tadeomendelevich/Balancin_Mendelevich/CHANGELOG.md

# Balancin STM32 — Registro de Cambios (historial completo)
> Movido desde `CLAUDE.md` el 2026-07-07 para que ese archivo no exceda el tamano que Claude carga automaticamente en cada sesion.
> Orden: mas reciente arriba. Las filas nuevas nacen en la tabla de CLAUDE.md y se rotan hacia aca (al tope de esta tabla) cuando aquella supera ~10 filas.
> **Nunca borrar informacion de este archivo.**

| Fecha | Archivo(s) modificado(s) | Cambio realizado | Motivo / Observación |
|---|---|---|---|
| 2026-08-26 | Core/Src/main.c, CLAUDE.md | **Legibilidad para estudio: renombres de identificadores locales, defines `RUEDA_ESTACION_*` movidos al bloque de arriba con comentarios recortados, y 26 comentarios nuevos de fin de linea nombrando la formula de cada cuenta. Cero cambio funcional.** (1) **Renombres** (todos verificados con 0 ocurrencias viejas): `LINE_THRESHOLD`->`LINEA_UMBRAL_ADC`; toda la familia `PERP`->`PERPENDICULAR` (enum `LINE_STATE_PERPENDICULAR_ROTATE`, funcion `LineState_PerpendicularRotate`, variables `perpendicular_desde_esquive`/`perpendicular_obj_freno_inicio_ms` y los 3 defines, renombrados ademas a `PERPENDICULAR_ANTIRREBOTE_MS`/`PERPENDICULAR_DURACION_MAX_MS`/`PERPENDICULAR_VISTA_PREVIA_MS`); locales del bloque de cruce perpendicular (`all_black`->`todo_negro`, `all_black_elapsed`->`todo_negro_transcurrido_ms`, `accel_moving`->`accel_moviendose`, `accel_settled`->`accel_asentado`, `ACCEL_MOTION_THRESHOLD`->`ACCEL_MOVIMIENTO_UMBRAL`, `ACCEL_SETTLE_MS`->`ACCEL_ASENTADO_MS`); locales del centroide (`s[]`->`linea_adc_crudo[]`, `w[]`->`linea_peso[]`); deteccion de objeto (`obj_now`->`obj_visto_ahora`, `obj_cnt`->`obj_confirma_cnt`, `obj_clear_cnt`->`obj_libera_cnt`, alineados con el patron `linea_detect_confirma_cnt`/`_libera_cnt`); y `WheelStation_AngleCorr()`->`Estacion_CorreccionAngulo()`. (2) **Defines movidos**: los 11 `RUEDA_ESTACION_*`/`RUEDA_TRASLACION_ZONA_MUERTA_COUNTS`/`RUEDA_V_ZM_RPS`/`RUEDA_CALMA_*`/`RUEDA_DESPL_*` pasaron de estar sueltos en la linea ~3586 al bloque de defines de balance/freno (lineas 290-302); sus comentarios pasaron de ~69 lineas de historia a 23 (uno corto por define). Se conservaron a proposito los knobs accionables y la advertencia de NO reintentar el "fade de supervivencia" por gyro alto. Tambien se recortaron los 2 comentarios largos que quedaban en la funcion (15 y 30 lineas -> 2 y 11). El detalle historico completo sigue en este CHANGELOG. (3) **26 comentarios** de fin de linea nuevos nombrando la tecnica: buffer circular por modulo/mascara, regla de tres duty->CCR, escalado LSB->deg/s, resta de timestamps, norma L1, semisuma=traslacion, superposicion avance+freno, extrapolacion de Taylor 1er orden, descomposicion polar->cartesiano, etc. Verificado: sin defines `RUEDA_*` duplicados ni usados-sin-definir. NO compilado (el usuario compila). | Usuario estudiando el firmware linea por linea: "estos nombres estan rarisimos para darme cuenta para que sirven", "estos define deberian estar arriba con los demas y no me gustan los comentarios extensos", "esos comentarios me ayudan mucho, se puede completar en los demas lugares?" |
| 2026-08-03 | Core/Src/main.c, CLAUDE.md | **Renombrado masivo de identificadores de inglés a español: 233 variables + 216 defines (solo nombres — cero cambio funcional).** El usuario estudia el firmware línea por línea y pidió nombres reconocibles en castellano. Dos pases scriptados con reemplazo por palabra completa y *lookbehind* que protege los accesos `.campo` / `->campo`. **Variables** (2384 reemplazos): `robot_state`→`estado_robot`, `line_*`→`linea_*`, `wheel_*`→`rueda_*`, `obj_wall_*`→`obj_pared_*`, `enc_r`/`enc_l`→`enc_der`/`enc_izq`, `ax..gz`→`accel_x..giro_z`, `f_fallen`→`f_caido`, `output`→`salida_pid`, `pwm_sat`→`pwm_saturado`, `steering_adjustment`→`ajuste_direccion`. **Defines** (717 en main.c + 55 en CLAUDE.md): `MOTOR_SLEEP_*`→`MOTOR_SIESTA_*`, `WHEEL_*`→`RUEDA_*`, `OBJ_WALL_*`→`OBJ_PARED_*`, `ANTISTALL_*`→`ANTIATASCO_*`, `LOST_FWD_*`→`PERDIDA_AVANCE_*`, `LOST_RETURN_*`→`RETORNO_*`, `BRAKE_TILT_*`→`FRENO_INCLINACION_*`, `STEER_*`→`DIRECCION_*`, `I_MAX`→`INTEGRAL_MAX`, `ALPHA`→`ALFA_COMPLEMENTARIO`. **NO se tocó** (a propósito): handles de CubeMX (se regeneran), defines de pines, `M_PI`, `KP/KD/KI/SETPOINT_ANGLE`, `ENCODER_COUNTS_POR_VUELTA`, los **campos de struct** de `UNER.h` (espejados en Qt) ni las constantes enlazadas a UNER (`KP_value`, `LINE_SPEED_TARGET`, `SP_LIMIT_DEG`, `KV_brake_value`) — por eso **Qt no requiere ningún cambio**. Verificado por script: 0 nombres viejos restantes, sin colisiones ni duplicados, y ambos diffs simétricos (2574 ins / 2574 del) confirmando renombrado puro sin pérdida de código. `CHANGELOG.md` NO se reescribió (es historia). **Pendiente**: las variables LOCALES dentro de funciones (`trabado_desplazamiento`, `gz_dps_cal`, `line_forward_boost`, `escala_estabilidad`, `wheel_disp_f`…) siguen en inglés. NO compilado (el usuario compila). | Usuario: "me encantaría que esos nombres de variables los hagas más reconocibles y sencillos, en español" + "hacé lo mismo para todos los DEFINE que no tienen nombre claro, que se entienda correctamente cuando los leo así los puedo estudiar fácil" |
| 2026-07-30 | Core/Src/main.c, Core/Src/UNER.c, Core/Src/MPU6050.c | **Comentarios de fin de línea nombrando la técnica/fórmula de cada cuenta (~90 líneas, solo comentarios — cero cambio funcional).** El usuario agregó a mano un `// Media movil exponencial` en el calibrador de bias del gyro y pidió replicar ese estilo (corto, al final de la línea, nombrando QUÉ es la fórmula) en la mayor cantidad de lugares posibles, porque le facilita muchísimo leer el firmware. Cubierto: **filtros** (EMA en velocidad rápida/lenta, accel_motion, lat_tilt, bias de odometría, error de línea, velocidad por rueda; filtro complementario con sus dos mitades pasa-altos/pasa-bajos; mediana + insertion sort del ADC); **PID/PI** (los cuatro lazos: balance, línea, steering por encoders, y los PI de velocidad de LOST_FWD/EDGE_FWD/OBJ_WALL×3/MANUAL — cada uno con P/I/D, integración rectangular `I += e*dt`, anti-windup por saturación y por integración condicional, descarga exponencial, ganancia asimétrica acelerar/frenar); **geometría** (atan2 del roll/pitch/lateral y por qué atan2 y no atan, Pitágoras, centroide como promedio ponderado + normalización, odometría: integración de Euler + regla del trapecio + descomposición polar→cartesiano + wrap a ±180°, navegación de retorno: distancia euclídea, rumbo y giro más corto); **conversiones** (análisis dimensional counts→rps→m/s, escalado del gyro, regla de tres duty→CCR y ADC→píxeles, punto fijo Q14 del MPU, recomposición big-endian); **utilidades de control** (saturación/clamp, zona muerta como "exceso", limitadores de slew-rate y sus rampas, interpolaciones lineales/lerp, decaimientos exponenciales, mezcla diferencial común±steering, semisuma=traslación / semidiferencia=rotación, calma traslacional y rotacional como normalización 0..1); **protocolo** (checksum XOR de RX y TX y por qué el orden no importa, buffer circular por máscara); **tabla de cuadratura** de los encoders (índice = 4·estado_anterior + estado_actual). NO compilado (el usuario compila). | Usuario: "hay comentarios que me ayudarían montón, como el de media exponencial que agregué acá, aclaran qué es y me ayudan a la interpretación — a la derecha luego de la línea, cortito y resumido, fijate dónde podés agregarlo en la mayor cantidad de lugares posibles" + "mientras más mejor!!!" |
| 2026-07-27 | Core/Inc/UNER.h, Core/Src/UNER.c, Core/Src/main.c, (Qt: mainwindow.h/.cpp) | **`MODIFY_SP_LIMIT=0xC9` nuevo (tope de inclinación ajustable desde Qt) + tope de velocidad de línea 4→8 m/s.** (1) **0xC9**: el `sp_limit` de `Ctrl_SetpointDinamico` (inclinación máxima para acelerar/frenar, hasta hoy la constante `5.0f`) pasó a la global `float SP_LIMIT_DEG = 5.0f`, enlazada por el binding nuevo `sp_limit` y modificable en runtime; el case en `UNER.c` valida con `getF32BoundedFromRx` a **1..15°** (`SP_LIMIT_CMD_MIN/MAX_DEG`) y responde UNKNOWN si no hay binding (patrón de `MODIFY_BETA_*`, no ACK mentiroso). Rige LINE_FOLLOWING/BALANCE_ONLY/IDLE; MANUAL (6°) y BALANCE_AND_SPEED (2°) conservan sus topes propios, y el freno hacia atrás en línea sigue acotado aparte por `LINEA_FRENO_ANGULO_MAX=3°`. (2) **`LINE_SPEED_CMD_MAX_MPS` 4.00→8.00 m/s**: el usuario quería pasar de 4 m/s y el clamp del firmware lo recortaba en silencio aunque Qt lo permitiera. Se queda en 8 y no más porque el corte de emergencia (`LINEA_VEL_CORTE_LIMITE`) está en 10 m/s: pedir un objetivo ≥ a ese corte sería autodestructivo. **Contexto**: ninguno de los parámetros de frenado escala con la velocidad objetivo (ángulo, rampas `LINE_SP_STEP_*`, ganancias del PI, margen y horizonte de la guarda predictiva son absolutos), así que a velocidades altas el robot queda relativamente sub-frenado — de ahí que tenga sentido poder subir el tope de inclinación a mano. NO compilado (el usuario compila). | Usuario: "quiero que me agregues sp_limit al Qt para poder cambiarlo de ahí, agregá la lógica al archivo UNER también; y sacame el límite de 4 m/s que tengo en Qt para poder llevarlo a más" |
| 2026-07-27 | Core/Src/main.c | **BUG CRÍTICO del esquive corregido: "PARADO" instantáneo al perder la pared — el reset del timer de pared-perdida decía `10` en vez de `0`.** Reporte: en pleno esquive, apenas el lateral deja de ver la pared, salta de `PARED>AVZ` directo a `PARADO` (`LINE_STATE_GIVEN_UP`), en vez de girar hacia la pared. Causa (en `Ctrl_LatchesPared`, etapa 3): con la pared visible el timer se "reseteaba" a **10** — un valor NO nulo, y la rama de abajo usa `== 0` como "timer sin arrancar". Al perder la pared se salteaba el arranque del timer y se evaluaba `HAL_GetTick() - 10` (≈ el uptime completo) contra los 5000 ms → verdadero desde el segundo 5 de encendido → `GIVEN_UP` **en el mismo ciclo** en que se pierde la pared. Y como la etapa 3 corre ANTES de los handlers de `line_state` (etapa 15), el estado ya era GIVEN_UP cuando `LineState_ObjBordearPared` iba a hacer su transición legítima `!pared_visible → OBJ_PARED_LIBRE → OBJ_GIRO_PARED`: el giro nunca llegaba a ejecutarse. Fix: reset a `0` (+ comentario explicando por qué DEBE ser 0). **Origen: commit `165f1ac` (2026-07-24)**, donde el `0→10` entró suelto, sin relación con el propósito de ese commit (estación por rueda + auditoría UNER) — no fue de la sesión de hoy; el diagnóstico anterior (que el timeout saltaba por un giro lento a causa del bamboleo) era **incorrecto**. NO compilado (el usuario compila). | Usuario: "se queda en estado PARADO de golpe en el medio del esquive, va de PARED>AVANZA a PARADO ni bien pierde de vista la pared — debería girar al lado de la pared al toque" |
| 2026-07-27 | Core/Src/main.c | **Bamboleo post-giro de 90° del esquive: la salida suave era GLOBAL — ahora es solo de BALANCE_ONLY.** Reporte: tras el primer giro de 90° del esquive de objeto el robot bamboleaba adelante/atrás. Causa: la zona neutra 4 + rampa del offset (12ª/13ª) aplicaban en TODOS los modos — en línea, los comandos medianos de la recuperación post-pivot (5-11 PWM) salían debilitados (un cmd 5 pasó de salir 13 a salir 6) → correcciones flojas → sub-amortiguado. Fix en `Ctrl_SalidaMotores`: flag `out_soft = (robot_state==BALANCE_ONLY)` — solo ahí rigen `MOTOR_COMANDO_NEUTRO=4` + rampa; los modos dinámicos (línea/manual/speed) usan `MOTOR_COMANDO_NEUTRO_DINAMICO=2` + offset completo de golpe (comportamiento histórico pre-2026-07-27, el que el seguidor tenía validado). NO compilado (el usuario compila). | Usuario: "luego del giro de 90° en el esquive de objeto se va bastante para atrás y adelante, se bambolea — ¿cambiamos algo de ahí?" |
| 2026-07-27 | Core/Src/main.c | **Auditoría de coherencia post-V27 entre modos + 2 fixes.** Pedido: verificar que los cambios del día (estación, zona neutra, rampa de deadband) no rompan línea/manual/speed. Mapa verificado: LINE→`Ctrl_MotoresLinea`, MANUAL/override→`Ctrl_MotoresManual`, resto (BALANCE_ONLY/**BALANCE_AND_SPEED**/IDLE)→`Ctrl_MotoresBalance`. **Fix 1**: el bloque `rueda_mecanismos_habilitados` de `Ctrl_MotoresBalance` (rotación por encoders + heading-hold yaw) corría TAMBIÉN en BALANCE_AND_SPEED — ahora gateado a BALANCE_ONLY/IDLE (mismo alcance que el eje de traslación; en SPEED anclaba el rumbo a la pose de entrada y pelearía con la maniobra). **Fix 2**: el slew post-rampa (`estacion_angulo_rampeada`, estático) arrastraba hasta 1.5° de corrección vieja durante ~40ms al setpoint del modo nuevo tras un cambio de modo en pleno frenado — ahora se resetea a 0 cuando `!rueda_posc_anclada` (cambio de modo o caída). **Verificado sin cambios**: siesta gateada a BALANCE_ONLY (entrada Y despertar chequean `robot_state`); zona neutra 4 + rampa de deadband son globales pero coherentes (en línea/manual los comandos típicos son ≥12 → offset pleno igual que antes; en movimiento rige el db cinético 4 y el anti-stall por setpoint no pasa por PWM); `wheel_disp_f` arranca fresco en cada re-entrada (reset en `!armed`); `wheel_yaw_int` se resetea al re-anclar; `rueda_posc_anclada=0` al entrar a IDLE/BALANCE/SPEED/MANUAL y al recuperarse de caída (fix 2026-07-26 intacto); en IDLE la salida corta motores más allá de lo que compute la estación. NO compilado (el usuario compila). | Usuario: "cambiamos el PID de una rueda a las dos — verificá que todos los estados hayan quedado coherentes (seguidor de línea, manual y demás) y corregí lo necesario" |
| 2026-07-27 | Core/Src/main.c | **16ª pasada — fade de supervivencia ELIMINADO (mataba el freno) y reemplazado por techo más bajo: `RUEDA_ESTACION_ANGULO_MAX` 2.5→1.5.** La 15ª quedó muy mal ("ahora no frena nunca"): el gate de gyro>40°/s estaba conceptualmente mal — CUALQUIER recuperación normal de empujón supera 40°/s de gyro (el vaivén de recuperación siempre es violento en gyro aunque el empujón sea moderado), así que `panic≈1` durante toda respuesta y la estación quedaba muda justo cuando tenía que frenar. Eliminados los `WHEEL_PANIC_*` y el factor `(1-panic)`; queda documentado en comentario para no reintentarlo. El pedido real ("frenar como antes pero proporcional a la fuerza del empujón") ya lo cumple la D por construcción — es lineal en v (1°/rps) — el problema del vuelco era solo el TECHO: con 2.5° de estación + freno clásico apilados el total volcaba. Ahora tope 1.5°: el freno conserva la proporcionalidad validada en todo el rango útil (hasta 1.5 rps da lo mismo que antes) y el balance conserva margen para sobrevivir el empujón fuerte. Knobs: aún vuelca con empujón fuerte → 1.5→1.2; frena poco → 1.5→1.8. NO compilado (el usuario compila). | Usuario: "quedó muy mal, ahora no frena nunca — debería frenar como antes pero de forma proporcional a lo fuerte del empujón" |
| 2026-07-27 | Core/Src/main.c | **15ª pasada — fade de SUPERVIVENCIA: en empujones fuertes la estación se caía a sí misma.** Reporte: con un empujón fuerte (sobre todo hacia adelante) la respuesta era tan agresiva que el robot se caía. Causa de diseño: el factor de calma de la 11ª usa el gyro para DESPERTAR la estación en un empujón — pero en uno fuerte la recuperación es violenta (gyro 50-100°/s, error grande) y eso mantenía la estación a plena autoridad (±2.5° de setpoint) justo cuando el PID de balance necesita la referencia limpia para sobrevivir; encima se APILA con el freno clásico de `ComputeBrakeSetpointTarget` (KV_FRENO_FUERTE) que también inclina para frenar → doble freno → vuelco. Fix en `Estacion_CorreccionAngulo()`: **`panic = clamp01(max((\|gyro_f\|-40)/(80-40), (\|error\|-3)/(6-3)))`** y la corrección se multiplica por `calm × (1-panic)`: entre 40 y 80°/s de gyro (o 3 a 6° de error) la estación se retira linealmente hasta quedar muda; el rescate del empujón fuerte lo hacen el PID de balance + el freno clásico (validado hace meses) y la estación retoma sola al moderarse la recuperación. Los empujones moderados (gyro < 40°/s) conservan exactamente la amortiguación validada. Knobs: si aún se cae con empujón fuerte → bajar `WHEEL_PANIC_GYRO_LO` 40→30 y `ANG_LO` 3→2.5; si los empujones moderados perdieron amortiguación → subir LO. NO compilado (el usuario compila). | Usuario: "cuando recibe un empujón se comporta demasiado agresivo, tanto que se cae por la respuesta — debería siempre mantener equilibrio; se cae más que nada cuando lo empujo fuerte hacia adelante" |
| 2026-07-27 | Core/Src/main.c | **14ª pasada — calma ROTACIONAL: el canal diferencial dejaba una rueda empujando sola (la derecha se movía sin parar, la izquierda muda).** Reporte: "el motor derecho se mueve todo el tiempo y el izquierdo no; el derecho rompe el equilibrio". Causa: el canal diferencial (heading-hold PI + PD de rotación en `Ctrl_MotoresBalance`) — el integrador de yaw conserva a propósito un contra-torque CONSTANTE (se congela dentro de `RUEDA_RUMBO_ZONA_MUERTA` "conservando el contra-torque") y ese diferencial permanente se suma a una rueda y se resta a la otra: con `MOTOR_COMANDO_NEUTRO=4`, la rueda favorecida (derecha, vía mL) queda siempre arriba del umbral (empuja sin parar) y la otra abajo (0) — asimetría perpetua que rompe equilibrio y siesta. Fix (mismo patrón que la calma traslacional de la 11ª): **`rot_calma = min(1, max(\|yaw_velocidad\|/RUEDA_ROTACION_CALMA_GIRO_REF=2°/s, \|v_rot\|/RUEDA_ROTACION_CALMA_VEL_REF=0.5rps))`** multiplica el yaw-hold completo (P+I) y el PD de rotación; además el I solo acumula con `rot_calma > RUEDA_ROTACION_CALMA_INTEGRAL_UMBRAL=0.3` (anti-windup: antes, quieto con rumbo fuera de la DB, el I crecía hasta el tope y al despertar pegaba un diferencial grande). Sin giro real → canal mudo → las dos ruedas quietas; girando de verdad → canal entero (el heading-hold validado no pierde autoridad donde importa). Reordenado el bloque: drift/rot/v_rot se calculan antes del yaw-hold para alimentar la calma. NO compilado (el usuario compila). | Usuario: "el motor derecho se mueve todo el tiempo y el izquierdo no, se queda quieto el izquierdo, pero el derecho es el que rompe el equilibrio o balance" |
| 2026-07-27 | Core/Src/main.c | **13ª pasada — más suavidad aún: `MOTOR_ZM_RAMPA_GANANCIA` 2→1.** La 12ª quedó **VALIDADA** ("quedó mucho mejor") y el usuario pidió suavizar todavía más el punto dulce. La rampa de compensación de deadband ahora sube con pendiente 1: comando 5 → +1 (total 6), comando 8 → +4, offset estático completo recién con \|cmd\| ≥ 12 — toda la franja de correcciones chicas empuja mínimo; los comandos grandes de un empujón real no cambian. Si quedara flojo para arrancar la rueda en correcciones medianas (el robot "se cuelga" antes de reaccionar), volver a 2. Próximos knobs de suavidad si hiciera falta más: `MOTOR_CMD_NEUTRO` 4→5, o el soft zone del PID (`scale_min` 0.35→0.30). NO compilado (el usuario compila). | Usuario: "ok, quedó mucho mejor — igual me gustaría suavizar más aún la respuesta en el punto dulce" |
| 2026-07-27 | Core/Src/main.c | **12ª pasada — el brusco del punto dulce NO era la estación: era la PATADA de compensación de deadband de los motores.** Con la estación ya muda en calma (11ª) el síntoma siguió → el culpable estaba en `Ctrl_SalidaMotores`: con la rueda parada (>80ms sin ticks) cualquier comando que superara `MOTOR_CMD_NEUTRO=2` saltaba de golpe a comando+8 (offset estático) — una micro-corrección de 3 PWM del PID se convertía en una patada de **11 PWM** contra un robot quieto → sacudida → gyro>5°/s + ticks → ventana de siesta reseteada → el PID corregía la sacudida → otra patada: relé oscilando en el punto dulce, exactamente el mecanismo del bamboleo del 2026-07-10 pero en versión chica. Dos fixes: (1) `MOTOR_CMD_NEUTRO` 2→**4** (el knob que el propio comentario del código documentaba para "si sigue temblando"): el chatter de 3-4 PWM va a 0 real — motores quietos, sin ticks, la siesta por fin tiene su ventana; el riesgo de bamboleo lento hoy lo atajan hold+siesta, si aparece volver a 3. (2) **Rampa de la compensación** (`MOTOR_ZM_RAMPA_GANANCIA=2`): apenas por encima de la zona neutra el offset entra proporcional al exceso (`comp=min(db,(\|cmd\|-4)×2)`) en vez de completo de golpe — offset pleno recién con \|cmd\|≥8; los comandos chicos empujan suave, los grandes (empujón real) no cambian. NO compilado (el usuario compila). | Usuario: "sigue sin entrar, no sé cuál será el problema — no llega a ser tan suave el PID en el punto dulce, no le da la suavidad" |
| 2026-07-27 | Core/Src/main.c | **11ª pasada — factor de CALMA global: la estación se apaga entera cuando el cuerpo está quieto.** Tras la 10ª el reporte siguió igual ("no entra nunca en la siesta, muy brusco en el punto dulce, quiero bajar la respuesta ahí"). Patrón de las pasadas 8-10: suavizar término por término (rodilla de la D, tope del P, drenaje del disp) no alcanzaba — siempre quedaba algún término activo perturbando el setpoint en el punto dulce. Fix estructural en `WheelStation_AngleCorr()`: **`calm = min(1, max(\|gyro_f\|/WHEEL_CALM_GYRO_REF, \|v_trans\|/WHEEL_CALM_V_REF))`** (refs: 8°/s y 1.0 rps) multiplica TODA la corrección (P y D juntos). Cuerpo quieto → calm→0 → estación MUDA: cero perturbación de setpoint, el PID de balance + hold + siesta son los dueños del punto dulce. Empujón → el gyro dispara al instante (sin la lag de los encoders) → estación entera sin retraso. La rodilla `WHEEL_V_SOFT_KNEE` quedó reemplazada (el término \|v\|/V_REF del calm hace lo mismo y más); tope del P (0.5°) y drenaje rápido (150ms) se mantienen. Knobs: sigue brusco en calma → subir REFs; no amortigua llegadas suaves → bajar GYRO_REF a 6. NO compilado (el usuario compila). | Usuario: "no entra nunca en la ventana de siesta, está siendo muy brusco en el punto dulce — quiero bajar de alguna forma la respuesta del robot para que sea más suave ahí" |
| 2026-07-27 | Core/Src/main.c | **10ª pasada — drenaje rápido de la memoria de desplazamiento en reposo real: el residuo del P mantenía al robot gateando y la siesta nunca entraba.** La 9ª dejó el punto dulce suave (VALIDADO) pero la siesta seguía sin entrar jamás. Causa: aun con el tope de 0.5°, el residuo del P se drena con la fuga de τ≈5s — durante esos segundos el setpoint queda corrido y el robot GATEA de vuelta despacito; cada tick del gateo resetea `enc_quiet` (60ms) + los 80ms sostenidos → la ventana de la siesta no se cumple nunca. La ventana en sí está bien (era alcanzable antes de la estación, "cuando entra queda muy eficiente"): el bloqueo era el gateo inducido. Fix en `WheelStation_AngleCorr()`: **reposo real** (ambas ruedas >`WHEEL_DISP_CALM_MS=150`ms sin un tick + \|v_trans\| bajo la zona muerta) → `wheel_disp_f *= WHEEL_DISP_FAST_LEAK=0.90` (τ≈100ms): el residuo muere en ~0.3s de quietud, el setpoint vuelve a 0, el robot deja de gatear y la siesta entra. Coherente con la filosofía sin ancla (quieto de verdad = no hay adonde volver). La deriva lenta REAL (~cm/s cuesta abajo) tiquea cada <150ms y NO dispara el drenaje — el P anti-deriva sigue vivo ahí. NO compilado (el usuario compila). | Usuario: "ahora quedó suave, pero nunca entra en modo siesta de motores — está muy complicado de ingresar o la ventana está muy alta" |
| 2026-07-27 | Core/Src/main.c | **9ª pasada — el brusco del punto dulce era el término P saturado, no la D: tope propio `WHEEL_STATION_P_MAX=0.5°`.** La rodilla de la 8ª no alcanzó ("sigue demasiado brusco y potente en el punto dulce, no entra nunca a la siesta") porque atacaba el término equivocado: a v→0 la D ya se apaga sola — el que quedaba empujando era el **P del desplazamiento reciente**. Números: un empujón que desplaza ~30cm mete ~90 counts en `wheel_disp_f` y con la fuga alargada a τ≈5s (6ª pasada) eso vale 90×0.05=4.5° → saturaba el tope general de 2.5°: al frenar en el punto dulce el robot recibía 2.5° de inclinación de vuelta durante segundos — se pasaba del equilibrio y el error nunca bajaba de los 0.8° de entrada de la siesta. Fix: el P tiene ahora tope PROPIO de **0.5°** (`p_term` clampeado antes de sumar; la D conserva la autoridad grande de ±2.5° que es la validada contra empujones). 0.5° alcanza de sobra para el rol real del P (frenar deriva lenta de mm/s) y queda DEBAJO del umbral de la siesta → tras un empujón el residuo del P ya no bloquea la entrada a dormir. Rodilla de la 8ª se mantiene (suaviza la D en la llegada). NO compilado (el usuario compila). | Usuario: "sigue quedando demasiado brusco y potente en el punto dulce, no logra entrar en siesta los motores nunca" |
| 2026-07-27 | Core/Src/main.c | **8ª pasada — rodilla suave de la D contra la brusquedad en el punto dulce.** La 7ª quedó **VALIDADA** ("la mejora es una locura, amortigua los empujones muy rápido" — commit+push en `6a286a6`), pero al llegar al punto dulce era demasiado brusco: con la D ya en fase y ganancia completa a cualquier velocidad, una velocidad chiquita de llegada (o el pico de un count suelto) metía un golpe de setpoint que lo pasaba del equilibrio justo cuando estaba por entrar a la siesta. Fix: `WHEEL_V_SOFT_KNEE=1.0` rps en `WheelStation_AngleCorr()` — debajo de la rodilla la ganancia de la D escala lineal con \|v\| (`v_soft = min(1, \|v_act\|/rodilla)`, respuesta cuadrática en chico, entera en grande): la llegada es proporcionalmente más suave y no se pasa de largo, pero un empujón real (v > 1 rps) recibe la D completa que ya gustó. NO es zona muerta (la lección de `WHEEL_V_DB_RPS=0.8`): sigue corrigiendo en fase a toda velocidad, solo más blando en chico. Knobs: vaivén chico que no muere → rodilla 1.0→0.6; sigue brusco al asentarse → 1.0→1.5. NO compilado (el usuario compila). | Usuario: "quedó muchísimo mejor, la mejora es una locura — pero es demasiado brusco cuando está por quedarse en el punto dulce y poner siesta: se pasa del equilibrio; me gustó que amortigua los empujones muy rápido" |
| 2026-07-27 | Core/Src/main.c | **7ª pasada — causa raíz del "reacciona tarde": la corrección de la estación pasaba por la RAMPA del setpoint.** La 6ª pasada no ayudó ("empeoró bastante, le cuesta quedarse en la zona dulce, reacciona tarde, sigue sin entrar a la siesta"). Diagnóstico estructural: `WheelStation_AngleCorr()` se sumaba a `base_setpoint_target`, que en BALANCE/IDLE rampa a `sp_step_max=0.1°/ciclo` (10°/s) hacia `base_setpoint_f` — una corrección de 1° tardaba 100ms en llegar, +~50ms de la EMA de velocidad (`WHEEL_SPD_BETA=0.20`). Con el período del vaivén (~1s), 150ms ≈ 50-90° de fase: la D llegaba con el movimiento ya invertido y en vez de amortiguar BOMBEABA — por eso subir DAMP siempre empeoraba y el robot nunca juntaba la quietud que pide la siesta. (La rampa existió siempre; con DAMP chico y zona muerta grande la D casi no actuaba y no se notaba.) Fix: la corrección ahora se aplica **POST-rampa** al final de `Ctrl_SetpointDinamico` — local `wheel_station_corr` se estampa en las ramas BALANCE_ONLY/IDLE y se suma directo a `dynamic_setpoint_f` (después de la contabilidad de `brake_setpoint_f`, que queda intacta) con un slew propio `WS_STEP=0.4°/ciclo`: sigue el movimiento real casi sin retraso y solo recorta el escalón instantáneo de un count suelto. Clamp final a ±sp_limit. Knobs de la 6ª (DAMP=1.0, V_DB=0.25, LEAK=0.998) quedan — recién ahora la D actúa en fase y se puede evaluar de verdad. NO compilado (el usuario compila). | Usuario: "este cambio no ayudó para nada, empeoró bastante — le cuesta quedarse en la zona de equilibrio dulce, es como que reacciona tarde, y sigue sin entrar al modo siesta, no llega a quedarse tan quieto" |
| 2026-07-27 | Core/Src/main.c | **6ª pasada de la estación: la 5ª sobre-corrigió — el robot no entraba casi nunca a la siesta y "se iba de a poco".** Dos causas: (1) `WHEEL_V_DB_RPS=0.15` + `WHEEL_STATION_DAMP=1.20` convertían el pico de ~0.7 rps de UN count suelto en un pateo de setpoint de ~0.66° → el PID respondía, caían más ticks, y cada tick reseteaba las ventanas de la siesta (60ms quiet + 80ms sostenido) — círculo vicioso: la propia estación mantenía al robot despierto y vagando. Fix: `WHEEL_V_DB_RPS` 0.15→**0.25** (vuelve al valor validado; el pico residual genera ≤0.45° breve y el vaivén real 0.3–0.7 rps sigue cubierto) y `DAMP` 1.20→**1.00** (el knob ya anotado para este síntoma; los ~15 cruces los asienta la siesta permisiva, que queda intacta). (2) La deriva lenta era invisible por diseño: con fuga τ≈2s y `WHEEL_TRANS_DB=3`, toda deriva <1.5 counts/s (~5 mm/s) se drenaba más rápido de lo que acumulaba y NUNCA superaba la banda → `WHEEL_DISP_LEAK` 0.995→**0.998** (τ≈5s): el umbral de deriva invisible baja a ~0.6 counts/s (~2 mm/s). Siesta sin cambios. NO compilado (el usuario compila). | Usuario: "en el punto de equilibrio al que llego tras un empujón le cuesta mantenerse, no se mete casi nunca al modo siesta, y se empieza a ir para los costados de a poco" |
| 2026-07-26 | Core/Src/main.c | **Estación por rueda — rediseño del eje de TRASLACIÓN: de trim de PWM a corrección de SETPOINT.** Probando en el robot los knobs de rotación de hoy, el usuario reportó que la traslación fallaba asimétrica: deriva hacia adelante que NUNCA frenaba y hacia atrás corregía mal. Causa: en un balancín el PWM de rueda es el actuador equivocado para posición — frenar las ruedas inclina el cuerpo hacia adelante y el PID de balance responde acelerando; el trim (±8%) pelea contra el balance y pierde. Rediseño: la traslación ahora corrige el **setpoint de inclinación** (helper `WheelStation_AngleCorr()` antes de la etapa 12, aplicado en las ramas BALANCE_ONLY e IDLE de `Ctrl_SetpointDinamico`): P sobre el exceso fuera de `WHEEL_TRANS_DB=10` counts, ganancia `WHEEL_STATION_ANG_KP=0.06°/count` y signo idénticos al hold ya validado de PAUSA_GIRO (counts+=avance → corrección negativa=inclina atrás), tope `WHEEL_STATION_ANG_MAX=2°`, sin D propio (el freno de `ComputeBrakeSetpointTarget` ya amortigua); gate con `wheel_pos_armed` (primer ciclo no corrige, el ancla se estampa en `Ctrl_MotoresBalance` que corre después — mismo patrón que PAUSA). La ROTACIÓN queda en PWM diferencial (no afecta el pitch, ahí el trim no pelea) — `Ctrl_MotoresBalance` quedó rotation-only (`WHEEL_TRANS_KP/KD` eliminados, `WHEEL_TRANS_DB` movido junto al helper). **Fix extra**: `wheel_pos_armed=0` al entrar a IDLE, al entrar a BALANCE/SPEED/MANUAL y al recuperarse de caída — antes el ancla quedaba vieja tras pasar por línea/caída y la estación intentaba "volver" a una posición anterior. NO compilado (el usuario compila). | Usuario: "existe demasiada deriva hacia adelante, se comienza a ir hacia adelante pero nunca frena; para atrás sí contrarresta pero no funciona muy bien el PID para mantenerlo en su lugar" |
| 2026-07-26 | Core/Src/main.c | **Estación por rueda: ajuste del eje de rotación contra el giro lento residual.** Aplicados los dos primeros knobs que quedaron anotados como pendiente el 2026-07-21: `WHEEL_ROT_DB` 3→2 counts (ataja el giro antes) y `WHEEL_ROT_KP` 0.15→0.25 %PWM/count (corrige más fuerte el exceso). `WHEEL_ROT_KD` queda en 0.60 — subirlo a 1.0 SOLO si al probar aparece temblor al corregir el giro. Si con esto la deriva rotacional persiste, el siguiente paso anotado es heading-hold por gyro Z/odometría θ (la asistencia de rumbo actual solo amortigua velocidad de giro, no sostiene rumbo). Ejes de traslación intactos. NO compilado (el usuario compila). | Usuario: "creo que había quedado una mínima deriva hacia un lado pero estaba más estable, podríamos corregir lo que faltaba así lo terminamos" |
| 2026-07-26 | Core/Src/main.c | **La siesta como asentador del vaivén final + más D.** Quedaba un vaivén de llegada (~15 cruces sobre el ancla antes de asentarse) y el usuario pidió una siesta aún más permisiva. Sinergia deliberada: en cada extremo de la oscilación la velocidad pasa por ~0 — con ventanas cortas la siesta lo pesca ahí, corta motores y la fricción estática mata la oscilación en 2-3 cruces. Siesta: `GYRO_ENTER` 4→5°/s, `ENTER_MS` 150→80, `CMD_MAX` 12→15, `ENC_QUIET_MS` 100→60. Amortiguación: `WHEEL_STATION_DAMP` 1.00→1.20 y `WHEEL_V_DB_RPS` 0.25→0.15 (la D llega más abajo). Si tiembla en movimiento, volver DAMP a 1.0. NO compilado (el usuario compila). | Usuario: "mejoró muchísimo pero va y viene como 15 veces en el ancla antes de quedar en equilibrio; y quiero ser aún más permisivo con la siesta" |
| 2026-07-26 | Core/Src/main.c | **Vaivén chico perpetuo resuelto: la zona muerta de la D (0.8 rps) era la zona CIEGA donde vivía la oscilación.** Tras subir DAMP/KP el robot amortiguaba traslaciones grandes (>0.8 rps, con esfuerzo) pero quedaba meciéndose eternamente en chico: el vaivén de 0.2–0.7 rps caía DEBAJO de `WHEEL_V_DB_RPS=0.8` (D inactiva) mientras el resorte del ancla flotante (KP=0.08) seguía inyectando energía — resorte sin amortiguador en ese régimen. Fix: `WHEEL_V_DB_RPS` 0.8→**0.25** (la D ahora cubre el régimen donde el resorte trabaja), `WHEEL_STATION_ANG_KP` 0.08→**0.05** (resorte más blando = menos energía inyectada) y `WHEEL_TRANS_DB` 2→3. El temblor en reposo que la zona muerta grande evitaba ya no es riesgo: el pico de un count suelto lo drena la EMA en ~50ms, `MOTOR_CMD_NEUTRAL` absorbe el comando chico resultante y la siesta corta todo en reposo real. NO compilado (el usuario compila). | Usuario: "está todo el tiempo en el vaivén sobre el ancla, amortigua traslaciones grandes con mucho esfuerzo pero las chicas nunca — se está moviendo tooodo el tiempo, no llega nunca al equilibrio" |
| 2026-07-26 | Core/Src/main.c | **Ajuste fino: siesta más fácil de entrar + más autoridad de amortiguación traslacional.** La 2ª forma de la siesta funcionó ("ahí está mucho mejor") pero el usuario pidió que cueste un poco menos entrar: `MOTOR_SLEEP_GYRO_ENTER` 3→4°/s, `MOTOR_SLEEP_ENTER_MS` 200→150, `MOTOR_SLEEP_CMD_MAX` 8→12, `MOTOR_SLEEP_ENC_QUIET_MS` 120→100 (ANG_ENTER queda 0.8 para no romper la histéresis con ANG_WAKE=1.0). Además la traslación seguía demorando en amortiguar: `WHEEL_STATION_DAMP` 0.70→**1.00** °/rps, `WHEEL_STATION_ANG_KP` 0.06→0.08 y tope `WHEEL_STATION_ANG_MAX` 2.0→2.5° (más autoridad de frenado). Si sobre-frena/tiembla al moverse, bajar DAMP de a 0.1. NO compilado (el usuario compila). | Usuario: "que le cueste un poooooco menos entrar a siesta (cuando entra queda muy eficiente); además demora bastante en amortiguar la traslación corrigiendo con ángulo" |
| 2026-07-26 | Core/Src/main.c | **Siesta de motores en el punto dulce (`MOTOR_SLEEP_*`, solo BALANCE_ONLY).** El rediseño sin ancla quedó **VALIDADO** ("funciona espectacular") y el usuario pidió eficiencia: en equilibrio el robot seguía corrigiendo montones de veces por segundo (desgaste + vibración). Nivel nuevo DEBAJO del hold, en `Ctrl_SalidaMotores`: con `balance_hold_active` + `|pwm_sat|<=4` + encoders sin ticks por 250ms, sostenido 300ms → **PWM 0 real** (ni el salto de deadband; el robot se para por equilibrio mecánico). Despierta al instante con CUALQUIERA de: salida del hold (error≥0.45°/gyro≥6°/s), un solo tick de encoder (= empujón, `enc_quiet` cae), o `|gyro_f|>=MOTOR_SLEEP_WAKE_GYRO=4°/s` (umbral más fino que el exit del hold, recupera autoridad antes de que la caída tome impulso). Respeta la lección del 2026-07-10 (motores muertos en zona ancha → bamboleo): despertar sensible por gyro/encoder. **2ª forma (mismo día)**: la 1ª (hold activo + 250ms sin un tick + |pwm|≤4) nunca entraba — la propia vibración de las correcciones impedía cumplirla (círculo vicioso) y con 0.3–0.5° de error residual el hold ni entraba. Ahora la siesta tiene ventana PROPIA desacoplada del hold: entra con |error|≤0.8° + |gyro|≤3°/s + 120ms sin ticks + |pwm_sat|≤8 sostenido 200ms; despierta con tick de encoder, gyro≥4°/s o |error|≥1.0°. El PID sigue corriendo dormido (pwm_sat/slew/integral con decay) — al despertar retoma sin discontinuidad. Knobs: si sigue sin dormir, subir `MOTOR_SLEEP_GYRO_ENTER` a 4 o `MOTOR_SLEEP_CMD_MAX` a 12; si bambolea dormido-despierto, bajar `MOTOR_SLEEP_WAKE_GYRO` a 3 o achicar `MOTOR_SLEEP_ANG_ENTER` a 0.6. NO compilado (el usuario compila). | Usuario: "funciona espectacular — mejoremos el punto dulce: en equilibrio sigue corrigiendo montones de veces por segundo sin necesidad, desgasta motores y vibra; desactivar motores hasta un empujón o deriva por setpoint o encoder" |
| 2026-07-26 | Core/Src/main.c | **8ª iteración — rediseño final de la traslación: SIN ANCLA ("quedate quieto donde estés").** El usuario reencuadró el objetivo: en balance puro no le importa ningún lugar de referencia — solo quedarse quieto donde sea, sin amplificar ruido ni empujones. `WheelStation_AngleCorr()` reescrita sin ancla, sin latch y sin resorte a punto fijo: (1) **D** = amortiguación de la velocidad EMA (`WHEEL_STATION_DAMP=0.70 °/rps`) con zona muerta `WHEEL_V_DB_RPS=0.8` — el pico de ~0.7 rps que mete un count suelto en la EMA queda por debajo y NO genera corrección → cero temblor en reposo, sin necesidad de latch; es quien mata los empujones. (2) **"P" flotante** = desplazamiento RECIENTE con fuga: `wheel_disp_f = disp·0.995 + Δcounts` (τ≈2s), corregido con `WHEEL_STATION_ANG_KP=0.06°/count` fuera de ±2 counts — un ancla que SIGUE al robot: frena el arrastre lento que se escapa bajo la zona muerta de la D, pero se olvida del lugar (tras un empujón queda donde murió la velocidad, no vuelve al origen; en reposo la fuga lo drena a 0 y la corrección desaparece sola). Eliminados `WHEEL_SETTLE_*`/`WHEEL_WAKE_DB` y el latch; los anclajes `wheel_pos_anchor_*` siguen existiendo pero solo para el lazo de ROTACIÓN por encoders (ahí el rumbo sí tiene referencia con sentido). NO compilado (el usuario compila). | Usuario: "no me importa dónde está el ancla — en balance puro quiero que se quede quieto en el lugar que sea, sin amplificar ruido o empujones; no debería haber ancla, concentrado en mantenerse lo más quieto posible con encoders y ángulo" |
| 2026-07-26 | Core/Src/main.c | **7ª iteración: banda del resorte angosta (10→2 counts) + latch con histéresis y re-anclaje.** Aun con DAMP=0.70 el vaivén post-empujón no moría y "no ayuda cambiando los knobs". Causa estructural: la banda muerta ancha de ±10 counts dejaba ~12 cm de "caída libre" — el robot volvía lanzado, el resorte se apagaba de golpe al entrar a la banda, la cruzaba entera (ahí solo actuaba la D, débil por cuantización), se pasaba al otro lado y el ciclo seguía. La banda ancha protegía el punto dulce, pero ese trabajo ya lo hace el latch → quedó obsoleta. Cambios en `WheelStation_AngleCorr()`: `WHEEL_TRANS_DB` 10→**2** counts (control PD continuo casi todo el recorrido); latch rediseñado con **histéresis**: se asienta cerca del ancla (`WHEEL_SETTLE_POS=8` counts ~5 cm) y quieto 300ms → **re-ancla donde quedó** (la posición final pasa a ser la nueva estación, simetriza el umbral de despertar y de paso re-cero-a la referencia del lazo de rotación — el rumbo lo sostiene el heading-hold por gyro, no le afecta) → corrección 0 exacto; despierta solo con desplazamiento real > `WHEEL_WAKE_DB=10` counts (~6 cm) desde el punto de asentado. NO compilado (el usuario compila). | Usuario: "sigo sin poder amortiguar los empujones, demora demasiado, deriva demasiado, y no ayuda cambiando solamente los rps del encoder" |
| 2026-07-26 | Core/Src/main.c | **6ª iteración: latch de "asentado" en el punto dulce + D 0.45→0.70.** Reporte: seguía demorando en amortiguar y temblaba con deriva mínima. Los dos knobs pelean entre sí (más D amortigua antes pero tiembla más en reposo, porque la D quedaba SIEMPRE activa y un count suelto mete ~0.7 rps en la EMA → ~0.3° de setpoint con el robot quieto). Fix estructural en `WheelStation_AngleCorr()`: **latch `wheel_settled`** — tras `WHEEL_SETTLE_CYCLES=30` ciclos (300ms) dentro de la banda y con `|v_trans|<WHEEL_SETTLE_V_RPS=0.6`, la corrección pasa a **0 exacto** (equilibrio mecánico puro) y solo se reactiva si la POSICIÓN vuelve a salirse de la banda (un empujón la saca al toque → despierta solo). Con el temblor resuelto por el latch, la D pudo subirse sin costo: `WHEEL_STATION_DAMP` 0.45→**0.70 °/rps** (vaivén muere antes). Documentado además en comentario qué es cada término: P=resorte 0.06°/count fuera de ±10 counts, D=amortiguador 0.70°/rps sobre velocidad EMA, I=no hay a propósito (acumularía contra el vaivén natural del balance; el único I de la estación es el del heading-hold de yaw). NO compilado (el usuario compila). | Usuario: "demora demasiado en amortiguar — ¿cuál es el P, D e I de este PID por rueda? ¿cómo amortiguo más rápido? y que no tiemble cuando la deriva es tan chica que está en el punto dulce: ahí debería dejar de corregir y mantenerse por equilibrio mecánico" |
| 2026-07-26 | Core/Src/main.c | **5ª iteración: warmup rápido del bias del gyro + más amortiguación traslacional.** El heading-hold PI quedó **VALIDADO** ("quedó muy bien el tema del giro, no lo hace más"). Dos ajustes: (1) el usuario quería salir de IDLE casi al instante sin esperar la medición de bias → convergencia en dos etapas en `Ctrl_VelocidadEncoders`: primeros 100 ciclos en reposo con β=0.08 (converge en ~0.3–0.5s) y después β=0.005 que refina; se ignoran muestras con gz==0 exacto (IMU sin datos al arrancar) para no gastar el warmup en ceros. (2) El vaivén traslacional ya no crecía pero tampoco moría (ciclo límite marginal por stick-slip de motores + retardo del balance): `WHEEL_STATION_DAMP` 0.25→0.45 °/rps para retorno sobreamortiguado; si aparece jitter en el punto dulce, bajar de a 0.05. NO compilado (el usuario compila). | Usuario: "quedó muy bien el giro; ¿hay forma de no tener el período de medición para poner el modo casi instantáneo? además el vaivén traslacional no termina nunca de quedarse quieto — va y viene sin amplificar, pero sin amortiguarse del todo" |
| 2026-07-26 | Core/Src/main.c | **Heading-hold corregido "desde la base": bias del gyro medido SOLO en reposo real + hold PI (4ª iteración del día).** La traslación quedó validada ("bastante resuelta, se amortigua bastante") pero el giro a la derecha seguía constante, sin terminar nunca. Dos causas de fondo: (1) el aprendizaje de bias de la iteración anterior corría DURANTE la estación, donde bias y giro real lento son indistinguibles — la EMA absorbía el giro real y el hold lo dejaba pasar; (2) el hold era P puro — con una perturbación de yaw constante (asimetría de motores) el P satura y queda un "empate girando". Fixes: bias (`wheel_yaw_bias_dps`) ahora se mide únicamente con motores apagados y encoders sin counts (IDLE o caído, al final de `Ctrl_VelocidadEncoders`, τ≈2s, gate 5°/s) — ahí todo lo que marca el gyro ES bias — y queda CONGELADO durante balance; y el hold pasó a **PI**: `WHEEL_YAW_KI=0.8` acumula el exceso (congelado dentro de `WHEEL_YAW_DB`, conservando el contra-torque; reset al rearmar el ancla; tope `WHEEL_YAW_INT_MAX=15°/s eq` ≈3.5% PWM dif.) y `WHEEL_YAW_MAX` 12→20. El bias converge en los ~2s de IDLE del arranque, antes de elegir modo. NO compilado (el usuario compila). | Usuario: "sigo con el giro a la derecha que no termina de hacerse nunca, está constantemente girando, pase el tiempo que pase — vamos a corregirlo desde la base" |
| 2026-07-26 | Core/Src/main.c | **Estación por rueda, 3ª iteración del día: amortiguación en la traslación + bias online del gyro en el heading-hold.** (1) **Vaivén creciente adelante/atrás** (reportado: "comienza quieto y termina moviéndose muchos centímetros, no llega nunca a amortiguar"): el P de posición por setpoint era un resorte sin freno — a través del retardo del balance bombeaba una oscilación creciente, y el freno de `ComputeBrakeSetpointTarget` no la ve (deadband 0.35 m/s > estas velocidades). Fix: término D SIEMPRE activo en `WheelStation_AngleCorr()` con la velocidad EMA por rueda (`WHEEL_STATION_DAMP=0.25 °/rps`; signo verificado: `speed_*_rps` sale del mismo delta de counts que el drift → + = avance en ambos). Si vibra en el punto dulce, bajar DAMP; si aún oscila, subirlo a 0.4. (2) **Deriva lenta a la derecha que "antes no estaba"**: era el heading-hold persiguiendo el bias residual del gyro Z (el rumbo integrado cree que gira a la izquierda y el hold lo hace girar físicamente a la derecha al ritmo del bias, para siempre; subir `WHEEL_YAW_DB` NO lo arregla, solo retrasa el arranque). Fix: `wheel_yaw_bias_dps` — EMA lentísima (`BETA=0.001`, τ≈10s) de gz mientras está en estación casi sin rotar (gate 3°/s), y el rumbo integra `(gz − bias)`; el bias aprendido persiste entre rearmes (es físico). Converge en ~10–30s: la deriva debería frenarse sola tras el arranque. NO compilado (el usuario compila). | Usuario: "sigo con la deriva lenta a la derecha (antes no la teníamos) + la traslación hace un vaivén adelante/atrás cada vez más grande, no llega nunca a amortiguar y quedarse quieto" |
| 2026-07-26 | Core/Src/main.c | **Heading-hold por gyro Z en la estación por rueda.** Con la traslación por setpoint validada ("el PID corrige muchísimo mejor"), quedaba un giro lento y constante a la derecha. Causa: el lazo de rotación por encoders no ve el giro por micro-patinaje (el cuerpo rota sin diferencia neta de counts) y el yaw-assist tiene zona muerta de 3°/s — un giro lento pasa por debajo de ambos. Fix (el paso ya anotado en Pendientes): `wheel_yaw_deg` integra `gz/100·dt` desde el ancla (se cero-a al armar) y un P sobre el exceso fuera de `WHEEL_YAW_DB=1°` se suma al MISMO canal y con el MISMO signo del yaw-assist (`correction += −clamp(2.0·exc, ±12)·0.23`) — como el rumbo es la integral de gz, hereda la polaridad ya validada del assist, sin signo nuevo que verificar. Knobs: `WHEEL_YAW_KP=2.0` (°/s eq por °), `WHEEL_YAW_MAX=12` (~2.8% PWM diferencial). Si girara lento y constante CON esto activo → bias residual del gyro: subir `WHEEL_YAW_DB`. El lazo de rotación por encoders queda además como estaba. NO compilado (el usuario compila). | Usuario: "ahora el PID corrige muchísimo mejor pero va girando lentamente hacia la derecha, esto no debería suceder" |
| 2026-07-26 | Core/Src/main.c | **Pantalla "ROBOT CAIDO": no aparece hasta el primer modo activo + dura 3s (antes 5s).** `FALL_ALERT_DISPLAY_MS` 5000→3000. Flag nuevo `fall_alert_armed`: arranca en 0 y se pone en 1 (para siempre) en `Ctrl_CambiosDeEstado` apenas `robot_state != IDLE`; mientras esté en 0, la detección de caída estampa igual la foto (`fall_trip_*`) pero deja `fall_alert_until_ms=0` → la pantalla de alarma no toma el display (al encender con el robot acostado aparecía de entrada). El indicador chico "F!" del header se mantiene. La pantalla de LIMITE DE VELOCIDAD comparte el gate pero no cambia en la práctica (ese fault solo puede dispararse en modos activos, ya armado). NO compilado (el usuario compila). | Usuario: "que la pantalla de robot caído no aparezca hasta que ingreso a cualquier modo que no sea IDLE — queda feo al iniciar; y que aparezca menos tiempo, 3 segundos" |
| 2026-07-24 | Core/Inc/UNER.h, Core/Src/UNER.c, Core/Src/main.c, (Qt: mainwindow.cpp) | **`GETSPEED=0xA4` implementado punta a punta + validación centralizada de floats.** (1) **GETSPEED**: respuesta = 3 floats LE: velocidad global [m/s, **+ = adelante** — UNER.c invierte el signo de `velocity_est_f`, cuya convención interna es negativo=adelante], rueda derecha [rps], rueda izquierda [rps]. Bindings nuevos al final de `UNER_Bindings_t` (`velocity_mps`, `wheel_right_rps`, `wheel_left_rps` → `velocity_est_f`, `speed_right_rps_s`, `speed_left_rps_s`). En Qt (`decodeData` de `mainwindow.cpp`) case nuevo que loguea "VELOCIDAD -> X m/s | Rueda D/I rps" y detecta por longitud un firmware viejo sin el handler. Ojo: es la velocidad cuantizada de encoders (piso ≈0.32 m/s por tick, ver pendiente de resolución). (2) **Helper `getF32BoundedFromRx(rx,out,lo,hi)`**: rechaza NaN/Inf (no escribe) y recorta al rango; aplicado a TODOS los comandos float — KP/KD/KI balance y línea (0..200), LINE_THRES (0..4095), STEERING (±60), LINE_SPEED (0.20..4.00), SETPOINT (±10°), KV_BRAKE (0..100), ROTATE_CUSTOM (±360°), BETA_G/A (0..1). (3) **BETA_G/A (0xBC/0xBD) ahora responden UNKNOWN si no hay binding** (los betas hoy son defines fijos y los punteros quedan NULL — antes ACK mentiroso; ver Pendientes). NO compilado (el usuario compila ambos proyectos). | Usuario: "lo de velocidad lo podes agregar, y hace las mejoras que te parezcan necesarias para robustez" |
| 2026-07-24 | Core/Src/UNER.c | **Auditoría completa del flujo UNER (STM32 ↔ Qt) + 3 fixes.** (1) **`MODIFY_KV_BRAKE=0xBF` NO tenía case en `decodeCommand`**: Qt lo enviaba y el firmware respondía UNKNOWN sin tocar `KV_brake_value` — el ajuste de KV desde Qt estaba roto desde siempre (el puntero `p_KV_BRAKE` se registraba pero nunca se usaba). Agregado el case con isfinite + clamp 0..100 (`KV_BRAKE_CMD_MAX`, mismo rango que el diálogo de Qt) y ACK. (2) **`MODIFY_SETPOINT=0xC8` sin validación**: el spinbox de Qt permite ±180° y se aplicaba directo a `setpoint_trim` — un valor grande volteaba el robot. Ahora isfinite + clamp ±10° (`SETPOINT_TRIM_MAX_DEG`), mismo patrón que 0xC4. (3) **Respuesta `FIRMWARE=0xF1` declaraba 13 bytes pero enviaba 11** (frameLength 12 hardcodeado vs "UNER V1.0" de 9 chars): trama corta desincronizaba el parser de Qt; ahora el largo se calcula con sizeof. Verificado OK (sin cambios): trama de Qt para 0xC4 (checksum incluye header, NBYTES=6 ✓), clamp 0.20..4.00 coherente en ambos lados, mirror `WifiOdomData_t`/`WifiLogData_t` en Qt coincide byte a byte, `ODOM_LINE_STATE_OBJ_FIRST=13` en Qt ya coincide con `LINE_STATE_OBJ_FRENO_REVERSA=13` post-renumeración, `USBRxData` SÍ llama `UNER_PushByte` (el pendiente que decía lo contrario estaba obsoleto — removido). Vestigial detectado: `GETSPEED=0xA4` ("VELOCIDAD" en el combo de Qt) no tiene handler en STM32 ni parser de respuesta en Qt — muerto en ambos lados, se deja documentado. NO compilado (el usuario compila). | Usuario (goal): revisar el flujo de todos los comandos UNER, en especial los nuevos de velocidad del seguidor (0xC4) y setpoint/ángulo (0xC8), que hacía tiempo no se usaban |
| 2026-07-21 | Core/Inc/UNER.h, Core/Src/UNER.c | Formalizado `MODIFY_LINE_SPEED=0xC4` como velocidad objetivo real en m/s. STM32 recibe el float32 ya enlazado a `LINE_SPEED_TARGET`, descarta NaN/Inf y limita cualquier pedido al rango operativo 0.20..4.00 m/s antes de aplicarlo; conserva el ACK y la compatibilidad de protocolo. | Completar el control de velocidad solicitado desde la nueva interfaz Qt sin permitir valores peligrosos o absurdos. |
| 2026-07-21 | Core/Src/main.c | **Estación por rueda (Opción A) — lazo de POSICIÓN por rueda en modo BALANCE/IDLE.** Cada rueda tiene un lazo P PROPIO que mantiene su POSICIÓN (deriva neta `enc − ancla`), ENCIMA del balance común (`pwm_sat` intacto = autoridad principal). **Iteración del día**: primero se hizo lazo de VELOCIDAD (objetivo 0 rps, PI con integral propia por rueda). En el robot rechazaba empujones muy bien PERO la rueda derecha (más fricción) vibraba muchísimo: un lazo de velocidad=0 pelea con el vaivén natural del balance (la rueda TIENE que mecerse para no caerse) → oscilación creciente/stick-slip; el filtro EMA, la banda muerta de velocidad y la fuga de integral no alcanzaron (empeoró: oscilador de relajación). **Rediseño a POSICIÓN**: el vaivén del balance va y vuelve → desplazamiento neto ≈ 0 → el lazo NO lo ve; solo la deriva sostenida acumula posición. Zona muerta ancha `WHEEL_POS_DB=10` counts (~6 cm): DENTRO trim=0 exacto (punto dulce 100% libre), FUERA corrige solo el EXCESO (arranca en 0 en el borde, sin escalón). Primer intento fue **P puro** → oscilaba y "se iba para atrás" (resorte sin freno: P de posición sobre inercia sobrepasa). **Forma PD**: `KP=0.15` %PWM/count (resorte) + `KD=0.60` %PWM/rps (amortiguación por velocidad filtrada EMA, solo fuera de la zona), tope ±8% (`WHEEL_TRIM_MAX`). Tras el signo, el robot quedaba planto pero **giraba lento y constante**: la banda ancha por rueda dejaba rotar libre dentro de ±DB (la asistencia de rumbo por gyro amortigua la velocidad de giro pero no sostiene el rumbo). **Fix = descomposición común/diferencial** (mismo patrón que pwm_sat±correction): TRASLACIÓN (promedio, banda ANCHA `WHEEL_TRANS_DB=10` para ignorar meneos chicos sin vibrar) y ROTACIÓN (semidiferencia, banda ANGOSTA `WHEEL_ROT_DB=3` para atajar el giro), cada eje su PD; la descomposición es lineal → hereda el signo `+` verificado sin re-verificar. La derecha ve trans+rot, la izquierda trans−rot. **Estado al cierre del día: queda una traslación rotacional residual lenta — se dejó como PENDIENTE para 2026-07-22 (ver "Pendientes"), sin commitear ni tag** (la versión funcional guardada sigue siendo V26). Estáticas `wheel_pos_anchor_r/l` + `wheel_pos_armed` (recaptura el ancla al entrar a balance). Kill-switch `wheel_pi_enabled` (0 = comportamiento V26 exacto). SOLO en `Ctrl_MotoresBalance`; pendiente extender a línea/manual tras validar. **Signo verificado en el robot (2026-07-21)**: con `−(...)` amplificaba la deriva hacia adelante (realimentación positiva → se escapaba); la convención de encoder/motor de este chasis pide **`+(...)`** para que sea realimentación negativa. Si alguna vez se aleja del ancla, volver a `−(...)` en las 2 líneas de `wheel_trim_r/l`. Versión funcional previa etiquetada **V26** (commit ba790d5). NO compilado (el usuario compila). | Usuario: pidió un PID de balance por rueda (Opción A). Reportó vibración fuerte de la rueda derecha con el lazo de velocidad y sugirió ignorar desviaciones chicas en el punto dulce → se rediseñó a lazo de posición con zona muerta ancha. Pidió commit+push+tag V26 antes de empezar |
| 2026-07-20 | Core/Src/main.c, CHANGELOG.md, STM32F411CEUX_RAM.ld, STM32F411CEUX_FLASH.ld | **Rename `ControlStep10ms` → `ControlCiclo10ms`** (declaración, definición, llamada en el `while(1)` y comentarios de las etapas). Actualizadas también las referencias vigentes en la documentación (descripción de `main.c` en el árbol de archivos, las 2 filas de "Pendientes" que nombran la función, y el comentario de `_Min_Stack_Size` en ambos linker scripts). Las filas históricas del Registro de Cambios/CHANGELOG que mencionan el nombre viejo NO se tocan (son un registro de lo dicho en su momento). NO compilado (el usuario compila). | Usuario: pidió un nombre en español para el orquestador del loop de control ("controlador de flujo" en vez de "ControlStep10ms"); eligió `ControlCiclo10ms` entre las opciones sugeridas y pidió aplicarlo en todo el código |
| 2026-07-20 | Core/Src/main.c | **Timeout de "pared perdida" (esquive de objeto sin encontrar la pared) ya no manda a `ROBOT_STATE_IDLE` — pasa a `LINE_STATE_GIVEN_UP`.** En `Ctrl_LatchesPared()`, si tras `OBJ_WALL_MISSING_TIMEOUT_MS` (5s) nunca se vuelve a ver el lateral activo (ADC7/ADC5) durante el esquive, el robot se caía: `ROBOT_STATE_IDLE` corta el balance de golpe. Ahora usa el mismo patrón de "reposo total" que ya tenían los timeouts de `LOST_FWD`/`EDGE_FWD` (10s, cuando el retorno por odometría tampoco encuentra la línea): pasa a `LINE_STATE_GIVEN_UP` sin salir de `ROBOT_STATE_LINE_FOLLOWING` — sigue upright con freno de encoders (`Ctrl_SetpointDinamico`), sin más intentos de búsqueda, y retoma solo si la línea reaparece (`LineState_GivenUp`). NO compilado (el usuario compila). | Usuario: "en el esquive del objeto, si la pared nunca la encuentra, no quiero que se salga de modo seguidor de línea para ir derecho a IDLE porque se cae el robot — quiero que pase a modo REPOSO dentro de seguidor de línea, que siga manteniendo balance, como cuando pierdo la línea por mucho tiempo" |
| 2026-07-16 | Core/Src/main.c | **Refactor de legibilidad (goal): `ControlStep10ms` partido en 17 etapas + 18 handlers, y estados muertos eliminados. Sin cambios de lógica buscados; NO compilado (compila el usuario).** (1) **Estados muertos borrados**: `LINE_STATE_OBJ_ESPERA_REVERSA`, `LINE_STATE_OBJ_RETROCESO` (fuera de la cadena desde 2026-07-14) y `LINE_STATE_OBJ_ARC` (reservado, nunca usado) eliminados del enum, del switch, de `LineStateStr`, de las ramas de setpoint y de todas las listas de exclusión; defines/estáticas huérfanas fuera (`OBJ_PRE_REVERSE_*`, `OBJ_REV_CLEAR_CNT/MAX_COUNTS/APPROACH_*/PUSH_ANGLE/BRAKE_KP/ACTIVE_BRAKE_MAX`, `LINE_OBJ_REV_TILT_MAX`, `OBJ_ARC_*`, `obj_pre_rev_start_ms`, `obj_rev_initialized`, `obj_rev_clear_cnt`, `obj_arc_steer_int`). ⚠️ **Esto RENUMERA los valores de `line_state` que viajan a Qt en `WifiOdomData_t` (los OBJ_* bajan 2; los previos a OBJ no cambian)** — si Qt interpreta el número (Vista 3D), actualizar su mirror. Las comparaciones `>= OBJ_ESPERA_REVERSA` pasaron a `>= OBJ_FRENO_REVERSA` (primer estado OBJ vigente). (2) **Reestructuración**: `ControlStep10ms` (~3300 líneas) quedó como orquestador de ~20 líneas que llama etapas `Ctrl_*` en orden (LeerIMU→VelocidadEncoders→LatchesPared→Odometria→SteeringLazoCerrado→TimingDt→FiltroIMU→CuarentenaLinea→EntradasLinea→OverrideManualLinea→CambiosDeEstado→SetpointDinamico→DeteccionCaida→PIDBalance→MezclaMotores→Telemetria→SalidaMotores); cada case del switch de `line_state` es ahora una función `LineState_*` propia despachada por `Ctrl_MotoresLinea`. Las ex-locales compartidas entre etapas son ahora "variables de ciclo" file-scope con los MISMOS nombres (bloque comentado antes de `Ctrl_LeerIMU`); los `break` internos de cases pasaron a `return`; `late_cycle` quedó como const file-scope documentado como vestigio (siempre 0); local `error` de `ComputeSteeringPID` renombrada a `steer_err` (evita shadowing). Cuerpos de código NO tocados salvo lo descripto. (3) **Verificación mecánica** (sin compilar): llaves/paréntesis balanceados ignorando strings/comentarios, profundidad nunca negativa, todas las funciones nuevas a nivel superior, reindentado por script validado con `diff -w` (solo whitespace), UTF-8 intacto. Backups pre-refactor en el scratchpad de la sesión. **Pendiente: compilar (cero warnings) y probar en el robot TODOS los modos.** | Usuario (goal): "que el código quede lo más legible y sencillo de leer sin romper nada de la lógica" — eligió reestructurar en funciones, borrar los estados muertos ya, y compilar él al final |
| 2026-07-16 | Core/Src/main.c | **Comentarios pedagógicos sobre las fórmulas del control (solo comentarios, cero cambios de lógica/código ejecutable).** El usuario está estudiando el firmware y pidió explicaciones de las fórmulas EN el código (rechazó explícitamente un documento aparte). Agregados en: conversión encoders→m/s (análisis dimensional counts→rps→m/s, convención avance=negativo), filtros EMA (y += β·(x−y), τ≈dt/β), escala del gyro (LSB→°/s, por qué 100 y no 131), ángulo por accel (atan2 de la gravedad, por qué solo vale cuasi-estático), filtro complementario (98/2, τ≈0.49s), tilt lateral (atan2(-ax,√(ay²+az²))), centroide de línea (pesos cuadráticos {±9,±1}, normalización por 9·w_sum), speed_factor cuadrático, PI velocidad→ángulo (cascada: lazo externo pide grados, balance los convierte en PWM), PID de balance (términos P/I/D con unidades, derivada por diferencia finita y sus clamps), soft zone (interpolación lineal 0.35→1), anti-windup (integración condicional), slew-rate del PWM (±8/ciclo), PID de línea (segundo PID: común vs diferencial; EMA antes de derivar), odometría (dead-reckoning, Δθ=ω·dt, regla del trapecio en θ_medio), MotorControl (duty%→CCR: CCR=(ARR+1)·duty/100). NO compilado (el usuario compila) — al ser solo comentarios no cambia el binario. | Usuario: "no entiendo las fórmulas… me gustaría que lo agregues como comentario para lograr comprenderlo sin moverme del código" |
| 2026-07-14 | Core/Src/main.c | **STOP neto de 2s sobre la línea después del giro perpendicular (`LINE_STATE_PERP_SETTLE`, display "PSTOP").** Al reencontrar la línea tras el esquive (saliendo de pared>avanza/gira), el robot llegaba con velocidad, hacía el giro de `PERP_ROTATE` y retomaba FOLLOWING lanzado — "envión que lo desestabiliza" (reportado). Estado nuevo entre el giro y FOLLOWING: `PERP_SETTLE_MS=2000ms` de upright + freno de encoders + **hold de posición** (mismo patrón y constantes `OBJ_PAUSA_POS_*` que el hold de PAUSA_GIRO: ancla de encoders al entrar, 0.06°/count, tope ±1.5°, banda muerta 3 counts, primer ciclo sin corregir) + yaw-assist de gyro como los demás holds. A los 2s pasa a FOLLOWING con los resets de siempre (integral, `line_lost_ms`, `all_black_start_ms` para no re-disparar PERP). Como el giro de PERP ya sigue el sentido del último esquive, el frenado queda automáticamente "dependiendo del lado al que esquivó". Aplica a TODOS los cruces perpendiculares (también los de una intersección normal): 2s de estabilización ahí también, considerado aceptable/beneficioso. NO compilado (el usuario compila). | Usuario: "ni bien ve la línea luego de esquivar, tras pared>avanza o giro, se acelera demasiado — agregá un período de STOP neto de 2 segundos que frene sobre la línea y luego siga sin envión" |
| 2026-07-14 | Core/Src/main.c | **`OBJ_REV_HOLD_ANGLE_MAX` 1.6→2.6°.** El hold de distancia del STOP a veces "intenta corregir pero el ángulo no le da" (reportado): la corrección proporcional saturaba en 1.6° y con fricción alta quedaba empujando sin moverse hasta que el anti-stall (rampa lenta, ~1s) lo destrababa. Techo subido a 2.6°; `ANGLE_MIN` (0.9°) y el anti-stall de respaldo sin cambios. | Usuario: "hay veces que intenta corregir pero no logra porque el ángulo no le da" |
| 2026-07-14 | Core/Src/main.c | **El giro de esquive ya no puede abortar hacia la línea + hold de posición en la pausa post-giro.** (1) **Aborto eliminado**: el ajuste fino del giro (fase 2) abortaba a `LOST_FWD` si el lateral (ADC5/ADC7) nunca vio la pared — pensado para detecciones fantasma (2026-07-10). En el esquive a IZQUIERDA pasaba seguido (reportado: "si ve la línea durante el giro se sale del modo esquive", confirmado por display: la cadena era giro→VUELVE→SIGUE instantáneo → el robot volvía derecho al obstáculo; a derecha no pasaba porque ADC7 sí confirma la pared). Con la entrada por fase STOP el objeto ya está confirmado de sobra por A6/A8 (fantasma casi imposible): ahora el giro SIEMPRE sigue a `PAUSA_GIRO`; si la pared realmente no está, el timeout de pared perdida (5s→reposo) cubre ese caso sin regresar hacia el obstáculo. `obj_rot_p2_seen` eliminado (quedó sin lectores). Esto implementa el "que ignore la línea mientras gira": ningún estado del giro/pausa reacciona a la línea ahora. (2) **Hold de posición en `PAUSA_GIRO`** (pedido: "luego del giro que mantenga posición un poco mejor"): antes upright + freno por velocidad LENTA (solo frena, no devuelve la deriva). Nuevo P por encoders: ancla `obj_pausa_r0/l0` al entrar, corrección `OBJ_PAUSA_POS_KP=0.06°/count` (≈1° por 10 cm), tope ±1.5°, banda muerta 3 counts (~2 cm); primer ciclo sin corregir (el ancla se estampa en el case, que corre después del setpoint). NO compilado (el usuario compila). | Usuario: "si ve la línea durante el giro se sale del modo esquive (a la derecha no pasaba) — que la ignore mientras gira y los primeros segundos de la pared" + "luego del giro que hace, que mantenga posición un poco mejor" |
| 2026-07-14 | Core/Src/main.c, Balancin_Mendelevich.ioc | **ADC clavados en ~4095: causa raíz probable encontrada — tiempo de muestreo de 15 ciclos en los canales de línea.** Investigación pedida ("es por software, antes no pasaba"). Hallazgos: (1) **Los canales de línea (ranks 1-4) muestreaban con `ADC_SAMPLETIME_15CYCLES` (625 ns @ ADC 24 MHz)** mientras los de objeto usaban 144. El capacitor de sample&hold retiene la tensión del canal ANTERIOR del scan — y el rank 1 muestrea justo después del rank 8 (sensor de objeto, reposo ~4095 ≈ 3.3V). Con 625 ns y la impedancia alta del fototransistor del sensor de línea, el capacitor no llega a descargarse al valor real → el canal lee cerca del máximo aunque el sensor esté sano. **Esto explica TODO el cuadro**: por qué se clava en el tope y no en un valor cualquiera, por qué el dedo lo "arregla" (reflexión fuerte → fototransistor saturado → impedancia baja → el capacitor sí se descarga: no era soldadura fría), por qué es indefinido (dura mientras la iluminación del sensor sea marginal; `ADC1_Recover` no puede arreglarlo porque no es un problema de DMA) y por qué "antes no pasaba" (los canales de objeto —reposo 4095— se agregaron al scan después; el usuario intuyó bien con "el duty cycle de cada ADC": es exactamente el sampling time por canal). **Fix: los 8 canales a 144 ciclos** (barrido completo 8×156/24MHz = 52 µs, sobra margen en los 250 µs del trigger de TIM2). (2) El `.ioc` estaba **desincronizado** del código generado (decía 15/112 mezclados donde main.c ya tenía 144 en ranks 5-8) — una regeneración de CubeMX habría degradado también los canales de objeto en silencio; ambos archivos quedaron consistentes en 144. (3) `ADC1_Recover` hacía `__HAL_DMA_ENABLE` manual antes de `HAL_ADC_Start_DMA`: si el stream no llegaba a apagarse, la reconfiguración del HAL se ignora y la DMA sigue a mitad de buffer → TODOS los canales rotados un lugar (un canal de línea lee el 4095 de uno de objeto) — eliminado (peligro latente que el recover periódico de 3s re-sorteaba cada vez). NO compilado (el usuario compila). La cuarentena por software del 2026-07-10 queda como red de seguridad. | Usuario: "sigo teniendo problemas con los ADC que se disparan y quedan lanzados al máximo por tiempo indefinido; necesito saber por qué, es por software, antes no pasaba; puede intervenir el duty cycle de cada ADC — busquemos el problema" |
| 2026-07-14 | Core/Src/main.c | **Wall-following más cauteloso: sin acelerones bordeando la pared.** En pared>avanza (BORDEAR/PARED_LIBRE) el PI de crucero tenía `OBJ_WALL_SPEED_TARGET=1.0 m/s` y tope `OBJ_WALL_FWD_ANGLE=3.5°` — el doble de rápido que el avance VUELVE ya validado (LOST_FWD: 0.40/2.5°); además, desde parado el deadband de velocidad (0.35) hace leer el error completo → arrancaba con el tilt clavado en el tope. Resultado reportado: acelera demasiado y al llegar a la línea siempre se pasa. Bajado a: **target 0.70 m/s** (primero 0.45, "demasiado lento" probado en el robot — 0.70 es el punto medio pedido) y **tope 3.0°** (primero 2.5, el usuario pidió 3 en la misma sesión). Ganancias de freno intactas (KP_BRAKE=22, BRAKE_ANGLE=4°): la sobrevelocidad se sigue castigando fuerte. `BUSCAR_PARED` ya era cauteloso (0.3/1.5°) y `GIRO_PARED` no avanza por sí (upright+pivot) — su "acelerón" era el rearranque del PI al volver a BORDEAR, ahora limitado. NO compilado (el usuario compila). Si ahora bordea muy lento, subir `OBJ_WALL_SPEED_TARGET` de a 0.1. | Usuario: "en pared>giro o pared>avanza se suele acelerar demasiado, al llegar a la línea siempre se pasa — sé más crítico con las aceleraciones fuertes" |
| 2026-07-14 | Core/Src/main.c | **El giro del cruce perpendicular (`PERP_ROTATE`) sigue el sentido del esquive.** Al reencontrar la línea después de bordear el obstáculo (cruce con los 4 ADC en negro), el giro de 90° era SIEMPRE a la derecha (`PROT_DIR=1.0f` fija, convención histórica). Tras un esquive por derecha eso está bien, pero tras uno por IZQUIERDA girar a la derecha devolvía el robot directo al obstáculo. Ahora `PROT_DIR = (float)obj_esquive_dir`: gira hacia el mismo lado del último esquive (derecha→derecha, izquierda→izquierda). Sin esquive previo `obj_esquive_dir` vale +1 (se rearma al entrar al modo línea), así que el cruce perpendicular "normal" conserva la derecha histórica. No hizo falta tocar nada más del bloque: heading y counts ya se comparan en valor absoluto (mismo patrón del espejado del giro de esquive del 2026-07-13). NO compilado (el usuario compila). | Usuario: "si el esquive fue hacia la derecha, cuando vuelvo a ver la línea el giro lo debo hacer hacia la derecha sí o sí (si girara a la izquierda volvería al obstáculo instantáneamente); si el esquive es hacia la izquierda, girar hacia la izquierda también" |
| 2026-07-14 | Core/Src/main.c | **Wall-following: línea ignorada 3s→5s + rumbo recto en la reversa del STOP.** (1) **`OBJ_WALL_LINE_IGNORE_MS` 3000→5000**: en los primeros segundos de pared>avanza (BORDEAR) o pared>gira (GIRO_PARED) el robot a veces veía la línea (la misma que venía siguiendo, todavía a la vista) y abortaba la esquiva a FOLLOWING sin rodear el obstáculo — la ventana compartida de los 3 estados de pared (medida desde la entrada a toda la secuencia, `obj_wall_seq_start_ms`) pasa a 5s. (2) **La reversa hasta el setpoint de ADC salía chueca**: al sacar `OBJ_RETROCESO` de la cadena (cambio de hoy, entrada directa a STOP) se perdió su corrección de rumbo — el hold del STOP retrocedía sin corregir nada. Portado el mismo mecanismo al case de `OBJ_FRENO_REVERSA`: ancla el rumbo de entrada (encoders `obj_rev_r0/l0` al iniciar la fase) y P sobre la diferencia ACUMULADA de counts (`REV_STRAIGHT_KC/MAX/SLEW`, gate por actividad de encoders `REV_STRAIGHT_ACT_MS` — quieto no pivotea), activo durante toda la fase y en ambos sentidos del hold. Reusa las estáticas `obj_rev_*` (libres: RETROCESO está fuera de la cadena). NO compilado (el usuario compila). | Usuario: "por ahí ve la línea en los primeros segundos de pared>avanza o pared>gira y no esquiva el obstáculo — que la esquive los primeros 5 segundos" + "la reversa hasta el setpoint de ADC la suele hacer chueca, no corrige demasiado para hacerla recta" |
| 2026-07-14 | Core/Src/main.c | **Detección de objeto: la fase ESPERA ("ESPER" en display) eliminada de la cadena — la detección entra DIRECTO a la fase STOP (`OBJ_FRENO_REVERSA`).** Motivo final: el balance libre de ESPERA no tiene ancla de posición — llegando con inercia el robot se iba un poco para atrás y **perdía la pared** (los A6/A8 quedaban fuera de rango y la secuencia seguía a distancia equivocada). El hold de distancia del STOP hace todo desde el primer ciclo: `hold_damp` frena la inercia y la corrección proporcional lleva/sostiene la distancia en la banda 3500..3900 de A6/A8; después la ventana de estabilidad (2s en banda + 3s mínimos) y el giro, como siempre. Se agregó **anti-stall (tag 9)** al hold fuera de la banda fina, porque ahora el hold cubre TODA la reversa y su corrección máxima es de solo 1.6° (`OBJ_REV_HOLD_ANGLE_MAX`) — si la reversa queda lenta/corta en el robot, subir ese define. `OBJ_ESPERA_REVERSA` y `OBJ_RETROCESO` quedan fuera de la cadena activa (código intacto, marcados en el enum; borrables cuando el esquema se valide). **Historia del día (3 iteraciones)**: (1) primero se hizo este mismo salto directo a STOP; (2) el usuario reportó "rompiste el giro" y pidió volver a ESPERA(1s)+RETROCESO+STOP (`OBJ_PRE_REVERSE_HOLD_MS` 2000→1000, que queda así aunque el estado esté fuera de la cadena); (3) al ver que aun con 1s el ESPER derivaba hacia atrás y perdía la pared, pidió eliminar ESPERA y entrar directo a STOP — este estado final. Si el giro vuelve a salir mal, pedir detalle de QUÉ hace (¿gira demasiado cerca? ¿no gira?) antes de tocar — la sospecha de la iteración 1 es que la reversa por hold termina a otra distancia que la del RETROCESO. NO compilado (el usuario compila desde esta sesión). | Usuario: "el período que dice en el display ESPERA hace que se vaya un poco para atrás y pierda la pared; necesito que ESPERA no exista, pase directamente a STOP" |

### Snapshot histórico — sesión 2026-05-27 (superseded, ver Registro de Cambios abajo para todo lo posterior)
> Este bloque quedó de una sesión vieja y NO se actualizó desde entonces — no confundir con la sesión
> más reciente. El detalle completo (y todos los cambios posteriores) está en "📋 Registro de Cambios".
- **6 bugs de stale-state corregidos** en la máquina de evasión: `obj_rev_initialized`, `obj_brake_start_ms`, `obj_rot_initialized`/`obj_rot_start_ms`, `line_error_f_d`, `line_obj_rev_vel_integral` — todos causaban saltos prematuros de estado al recuperarse de una caída
- `KV_brake_value` ahora efectivamente usado en `ComputeBrakeSetpointTarget` (antes el slider de Qt no tenía efecto)
- `obj_hold_initialized` (dead code) eliminado
- **Wall-following implementado**: OBJ_ARC reemplazado por `OBJ_WALL_FWD` + `OBJ_WALL_TURN`. Usa ADC7 (`adcAvg[6]`) como sensor lateral. Cadena activa: FOLLOWING → WAIT(1s) → REVERSE(10c) → BRAKE → ROTATE(325c) → HOLD(2s) → WALL_FWD ↔ WALL_TURN → FOLLOWING.
- `OBJ_WALL_FWD`: ángulo fijo `5.5°`, avanza mientras ADC7 < 3750. Si ADC7 < 300 ("demasiado cerca") → pivot derecha. Si ADC7 > 3750 → WALL_TURN.
- `OBJ_WALL_TURN`: pivot izquierda (potencia 20) hasta re-ver ADC7 < 3750. Si ADC7 < 300 → pivot derecha en cambio.
- `OBJ_DETECT_THRESHOLD_VAL` subido de `2000` → `3200` (sensores hardware actualizados con nuevas resistencias, mayor alcance)
- `OBJ_WALL_PIVOT_POWER` = 8.0 (subido de 5 que era insuficiente, bajado de 20 que era demasiado agresivo)
- Línea ignorada durante `OBJ_WALL_LINE_IGNORE_MS=3000ms` al entrar en WALL_FWD (evita volver a FOLLOWING prematuramente al cruzar la línea original)
- `rev_target_counts` reducido de `300` → `10` counts; hold pre-reversa reducido de 2s → 1s

---

## Registro de Cambios

| Fecha | Archivo(s) modificado(s) | Cambio realizado | Motivo / Observación |
|---|---|---|---|
| 2026-07-14 | Core/Src/main.c | **Pantalla ODOMETRIA del OLED: rumbo (y mapa) espejados — corregido.** La flecha de rumbo giraba al revés de la realidad (girando a la derecha apuntaba a la izquierda). El dato `odom_theta_deg` está BIEN (convención estándar: x adelante, y a la IZQUIERDA, θ positivo antihorario) — el bug era solo del dibujo: el mapa mapeaba "+Y odométrico hacia la derecha de la pantalla", espejando todo el plano (yendo derecho no se notaba, de ahí que "la dirección en la que se mueve está bien"). Fix: negado el término Y/senθ en las 3 coordenadas de pantalla (punto de pérdida de línea `lx`, pose `px`, punta de flecha `hx`) — ahora +Y dibuja a la izquierda y la flecha gira para el mismo lado que el robot. Ninguna otra pantalla ni la odometría en sí cambian; el mapa de Qt no se toca (recibe el dato crudo, que era correcto). De paso este síntoma es evidencia de que `ODOM_THETA_SIGN=+1` está bien calibrado (girando a la derecha θ se hace negativo, como pide el comentario de la línea ~797). Compilado con GCC 13.3 de CubeIDE: cero errores, cero warnings. | Usuario: "la odometría del display apunta en la dirección incorrecta: si gira a la derecha apunta hacia el otro lado; solo es la dirección en la que apunta, la dirección en la que se mueve está bien" |
| 2026-07-13 | Core/Src/main.c | **Esquive alternado derecha/izquierda con lateral ADC7/ADC5.** Nuevas estáticas `obj_esquive_dir` (sentido del esquive ACTUAL: +1 derecha, -1 izquierda) y `obj_esquive_next_dir`: en cada detección de objeto la esquiva usa el sentido programado y deja armado el opuesto para la próxima (la primera va a la derecha; al entrar al modo línea se rearma en derecha). **Mismos mecanismos, umbrales y constantes en ambos sentidos** (pedido explícito): solo cambian (1) el sentido del giro de 90° de `OBJ_GIRO_ESQUIVE` (local `rot_dir` multiplica pivot y freno en fases 0/1/2, el heading ya se comparaba en valor absoluto) y (2) el **sensor lateral**: `OBJ_WALL_ADC_IDX` pasó de la constante 6 a `((obj_esquive_dir > 0) ? 6 : 4)` — ADC7 esquivando a derecha (pared a la izquierda, histórico), ADC5 a izquierda (pared a la derecha) — con lo que TODO lo que ya colgaba de ese define (BUSCAR/BORDEAR/LIBRE/GIRO_PARED, latch de reversa, detección de atorado, timeout de pared perdida, ajuste fino del giro) quedó espejado sin tocarlo. Los 4 pivots de pared (3× too_close "alejarse" + búsqueda de GIRO_PARED "acercarse") multiplican `OBJ_WALL_PIVOT_POWER` por el sentido. Display: pantallas 1 y 6 muestran `A7:`/`A5:` según el sentido activo (label y valor dinámicos). La detección de objetos (ADC5-8) no cambia. **Nota Qt**: la pared 3D de la Vista 3D usa `min(adc5,adc6,adc8)` — durante un bordeo IZQUIERDO ADC5 ve la pared de al lado y Qt va a dibujar una barrera fantasma de frente; si molesta, excluir el lateral activo (el firmware ya manda `robot_state`/`line_state` en `WifiOdomData_t`). Compilado con GCC 13.3 de CubeIDE: cero errores, cero warnings. Pendiente validar en el robot (encoders/gyro en giro a izquierda). | Usuario: "necesito que hagamos el esquive en el sentido izquierdo: ahora giramos a la derecha; quiero usar el ADC5, que haga un esquive para la derecha como ahora y el próximo a la izquierda" + "los mismos mecanismos, solamente la rotación 90° hacia el otro lado, y el ADC5 para pared>avanzar y pared>girar como hago con el ADC7" |
| 2026-07-13 | Core/Src/main.c | **Reversa por obstáculo: fin del tambaleo (PI sin equilibrio posible → feedforward) + rumbo recto (gate por actividad de encoders) + "F!" centrado en el display.** (1) **Tambaleo sin poder retroceder**: el PI de velocidad de `OBJ_RETROCESO` no tenía punto de equilibrio — el target (≤0.30 m/s) quedaba DEBAJO del piso de medición (`apply_deadbandf(vel, 0.35)` lee 0 hasta pasar 0.35 m/s reales): medido 0 → empuje máximo + windup; al cruzar el deadband el error saltaba negativo de golpe (KP=28 → 3° por escalón del LPF) → freno activo → quieto → empuje máximo otra vez. Bang-bang permanente = el tambaleo reportado. Reemplazado por **empuje feedforward** `OBJ_REV_PUSH_ANGLE=3.5°` escalado por la aproximación (la fricción la cubre el anti-stall, que sigue igual) + **freno proporcional suave** `OBJ_REV_BRAKE_KP=6°/(m/s)` solo con sobrevelocidad REAL (por encima del deadband), piso `-OBJ_REV_ACTIVE_BRAKE_MAX` como antes. Eliminados el integral (`line_obj_rev_vel_integral` y sus 11 resets), `LINE_OBJ_REV_SPEED_MIN/MAX`, `LINE_OBJ_REV_VEL_KP` y los defines muertos `LINE_OBJ_REV_STEER_GAIN/MAX` (sin uso desde el fix de zigzag). (2) **Va muy torcido**: la corrección de rumbo se apagaba con `velocity_est_f < 0.12` — a velocidad de reversa el LPF de la velocidad cuantizada suele leer menos que eso aunque retroceda, así que la corrección quedaba muda casi toda la reversa. Nuevo gate por **actividad de encoders**: corrige si hubo algún tick en los últimos `REV_STRAIGHT_ACT_MS=250ms` (estáticas `obj_rev_last_counts/obj_rev_last_move_ms`); quieto de verdad el target sigue decayendo a 0 por el slew (el anti-pivoteo del 2026-07-10 se conserva). `REV_STRAIGHT_MIN_VEL` eliminado. (3) **Display**: el "F!" de caído dejó la pila de la derecha del header (se mezclaba con modo/WiFi) y ahora se dibuja centrado; el splash de conexión WiFi también quedó todo centrado (RED/SSID/IP/PC — antes alineado a la izquierda). Helper nuevo `OLED_Str5Centered(y, s)` usado en ambos. Compilado con GCC 13.3 de CubeIDE: cero errores, cero warnings. Pendiente validar en el robot (tuneo: si retrocede muy fuerte bajar `OBJ_REV_PUSH_ANGLE`; si frena de más bajar `OBJ_REV_BRAKE_KP`). | Usuario: "le cuesta bastante ir hacia atrás con el setpoint cuando ve el objeto, se pone a tambalearse sin poder ir hacia atrás; además, si va hacia atrás va muy torcido" + "el FALLEN del display se mezcla con lo otro, que se marque más en el centro" + "que los datos del display cuando aparece la pantalla de wifi aparezcan centrados" |
| 2026-07-12 | Core/Src/main.c, Core/Src/UNER.c, Core/Inc/UNER.h, Core/Src/fonts.c, `C:\Microcontroladores\BalancinQT` (robotviewer3d.h/.cpp) | **Sesión de revisión de bugs en ambos códigos (pedido: "todo el código sin ningún bug").** Firmware: (1) el timer del timeout de pared perdida ya NO corre durante la reversa de pared (`obj_wall_rev_latch`) — la reversa de escape dura hasta 6s sin ver ADC7 y el timeout de 5s la cortaba a IDLE en plena maniobra válida; (2) `USB_Debug` con formato terminado en `%` leía más allá del fin del string (out-of-bounds read latente) — ahora corta; (3) `CHANGE_DISPLAY` desde Qt hacía `% 6` pero hay 8 pantallas (nunca llegaba a OBJ/ODOM) — ahora `% 8` como el botón físico; (4) `ROTATE_CUSTOM` leía el payload desde `indexR+2..5` que apunta DESPUÉS del checksum (fuera del frame, basura) — reescrito con `getByteFromRx` como el resto de los comandos; (5) código muerto eliminado: `UNER_SendSerial`, `UNER_SendLogData` y el struct `LogData_t` (nadie los llamaba; Qt no tiene handler de 0xB8); (6) `Font_5x7.data` apuntaba a un array `uint8_t` siendo el campo `const uint16_t*` (warning + trampa si alguien usa el renderer genérico con esa fuente, que tiene OTRA codificación) — ahora NULL con nota; era el único warning de compilación, ahora cero. **Qt** (fix del hundimiento bajo el piso, tercera vez reportado): ver fila 2026-07-12 del CLAUDE.md de Qt — el bbox del mesh ahora se lee sincrónicamente del .obj (`loadModelBounds`); el `QBoundingVolume` podía no publicar nunca sus bounds y la corrección de piso quedaba muda en silencio. Firmware compilado con GCC 13.3 de CubeIDE: cero warnings, cero errores. | Usuario (/goal): "necesito que todo el código quede sin ningún bug, legible… sigo teniendo problema con que el auto se pasa hacia debajo del suelo en el qt, solucionalo, hacé commit y push en ambos códigos antes de tocar algo" |
| 2026-07-11 | Core/Src/main.c | **Timeout de pared perdida durante el wall-following: aborta a reposo (IDLE) si no la vuelve a ver en 5s.** Nuevo `obj_wall_missing_since_ms` + `OBJ_WALL_MISSING_TIMEOUT_MS=5000ms`, en el mismo bloque compartido de los 3 estados de pared (`BORDEAR_PARED`/`PARED_LIBRE`/`GIRO_PARED`, junto al latch de reversa y la detección de atorado de 2026-07-10): si ADC7 nunca vuelve a bajar de `OBJ_WALL_THRESHOLD` durante 5s continuos mientras el robot avanza/pivotea buscándola, se corta `robot_state = ROBOT_STATE_IDLE` (reposo) en vez de seguir insistiendo a ciegas con riesgo de choque. Al salir de los 3 estados de pared por cualquier otra vía el timer se resetea (igual que el latch y el timer de atorado). No hizo falta resetear `line_state` a mano: el bloque de entrada a `LINE_FOLLOWING` (línea ~2935) ya reinicializa todo desde cero la próxima vez que se reactive manualmente. Compilado con GCC de CubeIDE sin errores ni warnings. | Usuario: "durante pared>avanzar o pared>girar detectá cuando no hay más pared por varios segundos (~5s) y pasá automáticamente a modo reposo, para que no siga intentando encontrarla y se choque accidentalmente" |
| 2026-07-11 | Core/Src/main.c | **`OBJ_PRE_REVERSE_HOLD_MS` 5000→2000ms.** Tiempo mínimo de balance estático antes de autorizar la reversa post-detección de objeto, achicado de 5s a 2s. `OBJ_PRE_REVERSE_TIMEOUT` (colchón de seguridad, 6000ms) sin cambios. | Usuario: "OBJ_PRE_REVERSE_HOLD_MS quiero que sea de 2 segundos" |
| 2026-07-10 | Core/Inc/UNER.h, Core/Src/main.c, `C:\Microcontroladores\BalancinQT` (mainwindow.h/.cpp, robotviewer3d.h/.cpp) | **Tercer eje en la Vista 3D (banking lateral) + verificación numérica del apoyo en el piso.** (1) **Firmware**: `WifiOdomData_t` extendido con `lat_deg` (float, al FINAL — mirror Qt actualizado en la misma sesión): inclinación lateral alrededor del eje de avance, accel-only (misma fórmula que el pitch de `calculate_tilt`: atan2(-ax, √(ay²+az²))) con EMA α=0.10 a 100 Hz (`lat_tilt_f`, no participa de ningún control). (2) **Qt**: `setPose(pitch, yaw, lat)` — el modelo ahora se mueve en los TRES ejes (banking = rotación alrededor del X local/eje de avance, orden yaw∘pitch∘lat), interpolado como los otros dos y con `Lat:` en el HUD; `setPitch` conserva rumbo y banking. **Si el banking sale invertido, negar `lat_deg` en el handler de 0xDC** (incógnita de signo hermana de ODOM_THETA_SIGN). (3) **Apoyo en el piso**: el usuario reportó que con ángulo negativo seguía hundiéndose — se verificó la fórmula con un test numérico standalone (mismas matrices T·R·S de Qt3D): el punto más bajo queda clavado en +0.6 para ±45/±90/±120°, con y sin rumbo — la matemática es exacta y simétrica; el hundimiento visto era un **binario viejo corriendo** (la app quedó abierta desde antes del rebuild de las 16:42). Ambos exe recompilados (debug y release, 22:06). | Usuario: "con ángulo negativo se pasa por debajo del suelo siempre" + "me gustaría que también reaccione a movimientos laterales, es el único eje que falta" |
| 2026-07-10 | Core/Src/main.c | **Cuarentena de sensores de línea enganchados (defensa por software; la causa es hardware).** El usuario reporta (recurrente) que un ADC de línea queda clavado en el tope (~4095) y solo baja presionándolo con el dedo — síntoma clásico de **soldadura fría/falso contacto** (la presión restablece el contacto) o emisor IR caído. NO es el bug de software de 2026-07-05 (el promedio móvil se recalcula entero por ciclo desde entonces): si la barra queda clavada, el canal crudo está alto de verdad. Defensa nueva: si un canal de línea (1-4) pasa `LINE_STUCK_MS=8s` continuos por encima de `LINE_STUCK_ADC=3950`, entra en **cuarentena**: contribuye 0 al centroide y a `line_detected`, invalida `all_black` (conservador: sin giros PERP fantasma por un sensor roto), no marca `det` en la franja del display, y su dígito en pantalla 1 se reemplaza por una **X** (diagnóstico visual de qué sensor revisar). Sale de cuarentena solo, apenas vuelve a leer blanco (< LINE_THRESHOLD) — el arreglo con el dedo lo rehabilita al instante. Sin cuarentena, el canal clavado fingía línea permanente de ese lado: arrastraba el centroide, impedía detectar la pérdida de línea y ensuciaba all_black. **Pendiente de hardware**: revisar soldadura/conector del sensor que marque X (el de la izquierda del display = dígito 4 = ADC4/PA4). Compilado con GCC de CubeIDE sin errores ni warnings. | Usuario: "sigo teniendo problemas con el ADC del seguidor de línea que se queda enganchado arriba del todo, el de la izquierda del todo; tengo que ponerle el dedo para que baje" |
| 2026-07-10 | Core/Src/main.c | **Anti-stall generalizado a TODOS los estados que requieren movimiento + destrabe por atascamiento en modo pared.** (1) El anti-stall ad-hoc de LOST_FWD se refactorizó a **`AntiStall_Tick(tag, wants_motion, max_boost)`** (una sola instancia global — los estados son mutuamente excluyentes; `tag` identifica la maniobra y resetea el boost al cambiar de llamador o tras >200ms sin llamadas). Defines `ANTISTALL_*` (VEL_THR 0.05, WAIT 400ms, STEP 0.04°/ciclo, DECAY 0.90, topes FWD 3.0/REV 2.5/MAN 2.0). **Enganchado en**: LOST_FWD (tag 1), EDGE_FWD (2), OBJ_BUSCAR_PARED (3), BORDEAR_PARED avance (4), reversa de pared en los 3 estados (5, compartido — misma maniobra), PARED_LIBRE avance (6), OBJ_RETROCESO (7, empuja hacia atrás solo si el PI pide reversa), MANUAL adelante/atrás (8, en el sentido comandado). FOLLOWING ya tenía su `line_forward_boost` — sin cambios. Ni la inclinación del piso ni la fricción pueden dejar quieto a ningún estado de movimiento. (2) **Destrabe por atascamiento** (pedido: "pared>avanza o pared>pivot atorado contra la pared"): en los 3 estados de pared, ventana de `OBJ_WALL_STUCK_WIN_MS=2500ms` (5s inicial, bajado el mismo día a pedido) — si el movimiento acumulado de encoders no llega a `OBJ_WALL_STUCK_COUNTS=20` (~13 cm), está trabado (empuja sin avanzar o pivot atorado, el anti-stall solo lo apretaría más): dispara el mismo latch de reversa pero con objetivo largo `OBJ_WALL_REV_ESCAPE_COUNTS=60` (~38 cm, timeout doble) para despegarlo de verdad antes de reintentar. La ventana no corre durante la reversa y se resetea al salir de los estados de pared. Compilado con GCC de CubeIDE sin errores ni warnings. | Usuario: "ese anti-stall ponelo en todos los lugares posibles donde se requiera movimiento, que la inclinación del suelo o cualquier objeto no detenga el robot" + "si en pared>avanza o pared>pivot en ~5s no cambia el pulso de encoder, se quedó atorado: reversa bastante para destrabar" |
| 2026-07-10 | Core/Src/main.c | **Aborto de la esquiva si la pared nunca aparece + más sobrepaso en el retorno por odometría.** (1) **Aborto a búsqueda por odometría**: nuevo flag `obj_rot_p2_seen` en el ajuste fino por ADC7 del giro de esquive — si al agotarse el ajuste (tope de counts o timeout) ADC7 NUNCA bajó de 3200 ni un ciclo, la detección fue fantasma o el objeto quedó fuera de alcance: bordear no tiene sentido. En vez de seguir a PAUSA_GIRO→BORDEAR (bordeando una pared inexistente), aborta la esquiva y pasa a `LINE_STATE_LOST_FWD` (el mismo retorno por odometría al punto de pérdida de línea del post-180°), con el reset completo de entrada (line_lost_ms, integrales, steering, vars de secuencia de pared) y 5s de `obj_detect_ignore_until_ms` como el resto de las salidas de pared. Si la vio aunque sea un ciclo (vislumbrada), sigue la secuencia normal. (2) **`LOST_RETURN_OVERSHOOT_M` 0.20→0.35**: con 0.20 (neto ~+0.10 tras el corte de `REACHED_M=0.10`) el robot se plantaba justo sobre el punto donde perdió la línea y no la encontraba ("se queda muy cerca") — entre el error de odometría y que los sensores están adelante, hace falta pasarse más para cruzar la cinta. (3) **Anti-stall del VUELVE (`LOST_FWD`)**: el PI de velocidad satura en P(1.6°)+I(1.0°) → techo 2.5° — si la fricción del momento pide más, quedaba clavado y el robot quieto para siempre. Nuevo boost en rampa (`LOST_FWD_STALL_*`): pidiendo avanzar y sin movimiento de encoders por 400ms, suma 0.04°/ciclo POR ENCIMA del clamp (tope +3°, clamp global 5.0 manda), y decae ×0.90/ciclo apenas se mueve — nunca puede quedarse quieto. Reset junto a cada reset del integral. Compilado con GCC de CubeIDE sin errores ni warnings. | Usuario: "si la pared no aparece en ningún momento que aborte y vuelva a buscar línea por odometría" + "que se pase un poco del punto para volver a encontrar la línea, va justo al punto donde la perdió pero se queda muy cerca" + "en modo VUELVE por odometría se queda quieto porque no le da el ángulo de avance — que nunca se quede quieto y siempre vuelva" |
| 2026-07-10 | Core/Src/main.c | **Giro de esquive verificado por ADC7: fase de ajuste fino si el giro quedó corto.** El giro de 90° de `OBJ_GIRO_ESQUIVE` cortaba solo por encoders/gyro y podía quedar corto (la pared sin entrar en la vista del lateral ADC7). Ahora, al completar la fase de freno: si `ADC7 < OBJ_ROT_ADC_GOOD=3200` → buena detención, sigue a PAUSA_GIRO como siempre; si NO bajó de 3200 → **fase 2 de ajuste fino**: pivot suave a la derecha (mitad del pivot normal) hasta ver `ADC7 < 3200` durante `OBJ_ROT_ADC_GOOD_CYC=3` ciclos seguidos (30ms, anti-glitch), con tope de `OBJ_ROT_ADC_EXTRA_MAX=150` counts extra (~36°) y timeout `OBJ_ROT_ADC_EXTRA_MS=1500ms` por si la pared quedó fuera de alcance — en ese caso sale igual a PAUSA_GIRO. La salida por **overshoot NO entra al ajuste fino** (girar más solo empeoraría). Freno de continuidad en ambas salidas, igual que la fase 1. Estáticas nuevas: `obj_rot_p2_c0/obj_rot_p2_ms/obj_rot_adc_good_cnt`; `obj_rot_phase` ahora puede valer 2 (solo en GIRO_ESQUIVE — LOST/EDGE/PERP_ROTATE no cambian). Nota: las iteraciones 1-4 de la reversa/STOP de hoy quedaron **validadas por el usuario en el robot ("funciona perfecto")**. Compilado con GCC de CubeIDE sin errores ni warnings. | Usuario: "el giro además de los encoders debería usar el ADC7 para saber cuándo detenerse o si se detuvo bien: debajo de 3200 es buena detención, si no pasó por debajo le falta un poco más" |
| 2026-07-10 | Core/Src/main.c | **Reversa/STOP por obstáculo, iteración 4: empuje real hacia atrás + ventana más ancha + reversa de pared por distancia fija.** (1) **Deadband en la medida del PI de reversa** (`OBJ_RETROCESO`): usaba `velocity_est_f` cruda — el piso de cuantización (1 tick lee 0.11 m/s tras el LPF) contra el target achicado por la aproximación (~0.07) daba sobrevelocidad FALSA y el freno activo nuevo inclinaba hacia adelante con el robot casi quieto ("le cuesta ir atrás y a veces avanza"). Ahora `apply_deadbandf(vel, BRAKE_VEL_DEADBAND)`: freno activo solo con velocidad real, y el empuje no se descuenta por ruido. `OBJ_REV_APPROACH_MIN` 0.20→**0.35** (0.20 dejaba la reversa sin fuerza al final). (2) **`OBJ_REV_HOLD_BAND` 300→400**: ventana de quieto/estabilidad pasa de 3500..3800 a **3500..3900** (pedido: "la ventana es muy ambiciosa"). (3) **Reversa de pared (`pared>retroceso`) por counts con latch**: era tilt fijo 3.0° mientras `ADC7 < 600` — 3° muchas veces no vencía la fricción (se quedaba quieto) y al despegarse unos mm ya salía de reversa y volvía a avanzar. Nuevo `obj_wall_rev_latch` (armado en el bloque de encoders, consumido por las ramas de setpoint Y de motores de BORDEAR/LIBRE/GIRO_PARED): al disparar retrocede **`OBJ_WALL_REV_COUNTS`=24 counts (~15 cm) fijos** antes de devolver el control (timeout `OBJ_WALL_REV_TIMEOUT_MS`=3s), y `OBJ_WALL_REVERSE_ANGLE` 3.0→**4.5°** para que arranque de verdad. Compilado con GCC de CubeIDE sin errores ni warnings. | Usuario: "le cuesta bastante ir hacia atrás, ahora avanza un poco", "la ventana 3500-3800 es muy ambiciosa", y "en pared>retroceso se queda quieto — debería ir varios pulsos hacia atrás para alejarse bien y luego esquivar" |
| 2026-07-10 | Core/Src/main.c | **Reversa/STOP por obstáculo, iteración 2: freno ACTIVO en reversa + término D (damping por velocidad) en el hold del STOP.** Con la aproximación desacelerada de la iteración anterior seguía pasándose: dos causas estructurales. (1) **El PI de velocidad de `OBJ_RETROCESO` era unilateral**: `reverse_angle_mag` clampeado a ≥0 — con sobrevelocidad solo podía "soltar el acelerador", nunca inclinar hacia ADELANTE para frenar de verdad; la inercia lo pasaba de largo aunque el target bajara. Ahora el clamp inferior es `-OBJ_REV_ACTIVE_BRAKE_MAX=2.5°`: sobrevelocidad → inclinación de frenado real. (2) **El hold del STOP era P puro sobre distancia**: el robot es un doble integrador (ángulo→aceleración→velocidad→posición) y un P de posición sin D oscila siempre — se pasaba hacia atrás, volvía hacia adelante y chocaba la pared. Nuevo término `hold_damp = OBJ_REV_HOLD_KV(4.0) × velocity_est_f` (deadband 0.15, tope ±2.5°), sumado en TODAS las ramas del hold: inclina en contra del movimiento y frena antes de pasarse en ambos sentidos. Usa la velocidad RÁPIDA de encoders — importante: la rama "en banda" usaba `ComputeBrakeSetpointTarget`, que desde el fix anti-bamboleo de hoy corre con la velocidad LENTA (tau ~0.5s) y acá llegaba tarde justo con la inercia máxima (regresión de hoy mismo, corregida acá). Compilado con GCC de CubeIDE sin errores ni warnings. Tuneo: si frena de más/queda corto en reversa bajar/subir `OBJ_REV_ACTIVE_BRAKE_MAX`; si el STOP queda nervioso bajar `OBJ_REV_HOLD_KV` de a 1. **Iteración 3 (mismo día)**: con el freno activo el robot pasa parte de la reversa casi quieto y el P de rumbo por counts (KC=-1.0) pivoteaba izquierda/derecha alrededor del rumbo inicial sin avanzar — `REV_STRAIGHT_KC` bajado a **-0.4** y la corrección de rumbo ahora corre **solo con |velocity_est_f| > REV_STRAIGHT_MIN_VEL=0.12 m/s** (parado, el target decae a 0 por el slew: no hay rumbo que mantener si no se traslada). | Usuario: "sigue muy inestable cuando va hacia atrás y no llega a frenar, siempre se pasa, teniendo que ir hacia adelante de vuelta y chocándose la pared, está muy brusco" |
| 2026-07-10 | Core/Src/main.c | **Reversa por obstáculo sin zigzag y sin sobrepasar el setpoint de distancia** (3 cambios complementarios; el 1º lo hizo el usuario a mano en esta sesión). (1) *Hold del STOP proporcional* (usuario): reemplazó el bang-bang de ±2.75° fijos por corrección proporcional al error de ADC con zona fina muerta (`OBJ_REV_HOLD_FINE_BAND=60`, ángulo 0.9–1.6° según `OBJ_REV_HOLD_ERR_FOR_MAX=220`) — mejoró bastante pero seguía oscilando. (2) *Fix zigzag de la reversa*: `OBJ_RETROCESO` iba con el PID de línea INVERTIDO mientras veía línea (lo normal, el objeto está sobre la línea; gain 0.70, ±16 PWM) — marcha atrás ese lazo es inestable y era el zigzag reportado; el P "recto" por encoders solo corría sin línea y encima usaba la velocidad instantánea (cuantizada en saltos de 3.57 rps = 1 count/ciclo, puro ruido). Ahora la reversa va SIEMPRE recta: P sobre la diferencia ACUMULADA de counts desde el inicio (`REV_STRAIGHT_KC=-1.0` PWM/count, mismo tope ±8 y slew 2; `rev_dr-rev_dl` ∝ desvío de rumbo, suave) — mantiene el rumbo inicial toda la reversa. `LINE_OBJ_REV_STEER_GAIN/MAX` quedan sin uso (rama eliminada). (3) *Aproximación desacelerada* (pedido del usuario: "ir bajando intensidad o ángulo a medida que llegamos al setpoint"): en los últimos `OBJ_REV_APPROACH_BAND=250` counts de ADC antes del corte (gobernado por el menor de A6/A8, el mismo que decide el corte), la velocidad objetivo se escala linealmente de 1.0 al piso `OBJ_REV_APPROACH_MIN=0.20`, y el tope de inclinación también (piso 0.4 para el arranque) — llega "en puntas de pie" y el hold del STOP arranca casi sin inercia que corregir. Compilado con GCC de CubeIDE sin errores ni warnings. Pendiente validar en el robot. | Usuario: la reversa zigzagueaba; sus cambios al hold mejoraron pero "sigue muy oscilante y le cuesta quedarse quieto en setpoint — deberíamos ir bajando intensidad o ángulo al llegar" |
| 2026-07-10 | Core/Src/main.c | **Splash de conexión WiFi en el display: al obtener IP se muestra por 4s SSID + IP propia + IP destino, pisando cualquier pantalla.** Nuevo `wifi_splash_until_ms` (+`WIFI_SPLASH_MS=4000`): se arma en `appOnESP01ChangeState` al recibir `ESP01_WIFI_NEW_IP` (mismo momento en que arranca el socket UDP — y también en cada reconexión), y al inicio de `updateDisplay()` un bloque previo al switch de pantallas dibuja: header "WIFI", "CONECTADO" centrado (7x10), `RED:` + SSID (truncado a 21 chars, copia manual anti -Wformat-truncation), `IP:` + `ESP01_GetLocalIP()` ("..." si aún NULL) y `PC:` + `wifiIp` del perfil activo. No toca `f_change_display`: al vencer el timer la pantalla que estaba vuelve sola. Compilado con GCC de CubeIDE sin errores ni warnings. | Usuario: 'cuando se conecte correctamente al WiFi, que el display muestre unos segundos el SSID y la IP, sin importar en qué pantalla esté — que se superponga y después vuelva' |
| 2026-07-10 | `C:\Microcontroladores\BalancinQT
obotviewer3d.h`/`.cpp`, `mainwindow.cpp` (solo Qt) | **Obstáculo 3D frente al modelo (por ADC 5/6/8 del push de odometría) + UDP abierto por defecto al iniciar Qt.** Pared roja semitransparente frente al modelo 3D cuando `min(adc5,adc6,adc8) < 3200` (los ADC ya viajaban en `WifiOdomData_t` desde 2026-07-08 — no hizo falta tocar el firmware), a distancia del mapeo crudo ADC→m, en la dirección del rumbo, visible SOLO con roll en [-90°, +30°], más opaca cuanto más cerca. Además, al iniciar la app el UDP se abre solo (mismo camino que el botón 'Abrir UDP', puerto default 30010). Detalle completo en el CLAUDE.md de Qt. Compilado y linkeado completo (Qt 6.5.2/MinGW) sin errores. Firmware sin cambios. | Usuario: '¿los valores del ADC los estoy pasando? para graficar en Qt algún objeto enfrente cuando haya algo cerca, siempre que esté entre -90° y +30°' + 'siempre que inicio el Qt quiero que se abra el UDP por defecto' |
obotviewer3d.h`/`robotviewer3d.cpp` (solo Qt) | **Vista 3D: el modelo ya no atraviesa el piso — se apoya siempre sobre Y=0 en cualquier pose.** Antes la base tenía altura fija (`setTranslation(0,25,0)`) y el modelo rotaba alrededor de su centro: con roll ±90° o volcado, media carrocería quedaba bajo el piso. Ahora `applyModelTransform()` recalcula la altura en cada pose: guarda el bounding box local del mesh (`m_modelMin`/`m_modelMax`, capturados junto con `m_modelCenter` en el callback del `QBoundingVolume`), rota las 8 esquinas del bbox por la pose completa (yaw∘pitch del robot + rotación estática -90°X de la base, con la escala 12 aplicada), toma la Y mínima y traslada la base a `(0, -minY, 0)` — el punto más bajo queda exactamente apoyado en el piso. Cota conservadora (bbox ≥ mesh): en poses intermedias puede flotar apenas, nunca hundirse. La altura fija 25 queda solo como valor inicial hasta que carga el mesh. **Corrección mismo día (bis)**: la composición base·hijo derivada a mano con quaterniones dejaba pasar el piso con ángulos NEGATIVOS (usuario: 'a -90° se va sobrepasando el suelo mal'; con positivos no) — reescrita con las matrices reales de Qt3D (`m_baseTransform->matrix() * m_robotTransform->matrix()` + `M.map(corner)`, corrección delta sobre la traslación actual, exacta por linealidad) + margen de 0.6 unidades para no hacer z-fighting con la grilla. Debug Y release recompilados (antes solo debug — ojo con cuál exe se abre). Compilado con qmake/MinGW (Qt 6.5.2) sin errores ni warnings (`debug/robotviewer3d.o` + moc). Firmware sin cambios. Fila espejo agregada también en el CLAUDE.md de Qt. | Usuario: "cuando el ángulo da ±90° o más, el modelo 3D sobrepasa la línea del piso, físicamente incorrecto y feo — que siempre permanezca por encima, como que se apoye en el piso" |
| 2026-07-10 | `C:\Microcontroladores\BalancinQT
| 2026-07-10 | Core/Src/main.c | **Fix bamboleo, parte 2 (la parte 1 sola mejoró muy poco): deadband de motor adaptativo + freno traslacional por velocidad lenta.** (1) **Deadband cinético/estático**: la compensación fija de +8 PWM está calibrada para vencer la fricción ESTÁTICA (rueda parada), pero durante el vaivén las ruedas ya giran (fricción cinética, menor) — cada cruce del comando por la zona neutra (±2) era una patada de 0→±11 PWM, un relé que sobre una planta inestable sostiene el ciclo límite por sí solo. Ahora: `MOTOR_DEADBAND_KINETIC=4` si la rueda tickeó hace <`WHEEL_MOVING_WINDOW_MS=80ms` (timestamps `wheel_r/l_last_tick_ms` grabados en el bloque de encoders), 8 completo solo con la rueda realmente parada. (2) **Freno anti-deriva por velocidad lenta**: `ComputeBrakeSetpointTarget` usaba `velocity_est_f` (LPF β=0.35, rápido) — meciéndose, la velocidad de ruedas supera el deadband de 0.35 alternando de signo y el freno inclinaba el setpoint ±0.4° con retardo → BOMBEABA la oscilación. Nueva `velocity_est_slow_f` (β=`VEL_SLOW_BETA=0.02`, tau ~0.5s): el vaivén a ~1Hz se atenúa ~3.3× y promedia bajo el deadband (freno quieto), la deriva real sostenida pasa entera con ~0.5-1s de retardo. Reseteada en los 5 lugares donde se resetea `velocity_est_f`. El resto del firmware sigue usando `velocity_est_f` sin cambios. Compilado con GCC de CubeIDE sin errores ni warnings. **Validado por el usuario en el robot el mismo día: "me encantó como quedó"**. Si el robot patina al arrancar desde parado, subir `MOTOR_DEADBAND_KINETIC` de a 1; si el freno post-empujón quedó lento, subir `VEL_SLOW_BETA` de a 0.01. | Usuario: tras la parte 1 (hold achicado) "sigue bamboleándose montón / disminuyó un poquito pero muy poco" |
| 2026-07-10 | Core/Src/main.c | **Fix bamboleo en equilibrio: el "punto dulce" (balance hold) era una zona muerta que garantizaba un ciclo límite.** Diagnóstico: con `|error|≤0.70°` y `|gyro|≤4°/s` el hold apagaba P, I y D por completo, y no salía hasta 0.90°/10°/s — pero un péndulo invertido siempre se cae en lazo abierto, así que el robot derivaba casi 1° entero con motores muertos, el PID lo atajaba ya con impulso, cruzaba la vertical, re-entraba al hold del otro lado y se volvía a caer → bamboleo permanente de ±1-2°. Agravantes: `SOFT_ZONE_MIN_SCALE=0.15` dejaba el PID al 15% cerca del equilibrio (comando < `MOTOR_CMD_NEUTRAL=2` → cero par hasta error grande) y el D apagado en hold era justo el término que frenaría la caída incipiente. Fixes: (1) hold achicado: enter 0.70→**0.25°** / 4→**2°/s**, exit 0.90→**0.45°** / 10→**6°/s**; (2) **el D queda vivo dentro del hold** (solo se silencian P/I): parado de verdad D≈0 igual, pero apenas arranca una caída el D la frena ANTES de cruzar el umbral de salida; (3) `SOFT_ZONE_MIN_SCALE` 0.15→**0.35**. El anti-chatter en parado lo sigue dando `MOTOR_CMD_NEUTRAL`. Afecta a todos los modos (mismo PID). Compilado con GCC de CubeIDE sin errores ni warnings. **Sola no alcanzó (usuario: "disminuyó un poquito pero muy poco") — resuelto junto con la parte 2, ver fila de arriba**; si tiembla en parado, bajar `SOFT_ZONE_MIN_SCALE` de a 0.05 o subir `MOTOR_CMD_NEUTRAL` de a 1. Sugerencia extra: probar subir KD desde Qt (0.12 es bajo vs KP=4; probar 0.20-0.30). | Usuario: "está bastante inestable el balance común, se bambolea de un lado al otro sin quedarse quieto, creo que es muy grande el punto dulce" |
| 2026-07-10 | Core/Src/main.c | **Display de balance (PANTALLA 0): reemplazado ER (error) y GZ por KP/KI/KD.** En la columna derecha de `updateDisplay()` (`f_change_display==0`) se sacaron `ER:` (`dynamic_setpoint_f - filtered_roll_deg`) y `GZ:` (gyro Z), y se agregaron `KP:`/`KI:`/`KD:` (`KP_value`/`KI_value`/`KD_value`, mismo formato `FormatSignedFixed(...,3)` + `nbuf+1` que ya usa la pantalla PARAM para las ganancias) en y=12/21/30; `VE:` (velocidad por encoders) bajó a y=39; `CMD:`/`M±xx±xx` (motores) se mantiene sin cambios en y=57. Permite ver las ganancias de balance en tiempo real (útiles al tunearlas desde Qt) sin tener que cambiar a la pantalla PARAM. `gz` sigue usándose igual que antes en el resto del firmware (yaw-assist, odometría) — solo se sacó de este display. Compilado con GCC de CubeIDE sin errores. | Usuario: "quiero que en el display de balance se muestre kp kd y ki, elimina el error y gz" |
| 2026-07-10 | Core/Src/ESP01.c | **Segunda IP hardcodeada eliminada de `ESP01.c` (unificación WiFi, parte 2).** `ESP01.c` tenía su propio `#define SERVER_IP "192.168.1.23"` (línea 18) independiente de `wifiProfiles[]`/`WIFI_PROFILE_ACTIVE` de `main.c` — usado como fallback en `ESP01CIPSTARTRESPONSE` cuando un intento TCP fallaba y se reintentaba por UDP (`else if (tryingTCP)`, línea ~1038). Si algún día se activa ese camino (hoy es código muerto: `tryingTCP` nunca se pone en 1 porque `ESP01_StartTCP` no se llama desde ningún lado), habría reconectado silenciosamente a esta IP vieja en vez de al perfil elegido. Fix: se borran `SERVER_IP`/`SERVER_PORT`/`LOCAL_PORT` y el fallback ahora reusa `esp01RemoteIP`/`esp01RemotePORT`/`esp01LocalPORT` (ya seteados por la llamada real hecha desde `main.c`, la que sí sale de `wifiProfiles[]`) — `ESP01_StartUDP(esp01RemoteIP, atoi(esp01RemotePORT), atoi(esp01LocalPORT))`. Ahora `WIFI_PROFILE_ACTIVE` en `main.c` es el ÚNICO lugar del firmware con una IP/red hardcodeada. Compilado con GCC de CubeIDE sin errores. | Usuario preguntó si `SERVER_IP` de `ESP01.c` también había que cambiarlo al cambiar de red; pidió unificarlo con lo de `main.c` |
| 2026-07-10 | Core/Src/main.c, CLAUDE.md | **Unificación de perfiles WiFi: un solo número para cambiar de red.** Antes había 3 bloques comentados con SSID/password/IP (uno por red) y había que descomentar el correcto y comentar el resto — fácil de dejar mal. Ahora `wifiProfiles[]` es una tabla (struct `WifiProfile_t {ssid, password, ip, label}`) con una fila por red, y `#define WIFI_PROFILE_ACTIVE <n>` (~línea 423) selecciona cuál está activa; `wifiSSID`/`wifiPassword`/`wifiIp` (usados por `ESP01_SetWIFI` y `ESP01_StartUDP`) se asignan desde esa tabla al arranque de `main()` (antes de `CDC_Attach_Rx`), sin cambiar su tipo ni su uso en el resto del código. Perfil activo hoy: `2` (Delco Mendelevich). De paso se corrigió la IP de Delco documentada en CLAUDE.md (`192.168.1.55`→`192.168.1.23`, desactualizada respecto al valor real en el código). Compilado con GCC de CubeIDE sin errores. Para agregar una red nueva: sumar una fila a `wifiProfiles[]` y otra a la tabla de este CLAUDE.md. | Usuario: "unificar la IP que usa el wifi, para que cada vez que cambio de red no tenga que cambiarlo de más de un lugar" |
| 2026-07-09 | Core/Src/main.c | **Precisión de odometría: gating de pivot + bias de gyro aprendido en línea + integración de 2º orden** — fix "cuando lo roto sobre el mismo eje parece que se desplaza". Diagnóstico: 1 count de encoder = ~6.3mm (ENC_CPR=28, muy grueso); girando en el lugar los ticks de cada rueda caen en ciclos de 10ms DISTINTOS con θ cambiando rápido — pasos de ±1 count integrados a rumbos diferentes NO se cancelan → random walk de la posición al rotar. Fixes: (1) **Gating de pivot**: si `|gz| > ODOM_PIVOT_GZ_DPS=40` y el avance neto del ciclo `|dR+dL| ≤ ODOM_PIVOT_MAX_COUNTS=1`, se descarta la traslación de ese ciclo (es ruido de cuantización/timing, no movimiento real). (2) **Bias residual de gz aprendido en línea** (`odom_gz_bias_f`, SOLO para odometría — no toca el PID ni el yaw-assist): con el robot quieto (0 ticks de ambos encoders + gz chico durante 500ms) EMA lenta (`ODOM_GZ_BIAS_ALPHA=0.005`, tau ~2s), clamp ±200 LSB — compensa la deriva térmica del bias hardcodeado, que giraba θ lentamente con el robot parado. (3) **Integración RK2**: la traslación usa el rumbo de MITAD de paso (θ+Δθ/2) — menos sesgo sistemático en arcos. Compilado con GCC de CubeIDE sin errores. Calibraciones pendientes sugeridas (ver conversación): test de 360° para la escala de gz (/100) y tramo recto medido vs odómetro de Qt para `ENC_VEL_SCALE`. | Usuario: al rotar sobre el mismo eje la posición parece desplazarse; pidió mejorar la precisión de la odometría |
| 2026-07-09 | `C:\Microcontroladores\BalancinQT\mainwindow.h`/`mainwindow.cpp`, `odomchartview.h`/`odomchartview.cpp` (solo Qt) | **Mapa de odometría renovado: estética oscura + herramientas CAD**. Estética: fondo oscuro a juego con la Vista 3D (chart #0a0e08, plot #0e140b), grilla sutil verde oscura (sin números — la escala la da la barra nueva), leyenda con labels claros, título reemplazado por tooltip de navegación, cruz del origen (0,0) fija (series `odomOriginH/V`, fuera de la leyenda). Funcionalidades: (1) **Barra de escala** abajo-izquierda (QGraphicsItems, largo "redondo" 5cm..20m que ocupe ≤150px, se recalcula en cada zoom/paneo/autoescala vía `updateOdomScaleBar` desde `repositionOdomAnnotations`). (2) **Botón "Seguir robot"** (toggle): la vista se recentra sola en la posición actual conservando el span del zoom del usuario (reemplaza a la autoescala grow-only mientras está activo). (3) **Herramienta "Medir" estilo CAD** (toggle): el click deja de panear (`OdomChartView::setMeasureMode`, cursor en cruz, señales `hoverAt`/`measureClick`), primer click fija P1, la línea amarilla punteada sigue al cursor con la distancia en vivo, segundo click cierra la medición (texto flotante en el punto medio); un tercer click arranca una nueva. Mapeo viewport→metros en `odomViewPosToValue` (`mapToScene`→`mapFromScene`→`mapToValue`). (4) **Coordenadas del cursor en metros** en vivo (label monoespaciado en la botonera). (5) **Odómetro y velocidad**: `updateOdomChart` ahora recibe `t_ms` del paquete; acumula distancia recorrida (piso de 3mm/muestra contra el ruido de cuantización) y estima velocidad entre paquetes — ambos en el label de info. (6) **Botón "Guardar PNG"** (`grab()` + `QFileDialog`). "Borrar mapa" resetea también odómetro/velocidad/medición. Firmware sin cambios. | Usuario pidió mejorar la odometría y el mapa lo mejor posible, dejarlo muy estético y con funcionalidades que sirvan mucho |
| 2026-07-09 | `C:\Microcontroladores\BalancinQT\robotviewer3d.h`/`robotviewer3d.cpp`, `mainwindow.cpp` (solo Qt) | **Vista 3D mejorada estilo CAD: transiciones animadas, rumbo real, pose suavizada, tinte por inclinación, HUD, ejes y órbita automática**. (1) `setView` ahora anima la cámara (450ms InOutCubic, `goToView`/`m_camAnim`) en vez de saltar — estilo Fusion 360. (2) **El modelo gira con el rumbo real del robot**: nuevo `setPose(pitch, yaw)` — el handler de `0xDC` en `mainwindow.cpp` pasa `theta_deg`; el yaw rota alrededor del Z local del mesh (= vertical del mundo tras la base de -90° en X), orden yaw∘pitch; `setPitch` (paths viejos: log 10Hz, GET_ANGLE) conserva el rumbo. **Si el modelo gira al revés que el robot, negar theta en el handler** (misma incógnita `ODOM_THETA_SIGN`). (3) **Pose interpolada** (`m_poseAnim`, 240ms OutQuad, yaw por camino corto en ±180°): el push de 2 Hz ya no se ve a saltos. (4) **Tinte por inclinación**: material plateado en equilibrio → rojo pleno a ≥20° (lerp de diffuse/ambient) — feedback inmediato de qué tan al límite está sin mirar números. (5) **HUD** en la barra: Roll y Rumbo numéricos (label monoespaciado, se actualiza con la pose mostrada). (6) **Tríada de ejes CAD** en el origen (X rojo, Y verde, Z azul, cuboides finos). (7) **Botón "Órbita auto"** (toggle): turntable de 0.35°/30ms alrededor del centro de vista. Botones con `Qt::NoFocus`; el `QOrbitCameraController` sigue intacto para navegar con el mouse desde cualquier vista. Firmware sin cambios. | Usuario pidió agregar funcionalidades vistosas y útiles al visor 3D, navegación como Fusion 360, interacciones, y mejorar todo lo posible |
| 2026-07-08 | `C:\Microcontroladores\BalancinQT\robotviewer3d.h`/`robotviewer3d.cpp` (solo Qt) | **Vistas predefinidas estilo CAD en la Vista 3D** (pedido: "como en Fusion 360"). Botonera arriba del visor: ISO (45° azimut / ~38° elevación), Frente, Atrás, Izq., Der. y Arriba (planta, con up-vector -Z para mirar derecho hacia abajo). Nuevo `enum class ViewPreset` + `setView(ViewPreset)` públicos: posicionan la cámara a distancia fija (450) del centro de interés (0,80,0) en la dirección de cada vista; el `QOrbitCameraController` sigue funcionando normalmente desde la vista elegida (los botones con `Qt::NoFocus` para no robarle el teclado). Firmware sin cambios. | Usuario pidió vistas seleccionables por defecto (45°, perpendicular) como en Fusion 360 o cualquier CAD para el visor 3D |
| 2026-07-08 | `C:\Microcontroladores\BalancinQT\robotviewer3d.h`/`robotviewer3d.cpp` (solo Qt) | **Fix pivote de la Vista 3D: el modelo ahora rota alrededor de su centro geométrico**. Causa: la traslación de centrado (`-center`) y la rotación de pitch vivían en el mismo `QTransform` de Qt3D, que aplica `T·R·S` — el mesh rotaba alrededor de su ORIGEN (`p' = R·p - c`) y el centro orbitaba ("se inclina mal"). Fix: `m_modelCenter` guardado como pivote y en `setPitch` la traslación de centrado se rota junto con el ángulo (`-R·c`, o sea `p' = R·(p - c)`) — rotación exacta sobre el centro. `m_pitchDeg` cacheado para re-aplicar la pose cuando el bounding volume del mesh termina de cargar. Firmware sin cambios. | Usuario: "el modelo 3D debería rotar en el centro de este, ahora se inclina mal" |
| 2026-07-08 | Core/Inc/UNER.h, Core/Src/main.c, `C:\Microcontroladores\BalancinQT\mainwindow.h`/`mainwindow.cpp` (Qt) | **ADC de objeto (5/6/7/8) + roll de balanceo agregados al push de odometría; barrera en el mapa y Vista 3D siempre viva en Qt**. Firmware: `WifiOdomData_t` extendido con `adc5..adc8` (uint16) y `roll_deg` (float, `filtered_roll_deg`), al FINAL del struct; `UNER_SendWifiOdomData` no necesitó cambios (usa `sizeof`). Con `roll_deg` la Vista 3D de Qt (`robotViewer3D->setPitch`) y el label de inclinación se actualizan a 2 Hz con solo tener WiFi, sin activar `ACTIVATE_WIFI_LOG` (el log de 10 Hz sigue alimentándolos también; si ambos llegan se pisan con el mismo dato). **Lado Qt (hecho en esta misma sesión)**: mirror del struct actualizado en `mainwindow.h`; en la pestaña "Odometría", dos series nuevas: `odomBarrierSeries` (segmento rojo grueso "Objeto adelante", perpendicular al rumbo, dibujado frente a la posición actual mientras `min(adc5,adc6,adc8) < 3200`) y `odomObstaclePts` (rastro rojo semitransparente "Obstáculo visto": puntito en la posición estimada del obstáculo por muestra — frontal por ADC5/6/8 y lateral izquierdo por ADC7 < 3600 — al bordear va quedando el contorno; cap 3000 puntos). Distancia por mapeo lineal crudo ADC→m (0.06–0.36 m), NO calibrada — es para visualizar que ve algo y de qué lado, no para medir. **Ojo**: el lado "izquierda" del punto lateral asume el signo actual de θ — si al probar aparece del lado equivocado, invertir el signo de `lx/ly` en `updateOdomChart` (misma incógnita que `ODOM_THETA_SIGN`, aún sin validar). "Borrar mapa" limpia las series nuevas. Firmware compilado con GCC de CubeIDE sin errores; el proyecto Qt no se compiló acá (rebuild pendiente al abrirlo). | Usuario pidió enviar todo el tiempo el estado de ADC 5-8 junto con la odometría, para graficar en Qt una barrera o cuerpo adelante del auto simbolizando que está viendo algo |
| 2026-07-08 | Core/Src/ESP01.c | **Fix inestabilidad WiFi: "conecta perfecto, envía unos segundos, se corta, se reconecta en ciclo, y en algún momento muere del todo"** — cadena de 4 bugs en el driver, todos en el camino de envío: (1) **+IPD pisaba el envío en curso**: al terminar de recibir un paquete de Qt, el parser limpiaba `WAITINGSYMBOL`/`TXCIPSEND`/`SENDINGDATA` — si llegaba en medio de un CIPSEND nuestro, lo abortaba a mitad de camino y el siguiente CIPSEND salía encimado → ERROR → reconexión. Ya no toca los flags de envío. (2) **ERROR mataba el socket**: con `SENDINGDATA` activo, un simple ERROR de CIPSEND (ESP ocupado) ponía `UDPTCPCONNECTED=0` → el chequeo periódico de 5s de `ESP01DOConnection` reabría el socket → el ciclo visible de reconexión. Ahora ERROR aborta solo el envío (flags + buffer TX); los cierres reales siguen llegando por CLOSED/DISCONNECTED. (3) **`esp01TimeoutSending` existía pero NUNCA se armaba**: si un SEND OK se perdía, `SENDINGDATA` quedaba en 1 para siempre → `ESP01_Send` devolvía BUSY eternamente → "se corta totalmente" (solo un paquete entrante lo destrababa, por el bug 1). Ahora se arma en 1s en cada `ESP01_Send`, se cancela en SEND OK/ERROR, y el force-clear limpia TAMBIÉN `TXCIPSEND`/`WAITINGSYMBOL` y descarta el buffer TX (antes dejaba basura que se pegaba al próximo CIPSEND). (4) **Timeout del prompt '>' de 50ms reiniciaba TODA la máquina AT** (`esp01ATSate=ESP01ATAT` → AT/CWMODE/CWJAP/CIPSTART completo con WiFi sano) por un prompt perdido — el '>' solo se detecta con el parser en estado 0, así que se perdía fácil si llegaba a mitad de otro token. Ahora: timeout 50→300ms, y al vencer aborta solo ese envío sin tocar la máquina de estados (si el socket está caído de verdad, CLOSED/DISCONNECTED o DOConnection lo reconectan). Compilado con GCC de CubeIDE sin errores ni warnings. Pendiente de validar en el robot con Qt corriendo. | Usuario reportó WiFi inestable: conecta y envía varios paquetes, a los ~5 segundos deja de enviar y se reconecta, cicla así todo el tiempo, y en algún momento se corta totalmente la conexión |
| 2026-07-08 | Core/Src/main.c | **`OBJ_REV_HOLD_ANGLE` 4.0→2.75°** (corrección de distancia del STOP post-reversa). Historial del valor en el día: 2.0 (no movía) → 2.5 (poco) → 4.0 (muy brusca) → **2.75**. Compilado con GCC de CubeIDE sin errores. | Usuario: la corrección de 4° para mantenerse en el setpoint de ADC quedó muy brusca |
| 2026-07-08 | Core/Src/main.c | **`OBJ_WALL_THRESHOLD` 3750→3600** (umbral "pared visible/perdida" de ADC7 en el wall-following). Con 3750 el robot se alejaba demasiado del objeto antes de declararlo perdido y girar a la izquierda a buscarlo; con 3600 reacciona antes y bordea más pegado. Arrastra automáticamente: `wall_visible` en PARED (transición a LIBRE), la salida de GIRAP (re-ver pared → volver a PARED) y el tick superior de la barra A7 en pantalla 6. Compilado con GCC de CubeIDE sin errores. | Usuario: "quiero que gire a la izquierda cuando hay valores superiores a 3600 mejor, porque se aleja mucho sino" |
| 2026-07-08 | Core/Src/main.c | **`OBJ_REV_CLEAR_ADC` 3600→3500** (setpoint de distancia de la reversa inicial por ADC6/ADC8). Arrastra automáticamente todo lo que referencia esa constante: corte de la reversa, hold de distancia del STOP (banda pasa a ser 3500..3800), condición de estabilidad de 2s previa al giro, y el tick de la barra A6 en pantalla 6. Compilado con GCC de CubeIDE sin errores. | Usuario pidió bajar el setpoint de la reversa a 3500 (queda un poco más cerca del objeto) |
| 2026-07-08 | Core/Src/main.c | **Corrección del STOP a 4° + el giro de esquive espera 2s continuos de distancia estable en 3600**. (1) `OBJ_REV_HOLD_ANGLE` 2.5→**4.0°** (a pedido: 2.5 corregía muy poco; el clamp global de LINE_FOLLOWING es 5.0, entra sin excepción nueva). (2) La transición `OBJ_FRENO_REVERSA`→`OBJ_GIRO_ESQUIVE` ahora exige, además del wait quieto de 3s, que `min(A6,A8)` haya estado **dentro de la banda 3600..3900 durante `OBJ_REV_STABLE_MS=2000ms` CONTINUOS** (nueva `obj_rev_band_enter_ms`: arranca al entrar en banda, se resetea a 0 al salir — mientras el hold de distancia esté corrigiendo, el giro espera). Colchón `OBJ_REV_STOP_TIMEOUT_MS=10000` desde la entrada al STOP: si nunca se estabiliza (objeto sacado, sensor tapado), gira igual. `obj_rev_band_enter_ms` reseteada en la transición RETRO→STOP, en la salida STOP→GIRO y en el bloque de recuperación de caída (junto a `obj_brake_start_ms`). Compilado con GCC de CubeIDE sin errores ni warnings. | Usuario: 2.5° "me parece muy poco para corregir, 4 grados ponele mejor", y pidió que esté viendo por 2 segundos mínimo valores cercanos al setpoint de 3600 antes de rotar |
| 2026-07-08 | Core/Src/main.c | **Display pantalla 6: barra de A6 en lugar de A5 + valor de A8, para diagnosticar la reversa que "se aleja demasiado"**. La barra de arriba ahora muestra `adcAvg[5]` (ADC6, el que corta la reversa inicial) con ticks en 3200 (detección) y 3600 (`OBJ_REV_CLEAR_ADC`); en la fila de abajo, `A8:xxxx` (`adcAvg[7]`) reemplaza a GZ. Motivo diagnóstico: el corte de la reversa exige **A6 Y A8 ≥ 3600 a la vez** — si uno de los dos queda bajo (mal apuntado, viendo otra cosa), la reversa sigue hasta el tope de counts, que es exactamente el síntoma reportado; con ambos a la vista se ve al instante cuál no despeja. Además: `OBJ_REV_MAX_COUNTS` 600→**300** (~25 cm — acota el daño mientras se diagnostica; si la reversa corta siempre por el tope, el culpable es A6 o A8) y `OBJ_REV_HOLD_ANGLE` 2.0→**2.5°** (2.0 estaba al borde de la fricción estática — mínimo empírico conocido de LOST_FWD/APPROACH; si quedaba lejos, la corrección de avance del STOP no llegaba a moverlo y se quedaba lejos). Compilado con GCC de CubeIDE sin errores ni warnings. | Usuario pidió la barra de ADC6 en el display en lugar de ADC5, y reportó que el robot ahora se aleja demasiado en la reversa — sospecha que el corte por ADC no está funcionando |
| 2026-07-08 | Core/Src/main.c | **Reversa inicial (`OBJ_RETROCESO`) corta por ADC6/ADC8 ≥ 3600 + hold de distancia en el STOP** (sobre la base revertida a `c002dce`, que el usuario confirmó que "anda mucho mejor"). (1) `RETRO` ya no corta por 120 counts fijos de encoder (~10 cm, distancia final variable según dónde se detectó el objeto): ahora retrocede hasta que **ADC6 Y ADC8** (`adcAvg[5]`/`adcAvg[7]`, los frontales que miran adelante) lean ≥ `OBJ_REV_CLEAR_ADC=3600` durante `OBJ_REV_CLEAR_CNT=4` ciclos (40 ms) — la distancia final al objeto queda siempre igual. Los counts quedan solo como tope de seguridad (`OBJ_REV_MAX_COUNTS=600` ≈ 50 cm, por si los ADC nunca despejan). Nueva `obj_rev_clear_cnt` (reseteada en el init del estado). (2) **Hold de distancia durante `OBJ_FRENO_REVERSA` (STOP, ~3-4.5 s antes del giro)**: si la inercia lo vuelve a acercar (`min(ADC6,ADC8) < 3600`) corrige hacia atrás `OBJ_REV_HOLD_ANGLE=2°`; si se alejó de más (`> 3600+OBJ_REV_HOLD_BAND=3900`) corrige hacia adelante 2°; dentro de la banda 3600-3900 queda quieto con el freno de encoders de siempre. (3) `FRENO_REVERSA` agregado a la exclusión de `balance_hold_active` (las correcciones de ±2° con error chico eran silenciables por el hold — mismo patrón de bug conocido). Tuning: si la corrección del STOP no mueve el robot, subir `OBJ_REV_HOLD_ANGLE` de a 0.5; si vibra entre atrás/adelante, agrandar `OBJ_REV_HOLD_BAND`. Compilado con GCC de CubeIDE sin errores ni warnings. | Usuario (tras confirmar que la base revertida anda mucho mejor): la reversa post-detección no debe cortar por pulsos de encoder sino por ADC6/8 que miran adelante, "para que sea constante siempre y quede a la misma distancia", y "si se aleja de esos 3600 que corrija" |
| 2026-07-08 | Core/Src/main.c | **REVERSIÓN COMPLETA del wall-following al checkpoint `c002dce` ("checkpoint antes de estabilizar esquive")** — a pedido explícito del usuario: con toda la cadena de robustificación (filtro IIR + histéresis + debounce de ADC7, latch de reversa, árbitro de acciones, arco odométrico, autoridad subida, estabilización post-reversa) el esquive quedó PEOR que antes: giros de 180° constantes, no seguía la pared ni 2 segundos, y EST seguía sin verse. `git checkout c002dce -- Core/Src/main.c` (el trabajo descartado quedó preservado en el commit `9cc6cca` y en el historial `1f71728..0e92b8f` — nada se perdió). **Vuelve el esquema simple que andaba "recontra bien"**: umbrales directos sobre `adcAvg[6]` crudo cada ciclo (`REVERSE_THOLD=600`, `TOO_CLOSE_THOLD=2100`, `THRESHOLD=3750`), reversa de 3.0°, pivot potencia 8, `SPEED_TARGET=1.0`, sin latch (la reversa termina apenas ADC7 ≥ 600), sin árbitro, sin arco, transiciones inmediatas. **Solo se re-portaron 2 cosas sobre la base revertida**: (1) el indicador de acción en pantalla 6 ("PARED>REV", `ObjWallActionStr()` recalculada directo de los umbrales crudos — ya no existe `obj_wall_action`); (2) la exclusión de `balance_hold_active` para los 3 estados de pared (bug real diagnosticado: el hold silenciaba el PID justo cuando la reversa de 3° arranca desde parado). **NO existen más en el código activo**: `OBJ_WALL_REVERSE_CLEAR_ADC` (salida por 3600), `OBJ_WALL_REVERSE_TIMEOUT_MS`, `OBJ_WALL_ACT_*`/`ObjWallDecideAction`, `OBJ_WALL_ACTION_MIN_MS`/`STATE_MIN_MS`, `ObjWallComputeArcSteer`, la fase EST, el tope de pivot de 30°, ni los valores de autoridad subidos (6°/20/2.5°) — las filas de abajo que los describen son historia superseded. Compilado con GCC de CubeIDE sin errores ni warnings. | Usuario: "los giros siguen recontra inestables, hacen 180 todo el tiempo, no sigue la pared ni dos segundos, ¿cómo hacíamos antes? que seguía recontra bien, antes del cambio de la histéresis en los ADC" |
| 2026-07-08 | Core/Src/main.c | **Fix "EST nunca se muestra" + tope de rotación del pivot por cercanía (giros de 180° del árbitro)**. (1) La estabilización nunca llegaba a verse ni a actuar: el armado del latch de reversa usaba `obj_wall_reverse_f` (flag LATERAL, ADC7<750 con histéresis), que sigue en 1 cuando la reversa suelta — los que despejan son los frontales ADC6/8, el lateral no cambió — así que el latch se re-armaba al ciclo siguiente de soltarse y cancelaba la estabilización a los 10ms. Fix: armado normal bloqueado durante la estabilización (`!obj_wall_settle_active`); re-armado durante el hold SOLO si los frontales vuelven a acercarse de verdad (`OBJ_WALL_SETTLE_REARM_ADC=3400`, margen bajo el CLEAR de 3600); y la estabilización solo se entra en la salida NORMAL por frontales despejados (`released_by_clear`), no tras timeout (ahí los frontales siguen cerca y el REARM la cancelaría al instante). (2) **El pivot por cercanía (PIV, potencia 20 + compromiso de 450ms encadenado) no tenía tope de rotación**: con `too_close` sostenido rotaba 180° y perdía la pared. Nuevo tope `OBJ_WALL_PIVOT_MAX_DEG=30°` medido por rumbo de odometría (`\|Δθ\|` desde `obj_wall_pivot_theta0` capturado al entrar al pivot — magnitud, no depende del signo sin validar de `ODOM_THETA_SIGN`): al superarlo, `obj_wall_pivot_capped` fuerza AVANZA (con salida inmediata, exenta del compromiso de 450ms) y el pivot queda bloqueado hasta que `too_close` se suelte al menos una vez. Ojo: si los giros de 180° que ve el usuario fueran en GIRAP (`GIRO_PARED`, que pivotea hasta re-ver la pared y no tiene tope), eso es otro bloque — distinguible por el display (`GIRAP` vs `PARED>PIV`). Compilado con GCC de CubeIDE sin errores ni warnings. | Usuario reportó que EST no aparece nunca en el display (no sabía si la fase corría siquiera — no corría: moría a los 10ms) y que el árbitro hace giros de 180° que pierden la pared |
| 2026-07-08 | Core/Src/main.c | **Fase de estabilización de 3s a la salida de la reversa por pared (`OBJ_WALL_ACT_ESTABILIZA`)** — fix "la salida de reversa es inconsistente: a veces se detiene en 3600 pero después se va un poco adelante (choca) o atrás (pierde la pared)". Al soltarse el latch (ADC6/ADC8 ≥ 3600 o timeout), en vez de volver a avanzar de una, se captura la posición de encoders del punto donde despejó y se sostiene durante `OBJ_WALL_REVERSE_SETTLE_MS=3000ms` con un **hold de posición P puro por encoders**: nueva `ObjWallSettleSetpoint()` (error en metros vía `OBJ_WALL_SETTLE_M_PER_CNT=ENC_VEL_SCALE/ENC_CPR`, deltas positivos=avance como en la odometría; `OBJ_WALL_SETTLE_POS_KP=40°/m`, tope `OBJ_WALL_SETTLE_ANGLE_MAX=2.5°`, banda muerta `OBJ_WALL_SETTLE_POS_DB_M=0.010m` ≈1.5 counts para no vibrar por cuantización). Nueva acción del árbitro `OBJ_WALL_ACT_ESTABILIZA=3` (display "EST"), prioridad REVERSA > ESTABILIZA > PIVOT > AVANZA, exenta del compromiso de 450ms (sigue el timing fijo de su fase, igual que REVERSA); si ADC7 vuelve a < 750 durante el hold, la reversa re-arma y cancela la estabilización. En los 3 estados de pared: rama de setpoint propia (hold de posición, integral de velocidad reseteada), en la máquina de estados cae en la misma rama que la reversa (misma corrección de rumbo recto `REV_STRAIGHT_*`, sin pivots ni transiciones por pared vista/perdida durante los 3s), y comparte la rampa rápida `sp_step_max=0.6°/ciclo` (para frenar la inercia de reversa al pasar de -6° al hold sin tardar medio segundo). En `PARED_LIBRE` además se invalida `obj_wall_clear_initialized` durante reversa/estabilización — `clear_counts` acumula \|deltas\|, la reversa lo inflaba y al salir disparaba el giro a GIRO_PARED de inmediato. Tuning: si oscila en el lugar bajar `SETTLE_POS_KP`; si corrige poco subirlo; los 3000ms son ajustables directo. Compilado con GCC de CubeIDE sin errores ni warnings. | Usuario reportó salida de reversa inconsistente y pidió: detenerse al despejar 3600 y corregir la posición durante los 3 segundos posteriores, para salir estable sin acercarse (choque) ni alejarse (pérdida de la pared) |
| 2026-07-07 | Core/Src/main.c | **Indicador en pantalla 6 (OBJETO) de la acción del árbitro de wall-following**. El sub-estado del esquive ya se mostraba (`LineStateStr`: ESPER/RETRO/ESQUIV/PAUSA/APRCH/PARED/LIBRE/GIRAP + tiempo transcurrido), pero dentro de los 3 estados de pared no se veía qué acción estaba ejecutando el árbitro. Nueva `ObjWallActionStr()` (AVZ/PIV/REV según `obj_wall_action`); en PARED/LIBRE/GIRAP el título de la pantalla 6 pasa a "PARED>REV" (formato `estado>accion`), en el resto de los estados queda igual que antes. Compilado con GCC de CubeIDE sin errores. | Usuario pidió un indicador en el display del sub-estado del esquivador de objetos; el sub-estado ya estaba — lo que faltaba era la acción del árbitro dentro de los estados de pared |
| 2026-07-07 | Core/Src/main.c | **Restaurada la salida de la reversa por pared por ADC6/ADC8, ahora con umbral 3600** (pedido de sesión anterior que nunca se aplicó: el usuario había pedido subir 3500→3600, pero para entonces el commit `95b43db` ya había reemplazado toda esa condición por salida por encoder — el umbral no existía más). `ObjWallUpdateReverseLatch()` vuelve al esquema del commit `61a81d1`: el latch se suelta cuando `adcAvg[5]` y `adcAvg[7]` (ADC6/ADC8 frontales) leen ≥ `OBJ_WALL_REVERSE_CLEAR_ADC=3600` durante `OBJ_WALL_REVERSE_CLEAR_CNT=4` ciclos consecutivos (40 ms). Eliminados `OBJ_WALL_REVERSE_COUNTS`/`obj_wall_reverse_r0` (salida por 100 counts de encoder derecho). **Se conservan** las mejoras posteriores al commit original: timeout de seguridad `OBJ_WALL_REVERSE_TIMEOUT_MS=4000` (ahora significa "si ADC6/ADC8 nunca despejan en 4s, soltar"), armado del latch restringido a los 3 estados de pared, y liberación al salir de ellos. Compilado con GCC de CubeIDE sin errores. | Usuario preguntó si el cambio 3500→3600 pedido en una sesión anterior se había hecho; al ver que la condición ya no existía, pidió volver a ella con el nuevo umbral |
| 2026-07-07 | Core/Src/main.c | **Fix "en modo pared no le da el ángulo para ir atrás ni el PWM para girar" — autoridad insuficiente en todas las acciones del wall-following** (la reversa inicial OBJ_RETROCESO andaba bien porque tiene 8.5° + excepción de clamp + rampa propia; el modo pared no tenía nada de eso). 4 cambios con el mismo criterio ya validado en el resto del código: (1) `OBJ_WALL_REVERSE_ANGLE` 3.0→**6.0°** — la soft-zone del PID (error<1.5° → autoridad al 15%) hace que reversas de 2-3° no venzan la fricción estática desde parado, exactamente el mismo motivo por el que OBJ_RETROCESO terminó en 8.5°. (2) **Excepción nueva en `sp_limit` (clamp global de setpoint): 7.0° para los 3 estados de pared** — sin esto el límite general de 5.0 recortaba los 6° en silencio (mismo patrón que la excepción de OBJ_RETROCESO=9.0). (3) **Rampa `sp_step_max=0.6°/ciclo` para la reversa por latch en estados de pared** (antes usaba la general de 0.15 → llegar a -6° tardaba 400ms sin empujón inicial; mismo fix que OBJ_RETROCESO 2026-07-03). (4) `OBJ_WALL_PIVOT_POWER` 8→**20** — historial: 5 y 8 insuficientes (2026-05-27), los pivots de LOST_ROTATE necesitaron 14→20→24 (2026-07-05); si sigue débil probar 24. (5) `OBJ_WALL_APPROACH_ANGLE_MAX` 1.5→**2.5°** (1.5 casi no movía, mismo caso que LOST_FWD_ANGLE_MAX 1.0→2.5 del 2026-07-04). Compilado con GCC de CubeIDE sin errores. | Usuario reportó tras probar el árbitro: la reversa inicial anda bien, pero en modo pared no le da el ángulo para retroceder ni el PWM para girar — todas las magnitudes del wall-following estaban por debajo de los mínimos físicos ya descubiertos empíricamente en otros estados |
| 2026-07-07 | Core/Src/main.c | **Árbitro de acción con compromiso mínimo para el wall-following — fix "cambia de decisión tantas veces por segundo que no hace nada"**. Los 3 estados de pared re-evaluaban reversa/pivot/avance/transición **cada ciclo de 10 ms**: con el robot al borde de los umbrales (aun con el filtro+histéresis+debounce de flags), la acción cambiaba varias veces por segundo y ninguna llegaba a producir efecto físico. Nueva función `ObjWallDecideAction()` (corre 1 vez por ciclo junto a `ObjWallUpdateAdc`/`ObjWallUpdateReverseLatch`): elige UNA acción vigente (`obj_wall_action` = AVANZA / PIVOT_CERCA / REVERSA) y **se compromete con ella `OBJ_WALL_ACTION_MIN_MS=450ms`** antes de permitir otra. Excepción: la REVERSA entra y sale al ritmo del latch (que ya tiene su propio compromiso: 100 counts o timeout de 4s) — demorar la entrada arriesga chocar, demorar la salida alarga la reversa. Los 3 estados (setpoint + máquina de estados) ahora consumen `obj_wall_action` en vez de leer los flags crudos. Además, **mínimo de permanencia en estado `OBJ_WALL_STATE_MIN_MS=450ms`**: BORDEAR→LIBRE por "perdí la pared" exige ≥450ms desde la entrada a BORDEAR (`obj_wall_fwd_start_ms`), y GIRO_PARED→BORDEAR por "pared vista" exige ≥450ms desde la entrada al giro (nueva `obj_wall_turn_start_ms`, seteada en LIBRE→GIRO_PARED) — evita rebotar entre estados varias veces por segundo. LIBRE→GIRO ya tenía compromiso natural (100 counts de avance). Tuning: si sigue indeciso subir los 450ms de a 100; si reacciona lento, bajarlos. Compilado con GCC de CubeIDE sin errores ni warnings. | Usuario reportó que tras los fixes del deadlock el robot ya se mueve pero "varía demasiadas veces por segundo y no se decide nunca" — chattering de decisiones sin compromiso temporal |
| 2026-07-07 | Core/Src/main.c | **Fix "el esquive se queda quieto" tras la robustificación del wall-following hecha por el usuario** (filtro IIR de ADC7 + histéresis + debounce + latch de reversa por encoder + arco odométrico, commits `1f71728`..`95b43db`). Diagnóstico: deadlock de tres piezas cooperando. (1) **`balance_hold_active` no excluía los 3 estados de pared** (`OBJ_BORDEAR_PARED`/`OBJ_PARED_LIBRE`/`OBJ_GIRO_PARED`) — mismo patrón de bug ya arreglado en RETROCESO/BUSCAR_PARED/MANUAL: la rama de reversa del latch primero frena a quietud total y después pide −2.2°; con el robot quieto y el setpoint rampeando desde ~0, |error|≤0.70° → hold entra → PID silenciado → el robot no se mueve. (2) **El latch de reversa solo se soltaba con 100 counts del encoder derecho** — exige que el robot SE MUEVA para liberarse; con el PID silenciado (o con 2.2° por debajo de la fricción estática) los counts nunca llegan → latch armado para siempre → quieto indefinidamente. (3) El latch **se armaba en cualquier `line_state`** (corría cada ciclo del modo línea): podía armarse durante el giro de esquive/pausa/FOLLOWING (el sensor lateral pasa cerca del objeto al girar) y entrar ya activo a BORDEAR_PARED. Fixes: 3 estados de pared agregados a la exclusión del hold; latch solo puede armarse dentro de los 3 estados de pared y se suelta al salir de ellos; **nuevo `OBJ_WALL_REVERSE_TIMEOUT_MS=4000`** como colchón (si en 4s no completó los counts, suelta — el robot no logró moverse); `OBJ_WALL_REVERSE_ANGLE` 2.2→**3.0°** (valor previo validado; 2.2 probablemente bajo la fricción estática desde parado — si sigue sin arrancar subir de a 0.5); `OBJ_WALL_PIVOT_POWER` 5→**8** (5 está documentado como insuficiente para rotar en el changelog del 2026-05-27 — con 5, GIRO_PARED tampoco se movía). **Riesgo señalado sin tocar**: el arco odométrico nuevo (`ObjWallComputeArcSteer`) depende del signo de `ODOM_THETA_SIGN`, que sigue **sin validar en el robot físico** — si está invertido, el semicírculo curva HACIA la pared (too_close/reversa permanentes). Verificado compilando `main.c` con la GCC de CubeIDE (sin errores ni warnings). | Usuario reportó que tras sus mejoras de robustez el robot se queda quieto y no logra hacer el esquive; pidió revisar que esté todo bien |
| 2026-07-06 | Core/Src/main.c, Core/Src/UNER.c | **Comandos manuales (adelante/atrás/izquierda/derecha) también funcionan en LINE_FOLLOWING, pero SOLO si no ve la línea**. `UNER.c`: `MOVE_FORWARD/BACKWARD/LEFT/RIGHT/STOP` ahora aceptan `robot_state==3` (LINE_FOLLOWING) además de `==4` (MANUAL_CONTROL) — el filtro real de "solo si no ve la línea" vive en `main.c`, no acá (UNER.c no tiene acceso a `line_detected`). `main.c`: nueva variable `manual_line_override` (calculada una vez por ciclo, justo después de que `line_detected` queda definido): `(robot_state==LINE_FOLLOWING) && !line_detected && (HAL_GetTick()-manual_cmd_last_ms)<250 && (comando activo)`. El chequeo de recencia (<250ms) es necesario porque el decay de `manual_setpoint_cmd`/`manual_steering_cmd` vive dentro de la rama MANUAL (que no corre mientras se sigue la línea normalmente) — sin él, un comando viejo ya soltado hace rato quedaría "congelado" en un valor no-cero y dispararía el override de golpe la próxima vez que se pierda la línea, sin que el usuario esté mandando nada en ese momento. **Reutiliza el control de MANUAL tal cual, sin duplicar el algoritmo**: se extendieron las condiciones de las dos ramas de MANUAL (cálculo de setpoint ~línea 2917, mezcla de motores ~línea 4688) a `|| manual_line_override`, y la condición de la rama normal de LINE_FOLLOWING en esos mismos dos lugares a `&& !manual_line_override` (para que no compitan). **Bugs de clamp silencioso encontrados y corregidos en el camino** (mismo patrón de bug ya visto varias veces en este archivo — un clamp que sigue mirando `robot_state`/`line_state` directamente, sin saber que hay un override activo): (1) `sp_limit` (tope global de ángulo) le daba 5.0° en vez de los 6.0° de MANUAL porque miraba `robot_state==MANUAL_CONTROL` literal. (2) el clamp de `pwm_sat` a ±40 (pensado para `LINE_FOLLOWING`+`FOLLOWING`) se aplicaba durante el override en vez del ±55 de MANUAL, igual que `pwm_limit` (40 en vez de 100). (3) `sp_step_max`/`brake_step_max` (rampas de suavizado) usaban los valores de LINE_FOLLOWING (0.15) en vez de los de MANUAL (0.1). (4) la exclusión de `balance_hold_active` para MANUAL (agregada en una sesión anterior) exigía `robot_state==MANUAL_CONTROL` literal — durante el override no se cumplía y el hold podía volver a silenciar el PID. (5) **el más importante**: `ComputeBrakeSetpointTarget(robot_state)` devuelve `0.0f` de entrada si el estado es `LINE_FOLLOWING` (ver la función) — se pasa explícitamente `ROBOT_STATE_MANUAL_CONTROL` en vez de `robot_state` cuando `manual_line_override` está activo, si no el freno traslacional quedaba completamente anulado durante el override. | Usuario pidió que el seguidor de línea responda a los comandos manuales (adelante/atrás/izquierda/derecha) cuando no está viendo la línea, ignorándolos por completo en cuanto la vuelve a ver |
| 2026-07-06 | Core/Src/main.c, Core/Src/UNER.c | **Segunda vuelta de ajuste de MANUAL: giro a 1/4 de fuerza + corrección de rumbo recto en adelante/atrás**. (1) El giro seguía sintiéndose "demasiado fuerte" pese al suavizado de rampa de la vuelta anterior — la magnitud final (no solo la rampa) era el problema. Reducida a 1/4: `MOVE_LEFT`/`MOVE_RIGHT` en `UNER.c` ahora mandan `∓15.0f`/`±15.0f` (antes `∓60.0f`/`±60.0f`), y `STEER_RATE` (rampa hacia `manual_steering_cmd`) bajado también a 1/4 (`0.25→0.0625`/ciclo). (2) **Adelante/atrás ahora van derecho**: antes, con `manual_steering_cmd=0`, `steering_adjustment` simplemente rampeaba a 0 sin ninguna corrección activa — cualquier asimetría mecánica entre ruedas hacía que el robot se curvara al mover. Se reutilizó tal cual el algoritmo de rumbo recto ya calibrado en la reversa de `OBJ_REVERSE`/wall-following (P sobre `speed_right_rps_s - speed_left_rps_s`, constantes `REV_STRAIGHT_KP/MAX/SLEW`, sin inventar nada nuevo): nueva variable `manual_straight_steer_f` (mismo patrón que `obj_rev_steer_f` pero dedicada a MANUAL, reseteada en entrada a MANUAL y en el bloque de recuperación de caída) que corrige `steering_adjustment` cuando `manual_turning` es falso (`fabsf(manual_steering_cmd) <= 0.5`); al girar, se sincroniza con `steering_adjustment` para que la transición entre "girando" y "derecho" no salte. | Usuario probó el fix anterior: el giro seguía muy fuerte (pidió explícitamente 1/4 de la fuerza actual, "siempre movimientos suaves") y notó que adelante/atrás dobla en vez de ir derecho, pidiendo reutilizar el algoritmo de rumbo recto que ya existe en el código (reversa) en vez de inventar uno nuevo |
| 2026-07-06 | Core/Src/main.c, Core/Src/UNER.c | **Fix "MANUAL no avanza ni retrocede" + control de velocidad + giro suavizado**. Causa raíz real del "no responde" encontrada: `balance_hold_active` (silencia el PID poniendo `balance_pi_scale=0`/`balance_d_scale=0` cuando el error de inclinación es chico) **nunca había tenido excepción para `ROBOT_STATE_MANUAL_CONTROL`** — solo la tenía `LINE_FOLLOWING`. Con un comando de adelante/atrás activo, apenas la inclinación real se acercaba al setpoint pedido (error chico) el hold se activaba y mataba la autoridad del PID justo cuando debía sostener el avance — mismo patrón de bug ya visto y arreglado varias veces en otros estados (`LOST_FWD`/`EDGE_FWD`/`OBJ_RETROCESO`/`OBJ_BUSCAR_PARED`), nunca extendido a MANUAL. Fix: nueva rama `else if (robot_state == ROBOT_STATE_MANUAL_CONTROL && fabsf(manual_setpoint_cmd) > 0.01f) balance_hold_active = 0;` — solo se excluye mientras hay un comando activo, así que el hold sigue sosteniendo el balance estático cuando MANUAL está realmente idle. **Control de velocidad para adelante/atrás** (a pedido, "como en otros modos"): reemplazado el mapeo directo a un ángulo fijo (antes ±4°, con rampa interna carísima de 0.01°/ciclo ≈ 4s para llegar) por un PI de velocidad (mismo patrón que `LINE_VEL_KP`/`LINE_VEL_KP_BRAKE`/`LINE_VEL_KI` del seguidor de línea, extendido a bidireccional): `manual_setpoint_cmd` pasó a ser la velocidad deseada en m/s con signo (antes grados) — `MOVE_FORWARD`/`MOVE_BACKWARD` en `UNER.c` ahora mandan `±1.0f` (antes `±4.0f`). Nuevas constantes locales `MANUAL_SPEED_MAX=1.0` m/s, `MANUAL_ANGLE_MAX=6.0°`, `MANUAL_VEL_KP=6.0` (acelerando), `MANUAL_VEL_KP_BRAKE=10.0` (frenando/revirtiendo), `MANUAL_VEL_KI=2.0`, `MANUAL_VEL_I_MAX=2.0`; nueva integral persistente `manual_vel_integral` (reseteada al entrar a MANUAL y en el bloque de recuperación de caída). **Bug de silencioso descubierto y corregido en el camino**: el clamp global `sp_limit` (por defecto 5.0° para cualquier estado sin excepción propia) habría recortado el nuevo tope de 6° a 5° sin avisar — se agregó excepción `(robot_state == ROBOT_STATE_MANUAL_CONTROL) ? 6.0f` (mismo patrón que la excepción ya existente de `OBJ_RETROCESO`). **Giro suavizado**: `STEER_RATE` (rampa de `steering_adjustment` hacia `manual_steering_cmd` en el bloque de salida de motores) bajado de `1.5` a `0.25` por ciclo — antes llegaba al steering máximo (±60) en ~0.4s (sentido "brusco"/pivot brusco), ahora tarda ~2.4s en llegar y decae igual de suave al soltar (mismo mecanismo de rampa, sin cambios adicionales). | Usuario reportó que en MANUAL los comandos de adelante/atrás llegan pero el robot no logra moverse ("le falta inclinación"), pidió que use control de velocidad (1 m/s máx, 6° máx) como en otros modos, y que el giro (que sí funciona) sea mucho más suave, de a poco hasta soltar |
| 2026-07-06 | Core/Src/main.c | **Eliminado el banco de pruebas del giro de 90° en modo MANUAL** (el ciclo automático que se activaba con el joystick/comandos en reposo, agregado el 2026-07-05). `ROBOT_STATE_MANUAL_CONTROL` ahora ejecuta SIEMPRE el control manual normal (comandos por WiFi/USB) en las dos secciones que lo implementan (cálculo de `base_setpoint_target`/`brake_setpoint_target` en el bloque de setpoint dinámico, y el cálculo de `motorRight/LeftVelocity` en el bloque de salida de motores) — se quitó el `if (joystick_idle) {...} else {...}` de ambas y quedó solo el cuerpo del `else` (ya idéntico al comportamiento real por comandos). Con `manual_setpoint_cmd`/`manual_steering_cmd` en 0 (sin comandos llegando) esa misma rama ya balancea en el lugar sin moverse — no hace falta un caso especial para "reposo". Eliminadas las variables `manual_test_rot_active`/`manual_test_wait_ms` (ya sin uso) y sus resets dispersos (entrada a MANUAL, bloque de recuperación de caída). Las constantes `MROT_*` (locales al bloque eliminado) desaparecieron con él. **Sin tocar**: `obj_rot_*` (compartidas con `LOST_ROTATE`/`EDGE_ROTATE`/`PERP_ROTATE`/`OBJ_GIRO_ESQUIVE`, siguen usándose igual ahí), el registro de comandos UNER (`MOVE_FORWARD/BACKWARD/LEFT/RIGHT/STOP`, `ACTIVATE_MANUAL_CONTROL`) y los comandos `ROTATE_90_*`/`ROTATE_180_*`/`ROTATE_CUSTOM` (ya eran no-op desde la sesión del 2026-07-04, sin cambios). **Verificado**: la cadena completa de comandos manuales (`UNER.c` case `MOVE_*` → `manual_setpoint_cmd`/`manual_steering_cmd`/`manual_cmd_last_ms` vía punteros registrados con `UNER_RegisterManualControl` → consumidos en `main.c` sin cambios de lógica, solo se quitó la rama alternativa de "idle") sigue intacta — el robot se mueve igual que antes por WiFi/USB, solo que ya no hace nada por sí solo cuando no hay comandos. | Usuario pidió eliminar el giro de 90° automático del modo MANUAL, dejándolo solo para mover el robot con comandos por WiFi |
| 2026-07-06 | Core/Inc/UNER.h, Core/Src/UNER.c, Core/Src/main.c, `C:\Microcontroladores\BalancinQT\mainwindow.h`/`mainwindow.cpp` (Qt) | **Push periódico de odometría por WiFi para graficar en Qt (mapa XY + posición de línea)**. Nuevo comando `CMD_WIFI_ODOM_DATA=0xDC` y struct packed `WifiOdomData_t` (t_ms, x_m, y_m, theta_deg, line_error, line_detected, robot_state, line_state) — mirror exacto en `UNER.h` (firmware) y `mainwindow.h` (Qt, mismo patrón `#pragma pack(1)` que ya usa `WifiLogData_t`). `UNER_SendWifiOdomData()` en `UNER.c`, mismo patrón que `UNER_SendWifiLogData` (gateado por `ESP01_StateUDPTCP()==CONNECTED && !ESP01_IsSending()`). En `main.c`: nuevo `#define WIFI_ODOM_PERIOD_MS 500` y bloque de envío en `ControlStep10ms`, gateado únicamente por `f_wifi_connected` (**no** por `ACTIVATE_WIFI_LOG`) — arranca solo con detectar conexión WiFi, sin necesidad de tocar nada desde Qt, y a un ritmo bajo (2 Hz) a propósito para no competir por CPU/ancho de banda con la telemetría de control existente (10 Hz). Nueva variable `line_detected_disp` (file-scope, seteada junto a `line_error_disp` en el bloque de seguidor de línea) para poder leer "¿se ve la línea ahora?" fuera del scope local de `line_detected`. **Lado Qt**: nueva pestaña "Odometría (WiFi)" en `tabWidget_Graficas` (creada 100% por código en el constructor, mismo patrón que las demás pestañas — no se tocó el `.ui`) con un `QChart` que dibuja la trayectoria (x,y) como línea gris, puntos verdes donde se veía la línea y rojos donde no, y un marcador azul grande para la posición actual; autoescala de ejes que solo crece (nunca se achica) con margen de 0.3m; label de texto con X/Y/Theta/línea numéricos. Nuevo método `MainWindow::updateOdomChart()` y case `WIFI_ODOM_DATA` en `decodeData()` (usa `reinterpret_cast<WifiOdomData_t*>`, igual que ya hace `WIFI_LOG_DATA` con `WifiLogData_t`). | Usuario pidió, aprovechando la odometría ya implementada, poder graficar en Qt la posición del robot en un mapa XY y por dónde está la línea, enviado automáticamente por WiFi a un ritmo bajo para no afectar las tareas de control más importantes |
| 2026-07-06 | `C:\Microcontroladores\BalancinQT\mainwindow.h`, `mainwindow.cpp` (proyecto Qt, no STM32) | **Handlers de `GET_ODOMETRY`/`RESET_ODOMETRY` agregados en Qt** — cierra la dependencia pendiente desde 2026-07-04. Enum `_eCmd`: `GET_ODOMETRY=0xDA`/`RESET_ODOMETRY=0xDB`. Agregados como comandos sin payload en los dos switches de envío existentes (UDP y Serie, junto a `GETALIVE`/`GETANGLE`/`SETLEDS`/etc.). Dos entradas nuevas en `comboBox_CMD` ("GET ODOMETRY"/"RESET ODOMETRY") para dispararlos manualmente desde la UI ya existente (mismo mecanismo genérico que ya usan `GETANGLE`, `BALANCE`, etc. — no hizo falta un botón dedicado). Parsing en `decodeData()`: `GET_ODOMETRY` decodifica los 3 floats LE (x[m]/y[m]/theta[°], mismo layout que ya define `UNER.c` del lado STM32) y los loguea en `textEdit_PROCCES`; `RESET_ODOMETRY` loguea el ACK. No se tocó el `.ui` ni se agregaron labels/gráficos dedicados a posición — solo texto en el log de proceso, suficiente para poder pedir la pose a mano y compararla girando el robot. Firmware STM32 no se tocó (ya estaba completo desde 2026-07-04: enum, registro de punteros y handlers en UNER.c/main.c). | Usuario pidió cerrar la dependencia Qt pendiente para poder chequear/comprobar la odometría, en particular validar en el robot físico el signo de `ODOM_THETA_SIGN` (riesgo conocido documentado, nunca confirmado) |
| 2026-07-06 | Core/Src/main.c | **Anti-temblor v2 (a pedido: SIN filtros por software sobre el MPU)**: (1) eliminado el EMA `gz_yaw_assist_f` de la pasada anterior — el MPU ya trae su DLPF de ~44 Hz; el yaw-assist usa gz crudo con **zona muerta** `GZ_YAW_ASSIST_DB` 2→**3.0°/s** (ajustar de a 1). (2) **Nueva zona neutra de comando de motores `MOTOR_CMD_NEUTRAL=2`**: comandos con \|v\| ≤ 2 PWM van directamente a 0 en vez de saltar a ±(v+8) por la compensación de deadband — esta era la fuente principal del temblor: cualquier chatter de ±1 PWM del PID cerca del equilibrio se convertía en golpes de ±9 PWM a 100 Hz. Subir de a 1 si sigue temblando; demasiado alto → bamboleo lento (el PID corrige recién con error más grande). (3) **Fix display "el spinner no se ve"**: `SSD1306_DrawChar5x7` solo tiene glifos 0-9/A-Z — los caracteres del spinner (`\| / - \\`) y la puntuación de las pantallas nuevas (`: . + * < > ^ = !` y minúsculas) se descartaban en silencio. `OLED_Str5` ahora dibuja la puntuación a mano (píxeles, mismo enfoque que usaba el código viejo de pantalla 0) y mapea minúsculas→mayúsculas; el spinner del header pasa por ese helper. | Usuario pidió explícitamente no filtrar datos del MPU (ya tiene DLPF propio), ajustar la zona de punto muerto en su lugar, y reportó que el spinner del header no aparecía |
| 2026-07-06 | Core/Src/main.c | **Fix "vibra demasiado en balance común tras la corrección de escala del gyro" — yaw-assist filtrado**: el reescalado 0.3→0.23 restauró la ganancia efectiva exacta, pero el problema de fondo quedó: el yaw-assist (`gz*0.23`, en balance común y en los estados de avance del modo línea) es un término derivativo puro que realimenta el ruido de vibración de los motores directo al diferencial de ruedas, y la compensación de deadband de motor (±8 PWM sobre cualquier comando ≠0) amplifica ese chatter chico en golpes visibles. Fix (aislado, NO toca el PID de balance ni la ganancia): nueva `gz_yaw_assist_f` — EMA de gz en dps (`GZ_YAW_ASSIST_BETA=0.25` a 100 Hz ≈ corte 4-5 Hz: rotación real pasa, vibración >20 Hz se atenúa fuerte) actualizada una vez por ciclo en `ControlStep10ms`, usada con `apply_deadbandf(·, GZ_YAW_ASSIST_DB=2.0°/s)` en los DOS puntos de yaw-assist — con el robot quieto la corrección es exactamente 0 y no dispara la compensación de deadband. Reset en el bloque de caída. **Si tras probar sigue vibrando**, el siguiente paso aislado sería filtrar el término D del PID de balance (derivada numérica de `filtered_roll_deg` sin filtro, documentado como pendiente histórico) — no se tocó en esta pasada a propósito, un cambio por vez. | Usuario reportó vibración excesiva del balance común en todos los modos desde el fix de escala gz /131→/100 |
| 2026-07-06 | Core/Src/main.c | **Sobrepaso en el retorno por odometría (`LOST_FWD`/`EDGE_FWD`)**: al alcanzar el punto de pérdida (`ret_dist < LOST_RETURN_REACHED_M`) ya no se rinde ahí mismo — los sensores necesitan pasar POR ENCIMA de la cinta para verla. Nueva fase de sobrepaso: sigue derecho (steering=0, yaw-assist por gyro) `LOST_RETURN_OVERSHOOT_M=0.20m` más allá (medido por odometría desde el snapshot `lost_ret_ov_x/y`) antes de pasar a `GIVEN_UP`. También entra al sobrepaso si "pasó el punto de costado": objetivo a menos de `LOST_RETURN_PASS_WIN_M=0.35m` pero con error de rumbo >120° (el punto quedó atrás) — antes eso hacía que el P de rumbo comandara una vuelta en U por un desvío lateral chico. `lost_ret_ov_active` se resetea en todas las salidas de ambos estados, en el bloque de caída y al entrar al modo línea. | Usuario confirmó que el retorno por odometría funciona (se acerca al punto) pero pidió que se pase un poco del lugar porque los sensores necesitan cruzar la línea para verla |
| 2026-07-06 | Core/Src/main.c | **Ajustes post-feedback del rediseño de displays**: (1) filas PW (pwm_sat) y BR (brake setpoint) eliminadas de P0 — el usuario casi no las usa; las 3 filas restantes (ER/VE/GZ) quedan más espaciadas. (2) El punto de actividad 3x3 del header reemplazado por un **spinner de tamaño carácter** (`| / - \` rotando en la esquina superior derecha de todas las pantallas) — el punto era demasiado chico para notar un freeze. También en esta fecha: `FormatSignedFixed` acotada (tope 99999 entero + módulo en decimales) para eliminar los -Wformat-truncation del build Release. | Feedback del usuario tras probar el rediseño: demasiados datos juntos y el indicador de vida poco visible |
| 2026-07-06 | Core/Src/main.c | **Rediseño completo de todas las pantallas del display OLED** (`updateDisplay` reescrito entero + helpers nuevos `OLED_Str5`/`OLED_Header`/`OLED_HBar`/`OLED_Puts7CenteredX`/`LineStateStr`/`OLED_LineStateElapsedMs`). **Header común en todas las pantallas**: título + "F!" si caído + modo actual (BAL/SPD/LIN/MAN/TST/IDL) + icono WiFi + punto de actividad que parpadea (detecta freeze de display a simple vista). **P0 BALANCE**: ángulo grande + inclinómetro gráfico ±15° con marcador de setpoint, y columnas ER/VE/PW (pwm_sat, antes no se mostraba)/BR/GZ + comando de motores (o CMD de joystick en MANUAL). **P1 LINEA**: barras ADC como antes + tick de umbral de objeto en barras 5-8 + **franja de posición del centroide de línea** (caret sobre escala ±0.6) + tiempo en el sub-estado actual + error de línea numérico. **P2 ADC BARRAS**: tick de umbral por canal (LINE_THRESHOLD en 1-4, OBJ_DETECT en 5-8) + cuadradito de disparo cuando el canal está "activado". **P3 PARAM**: dos columnas BALANCE (P/I/D/TR/KV) y LINEA (P/I/D/TH/VT). **P4 ADC VALORES**: numéricos con asterisco de disparo. **P5 IMU**: gyro/accel crudos + ROLL/W/YAW en dps + `MOV` (accel_motion_f, para calibrar el umbral de "en la mano"). **P6 OBJETO**: estado + **tiempo en estado** + barras horizontales A5/A7 con TODOS los umbrales marcados (A7 muestra REVERSE/TOO_CLOSE/THRESHOLD — clave para tunear el wall-following). **P7 ODOMETRIA (nueva)**: mapa 2D autoescalado con origen, pose actual + rayo de rumbo, punto de pérdida de línea, y X/Y/θ/distancia numéricos — pensada para validar `ODOM_THETA_SIGN` y el retorno por odometría viéndolo en vivo. Botón cicla ahora entre **8 pantallas** (`% 8`); el auto-cambio a P1/P6 en modo línea/evasión no se tocó. Verificado compilando `main.c` aislado con la GCC de CubeIDE: sin errores ni warnings. | Usuario pidió una mejora grande de todos los displays, estética y funcional, para poder entender y debuggear mejor todos los modos |
| 2026-07-05 | Core/Src/main.c | **Retorno por odometría extendido a `EDGE_FWD`** (pérdida por un extremo/curva, giro de 45°): antes solo `LOST_FWD` (giro de 180°, pérdida centrada) navegaba de vuelta al punto donde se vio la línea por última vez — `EDGE_FWD` avanzaba a ciegas con solo un amortiguador de yaw por gyro crudo, sin punto objetivo. Ahora usa exactamente el mismo mecanismo que `LOST_FWD` (steering P sobre error de rumbo hacia `line_loss_x/y_m`, mismas constantes `LOST_RETURN_STEER_KP/MAX`, `LOST_RETURN_REACHED_M`, mismo `ODOM_THETA_SIGN`): el snapshot de pose ya se grababa sin distinguir si la pérdida sería centrada o por el extremo, así que no hizo falta tocar la captura, solo el consumo en este estado. Si no hay snapshot válido (recién entrado al modo), cae al mismo fallback anterior (avance recto con yaw-assist por gyro). **Comparte el mismo riesgo pendiente que `LOST_FWD`: `ODOM_THETA_SIGN` no está validado en el robot físico** — si el signo está mal, la corrección de rumbo empeora en vez de ayudar en ambos caminos por igual. | Usuario pidió extender el retorno por odometría (que ya tenía LOST_FWD) al camino de pérdida por el extremo, que hasta ahora seguía avanzando a ciegas |
| 2026-07-05 | Core/Src/main.c | **Prueba: `OBJ_BUSCAR_PARED` (APPROACH) salteado** — `OBJ_PAUSA_GIRO` ahora transiciona directo a `OBJ_BORDEAR_PARED` (con los mismos resets que `OBJ_BUSCAR_PARED` aplicaba al encontrar la pared: `obj_wall_fwd_start_ms`/`obj_wall_seq_start_ms`/`obj_wall_vel_integral`) en vez de pasar primero por el avance cauteloso buscando ADC7. `LINE_STATE_OBJ_ARC` (ya sin uso, solo redirige) también actualizado a apuntar a `OBJ_BORDEAR_PARED` en vez de `OBJ_BUSCAR_PARED`. El case `LINE_STATE_OBJ_BUSCAR_PARED` queda en el código sin ser alcanzado por ninguna transición (mismo patrón que `OBJ_ARC`) — se puede revertir fácilmente volviendo a apuntar `OBJ_PAUSA_GIRO`→`OBJ_BUSCAR_PARED` si el salto directo no funciona bien (por ejemplo, si el robot todavía está lejos del objeto al salir del giro y `OBJ_BORDEAR_PARED` no ve la pared en ADC7 — ese estado no tiene su propio avance de aproximación, así que "pierde la pared" inmediatamente y dispara su rama `!wall_visible`→`OBJ_PARED_LIBRE`). | Usuario pidió probar saltear el estado de aproximación e ir directo al wall-following tras el giro de esquive |
| 2026-07-05 | Core/Src/main.c | **Reubicación de las pausas de la evasión de objeto**: la pausa larga (5s) va **antes** de la reversa, no después — `OBJ_PRE_REVERSE_HOLD_MS` (mínimo de balance estático en `OBJ_ESPERA_REVERSA` antes de pasar a `OBJ_RETROCESO`) 1000→**5000ms**, `OBJ_PRE_REVERSE_TIMEOUT` (colchón de seguridad) 2500→**6000ms**. La pausa post-reversa/pre-giro (`PRE_ROTATE_MS` en `OBJ_FRENO_REVERSA`) vuelta a **3000ms** (había quedado en 5000ms por una vuelta anterior mal ubicada). | Usuario aclaró que la pausa de 5s pedida debía ir antes de retroceder, no entre el freno de la reversa y el giro — esa debía quedar en 3s |
| 2026-07-05 | Core/Src/main.c | **Fix "en LIBRE/PARED ignora la línea todo el tiempo, no se detiene al reencontrarla"**: `OBJ_BORDEAR_PARED`/`OBJ_PARED_LIBRE`/`OBJ_GIRO_PARED` ignoraban `line_detected` durante una ventana (3s/2s) medida desde timestamps (`obj_wall_fwd_start_ms`, `obj_wall_lost_ms`) que se **reseteaban cada vez que el robot ciclaba entre esos 3 estados** (bordear pared → pierde pared → gira buscándola → la re-encuentra → vuelve a bordear...). Si el robot oscila entre estos estados buscando la pared (comportamiento normal del wall-following), la ventana de "ignorar línea" nunca terminaba de agotarse — efectivamente ignoraba la línea para siempre mientras seguía ciclando, tal como describió el usuario ("se hace el boludo"). Fix: nueva variable `obj_wall_seq_start_ms`, fijada UNA sola vez al entrar a la secuencia completa (desde `OBJ_BUSCAR_PARED` hacia `OBJ_BORDEAR_PARED`) y NUNCA reseteada al ciclar internamente entre los 3 estados — solo se resetea al salir de verdad (línea reencontrada → FOLLOWING, o caída). Los 3 estados ahora comparten la misma ventana de `OBJ_WALL_LINE_IGNORE_MS=3000ms` medida desde ese único punto de entrada, en vez de 3 timestamps que se reseteaban por separado. `obj_wall_fwd_start_ms`/`obj_wall_lost_ms` quedan sin uso para esta lógica (se resetean pero ya no se leen). | Usuario reportó que en los estados LIBRE/PARED, al reencontrar la línea tras esquivar el objeto, el robot no se detenía para volver a seguirla — sospechó correctamente que la rotación entre estados reseteaba la ventana de ignorar línea indefinidamente |
| 2026-07-05 | Core/Src/main.c | **`OBJ_BUSCAR_PARED` — el timeout ya no rinde la evasión**: si tras `OBJ_WALL_APPROACH_TIMEOUT` (6s) no encuentra la pared con ADC7, en vez de volver a `FOLLOWING` (abandonando el esquive) ahora pasa directo a `OBJ_BORDEAR_PARED` (mismo mecanismo que si la hubiese encontrado: `obj_wall_fwd_start_ms`/`obj_wall_vel_integral` reseteados). La salida por caída (`f_fallen`) sigue yendo a `FOLLOWING` sin cambios — solo se tocó la rama de timeout. | Usuario pidió que si no encuentra la pared, el robot pase a bordearla igual en vez de abandonar la evasión y volver a seguir línea |
| 2026-07-05 | Core/Src/main.c | **Segunda vuelta de ajuste del giro de esquive de objeto**: (1) `PRE_ROTATE_MS` (espera de estabilización tras frenar, antes de girar, en `OBJ_FRENO_REVERSA`) 3000→**5000ms**, a pedido explícito del usuario (~5s totales entre ver el obstáculo/frenar y arrancar el giro). (2) `LINE_ROT_ENC_TARGET` recortado más: 394→**372** (el giro seguía quedando grande tras el primer recorte). Ambos solo afectan `OBJ_GIRO_ESQUIVE`/`OBJ_FRENO_REVERSA`; sin tocar `LOST_ROTATE`/`EDGE_ROTATE`/banco MANUAL. Pendiente: confirmar en el robot si 372 ya da 90° reales, o si hace falta otra vuelta de recorte proporcional según el grado real medido. | Usuario pidió explícitamente 5s totales de pausa antes de girar, y que el ángulo del giro de esquive se siga recortando porque aún salía grande |
| 2026-07-05 | Core/Src/main.c | **Ajuste del giro de esquive de objeto (`OBJ_GIRO_ESQUIVE`)**: (1) más tiempo de estabilización antes de girar — `PRE_ROTATE_MS` (fase 2 de `OBJ_FRENO_REVERSA`, espera tras frenar antes de pasar al giro) 2000→**3000ms**. (2) Giro recortado — usuario midió ~105° en vez de 90°; `LINE_ROT_ENC_TARGET` 460→**394** (460×90/105, mismo reescalado proporcional ya usado para calibrar el giro de 180°). Solo afecta el giro de esquive de objeto (`OBJ_GIRO_ESQUIVE`); no se tocó el banco de pruebas MANUAL de 90° (`MROT_*`) ni `LOST_ROTATE`/`EDGE_ROTATE`, que son independientes. | Usuario pidió más pausa para que el robot se estabilice antes de girar al detectar un objeto, y reportó que el giro se pasaba de los 90° esperados |
| 2026-07-05 | Core/Src/main.c | **Fix "en OBJ_BUSCAR_PARED casi no avanza"**: `LINE_STATE_OBJ_BUSCAR_PARED` faltaba en la lista de exclusión del `balance_hold_active` (mismo patrón de bug ya visto en `LOST_FWD`/`EDGE_FWD`/`OBJ_RETROCESO`: el hold se activa con error de inclinación chico y silencia el PID justo cuando debe empujar). Agregado a esa lista y también a la lista de yaw-assist por gyro (para que avance derecho, igual que sus estados hermanos `OBJ_BORDEAR_PARED`/`OBJ_PARED_LIBRE`, que sí la tenían). Esto también explica el "se sale de esquive si ve la línea": `OBJ_BUSCAR_PARED` nunca revisa la línea directamente (confirmado); lo que pasaba era que, al casi no avanzar, se agotaba el timeout de búsqueda de pared (`OBJ_WALL_APPROACH_TIMEOUT`) y volvía a `FOLLOWING`, donde sí sigue la línea normalmente — se percibía como una salida por línea pero era un timeout. | Usuario reportó que tras el giro de 90° de esquive, en la fase de avance buscando la pared casi no se mueve, y que si ve la línea sale de la evasión |
| 2026-07-05 | Core/Src/main.c | **Renombrados los 9 estados del enum `eLineState` de la secuencia de esquive de objeto**, en español (primer intento en inglés revertido a pedido del usuario), alineados con las abreviaturas del display OLED (que no se tocaron): `OBJ_PRE_REVERSE_HOLD`→**`OBJ_ESPERA_REVERSA`** (ESPER), `OBJ_REVERSE`→**`OBJ_RETROCESO`** (RETRO), `OBJ_BRAKE`→**`OBJ_FRENO_REVERSA`** (STOP), `OBJ_ROTATE`→**`OBJ_GIRO_ESQUIVE`** (ESQUIV), `OBJ_HOLD`→**`OBJ_PAUSA_GIRO`** (PAUSA), `OBJ_WALL_APPROACH`→**`OBJ_BUSCAR_PARED`** (APRCH), `OBJ_WALL_FWD`→**`OBJ_BORDEAR_PARED`** (PARED), `OBJ_WALL_CLEAR`→**`OBJ_PARED_LIBRE`** (LIBRE), `OBJ_WALL_TURN`→**`OBJ_GIRO_PARED`** (GIRAP). `OBJ_ARC` (no usado, reservado) sin cambios. De paso corregido un comentario desactualizado ("girando 180°" en el estado que gira 90°). Verificado sin residuos del nombre viejo y compilación sin warnings. | Usuario pidió nombres más característicos para diferenciar los estados de esquive; primer renombre quedó en inglés, pedido explícito de traducirlo a español |
| 2026-07-05 | Core/Src/main.c | **Revertido "ignorar línea todo el tiempo en WALL_FWD"**: `WALL_FWD` vuelve a revisar la línea con la ventana de 3s original al entrar (`OBJ_WALL_LINE_IGNORE_MS`), como estaba antes del cambio previo de esta misma sesión. La ventana de 2s en `WALL_CLEAR`/`WALL_TURN` (`obj_wall_lost_ms`) queda sin tocar. | Usuario pidió específicamente deshacer el "ignorar todo el tiempo" en WALL_FWD |
| 2026-07-05 | Core/Src/main.c | **`LINE_STATE_OBJ_ROTATE` (giro de 90° para esquivar objeto) reescrito con la misma lógica ya validada del banco MANUAL de 90°**: pivot fijo 24 con slowdown por encoder puro (no `fmaxf(gyro,encoder)` para la potencia, solo para overshoot), freno 10 arrancando al 85% del recorrido (no recién al 100%), y el fix de continuidad al terminar (sigue aplicando el freno diferencial un ciclo más en vez de soltarlo de golpe). `LINE_ROT_ENC_TARGET` 380→**460** (igual que el banco). Reemplaza la salida por velocidad medida (`vel_ok`) por el mismo mecanismo `enc_done`+duración+overshoot ya usado en `LOST_ROTATE`/MANUAL. | Usuario confirmó que el giro de 90° del banco MANUAL quedó muy bien y pidió aplicar la misma lógica al giro real de esquive de objetos |
| 2026-07-05 | Core/Src/main.c | **Línea ignorada durante todo `OBJ_WALL_FWD`** (antes solo 3s al entrar, `OBJ_WALL_LINE_IGNORE_MS`) — no debe salir de la evasión por cruzar la cinta mientras bordea la pared; la reconexión real ocurre en `WALL_CLEAR`/`WALL_TURN`. Además, **nueva ventana de 2s ignorando la línea en `WALL_CLEAR` y `WALL_TURN`** (nuevo timestamp `obj_wall_lost_ms`, marcado al perder la pared en `WALL_FWD`) — antes esos dos estados no tenían NINGÚN margen: cruzar la cinta durante la búsqueda de la pared (tras perderla) sacaba de la evasión al instante. | Usuario reportó que la evasión salía prematuramente al ver la cinta mientras bordeaba la pared o mientras buscaba reencontrarla tras perderla |
| 2026-07-05 | Core/Src/main.c | **Fix "a veces se va para atrás justo al terminar el giro" (banco MANUAL)**: al terminar, el código soltaba de golpe el freno diferencial (±`MROT_BRAKE`) poniendo ambas ruedas al mismo `-pwm_sat` — un salto brusco de "frenando activamente" a "neutro" en un solo ciclo, que podía darle un empujón (según el signo de `pwm_sat` en ese instante). Además el freno traslacional de la espera (`ComputeBrakeSetpointTarget`) recién entra en vigor el ciclo SIGUIENTE (el setpoint del ciclo actual ya se calculó antes, con `manual_test_rot_active` todavía en 1). Fix: en el frame de salida se sigue aplicando el mismo freno diferencial un ciclo más, en vez de soltarlo de golpe — sin discontinuidad en el instante de la transición. | Usuario reportó que a veces el robot se va hacia atrás justo al terminar el giro de 90°, sin saber si era el freno |
| 2026-07-05 | Core/Src/main.c | **Banco de pruebas en MANUAL reconvertido de 180°/3s a 90°/2s**: `MROT_ABS_TARGET` 180→90, `MROT_ENC_TARGET` 920→**460** (×0.5), `MROT_SLOWDOWN_DEG` 55→**28** (×0.5), `MROT_WAIT_MS` 3000→**2000**. Potencia (`MROT_PIVOT=24`, `MROT_BRAKE=10`) y demás parámetros (freno al 85%, duración 250ms) se mantienen como punto de partida del tuning ya validado en el giro de 180°, a falta de probar si necesitan su propio ajuste para 90°. `LOST_ROTATE` (giro real de 180°) no se tocó. | Usuario pidió reemplazar el banco de 180° por uno de 90° cada 2s para poder tunear ese giro (usado en `OBJ_ROTATE`/evasión de obstáculos) con el mismo método iterativo |
| 2026-07-05 | Core/Src/main.c | **`EDGE_FWD_TIMEOUT` 5000→10000ms**: más tiempo de búsqueda tras el giro de 45° (pérdida de línea por los costados/curva), igualado al timeout ya usado en `LOST_FWD` (180°, camino centrado). Comentario del bloque corregido (decía "post-90°"/"antes 3s", desactualizado — el giro de este camino es 45°). | Usuario pidió más tiempo de búsqueda tras el giro de 45° al perder la línea por los costados |
| 2026-07-05 | Core/Src/main.c | **Giro de 180° dado por bueno — ajuste final a mano por el usuario en el IDE**: `LROT_ENC_TARGET`→960 (aplicado por Claude, reescalado 880×180/165), `MROT_ENC_TARGET`→**920** (ajustado a mano por el usuario tras probar en el banco, queda levemente desincronizado de `LROT_ENC_TARGET` a propósito). Resto de parámetros de esta sesión de tuning quedan: `PIVOT=24`, `BRAKE=10`, `BRAKE_DURATION=250ms`, freno arrancando al 85% del recorrido (`enc_near_done`). Etiquetado como tag de referencia tras esta sesión. | Usuario confirmó "quedó muchísimo mejor" tras toda la sesión de fixes+tuning del giro de 180° |
| 2026-07-05 | Core/Src/main.c | **`LROT_ENC_TARGET`/`MROT_ENC_TARGET` 880→960**: usuario midió que el giro quedaba corto (~165° en vez de 180°). Reescalado proporcional: 880×(180/165)≈960. | Usuario confirmó el giro andando bien salvo que le faltaba recorrido; medición directa en el robot |
| 2026-07-05 | Core/Src/main.c | **Fix "el freno actúa muy al final, rompe el equilibrio"**: el freno fijo (`LROT_BRAKE`/`MROT_BRAKE`) solo se activaba al llegar al 100% del recorrido por encoder (`enc_done`) — de golpe, justo al terminar el giro. Nuevo `enc_near_done` (85% del recorrido) decide cuándo empieza a frenar en vez de seguir en la fase débil de "pivoteando suave"; el corte final del giro sigue dependiendo de `enc_done` (100%) sin cambios, así que no se acorta el recorrido — el freno simplemente tiene más distancia/tiempo para actuar en vez de golpear todo de una vez al final. | Usuario reportó que el freno actuaba muy al final y eso rompía el equilibrio; pidió que actúe antes |
| 2026-07-05 | Core/Src/main.c | **`LROT_BRAKE`/`MROT_BRAKE` 16→10**: usuario reportó que el freno del giro actúa inconsistente, a veces fuerte, y a veces desestabiliza tirando el robot. Causa: el freno es un torque fijo aplicado sin medir cuánta velocidad de giro queda en ese momento — si el robot llega con poco impulso remanente (varía según cómo haya frenado el avance), el mismo torque fijo lo pasa de frenada e invierte el sentido, un tirón que desestabiliza. Bajada la magnitud (16→10, mismo mecanismo simple, sin volver a un freno proporcional/activo — eso ya se probó y se revirtió). Si sigue desestabilizando, seguir bajando de a 2; si queda con giro residual sin frenar del todo, este es el límite y habría que revisar la duración (`LROT_BRAKE_DURATION=250ms`) en su lugar. | Usuario reportó freno "muy inconsistente y fuerte por ahí" tras validar el resto del giro (pivot, arranque) |
| 2026-07-05 | Core/Src/main.c | **Explicación + fix de "a veces arranca muy suave y se cae, otras sale limpio"**: causa identificada — cada rueda recibe `pwm_sat ± pivot`; la diferencia (`2×pivot`) nunca cambia, pero el torque ABSOLUTO de cada rueda sí depende del valor de `pwm_sat` (salida del PID de balance) en el instante exacto en que arranca el giro. Si `pwm_sat` tiene algún residuo (micro-inclinación, ruido de gyro, asimetría de peso) que resta en vez de sumar en una rueda, esa rueda queda con menos margen real para vencer la fricción — arranque desparejo y caída, de forma aparentemente aleatoria según el estado del balance en ese instante puntual. `LROT_PIVOT`/`MROT_PIVOT` 20→**24** para que ese residuo de `pwm_sat` sea proporcionalmente menos significativo frente al pivot. | Usuario preguntó por qué el giro a veces arranca suave y se cae y otras sale limpio — explicado el mecanismo (competencia entre pwm_sat y pivot) y aplicado el ajuste correspondiente |
| 2026-07-05 | Core/Src/main.c | **`LROT_BRAKE_DURATION`/`MROT_BRAKE_DURATION` 400→250ms**: usuario reportó que el freno final del giro "frena bien pero luego vuelve un poco" (persistente). El freno es un torque fijo (16 PWM) aplicado sin importar si el robot ya se detuvo — si frena antes de agotar los 400ms, el resto del tiempo sigue empujando en reversa, causando el retroceso. Acortada la ventana a 250ms, único cambio; si sigue volviendo, el siguiente paso sería bajar `LROT_BRAKE` (16) en vez de la duración. | Usuario reportó rebote persistente tras el freno del giro de 180° |
| 2026-07-05 | Core/Src/main.c | **`LROT_PIVOT`/`MROT_PIVOT` 14→20**: usuario reportó que el giro arranca muy lento y se cae casi siempre, incluso ya con los dos fixes aislados del gyro aplicados. Revisado el código a fondo: no hay bug — el pivot arranca a plena potencia desde el primer ciclo (a t=0 "remaining"=180°, muy por encima de los 55° donde recién empieza a bajar). La causa real es que 14 PWM de diferencia entre ruedas es poco margen; probablemente siempre lo fue, pero como esta maniobra antes se disparaba rara vez en uso real (perder la línea), nunca se sometió a un test repetido intensivo como el banco de MANUAL — cualquier variación real (batería, fricción del piso) alcanza para tumbar el margen. Subido a 20, único cambio. | Usuario preguntó dónde estaba el problema del arranque lento; revisión de código descartó bug de lógica, apuntando a que el valor de potencia original era marginal y recién se expuso con el test repetido |
| 2026-07-05 | Core/Src/main.c | **Fix mínimo y aislado #2**: el pivot base de por sí ya es chico (`LROT_PIVOT=14` PWM de diferencia entre ruedas), y la rampa de frenado interna de la fase 0 (`remaining = ABS_TARGET - lrot_abs_hdg`, que reduce el pivot por debajo de 14 cerca del final) seguía usando `lrot_abs_hdg` (`fmaxf(gyro,encoder)`, inflado con `gz/100`) — igual que la transición de fase del fix anterior, "remaining" se achicaba antes de tiempo por el gyro y bajaba la potencia durante buena parte del giro, no solo cerca del final. Cambiado a `remaining = ABS_TARGET - lrot_enc_deg` (solo encoder) en `LOST_ROTATE` y banco MANUAL. Sigue siendo un cambio de una línea, aislado. | Usuario preguntó qué PWM se manda a los motores — reveló que el pivot ya es chico (14) y encima se reducía antes de tiempo por el mismo problema del fix anterior en un lugar distinto del código |
| 2026-07-05 | Core/Src/main.c | **Fix mínimo y aislado #1 de "giro lento y en varias partes"**: con `gz/100` (escala nueva, 31% más alta que `/131`), la condición de transición de fase de `LOST_ROTATE`/banco MANUAL (`lrot_abs_hdg >= ABS_TARGET*0.70`, con `lrot_abs_hdg=fmaxf(gyro,encoder)`) se disparaba con el gyro creyendo que ya se completó el 70% del giro antes de que el encoder lo confirmara físicamente — entraba temprano a la fase de terminación (mucho más débil, pivot×0.4 con piso 0.2) y el resto se arrastraba lento y a pulsos. Fix: la transición de fase ahora se decide **solo por encoder** (`lrot_counts >= lrot_enc_thr`, quitada la condición de heading); el gyro (`lrot_abs_hdg`) queda únicamente para la red de seguridad de sobregiro (`overshoot`, sin tocar). Ningún otro parámetro (pivots, frenos, umbrales) se tocó — cambio de una condición, aislado, para poder evaluarlo solo. | Usuario pidió arreglar de a poco, un cambio aislado por vez, en vez de encadenar rediseños como en la sesión anterior |
| 2026-07-05 | Core/Src/main.c | **Banco de pruebas del giro de 180° reconstruido en modo MANUAL** (reemplaza otra vez el test de reversa): con el joystick en reposo, espera 3s balanceando quieto (upright + freno de encoders) y ejecuta un giro de 180° con la lógica ORIGINAL restaurada de `LOST_ROTATE` (pivot fijo 14, freno fijo 16, heading `fmaxf(gyro, encoder)`, `gz/100` — la escala nueva pedida por el usuario), en ciclo indefinido. Nuevas variables `manual_test_rot_active`/`manual_test_wait_ms` (reseteadas en entrada a MANUAL y en caída, reusa `obj_rot_*`). Joystick en uso → control manual normal (cancela el ciclo). El test de reversa (`MANUAL_REV_TEST_TILT`) queda disponible en el código pero ya no es lo que corre en MANUAL con joystick quieto. | Usuario pidió volver a tener el ciclo de giros de 180° cada 3s en MANUAL, ahora sobre la base ya revertida (lógica original + solo escala de gyro nueva), para poder observarlo en el robot |
| 2026-07-05 | Core/Src/main.c | **Único cambio sobre la reversión completa: escala del gyro Z vuelta a `gz/100`** (no `/131`) en los 4 bloques de giro (`LOST_ROTATE`/`EDGE_ROTATE`/`PERP_ROTATE`/`OBJ_ROTATE`), a pedido explícito del usuario — quiere la resolución de la escala corregida, nada más. El resto de la lógica revertida (heading por `fmaxf(gyro, encoder)`, pivot fijo `LROT_PIVOT=14`/`LROT_BRAKE=16`, todos los umbrales) queda exactamente como en el commit pre-sesión. **Riesgo conocido, sin resolver**: con `/100` el gyro lee un 31% más alto que con `/131`, por lo que dentro del `fmaxf` puede volver a dominar antes que el encoder y adelantar el pase a la fase de frenado (síntoma original de "lento y a pulsos" que motivó el rediseño de hoy) — pendiente de confirmar en el robot si reaparece con solo este cambio; si aparece, la próxima corrección debería ser mínima y aislada (ej. solo ajustar el umbral 0.70/0.80 del `fmaxf`), no una cadena de rediseños. | Usuario pidió mantener solo la corrección de escala del gyro (más resolución) sin ninguno de los demás cambios de la sesión de hoy sobre la lógica de giro |
| 2026-07-05 | Core/Src/main.c | **REVERSIÓN COMPLETA de todo el rediseño del giro de esta sesión** — usuario reportó que tras el último cambio (freno activo) el robot giraba hacia AMBOS lados (uno y luego el otro), y pidió explícitamente volver al estado anterior a esta sesión. Diagnóstico: la cadena de rediseños (lazo de tasa, filtrado, freno proporcional→activo→rampa→contra-torque) se fue acumulando sobre sí misma sin una base estable, cada fix parcheaba un síntoma nuevo introducido por el fix anterior, hasta volverse impredecible. **Se restauraron byte-a-byte** (verificado con diff contra el commit `d9c9fc7`, tag más reciente V15 previo a esta sesión) los 4 estados de giro (`LOST_ROTATE`, `EDGE_ROTATE`, `PERP_ROTATE`, `OBJ_ROTATE`) y el banco de pruebas en modo MANUAL, que vuelve a ser el test de reversa indefinida original (`MANUAL_REV_TEST_TILT`, eliminado el ciclo de giros de 180° que se había agregado esta sesión). Esto incluye volver la escala del gyro a `gz/131` **específicamente en estos 4 bloques de giro** (vuelven a usar `fmaxf(heading_gyro, heading_encoder)` con pivot fijo — `LROT_PIVOT=14`, `LROT_BRAKE=16`, etc. — tal como estaba calibrado). Se eliminaron las variables de archivo `rot_yaw_filt_dps`/`rot_pivot_f`/`manual_test_rot_active`/`manual_test_wait_ms` (ya sin uso) y sus resets dispersos (bloque de caída, entrada a modo MANUAL). **Lo que NO se revirtió** (fixes de esta sesión validados por el usuario en pruebas separadas, sin relación con el bug del giro): la ganancia de yaw-assist reescalada a 0.23 en balance común y modo línea (arregla el tambaleo, confirmado por el usuario), el fix del ADC1 pegado, el retorno por odometría en `LOST_FWD`, la odometría de pose, y el resto de bugs de la auditoría. **Pendiente**: si se quiere reintentar mejorar el giro en el futuro, hacerlo de a un cambio por vez con validación completa antes del siguiente, no encadenar rediseños. | Usuario reportó que el giro terminó girando hacia ambos lados tras la cadena de rediseños de la sesión, y pidió explícitamente revertir a como estaba en tags/commits anteriores — la única corrección necesaria (escala del gyro) debía aplicarse con más cuidado, no como excusa para rediseñar todo el control de giro |
| 2026-07-05 | Core/Src/main.c | **Fix "ya no se cae nunca, pero se pasa media vuelta o más"**: el rediseño anterior (mismo día) reemplazó el freno por una rampa del pivot hacia **0** — eso solo deja de empujar, no frena de verdad; con el giro ahora rápido y consistente (arreglado en el mismo rediseño), la inercia sola alcanza para varios grados de más (hasta una vuelta completa). Fix: la rampa de la fase de freno ahora apunta a un **contra-torque proporcional a la velocidad de giro medida** (`-clamp(BRAKE_KP2 × rot_yaw_filt_dps, 0, BRAKE_MAX)`, nuevas `LROT_BRAKE_KP2=0.15`/`LROT_BRAKE_MAX=30`, sincronizadas en `MROT_*`) en vez de hacia 0 — un freno activo real. Sigue usando el mismo slew-rate (transición gradual, no un salto) por lo que no debería sentirse brusco pese a tener más autoridad que el freno chico anterior (±4); a medida que el giro realmente frena, `rot_yaw_filt_dps` baja y el contra-torque se afloja solo hasta casi 0. | Usuario confirmó que el giro ya no se cae pero se pasaba de largo (vuelta y media o más) — la rampa a 0 dejaba al robot girando por inercia sin frenado activo |
| 2026-07-05 | Core/Src/main.c | **Rediseño del giro de 180° tras 3/5 caídas — causa raíz de los 3 síntomas identificada**: la matemática de motores (`mR=-(pwm_sat+pivot)`, `mL=-(pwm_sat-pivot)`) tiene la propiedad de que la DIFERENCIA entre ruedas es siempre `2×pivot`, invariante a `pwm_sat` — pero si `pwm_sat` (el balance, que sigue variando todo el giro) tiene magnitud parecida o mayor al pivot, una rueda queda con poco torque real: el giro deja de ser "pivotear en el lugar" y se vuelve un arco desparejo. Esto explica los 3 síntomas reportados: arranques dispares (según el `pwm_sat` que había en ese instante — los arranques "suaves" que siempre terminaban en caída), correcciones constantes de potencia (`pwm_sat` fluctuando todo el tiempo), y el frenazo brusco (el pivot caía de golpe de hasta 50 a un valor de freno independiente cercano a 0 al cambiar de fase, en un solo ciclo). Fix: (1) pivot base más alto y constante — `LROT_PIVOT`/`MROT_PIVOT` 16→**24**, `PIVOT_MIN` 6→**16** (domina sobre `pwm_sat` en vez de competir); (2) ganancia de corrección mucho más chica — `RATE_KP` 0.10→**0.03** (el pivot ya no "corrige varias veces", el feedforward manda); (3) el feedforward mismo ahora escala con el `slowdown` (antes solo el término P), así la desaceleración sigue siendo suave con KP chico; (4) filtro de gyro más suave — `YAW_FILT_BETA` 0.35→**0.20** — y slew más gradual — `PIVOT_SLEW` 3.0→**2.0**; (5) el freno ya NO es un cálculo independiente (`BRAKE_KP × yaw`): ahora es una **rampa continua del mismo pivot hacia 0**, con el mismo slew-rate que el resto del giro — nunca puede saltar de golpe. Salida de la fase de freno: pivot casi en 0 (<2 PWM) Y giro casi detenido, o timeout/overshoot como colchón. `LROT_BRAKE`/`BRAKE_KP`/`BRAKE_DURATION` eliminadas (ya no aplican). | Usuario reportó 3/5 caídas: potencia inconsistente durante el giro y frenazo brusco al final, y notó que los arranques "suaves" siempre terminaban en caída — se identificó que ambos síntomas y el frenazo comparten la misma causa matemática (pivot compitiendo con pwm_sat en vez de dominarlo, y el freno saltando de valor en vez de rampear) |
| 2026-07-05 | Core/Src/main.c | **Revertido el clamp de pwm_sat (rompió más de lo que arregló) + fix real del "frena en el medio, dos giros de 90°"**: usuario confirmó que acotar `pwm_sat` a ±20 para combinarlo con el pivot empeoró el giro — el balance perdió autoridad justo cuando más la necesita durante el pivot, se desestabilizaba de verdad y "recuperaba" a mitad de camino, viéndose como dos giros separados. Revertido a `pwm_sat` real sin acotar en las 3 fases (LOST_ROTATE y banco MANUAL). Causa real encontrada del frenazo a mitad de giro: la fase 0 cortaba a los 85% del recorrido (`ENC_FRAC`) y saltaba a una fórmula de terminación con target de velocidad mucho más bajo (40% vs. lo que traía la rampa continua, que podía ser ~70%) **de un tirón** — ese salto discreto de target se sentía como un frenazo repentino a mitad de camino. Fix: eliminada la transición temprana (70% heading / 85% counts) y la fórmula de terminación separada; la fase 0 (con su rampa de `slowdown` continua, que ya de por sí reduce el target suavemente cerca del final) corre ahora hasta completar el 100% del recorrido por encoder — una sola curva de desaceleración sin saltos, y recién ahí entra el freno proporcional. Además, banco MANUAL: espera entre giros 2s→**3s** a pedido del usuario. | Usuario confirmó que el clamp de pwm_sat empeoró el giro (dos giros de 90° con frenazo en el medio) — se identificó el salto discreto de fórmula al 85% del recorrido como la causa real del frenazo, no la interacción con el balance |
| 2026-07-05 | Core/Src/main.c | **Fix "gira en tramos entrecortados, se cae 1 de cada 4"**: cada rueda durante el giro combina `pwm_sat` (salida del PID de balance, sigue activo mientras gira) con el `pivot` de rotación: `mR=-(pwm_sat+pivot)`, `mL=-(pwm_sat-pivot)`. Si el balance se perturba durante el pivot (torque asimétrico entre ruedas inclina el robot) y `pwm_sat` se dispara a una magnitud comparable o mayor al pivot, el signo neto de UNA rueda se invierte por un instante — esa rueda frena y arranca al revés, lo que se percibe como "tramos" y puede desestabilizar lo suficiente para tumbar el robot. Fix: se usa una versión acotada de `pwm_sat` (±20, nuevo `LROT_PWM_SAT_CLAMP`/`MROT_PWM_SAT_CLAMP`) SOLO para combinarla con el pivot en las 3 fases del giro (avance, terminación, freno) — el `pwm_sat` real usado por el integral/telemetría no se toca. Con esto ninguna rueda puede cruzar cero mientras gira, sin importar cuánto se perturbe el balance. Aplicado en `LOST_ROTATE` y banco MANUAL, sincronizados. `EDGE_ROTATE`/`PERP_ROTATE` sin tocar (pivot fijo, no usan el lazo de tasa todavía). | Usuario reportó mejora grande pero seguía viendo giros en tramos e inconsistentes, 1 de cada 4 con caída — se identificó la interacción entre el PID de balance y el pivot como causa |
| 2026-07-05 | Core/Src/main.c | **Fix "el giro da distintas potencias a lo largo del recorrido, se desestabiliza y llega mal posicionado al freno"**: el lazo de tasa de giro (agregado el mismo día) reaccionaba al gyro Z **crudo**, que tiene ruido de vibración de motores (mismo ruido que causaba el tambaleo en balance) — cada pico de ruido producía un salto de pivot ciclo a ciclo, en vez de una potencia estable. Fix con dos variables nuevas de file-scope compartidas entre `LOST_ROTATE`/banco MANUAL (mutuamente excluyentes): `rot_yaw_filt_dps` (EMA de la tasa de giro, β=0.35, actualizada una sola vez por ciclo y continua entre fase 0/1) y `rot_pivot_f` (el pivot de salida con **slew-rate**: no puede cambiar más de 3 PWM por ciclo de 10ms, sin importar qué tan grande sea el error del lazo). Reemplazado el uso de `fabsf(gz/100)` instantáneo por `rot_yaw_filt_dps` en las 3 fases (avance, terminación, freno) y en el chequeo de `yaw_settled`. Reset de ambas variables al iniciar cada giro (`obj_rot_initialized` 0→1) y en el bloque de caída. | Usuario confirmó que el giro y el freno mejoraron pero seguía viendo potencia inconsistente durante el recorrido — la causa era ruido de sensor sin filtrar realimentado directo al lazo de control |
| 2026-07-05 | Core/Src/main.c | **Fix "se cae al terminar el giro de 180°, lo desestabiliza el freno"**: con el lazo de tasa ya funcionando bien (feedback del usuario: "seteé bastante bien los parámetros del giro"), el robot llega a la fase de frenado final girando bastante lento — pero esa fase seguía aplicando un **torque fijo** (antes 4 PWM constante durante hasta 250ms) sin importar la velocidad real remanente, y frenar de más invierte el sentido de giro, tirando el balance de costado. Reemplazado por **freno proporcional a la velocidad de giro medida por gyro** (`BRAKE_KP × yaw_dps`, clamp `[0, BRAKE]`): a full giro frena hasta el tope, a giro casi detenido no frena nada — autolimitado, no puede sobrepasar ni invertir el giro. Agregada salida temprana de la fase de freno cuando el giro ya se asentó solo (`\|gz\|/100 < 20°/s`), en vez de esperar siempre los 250ms completos. Aplicado en banco MANUAL (`MROT_*`) y `LOST_ROTATE` (`LROT_*`), sincronizados. Nota: `MROT_RATE_DPS`/`PIVOT_MAX` quedaron en 260°/s y 50 tras el ajuste del usuario en el banco — replicado a `LROT_*`. | Usuario confirmó que el giro en sí ya está bien calibrado; el único problema remanente era el freno de cierre desestabilizando el balance |
| 2026-07-05 | Core/Src/main.c | **Giro de 180° con lazo cerrado de velocidad de giro** (banco MANUAL `MROT_*` y `LOST_ROTATE` `LROT_*`, idénticos): el pivot fijo daba giros inconsistentes — unos a plena potencia y otros casi sin girar — porque a lazo abierto pelea contra la fricción estática y contra el `pwm_sat` del balance (que sumado/restado al pivot puede dejar una rueda con comando ~0 → rueda muerta por stiction → giro flojo). Ahora `pivot = feedforward(16) + KP(0.10) × (tasa_objetivo − tasa_medida_por_gyro)`, clamp [6, 30]: si gira lento la potencia sube sola, si se embala baja sola — consistente ante batería/fricción/estado del balance. Tasa objetivo `RATE_DPS=160°/s`, reducida por el slowdown (piso 25%) cerca del final; fase de terminación con el mismo lazo a target 40%. Freno final sincronizado a **4** PWM (ajuste manual del usuario en el IDE, replicado de MROT a LROT). Usa la escala del gyro corregida (gz/100). `EDGE_ROTATE`/`PERP_ROTATE` siguen a lazo abierto hasta validar. | Usuario reportó giros de potencia aleatoria (unos completos, otros casi nulos) — síntoma clásico de lazo abierto contra stiction variable |
| 2026-07-05 | Core/Src/main.c | **Fix "tambalea/vibra mucho en balance común"**: otra secuela del fix de escala del gyro — la corrección de yaw de BALANCE_ONLY (`-gz_dps*0.3`) y el yaw-assist del modo línea (`gz_dps*0.3`) quedaron efectivamente 31% más fuertes al corregirse la escala, y el ruido de gz (vibración de motores), amplificado por la compensación de deadband (±8 PWM sobre cualquier comando ≠0), producía shimmy constante. Ambas ganancias bajadas 0.3→**0.23** (=0.3×100/131, restaura la ganancia efectiva calibrada). | El valor 0.3 estaba calibrado sobre la escala vieja del gyro; al corregir la escala había que reescalar la ganancia |
| 2026-07-05 | Core/Src/main.c | **Giro de 180° "muy lento y siempre se cae al final" (banco MANUAL)**: dos causas en los parámetros — (1) la fase de potencia plena terminaba al 60% del recorrido (`ENC_FRAC=0.60`) y el 40% restante (72°) lo hacía la fase de terminación débil, más el slowdown recortando 55° antes del final → giro larguísimo; (2) el freno final fijo de 16 PWM×400ms era excesivo con el robot ya frenado por el slowdown — rebotaba el giro en sentido contrario y lo tumbaba (riesgo ya señalado en la revisión del 2026-07-01). Cambios en `MROT_*` (banco MANUAL) y `LROT_*` (LOST_ROTATE), mantenidos idénticos: `ENC_FRAC` 0.60→**0.85**, `SLOWDOWN_DEG` 55→**40**, `PIVOT` 14→**16**, `BRAKE` 16→**8**, `BRAKE_DURATION` 400→**250ms**. `EDGE_ROTATE`/`PERP_ROTATE` sin tocar hasta validar estos valores en el banco. | Feedback del banco de pruebas de MANUAL: giros lentísimos y caída sistemática al final |
| 2026-07-05 | Core/Src/main.c | **Modo MANUAL reconvertido en banco de pruebas del giro de 180°** (reemplaza el banco de pruebas de reversa, eliminado junto con `MANUAL_REV_TEST_TILT`): con el joystick en reposo, balancea quieto 2s (upright + freno de encoders) y ejecuta un giro de 180° con EXACTAMENTE la misma lógica y constantes que `LOST_ROTATE` (`MROT_*` = copia de `LROT_*`: ENC_TARGET 880, PIVOT 14, BRAKE 16, fases, guiado solo por encoder, gyro solo para overshoot, potencia de terminación 0.7/0.5), en ciclo indefinido — lo que se calibre acá vale directo para el giro real del seguidor. Joystick en uso → control manual normal (cancela el ciclo y rearma la espera). Nuevas variables `manual_test_rot_active`/`manual_test_wait_ms` (reseteadas en entrada a MANUAL y en caída); reusa las `obj_rot_*` (MANUAL y LINE son mutuamente excluyentes). | Usuario reportó que el giro de 180° sigue fallando y pidió un ciclo de giros constante cada 2s en MANUAL para poder calibrarlo viéndolo repetirse |
| 2026-07-05 | Core/Src/main.c | **CAUSA RAÍZ REAL del "ADC1 pegado viendo línea para siempre" encontrada y corregida**: `UpdateADC_MovingAverage` leía `adcValues[ch]` (buffer escrito por DMA a 4 kHz) DOS veces — una para el acumulador `adcSum` y otra para la ventana `adcBuf`. Si el DMA escribía entre ambas lecturas (probable justo en transiciones rápidas blanco↔negro), lo sumado ≠ lo guardado, y al restar esa posición de la ventana después quedaba un **residuo permanente** en `adcSum` — promedio inflado para siempre. Explica todo el historial: por qué reiniciar ADC/DMA nunca lo arreglaba (el hardware estaba sano, la corrupción era el acumulador de software), por qué la recuperación periódica con `clear_buffers=0` tampoco (no toca `adcSum` a propósito), y por qué casi siempre ADC1 (rank 1, convierte pegado al trigger). Fix: eliminado el acumulador incremental — una sola lectura por canal y el promedio se recalcula desde la ventana completa cada vez (32 sumas/10ms, costo nulo). `adcSum` eliminada. La recuperación periódica de ADC (3s) queda como defensa extra pero ya no debería ser necesaria para este síntoma. | Bug reportado repetidamente ("nunca se resolvió"); el fix anterior (2026-07-04, reinicio preventivo del DMA) atacaba el hardware cuando el problema era una carrera de lectura en el software del promedio móvil |
| 2026-07-05 | Core/Src/main.c | **Fix "el giro de 180° quedó lento y a pulsos (gira-frena-gira) hasta caerse"** — regresión de la corrección de escala del gyro (2026-07-04): los giros usaban `max(heading_gyro, heading_encoder)` y toda la calibración (targets, umbrales de fase, rampas) se hizo con el gyro sub-leyendo 24%; con el gyro corregido, el `max` adelantaba el pase a la fase 1 de terminación, cuya potencia débil (`PIVOT*0.4`, piso 0.2 → ~1-5 PWM) hacía la mayor parte del giro trabándose por fricción estática. Fix en los 3 giros (`LOST_ROTATE`/`EDGE_ROTATE`/`PERP_ROTATE`): (1) el heading de control es SOLO el del encoder (la fuente calibrada); el gyro queda únicamente para la detección de overshoot. (2) Potencia de la fase de terminación subida: `PIVOT*0.4`/piso 0.2 → `PIVOT*0.7`/piso 0.5 (~5-10 PWM) para que no se trabe arrancando ahora que el giro empieza desde parado de verdad (gate de quietud sostenida del mismo día). | Usuario preguntó si se había tocado la potencia del giro; no — la regresión venía del cambio de escala del gyro interactuando con una calibración empírica hecha con la escala vieja |
| 2026-07-05 | Core/Src/main.c | **Fix "sigue cayéndose en el giro de 180°" — el deadband en los gates de quietud (fix del 2026-07-04) era un error**: restar `BRAKE_VEL_DEADBAND=0.35` antes de comparar corría el umbral efectivo — `LOST_BRAKE` con "<0.15" salía del frenado con hasta **0.5 m/s reales** y el robot arrancaba el pivot rodando rápido → caída. Reemplazado por el enfoque correcto contra el ruido de cuantización: **velocidad CRUDA sostenida N ciclos** — `LOST_BRAKE`/`EDGE_WAIT` ahora exigen `\|velocity_est_f\| < 0.25` m/s durante 15 ciclos consecutivos (150ms, contador nuevo `line_quiet_cycles`, reseteado en entradas y caída); un pico de cuantización aislado solo resetea el contador un instante, y un robot rodando no puede mantenerla baja 150ms. Timeouts de colchón 1500→2500ms (frenar desde crucero tarda más). `LOST_SETTLE`/`EDGE_SETTLE`/`OBJ_BRAKE` vueltos a velocidad cruda con umbrales corregidos (0.25/0.25/0.15). Además, umbral de confirmación de pérdida en FOLLOWING 300→**150ms** — frenar aún antes para llegar al giro con la menor velocidad posible. | Usuario reportó que seguía cayéndose en el giro de 180° pese al fix del boost; el análisis reveló que el "fix de consistencia" del deadband había aflojado el gate de quietud en vez de endurecerlo |
| 2026-07-05 | Core/Src/main.c | **Fix "frena tan brusco al perder la línea que vuelca el robot"**: efecto colateral del disparo de pérdida adelantado a 300ms (mismo día) — antes el freno de `LOST_BRAKE`/`EDGE_WAIT` entraba con el robot ya desacelerado tras 1s de planeo, y el boost `LOST_BRAKE_BOOST=1.6` (agregado 2026-07-01 justamente porque ese freno tardío se sentía débil) era tolerable; con el freno entrando a velocidad de crucero plena y el robot aún inclinado hacia adelante, el tirón de 1.6× lo volcaba. `LOST_BRAKE_BOOST` 1.6→**1.0** (freno estándar de balance). Si queda corto, subir de a 0.1 — no volver a 1.6. | El boost compensaba un freno que llegaba tarde; al arreglar la tardanza, el boost pasó a ser excesivo |
| 2026-07-05 | Core/Src/main.c | **Fix definitivo del "giro fantasma de 90° al apoyar el robot viniendo del aire"** (`PERP_ROTATE`): el fix anterior (accel quieto 400ms) tenía dos agujeros — sosteniendo el robot firme en el aire el acelerómetro califica como "quieto", y en el aire `all_black` implica `line_detected` así que el timer de línea tampoco discrimina. Dos guardas nuevas en el disparo: (1) `all_black_elapsed < PERP_MAX_ELAPSED_MS=800ms` — un cruce real dura poco; viniendo del aire los 4 sensores llevan segundos en negro y queda bloqueado hasta que alguno vea blanco (lo que resetea el timer). (2) el todo-negro debe haber empezado a menos de `PERP_PARTIAL_WIN_MS=400ms` de la última "vista parcial" real (`last_partial_line_ms`, nuevo: línea detectada SIN los 4 sensores en negro — físicamente imposible en el aire). Un cruce perpendicular real cumple ambas: venía viendo línea parcial y el todo-negro es fresco. `last_partial_line_ms` se resetea al entrar al modo línea. | Usuario reportó que al apoyar el robot sobre la línea viniendo del aire SIEMPRE giraba 90° a la derecha, incluso la primera vez |
| 2026-07-05 | Core/Src/main.c | **Tres ajustes al retorno por odometría tras prueba en el robot**: (1) `LOST_FWD_TIMEOUT` 5000→**10000ms** — muy poco tiempo de búsqueda avanzando. (2) `LOST_RETURN_STEER_KP` 0.6→**1.5** y `LOST_RETURN_STEER_MAX` 12→**20** — "casi no corrige hacia el lado donde se perdió la línea"; además el formato compartido de motores aplica `half_steer=steering*0.5`, así que el efecto real por rueda era la mitad de lo nominal (documentado en el comentario de las constantes). (3) Umbral de confirmación de pérdida en FOLLOWING `ms_sin_linea > 1000` → **300ms** — frenar apenas se confirma la pérdida para no alejarse tanto del punto (~70cm menos a 1 m/s); 300ms sigue filtrando parpadeos de sensor. OJO: este umbral es compartido con el disparo del camino EDGE (pérdida por extremo), que ahora también reacciona antes. | Feedback del usuario tras probar el retorno: poco tiempo, poca corrección de rumbo, y frenaba demasiado tarde al perder la línea |
| 2026-07-04 | Core/Src/main.c | **Fix "VUELVE se queda totalmente detenido"**: usuario confirmó que el giro de 180° anda bien pero en el retorno por odometría el robot no arrancaba. Causa: `LOST_FWD_ANGLE_MAX=1.0°` y `LOST_FWD_SPEED_TARGET=0.18 m/s` (valores conservadores heredados del avance "a ciegas", bajados en su momento porque se aceleraba demasiado) — 1° de techo, atenuado además por la soft-zone del PID de balance con error chico, no vence la fricción estática (mismo patrón que el bug histórico de `OBJ_REVERSE` "no le da el ángulo"). Subidos: `LOST_FWD_SPEED_TARGET` 0.18→**0.40 m/s**, `LOST_FWD_ANGLE_MAX` 1.0→**2.5°**. Nota: estos valores también aplican a `EDGE_FWD` (comparten constantes) — vigilar que el avance post-giro de 45° no quede demasiado rápido; si molesta, separar constantes. | Con navegación a un punto conocido ya no hace falta el avance ultra-cauteloso; el techo de 1° directamente no movía el robot |
| 2026-07-04 | Core/Src/main.c | **Retorno por odometría al punto de pérdida de línea (camino "centrado")**: mientras sigue la línea, cada ciclo se guarda la pose actual en `line_loss_x_m`/`line_loss_y_m` (`line_loss_pose_valid`). Al perder la línea por el centro y completar el giro de 180°, `LOST_FWD` ya no avanza a ciegas: navega hacia esa pose guardada con steering P sobre el error de rumbo (`bearing = atan2(dy,dx)` vs `odom_theta_deg`, error normalizado a ±180°), `LOST_RETURN_STEER_KP=0.6` PWM/°, clamp `LOST_RETURN_STEER_MAX=12`. La velocidad la sigue regulando el PI existente (`LOST_FWD_*`). Salidas: línea → FOLLOWING (igual que antes); distancia al punto < `LOST_RETURN_REACHED_M=0.10m` sin línea → GIVEN_UP; timeout 5s queda como colchón. Snapshot invalidado al entrar al modo línea (el origen odométrico se resetea ahí). Display de LOST_FWD: "AVNZA"→"VUELVE". **Signo del steering derivado de `ODOM_THETA_SIGN`** (steering positivo genera gz negativo, convención del amortiguador `gz*0.3`): si en el robot curva alejándose del punto, verificar primero `ODOM_THETA_SIGN` con el test del giro de 90°, y si theta está bien, invertir el signo de `LOST_RETURN_STEER_KP`. El camino EDGE (pérdida por un extremo) no se tocó. | Usuario pidió usar la odometría nueva para volver al punto exacto donde se perdió la línea en vez del avance ciego con timeout |
| 2026-07-04 | Core/Src/main.c, Core/Inc/UNER.h, Core/Src/UNER.c | **ODOMETRÍA DE POSE (x, y, θ) — desarrollo nuevo**: integración a 100 Hz en `ControlStep10ms` — distancia por promedio de encoders (misma escala `ENC_CPR`/`ENC_VEL_SCALE` que `velocity_est`), rumbo por gyro Z integrado (menos sensible al slip que el diferencial de encoders). Variables `odom_x_m`/`odom_y_m`/`odom_theta_deg` (θ normalizado a (-180,180]); `ODOM_THETA_SIGN=+1.0` a verificar en el robot (si girar a la DERECHA hace θ más positivo, invertir a -1). No integra durante caídas (`f_fallen`). Origen (0,0,0°) se resetea al entrar a cualquier modo (BALANCE/LINE/MANUAL/IDLE) o con el comando nuevo `RESET_ODOMETRY`. **2 comandos UNER nuevos**: `GET_ODOMETRY=0xDA` (responde 3 floats LE: x[m], y[m], θ[°]) y `RESET_ODOMETRY=0xDB` (ACK). **Impacto en Qt**: para usarla hay que agregar los handlers de 0xDA/0xDB en `serialmanager.cpp` (o el equivalente UDP) — mientras no se agreguen, no pasa nada (comandos aditivos, no rompen lo existente). | Usuario pidió agregar odometría de pose como base para navegación futura (volver al punto donde se perdió la línea, esquives por trayectoria) |
| 2026-07-04 | Core/Src/main.c, Core/Src/UNER.c, Core/Inc/UNER.h, Core/Src/ESP01.c, Core/Src/MPU6050.c | **Barrida de bugs de auditoría completa (9 fixes + limpieza)**: (1) **Escala del gyro Z corregida**: `MPU6050.c` entrega gyro en centi-°/s (`raw*100/131`), pero los giros (LOST/EDGE/PERP/OBJ_ROTATE) y el yaw-assist usaban `gz/131` → leían solo el 76% del ángulo real; corregido a `gz/100` en los 6 lugares. Efecto esperado: el heading por gyro ahora es fiel (las transiciones de fase de giro pueden dispararse un poco antes; la salida sigue gobernada por encoder) y el amortiguador de yaw queda ~31% más fuerte — vigilar en el robot. (2) `usb_service_tx`: `chunk[64]` pasado a `static` — era stack pasado a `CDC_Transmit_FS` asíncrono (corrupción latente de toda la telemetría USB). (3) `UNER_SendData`: el camino USB no manejaba el wrap del ring buffer (tramas que cruzaban el final del buffer de 256 llegaban corruptas a Qt); ahora copia con wrap igual que `UNER_SendSerial`. Además se eliminaron los resets de `indexW/indexR` en `UNER_SendAllSensors`/`SendWifiLogData`/`SendLogData` que pisaban respuestas pendientes. (4) Nuevo `HAL_UART_ErrorCallback`: un overrun (ORE) en USART1 abortaba la recepción IT y el RX del ESP-01 quedaba muerto hasta reset; ahora limpia el flag y rearma. (5) Parser UNER: trama con `nBytes<2` hacía underflow a 255 en PAYLOAD y se tragaba 255 bytes; ahora se valida en NBYTES. (6) Watchdog de reconexión del ESP01: `ESP01_Task` corre cada 100ms (subtick 0), no cada 10ms — el umbral 2000 eran 200 s reales; bajado a 200 (=20 s). (7) Deadband de cuantización de encoders (`apply_deadbandf`) aplicado a las 5 esperas de quietud que faltaban: `LOST_BRAKE`, `EDGE_WAIT`, `LOST_SETTLE`, `EDGE_SETTLE`, `OBJ_BRAKE` (mismo bug ya arreglado el mismo día en OBJ_PRE_REVERSE_HOLD/pared). (8) Guard de `dt_real`: `micros()` envuelve cada ~44.7 s y metía un valor basura en la telemetría una vez por wrap. (9) Limpieza: `sendAllSensors` y `line_lost_entered_ms` (variables muertas) eliminadas, declaración duplicada de `espUSBBuf`/`espUSBBufIw/Ir` eliminada, chequeos muertos de `f_fallen` en LOST_FWD/EDGE_FWD removidos, comentarios desactualizados corregidos (debounce 100ms no 30ms, ventana ADC real 40ms no 3.75ms, sample rate MPU 100Hz no 200Hz, comentario de `REV_STRAIGHT_KP` actualizado al valor real -1.0). | Auditoría completa del firmware pedida por el usuario; todos los hallazgos con fix directo aplicados en la misma sesión |
| 2026-07-04 | Core/Src/main.c | **Nuevo estado `LINE_STATE_OBJ_WALL_CLEAR`**: al perder la pared en `OBJ_WALL_FWD` (`ADC7 >= OBJ_WALL_THRESHOLD`), en vez de pasar directo a girar (`OBJ_WALL_TURN`), ahora avanza `OBJ_WALL_CLEAR_COUNTS=100` counts de encoder más (mismo PI de velocidad y misma reversa/pivot de seguridad que `OBJ_WALL_FWD` si en el medio se acerca demasiado) antes de girar — para no quedar pivoteando pegado a la esquina/pared. Display: "LIBRE". Nuevas variables `obj_wall_clear_initialized`/`obj_wall_clear_r0`/`obj_wall_clear_l0` (snapshot de encoders, reseteadas en el bloque de caída). Agregado a la exclusión del limitador global de velocidad y a la lista de corrección yaw por gyro. **Fix de bug encontrado de paso**: la corrección de rumbo por gyro (aplicada cuando `line_pivot_active==0`) se activaba para `LINE_STATE_OBJ_WALL_FWD` sin chequear si `steering_adjustment` ya tenía la corrección real de la reversa pareja calculada — la pisaba en silencio. Ahora esa lista solo aplica si además `steering_adjustment == 0.0f` (es decir, el estado dejó el steering neutro a propósito para que el gyro lo asista, no cuando hay una corrección real activa). | Usuario pidió avanzar un poco más al perder la pared antes de girar, para no chocar la esquina; en el camino se encontró que la corrección de reversa dentro de `OBJ_WALL_FWD` podía estar siendo anulada silenciosamente por el asistente de rumbo por gyro |
| 2026-07-04 | Core/Src/main.c | **Freno más robusto en modo pared**: `OBJ_WALL_VEL_KP_BRAKE` 14→**22** (reacciona más fuerte a sobrevelocidad), `OBJ_WALL_BRAKE_ANGLE` 2.0→**4.0°** (más autoridad de frenado). Además, se encontró que el limitador global de velocidad (pensado para excluir estados que ya regulan su propia velocidad) no excluía a `OBJ_WALL_FWD`/`OBJ_WALL_APPROACH` — competía contra su PI propio comparando contra `LINE_SPEED_TARGET` (el target del seguidor de línea normal, no el de pared), quedó desactualizado al agregarles su propio control. Agregados a la exclusión. | Usuario reportó que a veces se sigue acelerando demasiado en modo pared pese al PI; el freno del PI era débil y además competía sin sentido con un limitador pensado para otro target de velocidad |
| 2026-07-04 | Core/Src/main.c | **`LINE_STATE_OBJ_WALL_APPROACH` sin control de velocidad** (encontrado en auditoría pedida por el usuario sobre qué estados sin línea regulan velocidad): usaba ángulo fijo `OBJ_WALL_APPROACH_ANGLE=2.0°` sin PI ni freno, mismo patrón que ya causaba aceleración descontrolada en otros estados antes de arreglarlos. Reemplazado por el mismo PI que `OBJ_WALL_FWD` (reutiliza `obj_wall_vel_integral`/`OBJ_WALL_VEL_KP`/`KP_BRAKE`/`KI`/`I_MAX`), con target más cauteloso `OBJ_WALL_APPROACH_SPEED_TARGET=0.3 m/s` y techo `OBJ_WALL_APPROACH_ANGLE_MAX=1.5°` (nuevas constantes; se eliminó `OBJ_WALL_APPROACH_ANGLE`). | Usuario preguntó si todos los estados sin línea controlaban velocidad; auditoría reveló que `OBJ_WALL_APPROACH` (avance post-giro buscando la pared) era el único que quedaba sin arreglar de ese patrón |
| 2026-07-04 | Core/Src/main.c | Ajuste de umbrales de `OBJ_WALL_FWD`/`OBJ_WALL_TURN`: `OBJ_WALL_REVERSE_THOLD` 300→**600** (ADC7 por debajo → reversa pareja), `OBJ_WALL_TOO_CLOSE_THOLD` 1200→1600→**2100** (ADC7 entre 600 y 2100 → pivot derecha). | Usuario pidió umbrales más altos para reversa/pivot, ajustado en dos pasos |
| 2026-07-04 | Core/Src/main.c | **Fix: la espera de quietud antes de retroceder (obstáculo y pared) no esperaba nada en la práctica**. Tanto `OBJ_PRE_REVERSE_HOLD` (0.10 m/s) como la espera de `OBJ_WALL_FWD`/`OBJ_WALL_TURN` (`OBJ_WALL_REVERSE_SETTLE_VEL=0.15 m/s`) comparaban contra `velocity_est_f` **sin filtrar** — pero esa velocidad cruda por encoders tiene un piso de ruido de cuantización de ~0.32-0.63 m/s (ver `BRAKE_VEL_DEADBAND`) aun con el robot totalmente quieto. Con umbrales de 0.10-0.15, la condición "está quieto" prácticamente nunca se cumplía, y ambas esperas caían siempre al timeout de seguridad y avanzaban igual — daba la impresión de que la pausa "no hacía nada". Filtrado con el mismo `apply_deadbandf(velocity_est_f, BRAKE_VEL_DEADBAND)` que ya usa el resto del código para este problema, en los tres puntos donde se compara (`OBJ_PRE_REVERSE_HOLD` y las dos ramas de wall-following). | Usuario reportó que la reversa arrancaba igual aunque el robot siguiera moviéndose; el umbral de velocidad estaba por debajo del piso de ruido real del sensor, un problema ya documentado y resuelto en otros lugares del código pero no replicado acá |
| 2026-07-04 | Core/Src/main.c | **`LINE_STATE_OBJ_PRE_REVERSE_HOLD` (pausa antes de retroceder al ver objeto) — ahora exige estabilidad real, no solo tiempo fijo**: antes salía únicamente por `OBJ_PRE_REVERSE_HOLD_MS=1000ms` de reloj, sin chequear si el robot realmente estaba quieto. Mismo patrón que `LOST_SETTLE`: sale por tiempo mínimo (1000ms) **Y** velocidad/inclinación estabilizadas (`OBJ_PRE_REVERSE_VEL_THR=0.10 m/s`, `OBJ_PRE_REVERSE_TILT_THR=3.0°`), con `OBJ_PRE_REVERSE_TIMEOUT=2500ms` como colchón de seguridad (no un corte normal) por si nunca llega a asentarse del todo. | Usuario pidió corregir la pausa previa al retroceso; el tiempo fijo no garantizaba que el robot estuviera realmente quieto antes de arrancar la reversa |
| 2026-07-04 | Core/Src/main.c | **ADC1 queda pegado en un valor alto para siempre después de ver negro real** — usuario confirmó que el baseline de calibración está bien (mide 2000 sobre blanco, igual al calibrado), así que no es un problema de calibración: después de un cruce real por línea negra, ADC1 se queda pinneado arriba (barra del display al tope) y nunca vuelve a bajar por sí solo, ni con el watchdog existente (`ADC1_Recover`, dispara solo si TODA la transferencia DMA de 8 canales se frena — si los otros 7 canales siguen actualizando, nunca detecta que uno solo quedó trabado). Fix: `ADC1_Recover` ahora recibe un parámetro `clear_buffers` — se agregó una recuperación **preventiva cada 3000ms** (`Core/Src/main.c`, bloque `is10ms`) que reinicia el hardware DMA/ADC sin necesidad de detectar la falla primero. Con `clear_buffers=0` en el barrido periódico (a diferencia de la recuperación por falla real, que sigue limpiando `adcSum`/`adcBuf`/`adcAvg` a 0), no se genera un bache de "todo blanco" cada vez que corre — el promedio móvil sigue con sus últimos valores válidos mientras el hardware se reinicia en microsegundos. | El mecanismo de recuperación existente estaba diseñado para detectar un freeze total del DMA, no un canal individual trabado en un valor fijo — un reinicio de rutina del periférico, sin tocar los buffers de software, es la forma más simple y de bajo riesgo de cubrir ese caso sin tener que implementar detección de canal congelado |
| 2026-07-04 | Core/Src/main.c | Ajuste de velocidad y umbrales de `OBJ_WALL_FWD`/`OBJ_WALL_TURN`: `OBJ_WALL_SPEED_TARGET` 0.4→**1.0 m/s**, `OBJ_WALL_REVERSE_THOLD` 250→**300** (ADC7 por debajo → reversa pareja), `OBJ_WALL_TOO_CLOSE_THOLD` 550→**1200** (ADC7 entre 300 y 1200 → pivot derecha). `OBJ_WALL_FWD_ANGLE` (3.5°) sin tocar — con el target tan alto puede terminar saturando contra ese techo sin llegar a 1.0 m/s, a confirmar en el robot. | Usuario pidió más velocidad de crucero y umbrales de reversa/pivot más amplios |
| 2026-07-04 | Core/Src/main.c | **Fix de giro de 90° falso al apoyar el robot recién levantado**: `LINE_STATE_PERP_ROTATE` (cruce perpendicular) exigía solo 50ms de "todos los sensores en negro sin manipular" — pero el timer `all_black_start_ms` venía arrastrando segundos acumulados desde que el robot estaba en el aire (ahí también lee "negro" al no haber superficie debajo). Apenas el acelerómetro dejaba de moverse (al apoyarlo), si en ese instante seguía viendo negro (punto de partida, mesa oscura, etc.) disparaba el giro de 90° al toque. Agregada una exigencia de quietud continua del acelerómetro (`ACCEL_SETTLE_MS=400ms`, nueva variable `accel_settled_start_ms`) antes de habilitar el disparo de `PERP_ROTATE` — recién dispara si además de ver negro sin manipulación, pasaron 400ms desde que se dejó de mover el acelerómetro. | Usuario reportó que apoyar el robot después de levantarlo siempre giraba 90° aunque no todos los sensores vieran negro en ese momento — el timer heredado del tiempo en el aire disparaba antes de que las lecturas reflejaran la superficie real |
| 2026-07-04 | Core/Src/main.c | **`OBJ_WALL_FWD`/`OBJ_WALL_TURN` — espera de estabilidad antes de la reversa por pared**: si al detectar `ADC7 < OBJ_WALL_REVERSE_THOLD` el robot todavía tiene velocidad residual de avance (`\|velocity_est_f\| > OBJ_WALL_REVERSE_SETTLE_VEL=0.15`), ahora frena primero (upright + freno de encoders, `ComputeBrakeSetpointTarget`) en vez de arrancar la inclinación de reversa de golpe con inercia hacia adelante — mismo patrón que `OBJ_PRE_REVERSE_HOLD` en la reversa por obstáculo. Además, ajuste de valores tras prueba en el robot: `OBJ_WALL_FWD_ANGLE` 2.5→**3.5°** (2.5 seguía quedando corto para avanzar) y `OBJ_WALL_SPEED_TARGET` 0.18→**0.4 m/s**. | Usuario pidió más quietud antes de iniciar la reversa por pared para no entorpecerla con inercia, y reportó que el ángulo de avance seguía quedando corto |
| 2026-07-04 | Core/Src/main.c | Ajuste de velocidad de `OBJ_WALL_FWD` tras el PI nuevo: `OBJ_WALL_SPEED_TARGET` 0.18→**0.4 m/s**, `OBJ_WALL_FWD_ANGLE` 1.0→**2.5°** (1.0° era muy poco para avanzar). | Usuario pidió más velocidad/ángulo que los valores iniciales conservadores del PI |
| 2026-07-04 | Core/Src/main.c | **Fix de "gira en círculos al entrar en modo línea"**: no era el ADC — el timer `all_black_start_ms` (usado para detectar cruce perpendicular, `LINE_STATE_PERP_ROTATE`) nunca se reseteaba ni al terminar ese giro de 90° ni al entrar al modo LINE_FOLLOWING. Si después del giro los 4 sensores seguían en negro (no había línea real debajo), el timer ya vencido re-disparaba otro `PERP_ROTATE` en el ciclo inmediato siguiente, y así indefinidamente. Agregado `all_black_start_ms = 0` en ambos puntos (fin de `PERP_ROTATE` ~línea 3895, entrada a modo LINE_FOLLOWING ~línea 2669). | Usuario reportó giro en círculos al entrar en modo línea sin línea real debajo; atribuido inicialmente a un ADC "trabado" pero el ADC no tenía nada que ver |
| 2026-07-04 | Core/Src/main.c | **`OBJ_WALL_FWD` (bordeando pared) — velocidad mucho más controlada**: reemplazado el ángulo fijo (`OBJ_WALL_FWD_ANGLE=4.5°`) + freno bang-bang por sobrevelocidad (`OBJ_WALL_OVERSPEED_VEL=0.90`, eliminada) por el mismo patrón de PI de velocidad que ya se usa en `LOST_FWD`/`EDGE_FWD`: `OBJ_WALL_SPEED_TARGET=0.18` m/s, `OBJ_WALL_VEL_KP=4.0`/`KP_BRAKE=14.0`, `OBJ_WALL_VEL_KI=1.0`/`I_MAX=1.0` con anti-windup, techo de ángulo bajado `OBJ_WALL_FWD_ANGLE` 4.5→**1.0°**, freno `OBJ_WALL_BRAKE_ANGLE` 1.0→2.0°. Nueva variable `obj_wall_vel_integral` (reseteada al entrar a `OBJ_WALL_FWD` desde `OBJ_WALL_APPROACH` o `OBJ_WALL_TURN`, y en el bloque de caída). | Usuario reportó que se acelera "una locura" bordeando la pared; el ángulo fijo saturaba contra el techo desde el primer ciclo de error, igual que el bug ya arreglado antes en `LOST_FWD`/`EDGE_FWD` |
| 2026-07-04 | Core/Src/main.c | **Wall-following (`OBJ_WALL_FWD`/`OBJ_WALL_TURN`) — reversa pareja si la pared está muy cerca**: antes, `ADC7 < OBJ_WALL_TOO_CLOSE_THOLD (500)` siempre pivoteaba a la derecha. Ahora hay dos umbrales: `ADC7 < OBJ_WALL_REVERSE_THOLD (250)` → retrocede usando el mismo corrector P de rumbo ya calibrado en `LINE_STATE_OBJ_REVERSE`/banco de pruebas de MANUAL (`REV_STRAIGHT_KP/MAX/SLEW`, misma variable de estado `obj_rev_steer_f`) — reutiliza directamente los valores ya afinados, sin duplicar lógica. `ADC7` entre 250 y `OBJ_WALL_TOO_CLOSE_THOLD` (subido de 500 a **550**) → pivot derecha, igual que antes. El setpoint de inclinación para la reversa (`OBJ_WALL_REVERSE_ANGLE=3.0°`) se agregó en el bloque de setpoints para ambos estados. Durante la reversa, `line_pivot_active` queda en 0 para que el formato compartido de motores (`half_steer=steering_adjustment*0.5`) aplique la corrección, en vez de escribir motores directo como hacen los pivots. | Usuario pidió que, en vez de solo girar cuando el sensor lateral ve la pared demasiado cerca, el robot retroceda derecho usando el mismo algoritmo de reversa ya calibrado, y deje el pivot solo para el rango intermedio |
| 2026-07-04 | Core/Src/main.c | **Reversa — simplificación completa desde cero (v10)**: pese al fix de `lroundf` (truncado a cero), la rueda izquierda seguía sin moverse en el banco de pruebas de MANUAL. Usuario confirmó que en modo balance normal ambas ruedas responden bien, descartando causa de hardware, y pidió repensar la lógica de reversa de la forma más simple posible e ir agregando complejidad de a poco. Se eliminó por completo el esquema de fracción de `pwm_sat` (v8/v9: `LINE_OBJ_REV_RATE_KP/KI/I_MAX`, `LINE_OBJ_REV_FRAC_MAX`, `LINE_OBJ_REV_STEER_SLEW`, variable `obj_rev_rate_integral`) y se reemplazó por un **P simple, sin integral, en PWM absoluto** (mismas unidades que `steering_adjustment`/`pwm_sat`, no una fracción): `REV_STRAIGHT_KP` (ganancia, arranca en **0.0** — paso 0, sin corrección, ambas ruedas reciben literalmente el mismo `pwm_sat`), `REV_STRAIGHT_MAX=8.0` (tope absoluto chico, no puede acercarse a `pwm_sat`), `REV_STRAIGHT_SLEW=2.0` (rampa). Aplicado igual en `LINE_STATE_OBJ_REVERSE` (rama sin línea) y en el banco de pruebas de MANUAL. Con `KP=0` el primer paso es puramente de diagnóstico: confirmar en el robot que ambas ruedas giran igual sin ninguna corrección; recién después subir `REV_STRAIGHT_KP` de a poco (2, 4, 6...) hasta que enderece, sin pasarse de un valor que empiece a notarse forzado. La variable `obj_rev_steer_f` cambió de semántica otra vez: ya no es una fracción, es la corrección rampeada en PWM absoluto — por eso ahora SÍ se puede sincronizar directamente con `steering_adjustment` en la rama con línea detectada (antes, con la fracción, sincronizarlas rompía la escala; con ambas en PWM absoluto no hay problema). | Dos rediseños seguidos (fracción v8, luego el fix de truncado v9-bis) no resolvieron el síntoma reportado — momento de simplificar al mínimo posible y verificar el caso base (sin corrección) antes de reintroducir cualquier lógica, en vez de seguir agregando mecanismos sobre una base no verificada |
| 2026-07-04 | Core/Src/main.c | **Bug real encontrado: motor izquierdo en 0 pase lo que pase con `MOTOR_LEFT_DEADBAND`**. Usuario subió mucho el deadband y el motor izquierdo seguía sin moverse — no era un problema de zona muerta. Causa: los casts `(int16_t)mL` / `(int16_t)mR` (4 lugares: fórmula compartida de `LINE_FOLLOWING`, banco de pruebas de MANUAL, camino normal de balance) truncan hacia cero en C, no redondean. Con la corrección de reversa reduciendo mucho una rueda (más con `FRAC_MAX` alto), el valor flotante de esa rueda podía quedar en ~0.4-0.6 y truncar a 0 exacto. Con comando=0, el bloque de compensación de deadband (`if (mL_comp > 0) ... else if (mL_comp < 0) ...`) nunca se activa — ningún valor de `MOTOR_LEFT_DEADBAND` puede arreglar un 0 literal. Fix: los 4 casts cambiados de truncado a `lroundf` (`(int16_t)lroundf(mL)`). Esto también explica por qué subir `FRAC_MAX` (0.6→0.8) empeoraba el síntoma en vez de mejorarlo: más reducción de la rueda floja = más probabilidad de caer en la zona de truncado a cero. | El síntoma "no se mueve ni con deadband grande" no encajaba con ningún ajuste de ganancia/fracción — apuntaba a que el comando nunca llegaba a ser distinto de cero en el punto donde se aplica la compensación, no a que la compensación fuera insuficiente |
| 2026-07-04 | Core/Src/main.c | **Ajuste de `LINE_OBJ_REV_FRAC_MAX` (v9) — rueda izquierda quedaba parada con el rediseño v8**. El giro en círculos desapareció (la garantía estructural de v8 se cumplió: `mR`/`mL` nunca invirtieron signo), pero con `FRAC_MAX=0.6` la asimetría permitida es tan grande (`mR`/`mL` hasta 1.6/0.4 = 4x) que, a la magnitud típica de `pwm_sat` durante esta reversa suave (`MANUAL_REV_TEST_TILT=4°`, `pwm_sat` de pocos PWM en crucero), el lado reducido caía por debajo de la zona muerta **mecánica real** del motor (fricción/stiction — no modelada en software más allá del offset fijo de ±1 de `MOTOR_LEFT/RIGHT_DEADBAND`, insuficiente para esto) y ese motor dejaba de girar del todo, aunque el PWM pedido matemáticamente no fuera cero. La garantía de signo de v8 sigue intacta (no puede volver a girar en círculos con ninguna ganancia); lo que cambió es cuánta asimetría es *físicamente* utilizable antes de que una rueda deje de moverse. Bajado `LINE_OBJ_REV_FRAC_MAX` 0.6→**0.30** (ratio máximo ~1.86x en vez de 4x) y `LINE_OBJ_REV_RATE_KP`/`KI` reducidos en proporción (3.0→1.5 / 1.0→0.4, más `I_MAX` 1.0→0.8) para no saturar el nuevo tope al instante con cualquier ruido de sensor. Si con 0.30 la rueda floja sigue casi detenida, el problema es puramente físico (zona muerta real más alta de lo esperado) y hay que seguir bajando `FRAC_MAX`, o subir `MANUAL_REV_TEST_TILT` para tener más `pwm_sat` de base y así más margen absoluto para ambos lados; si con 0.30 ya no corrige lo suficiente, subir `KP`/`KI` (nunca `FRAC_MAX` más allá del punto donde deje de mover alguna rueda). | Confirma que el rediseño estructural (v8) resolvió el problema que se buscaba resolver (giro en círculos); lo que sigue ajustando ahora es una interacción con un límite físico real del hardware (zona muerta del motor), no un bug de lógica |
| 2026-07-04 | Core/Src/main.c | **Rediseño completo de la corrección de reversa (v8) — el robot giraba en círculos con v7**. Usuario pidió replantear la lógica en vez de seguir ajustando ganancia/signo sobre el mismo diseño. Diagnóstico de fondo (más allá del signo, ya corregido en v7): la corrección se expresaba como un valor **absoluto** de steering (grados/PWM) con un clamp (`LINE_OBJ_REV_STEER_MAX_NOLINE`) totalmente independiente de `pwm_sat` (el comando de avance real, típicamente ~10-25 durante una reversa suave). Con ganancia alta, la corrección podía superar ampliamente a `pwm_sat` e invertir el sentido de giro de una rueda — eso ya explicaba el zigzag de v4, y con el clamp/ganancia aún más altos de v6/v7 pasó a invertir por completo una rueda de forma sostenida, produciendo giro en círculos en vez de reversa. Ningún valor de ganancia podía ser "correcto" sobre ese diseño porque su autoridad no tenía relación con la intensidad del comando que debía corregir. **Rediseño**: la corrección ahora se expresa como una **fracción de `pwm_sat`** (no un valor absoluto), acotada a `±LINE_OBJ_REV_FRAC_MAX=0.6` (<1.0 por diseño). Con `half_steer = frac·pwm_sat`, `mR = pwm_sat·(1-frac)`, `mL = pwm_sat·(1+frac)`, y `frac` siempre estrictamente entre -1 y 1, `mR`/`mL` **nunca pueden cambiar de signo** respecto a `pwm_sat` — el robot estructuralmente no puede terminar girando en el lugar, sin importar qué tan alta sea la ganancia. Esto es una garantía de diseño, no un ajuste fino. Nuevas constantes: `LINE_OBJ_REV_RATE_KP=3.0` (antes 45, ya no hace falta un valor extremo porque el clamp de fracción absorbe cualquier exceso de ganancia de forma segura), `LINE_OBJ_REV_RATE_KI=1.0` (antes 12), `LINE_OBJ_REV_RATE_I_MAX=1.0` (antes 5), `LINE_OBJ_REV_FRAC_MAX=0.6` (reemplaza `LINE_OBJ_REV_STEER_MAX_NOLINE`, eliminada), `LINE_OBJ_REV_STEER_SLEW=0.10` fracción/ciclo (antes 6.0°/ciclo). `obj_rev_steer_f` cambió de semántica: ahora almacena la fracción rampeada (±0.6), no grados — se corrigió también el punto donde se sincronizaba con el `steering_adjustment` absoluto de la rama con línea detectada (eso ya no tiene sentido de escala; ahora se resetea a 0 en ese punto). Aplicado tanto en `LINE_STATE_OBJ_REVERSE` como en el banco de pruebas de MANUAL (misma fórmula en los dos lugares). Pendiente de confirmar en el robot que ya no gira en círculos y que la asimetría se corrige razonablemente con esta ganancia; al ser una garantía estructural, subir `LINE_OBJ_REV_RATE_KP`/`KI` más allá de estos valores ya no puede volver a causar el giro en círculos — como mucho satura contra `FRAC_MAX` más rápido. | El usuario señaló correctamente que ningún ajuste de ganancia sobre el diseño anterior iba a ser "coherente" — hacía falta cambiar la estructura del controlador (acotar por fracción del comando de avance, no por un valor absoluto) en vez de seguir moviendo un número |
| 2026-07-04 | Core/Src/main.c | **Reversa por obstáculo — hipótesis de signo de v6 DESCARTADA (v7)**: probado en el nuevo banco de pruebas de MANUAL (ver entrada anterior). Con el signo invertido de v6, la rueda **izquierda** pasó a girar de más (antes, sin invertir, giraba de más la derecha) — es decir, se sobrecorrigió hacia el lado contrario en vez de corregir. Esto confirma que el signo original (v5, sin invertir) ya apuntaba en la dirección correcta; el síntoma repetido de v3/v4/v5 ("la derecha sigue retrocediendo más, no corrige") no era un bug de signo sino ganancia insuficiente para compensar del todo la asimetría mecánica real entre ruedas. Revertido el signo (sacado el `-` en ambos lugares: el `case LINE_STATE_OBJ_REVERSE` y el banco de pruebas de MANUAL, que comparten la misma fórmula). La ganancia EXTREMA de v6 (`LINE_OBJ_REV_RATE_KP=45`, `LINE_OBJ_REV_RATE_KI=12`) se mantiene sin cambios — con el signo ya correcto, debería ayudar a terminar de cerrar la asimetría real en vez de sobrecorregirla al revés. Pendiente de confirmar en el banco de pruebas de MANUAL si con el signo correcto y esta ganancia ya endereza bien, o si hay que ajustarla (subir más si sigue faltando autoridad, bajar si ahora sobrecorrige hacia la derecha). | El banco de pruebas de MANUAL (agregado en la sesión anterior) permitió aislar el problema y confirmar/descartar la hipótesis de signo en segundos, en vez de tener que repetir toda la secuencia de esquive en el robot para cada prueba |
| 2026-07-04 | Core/Src/main.c | **Modo MANUAL reconvertido en banco de pruebas de la reversa por obstáculo**: usuario pidió limpiar el código (el ciclo de giros automáticos 90/-90/180° con su máquina de estados de fases era la parte "desagradable") y usar el modo MANUAL para probar/afinar la corrección de rumbo de `LINE_STATE_OBJ_REVERSE` sin tener que pasar por toda la secuencia de esquive. Eliminado por completo: el ciclo automático de giros (`manual_seq_next_ms`/`manual_auto_rot_step`), la máquina de estados de rotación de 2 fases (`manual_rot_active`/`manual_rot_phase`/`manual_rot_heading`/`manual_rot_enc_counts`/etc.), las constantes `MANUAL_ROT_*`, y el registro UNER de comandos de rotación (`UNER_RegisterRotationCmd`). Comportamiento nuevo: con el joystick en reposo (idle: sin comando hace >60ms y ambos comandos casi en cero), MANUAL retrocede indefinidamente aplicando el mismo PI de diferencial de velocidad de ruedas que `OBJ_REVERSE` (mismas constantes `LINE_OBJ_REV_RATE_*` y mismas variables de estado `obj_rev_steer_f`/`obj_rev_rate_integral`, para que lo que se ajuste acá sirva directo para esa funcionalidad real), con `MANUAL_REV_TEST_TILT=4.0°` de inclinación hacia atrás. Si se manda un comando de joystick, el control manual normal sigue funcionando igual que antes (permite reposicionar el robot entre pruebas sin salir del modo). **Impacto en Qt**: los botones de giro preciso (`ROTATE_90_RIGHT/LEFT`, `ROTATE_180_RIGHT/LEFT`, `ROTATE_CUSTOM`) ya no tienen ningún efecto — quedan como no-op seguro (UNER.c ya verificaba puntero NULL antes de escribir, no hace falta tocar el protocolo). Si esos botones existen en la interfaz Qt, avisar al usuario que dejaron de hacer algo, o quitarlos de la UI si ya no aplican. | El ciclo de giros automáticos en MANUAL había sido un banco de pruebas para calibrar el giro de 90°/180° (ya migrado a `LINE_STATE_OBJ_ROTATE`/`LOST_ROTATE`/`EDGE_ROTATE`) y ya no aportaba valor una vez calibrado; reutilizar el mismo modo para la prueba de reversa evita crear un modo nuevo y reduce la superficie de estado del firmware |
| 2026-07-04 | Core/Src/main.c | **Dos cambios en la misma sesión**: (1) **`OBJ_REVERSE` sin línea (v6) — hipótesis de signo**: el PI de velocidad (v5, mismo día) seguía sin corregir la asimetría (rueda derecha retrocede más que la izquierda), mismo síntoma que con el P sobre acumulado (v3/v4) pese a ser un controlador distinto. Dos controladores distintos fallando igual con el mismo signo de corrección apunta a un error de signo, no de estructura/ganancia. Invertido el signo de la salida del PI (`steer_target = -(KP*rate_diff + KI*integral)`); si corrige al revés con este cambio, hay que sacar el `-`. A pedido del usuario, ganancias exageradas a EXTREMO para converger rápido en el robot: `LINE_OBJ_REV_RATE_KP` 18→**45**, `LINE_OBJ_REV_RATE_KI` 4→**12**, `LINE_OBJ_REV_RATE_I_MAX` 3→**5**, `LINE_OBJ_REV_STEER_SLEW` 3→**6**. Si con el signo invertido y estas ganancias tan altas TODAVÍA no corrige bien, el problema no es de signo — revisar si `speed_right_rps_s`/`speed_left_rps_s` tienen una asimetría de escala real entre ruedas (no solo de signo), o un problema mecánico/de sensor en el encoder derecho. (2) **Velocidad de búsqueda sin línea (`LOST_FWD`/`EDGE_FWD`) mucho más controlada**: usuario reportó que se acelera demasiado buscando la línea. `LOST_FWD_SPEED_TARGET` 0.45→**0.18 m/s**, `LOST_FWD_ANGLE_MAX` 2.0→**1.0°** (techo de aceleración mucho más bajo), `LOST_FWD_KP` 6.0→**4.0**, `LOST_FWD_KP_BRAKE` 10.0→**14.0** (reacciona más rápido a sobrevelocidad). Agregado término I (`LOST_FWD_KI=1.0`, `LOST_FWD_VEL_I_MAX=1.0`, con anti-windup igual que el PI de velocidad del seguidor de línea normal) para regular la velocidad de crucero con precisión en vez de depender solo de un P que saturaba contra el techo de ángulo. Nueva variable `lost_fwd_vel_integral` (file-scope, compartida entre `LOST_FWD` y `EDGE_FWD` porque son mutuamente excluyentes, reseteada en todas las entradas a esos estados, en el bloque de caída y al entrar al modo línea). | (1) Dos controladores distintos (P sobre acumulado, PI sobre tasa) fallando con el mismo síntoma tras varias vueltas de ajuste de ganancia es la señal clásica de un bug de signo, no de tuning; el usuario pidió exagerar para confirmar la hipótesis rápido en el robot en vez de seguir iterando a ciegas. (2) El P puro sin I saturaba contra el techo de ángulo desde el primer ciclo de error, sintiéndose como aceleración descontrolada en vez de una aproximación suave a la velocidad de crucero |
| 2026-07-04 | Core/Src/main.c | **Reversa por obstáculo sin línea (v5) — fix del zigzag**: usuario reportó que tras subir la ganancia (v4, mismo día) la rueda derecha retrocedía más que la izquierda y la corrección hacía zigzag en vez de enderezar. Causa raíz: la corrección era un P puro sobre el diferencial de distancia ACUMULADA (`rev_dr - rev_dl`), un término que crece sin límite durante toda la reversa (nunca decae). Con ganancia alta (2.20) y clamp ±45 muy por encima del `pwm_sat` típico de una reversa suave (~15-25), la corrección podía superar a `pwm_sat` e invertir el sentido de giro de una rueda — en ese momento el acumulado empezaba a moverse al revés, la corrección cambiaba de signo el ciclo siguiente, y se repetía: zigzag por sobrecorrección (no por signo invertido, que ya estaba bien). Fix: reemplazado por PI sobre la diferencia de **velocidad** instantánea entre ruedas (`speed_right_rps_s - speed_left_rps_s`), mismo patrón ya validado en `OBJ_ARC` (`OBJ_ARC_KP=15`/`OBJ_ARC_KI=3`). A diferencia del acumulado, la diferencia de velocidad se autolimita y vuelve a 0 en cuanto ambas ruedas igualan su velocidad — no hay ningún término que "recuerde" para siempre la asimetría del arranque, así que no hay de dónde sacar la sobrecorrección que causaba el zigzag. Nuevas constantes `LINE_OBJ_REV_RATE_KP=18.0`, `LINE_OBJ_REV_RATE_KI=4.0`, `LINE_OBJ_REV_RATE_I_MAX=3.0` (reemplazan `LINE_OBJ_REV_ENC_KP`/`LINE_OBJ_REV_GZ_KP`, eliminadas). Se mantiene el clamp `LINE_OBJ_REV_STEER_MAX_NOLINE=45` como techo (rara vez debería alcanzarse con este esquema) y el rate-limiter `LINE_OBJ_REV_STEER_SLEW=3.0°/ciclo` de la v4. Nueva variable `obj_rev_rate_integral` (file-scope, reseteada en los mismos puntos que `obj_rev_steer_f`: entrada a `OBJ_REVERSE`, salida a `OBJ_BRAKE`, caída, y puesta a 0 cada ciclo que se usa la rama con línea detectada para evitar windup). Pendiente de confirmar en el robot. | La v4 (P sobre acumulado con ganancia y clamp más altos) resolvió la falta de autoridad de corrección pero introdujo inestabilidad porque un P sobre un término sin límite natural, con ganancia suficiente para superar el comando de avance, es intrínsecamente propenso a sobrecorregir; un controlador sobre la tasa de error (no su acumulado histórico) es la forma estándar de evitar ese modo de falla |
| 2026-07-04 | Core/Src/main.c | **Reversa por obstáculo sin línea (v4)**: usuario reportó que la corrección seguía sin ser suficiente y que a veces el robot se queda en equilibrio sin retroceder al detectar el objeto. Cambios: (1) `LINE_OBJ_REV_ENC_KP` 1.50→**2.20** (más grados de corrección por count de diferencia entre ruedas). (2) Nuevo rate-limiter `LINE_OBJ_REV_STEER_SLEW=3.0°/ciclo`: el steering objetivo (`enc_term+rate_term`, clamp ±45 sin cambios) ya no se aplica de un salto a `steering_adjustment`, sino que rampea gradualmente vía nueva variable `obj_rev_steer_f` (file-scope, reseteada en todas las entradas/salidas de `OBJ_REVERSE` y en el bloque de caída). Motivo del rate-limiter: con `LINE_OBJ_REV_TILT_MAX=8.5°` (casi al límite de balance hacia atrás) y un clamp de steering de ±45° ya EXTREMO, un salto instantáneo de 0→45° en la corrección puede ser justo el empujón que tumbe al robot mientras está inclinado — y el código ya documentado (2026-07-02) hace que cualquier caída durante `LINE_STATE_OBJ_*` aborte la evasión y vuelva derecho a `FOLLOWING`, lo que coincidiría exactamente con el síntoma "se queda en equilibrio sin ir hacia atrás" (la caída+recuperación es rápida y se percibe como que nunca llegó a retroceder). También sincronizado `obj_rev_steer_f` con `steering_adjustment` en la rama con línea detectada, para que no haya salto al cambiar de rama a mitad de reversa. Pendiente de confirmar en el robot: si el síntoma de "se queda en equilibrio" persiste con el rate-limiter, la hipótesis de la caída silenciosa queda descartada y habría que revisar otra causa (p.ej. `OBJ_PRE_REVERSE_HOLD` de 1s, que es un balance intencional antes de retroceder y podría estar siendo percibido como el bug). | Corrección insuficiente pese a valores ya EXTREMOS en vueltas anteriores; se sospecha que la causa de "a veces no retrocede" es una caída real (por el propio yank de la corrección agresiva) que dispara el abort-on-fall ya existente para estados OBJ_*, no un fallo en la lógica de arranque de la reversa |
| 2026-07-03 | Core/Src/main.c | **Valores extremos a pedido del usuario para acotar el techo real de `OBJ_REVERSE`** — ambos síntomas ("no le da el ángulo" y "no endereza, izquierda gira menos") seguían pese a las vueltas anteriores. Hallazgo clave: un clamp GLOBAL (`sp_limit=5.0°`, aplicado a `base_setpoint_target` para *cualquier* estado que no sea `BALANCE_AND_SPEED`, en `ControlStep10ms` justo después del cálculo por estado) recortaba en silencio `LINE_OBJ_REV_TILT_MAX` cada vez que se subía por encima de 5.0° — el aumento a 6.0° de la vuelta anterior nunca se aplicó realmente, quedaba tapado en 5.0°. Cambios: (1) excepción en `sp_limit` para `LINE_STATE_OBJ_REVERSE` → **9.0°** (antes 5.0 sin excepción). (2) `LINE_OBJ_REV_TILT_MAX` 6.0→**8.5°** (EXTREMO). (3) `LINE_OBJ_REV_VEL_KP` 18.0→**28.0** (con vel_error=0.30 da 8.4°, casi todo el tope desde el primer ciclo). (4) rampa `sp_step_max` de OBJ_REVERSE 0.4→**0.6°/ciclo**. (5) `LINE_OBJ_REV_ENC_KP` (corrección de rumbo por encoders) 0.60→**1.5** y `LINE_OBJ_REV_STEER_MAX_NOLINE` 28→**45** (EXTREMO). Todos marcados en el código como "EXTREMO, bajar tras probar" — el objetivo es encontrar el techo real por prueba y error en el robot y después ajustar hacia abajo, no dejar estos valores como definitivos. Si la corrección de rumbo sigue favoreciendo el mismo lado (izquierda gira menos) incluso con el clamp ampliado, el signo de `LINE_OBJ_REV_ENC_KP` podría estar invertido — cambio de una línea si hace falta. | Dos vueltas previas de ajuste (KP y clamp por separado) no alcanzaron porque un límite global no documentado en este contexto (`sp_limit`) tapaba el efecto real de los cambios en el ángulo; el usuario pidió ir a valores extremos para encontrar el límite físico real antes de afinar |
| 2026-07-03 | Core/Src/main.c | **Ajuste de autoridad de corrección en reversa sin línea (v3.1)**: usuario confirmó que la corrección por encoders (v3, mismo día) "no corrige muy bien" pero al menos avanza — la rueda derecha viaja un poco más que la izquierda hacia atrás sin enderezarse del todo. Causa probable: el clamp de `steering_adjustment` en esa rama estaba fijo en ±15 en la llamada a `clampf_local`, y con `LINE_OBJ_REV_ENC_KP=0.6` una diferencia de apenas ~25 counts (menos del 10% del recorrido total de ~280) ya lo saturaba — la corrección probablemente estaba pegada al tope sin autoridad real para terminar de enderezar. Nueva constante `LINE_OBJ_REV_STEER_MAX_NOLINE=28.0` (antes literal `15.0f` en el clamp) — más margen de corrección diferencial, ganancia sin tocar. Pendiente de confirmar en el robot; si sigue sin alcanzar, subir `LINE_OBJ_REV_ENC_KP` (0.60) además del clamp. | El síntoma "corrige pero no del todo" apunta a autoridad de corrección insuficiente (clamp), no necesariamente a ganancia floja — si la ganancia ya satura el clamp con diffs chicos, subir solo la ganancia no habría ayudado |
| 2026-07-03 | Core/Src/main.c | `rev_target_counts` en `LINE_STATE_OBJ_REVERSE` subido de 200 (~10cm) a 280 (~14cm). | Usuario pidió un poco más de recorrido de reversa antes de pasar a `OBJ_BRAKE` |
| 2026-07-03 | Core/Src/main.c | **2do intento de fix "no le da el ángulo para empezar a retroceder"**: el usuario confirmó en el robot que, pese al fix anterior (mismo día, `LINE_OBJ_REV_VEL_KP=10.0`), seguía sin arrancar — el problema no era la velocidad para llegar al tope sino el tope en sí. Subidos juntos: `LINE_OBJ_REV_TILT_MAX` 3.5°→**6.0°**, `LINE_OBJ_REV_VEL_KP` 10.0→**18.0** (con `vel_error=0.30` da 5.4°, cerca del nuevo tope desde el primer ciclo). Además, rampa de `sp_step_max` específica para `LINE_STATE_OBJ_REVERSE` (0.15→**0.4°/ciclo**, antes compartía la rampa general de modo línea) — a 0.15°/ciclo tardaba ~400ms en llegar al ángulo pedido, ahora ~150ms. Pendiente de confirmar en el robot; si 6.0° tampoco alcanza, el próximo paso sería revisar si hay un límite físico más profundo (deadband de motor, fricción mecánica real del tren de reversa) en vez de seguir subiendo el ángulo. | Segunda vuelta del mismo síntoma tras confirmación del usuario de que el primer ajuste (subir solo la ganancia P, sin tocar el techo) no fue suficiente |
| 2026-07-03 | Core/Src/main.c | **Fix de zigzag en reversa por obstáculo sin línea visible (3er intento)**: el amortiguador de tasa por gyro puro (v2, 2026-07-02: `steering_adjustment = gz*0.6`) seguía dando zigzag pese a usar el mismo patrón "probado" de LOST/SEARCHING/etc. Diagnóstico: (1) un controlador de solo-tasa no tiene referencia de rumbo, no corrige desvío acumulado, solo frena la velocidad angular instantánea. (2) el eje Z del gyro es más propenso a ruido de vibración/EMI con los motores activos (mismo tipo de sensibilidad ya documentada en el freeze de I2C por EMI), y un controlador que reacciona solo a la tasa instantánea amplifica ese ruido. Reemplazado por P sobre el diferencial de distancia recorrida por encoders (`rev_dr - rev_dl`, ya calculado cada ciclo para medir progreso de la reversa) — refleja la asimetría física real entre ruedas sin depender del gyro, mismo enfoque (odometría, no inercial) usado en la primera versión de este código (2026-05-26) antes de migrar a gyro. Se mantiene un componente pequeño de amortiguación por gyro (`LINE_OBJ_REV_GZ_KP=0.15`, antes el único término con peso 0.6) para suavizar oscilaciones rápidas sin ser el driver principal. Nuevas constantes `LINE_OBJ_REV_ENC_KP=0.60`, `LINE_OBJ_REV_GZ_KP=0.15` — valores de partida, sin validar en el robot, signo de `LINE_OBJ_REV_ENC_KP` a confirmar físicamente (si corrige al revés, invertir el signo). | Dos intentos previos con gyro (PI integrado v1, luego amortiguador de tasa puro v2) dieron zigzag; se vuelve a un sensor distinto (encoders) menos sensible a vibración de motores para medir el desvío real |
| 2026-07-03 | Core/Src/main.c | **Fix real de "no le da el ángulo para empezar a retroceder" en `OBJ_REVERSE`** (reaparición del bug ya "arreglado" el 2026-07-02 subiendo `LINE_OBJ_REV_TILT_MAX` 2.0→3.5°). Causa raíz encontrada: el PI de velocidad de reversa usaba `LINE_VEL_KP=3.0` (compartida con el PI de avance normal) y `reverse_speed_target` tope en `LINE_OBJ_REV_SPEED_MAX=0.30` m/s — con el robot parado (vel=0), el término P inicial daba como máximo `3.0×0.30=0.9°`, muy por debajo del tope de 3.5° recién calibrado; alcanzar 3.5° dependía de que el integral hiciera windup durante ~8s (`2.5/(0.30×0.01)` ciclos), demasiado lento para vencer la fricción estática — el robot se quedaba "queriendo" arrancar igual que antes del fix de TILT_MAX. Agregada ganancia dedicada `LINE_OBJ_REV_VEL_KP=10.0` (antes reusaba `LINE_VEL_KP`), que con `vel_error=0.30` da `3.0°` de entrada en el primer ciclo — el tope de `LINE_OBJ_REV_TILT_MAX` se alcanza casi de inmediato en vez de esperar el windup del integral. Pendiente de confirmar en el robot físico. | El fix anterior (2026-07-02, subir TILT_MAX) elevó el techo permitido pero no el ritmo al que el PI llega a ese techo — el término P seguía saturado muy por debajo del tope al arrancar desde parado |
| 2026-07-01 | Core/Src/main.c | Fix freeze+reset en giro 180° (LOST_ROTATE), diagnosticado con 3 agentes en paralelo tras persistir a pesar de fixes previos: (1) `LROT_PIVOT` revertido 12.0→5.0 y `LROT_BRAKE` 8.0→3.0 — el commit de 2026-06-29 ya había bajado estos valores para evitar el spike de corriente al invertir el motor izquierdo (glitch VDD → CSS dispara NMI → reset), pero subieron de nuevo a 12/8 buscando reducir overshoot, reintroduciendo el problema. (2) Prioridades NVIC corregidas: `DMA1_Stream0/1_IRQn` (I2C1 RX/TX) subidas de prio 1→0; `EXTI15_10_IRQn` (encoders PB13/14/15 + MPU PB12) bajada de 1→2; `EXTI9_5_IRQn` (encoder PA8) alineada a 2 (antes 5 por defecto de CubeMX). Antes I2C DMA y EXTI15_10 empataban en prio 1 → durante el giro (máxima tasa de pulsos de encoder) el fin de transacción I2C podía quedar pendiente en cola, dejando la lectura del MPU colgada → PWM congelado en el último valor (alto, en pleno pivot) → robot acelerado y trabado hasta que el IWDG resetea. Pendiente de validar en el robot físico. | Bug recurrente reportado por el usuario, ya documentado varias veces en este changelog sin solución definitiva |
| 2026-07-01 | Core/Src/main.c | Revertido `LROT_PIVOT`/`LROT_BRAKE` de vuelta a 12.0/8.0 (deshecho el cambio del punto anterior). El usuario probó el fix de prioridades NVIC + pivot bajo y el freeze+reset siguió pasando igual — descarta la hipótesis de glitch eléctrico por corriente de motor como causa (al menos como causa suficiente). Usuario reporta que el problema aparece "siempre que uso los encoders", no solo en el giro de 180°, apuntando a un bug en el manejo de encoders (ISR/EXTI/timing) en sí, no a la magnitud del pivot. Queda pendiente investigación a fondo del subsistema de encoders (ver Pendientes). Prioridades NVIC del punto anterior (I2C DMA prio 0, EXTI15_10/EXTI9_5 prio 2) se mantienen sin revertir. | El fix anterior no resolvió el bug; nueva pista del usuario redirige la investigación al subsistema de encoders en general |
| 2026-07-01 | Core/Src/main.c | **Encoders migrados de EXTI (interrupción por flanco) a polling por TIM2 (250µs / 4kHz), hecho por el usuario directamente en el IDE.** Cambios: (1) nueva función `SampleEncoders250us()` que lee PA8/PB13/PB14/PB15 y decodifica cuadratura con tabla de transición de estados estándar (`quad_delta[16]`), llamada desde `HAL_TIM_PeriodElapsedCallback` en cada tick de TIM2. (2) GPIO de los 4 pines de encoder cambiado de `GPIO_MODE_IT_RISING_FALLING` a `GPIO_MODE_INPUT` simple — ya no generan EXTI. (3) Eliminado el código de conteo por EXTI dentro de `HAL_GPIO_EXTI_Callback`. (4) `EXTI9_5_IRQn` deshabilitado (`HAL_NVIC_DisableIRQ`). (5) `TIM5` (el "anti-storm masking" que re-habilitaba EXTI cada 2ms) dejó de arrancarse — queda inicializado pero inerte. (6) `TIM2_IRQn` agregado a las prioridades NVIC de USER CODE BEGIN 2, prio 3. Revisado exhaustivamente por Claude: tabla de decodificación correcta (estándar, usada en libs como PJRC Encoder), mapeo de pines consistente con el hardware, margen de Nyquist amplio (4kHz sampling vs ~470 counts/seg máximo teórico con motores de 1000 RPM — antes el límite EXTI anti-storm era ~500Hz/canal y podía perder pulsos reales en giros rápidos). Sin bugs de correctness encontrados. Pendiente de limpieza no urgente: `EXTI9_5_IRQHandler` en stm32f4xx_it.c queda huérfano, guards `if(EXTI->IMR & GPIO_PIN_13/14/15)` en `EXTI15_10_IRQHandler` nunca se cumplen, `MX_TIM5_Init()` sigue llamado sin necesidad, `tick2ms_count` congelado en 0 sin usarse. Los pines de encoder no están gestionados por el `.ioc` de CubeMX (confirmado por grep), una regeneración no debería pisar este cambio. | El usuario reportó que el freeze+reset en el giro de 180° "siempre pasa cuando uso los encoders" y que el fix de pivot/prioridades del punto anterior no lo resolvió — sospecha de bug real en el manejo EXTI de encoders (storm de interrupciones, carrera con TIM5 sobre `EXTI->IMR`, prioridad compartida con I2C). Migrar a polling elimina de raíz esa clase de problema: tasa de interrupción fija y acotada (4kHz) en vez de variable según velocidad física de la rueda. Pendiente de validar en el robot físico si el freeze+reset desaparece del todo |
| 2026-07-01 | Core/Src/main.c | `LROT_ENC_TARGET` (giro 180° en LOST_ROTATE) subido 760→829 counts (+8.3%) y `LROT_P1_MAX` 1500→1800ms. Tras la migración de encoders y el fix de signo, el giro quedaba ~15° corto (165° en vez de 180°). 829 = 760×(180/165), reescalado empírico proporcional al faltante reportado por el usuario. Pendiente de confirmar en el robot si el nuevo valor da 180° exactos o necesita un segundo ajuste fino. | Calibración de counts/grado quedó desactualizada tras el cambio de método de conteo de encoders |
| 2026-07-01 | Core/Src/main.c | Segunda pasada de calibración del giro 180°: `LROT_ENC_TARGET` 829→880 (seguía quedando corto). Además, `LROT_P1_MAX` 1800→6000ms: pasa de ser un corte normal a ser **solo** un colchón de seguridad (motor trabado / sensor fallando) — la salida de la fase de freno ahora depende casi exclusivamente de `enc_done` (completar los counts del encoder), no del tiempo transcurrido. Pendiente de confirmar en el robot si 880 ya da 180° exactos. | Usuario pidió explícitamente que el giro no corte "accidentalmente por tiempo" y solo salga al completar los pulsos de encoder |
| 2026-07-01 | Core/Src/main.c | Fix de "a veces sigue quedándose en GIRO": los colchones de seguridad `LROT_P0_MAX`/`LROT_P1_MAX` (4000/6000ms) y `EROT_P0_MAX`/`EROT_P1_MAX` (2500/3500ms) eran demasiado generosos — si algo impedía completar los counts de encoder a tiempo (fricción, superficie, etc.) el giro podía tardar hasta ~10s en salir por timeout, sintiéndose "pegado". Acortados a `1500/800` (180°) y `1000/800` (45°) — peor caso total ahora ~2.3s en vez de ~10s. Siguen siendo colchones de seguridad, no cortes normales (la salida normal sigue siendo completar el target de encoder). | Los timeouts de seguridad heredados de iteraciones anteriores (pensados para otro esquema de frenado) quedaron demasiado largos para el nuevo freno fijo de 400ms |
| 2026-07-02 | Core/Src/main.c | `rev_target_counts` en `OBJ_REVERSE` vuelto de 1000 (~50cm, temporal para calibrar) a **200 (~10cm)**, el valor normal — ya validado el enderezamiento por gyro. | Usuario confirmó que el enderezamiento ya anda bien y pidió volver a la distancia de reversa normal |
| 2026-07-02 | Core/Src/main.c | Fix de zigzag en la reversa por obstáculo: la corrección por PI de rumbo integrado (`obj_rev_heading` + `obj_rev_straight_int`, agregada en el punto anterior) hacía zigzag — señal de signo/ganancia mal calibrados en una fórmula nueva sin validar en el robot. Reemplazada por el mismo patrón de amortiguación por tasa (gyro Z crudo, SIN integrar) que ya se usa y funciona en LOST/SEARCHING/OBJ_HOLD/OBJ_WALL_FWD/LOST_FWD/EDGE_FWD: `steering_adjustment = clamp(gz_dps * 0.6, ±15)` (el 0.6 compensa el `*0.5` que se aplica después sobre `steering_adjustment` para llegar al mismo `half_steer` efectivo que ese patrón ya probado, que usa `gz_dps*0.3` directo). Eliminadas `LINE_OBJ_REV_GYRO_KP/KI`, `obj_rev_heading` y `obj_rev_straight_int` (quedaron sin uso). | La fórmula de PI de rumbo integrado, nueva y sin testear, resultó tener signo o ganancia incorrectos; más seguro reusar la convención ya validada en el resto del código que reinventar una |
| 2026-07-02 | Core/Src/main.c | **Fix real de "no le da el ángulo para ir hacia atrás"**: mismo bug de `balance_hold_active` ya visto en `LOST_FWD`/`EDGE_FWD` (2026-07-01), ahora en `LINE_STATE_OBJ_REVERSE` — el robot suele estar bien parado y nivelado justo al empezar a retroceder, así que el hold se activaba de entrada y apagaba el PID de balance antes de poder generar el ángulo de reversa. Agregado a la lista de exclusión de `balance_hold_active`. El aumento de `LINE_OBJ_REV_TILT_MAX` (2.0→3.5°) del punto anterior no alcanzaba porque el PID estaba directamente silenciado, no era un problema de límite de ángulo. | El síntoma "quiere retroceder pero no logra, se queda quieto" es el mismo patrón de bug de hold ya visto, esta vez en un estado nuevo que no se había cubierto |
| 2026-07-02 | Core/Src/main.c | Reversa por obstáculo (`LINE_STATE_OBJ_REVERSE`) mejorada a pedido del usuario: (1) **Enderezamiento por gyro Z** en vez de diferencial de encoders cuando no ve línea — el diferencial de encoders no distinguía asimetría mecánica real de un giro real; ahora integra `gz` (igual que los estados de rotación) y corrige PI (`LINE_OBJ_REV_GYRO_KP=0.8`, `LINE_OBJ_REV_GYRO_KI=0.05`) para mantener el rumbo en 0. Nueva variable `obj_rev_heading`, reseteada al entrar a `OBJ_REVERSE` y en el bloque de caída. (2) `LINE_OBJ_REV_TILT_MAX` subido de 2.0° a **3.5°** — con 2.0° a veces no alcanzaba para vencer la fricción estática y arrancar desde parado, el robot se quedaba "queriendo" retroceder sin lograrlo. (3) `rev_target_counts` alargado temporalmente de 200 (~10cm) a **1000 (~50cm)** para poder calibrar bien la rectitud — achicar de nuevo una vez ajustado el gyro. | Usuario pidió reversa recta usando el giroscopio en vez de encoders, más ángulo porque a veces no lograba arrancar, y más distancia para poder calibrar visualmente |
| 2026-07-02 | Core/Src/main.c | **Fix de "sigue frenando a cero" en el PI de velocidad de `LINE_STATE_FOLLOWING`** pese a bajar `sp_step_max` a 0.15: `line_forward_vel = fmaxf(0.0f, -velocity_est_f)` era la única lectura de velocidad de todo el firmware que seguía SIN el filtro de deadband — el mismo bug de cuantización ya arreglado en `LOST_FWD`/`EDGE_FWD` (un solo pulso de encoder simultáneo en ambas ruedas se lee como ~0.63 m/s de golpe). Aplicado `apply_deadbandf(·, BRAKE_VEL_DEADBAND)`. Explica por qué bajar la rampa no alcanzaba: el disparador de frenado se repetía constantemente por ruido, no por una rampa demasiado agresiva. | Se había aplicado el fix de deadband a LOST_FWD/EDGE_FWD pero se pasó por alto el PI de velocidad del seguidor de línea normal, que usa la misma señal cruda |
| 2026-07-02 | Core/Src/main.c | Si el robot se cae mientras está esquivando un obstáculo (cualquier `LINE_STATE_OBJ_*`), ahora abandona la evasión y vuelve directo a `LINE_STATE_FOLLOWING` en vez de retomar la secuencia de esquive donde había quedado al recuperarse. Se detecta con `line_state >= LINE_STATE_OBJ_PRE_REVERSE_HOLD` (son los últimos del enum). Se ignora la detección de objeto por 5s al volver (mismo patrón usado en otras salidas de evasión), por si el objeto sigue ahí. | Usuario pidió explícitamente que una caída durante el esquive cancele la evasión en vez de continuarla |
| 2026-07-02 | Core/Src/main.c | **Fix de "acelera y de golpe frena hasta quedar totalmente quieto" en seguidor de línea normal**: el "limitador global de velocidad" (agregado para frenar en LOST_FWD/EDGE_FWD/etc.) no excluía `LINE_STATE_FOLLOWING`, a pesar de que ese estado ya regula su propia velocidad con el PI de línea (`LINE_VEL_KP`/`LINE_VEL_KP_BRAKE`/`LINE_VEL_KI`, que calcula un ángulo de frenado gradual). Cada vez que la velocidad cruzaba el 90% de `LINE_SPEED_TARGET`, este limitador TAPABA el ángulo suave del PI con `ComputeBrakeSetpointTarget` (pensado para frenar del todo en balance estático, no para regular velocidad de crucero), produciendo un frenazo brusco hasta velocidad cero en vez de una regulación fluida. Agregado `line_state != LINE_STATE_FOLLOWING` a la exclusión. | El limitador global decía en su propio comentario que solo debía aplicar a estados "que no tienen su propio control de frenado" pero `LINE_FOLLOWING` sí lo tiene — quedó afuera de la lista de exclusión por descuido |
| 2026-07-02 | Core/Src/main.c | `LOST_FWD_TIMEOUT`/`EDGE_FWD_TIMEOUT` subidos de 3s a **5s** (se probó 7s primero, el usuario lo bajó) — más tiempo avanzando buscando la línea antes de pasar a `GIVEN_UP` (reposo total). | Usuario pidió más margen para reencontrar la línea antes de darse por vencido |
| 2026-07-02 | Core/Src/main.c | Dos funcionalidades nuevas a pedido del usuario: (1) **Si el giro (180° o 45°) termina ya sobre la línea, va directo a `FOLLOWING` sin pasar por `LOST_FWD`/`EDGE_FWD`** — se chequea `line_detected` en el mismo instante en que `LOST_ROTATE`/`EDGE_ROTATE` completan el freno fijo; si es verdadero, transición directa a `FOLLOWING` (reseteando integrales), si no, sigue el camino normal (`LOST_FWD` o `EDGE_SETTLE`). (2) **Nuevo estado `LINE_STATE_PERP_ROTATE`**: si durante `LINE_STATE_FOLLOWING` los 4 ADC leen negro simultáneamente Y el acelerómetro NO está variando (o sea, no lo levantaron con la mano — reutiliza `accel_motion_f` ya existente), con un debounce corto de 50ms (no los 2s de "en el aire"), se interpreta como cruce perpendicular a una línea (ej. una "+"): la franja cubre los 4 sensores de punta a punta. Dispara un giro instantáneo de 90° fijo (dirección fija a la derecha, no hay info de lado porque los 4 sensores ven lo mismo) con la misma lógica gz+encoder y freno fijo corto que `LOST_ROTATE`/`EDGE_ROTATE` (`PROT_ENC_TARGET=440`, `PROT_PIVOT=14`, `PROT_BRAKE=16`, freno fijo 400ms), y al terminar va directo a `FOLLOWING` (sin pasar por ningún estado de avance). El bloque de detección "en el aire" se restructuró para compartir el mismo timer `all_black_start_ms` entre ambos casos (picked-up vs perpendicular), diferenciados por `accel_moving`. Display: PGIRO. | Usuario pidió que el robot no pierda tiempo avanzando si el giro ya lo dejó sobre la línea, y que reconozca cruces perpendiculares (llegar de frente a una línea transversal) para alinearse solo en vez de tratarlo como "línea perdida" |
| 2026-07-01 | Core/Src/main.c | Revisión exhaustiva de todo el subsistema de línea/búsqueda de esta sesión (encoders, giros, clasificación centrado/extremo, avance post-giro, GIVEN_UP). Fix aplicado: `LOST_FWD`/`EDGE_FWD` (avance ciego post-giro) agregados a la lista de estados con corrección de yaw por giroscopio (antes solo tenían `LOST`/`SEARCHING`/`OBJ_PRE_REVERSE_HOLD`/`OBJ_HOLD`/`OBJ_WALL_FWD`) — sin esto, con `steering_adjustment=0` forzado, no había ninguna corrección de rumbo durante el avance y el robot podía irse curvando sin corregir. Hallazgo documentado pero NO corregido (fuera de alcance): el chequeo `f_fallen ||` dentro de `LOST_FWD`/`EDGE_FWD` para saltar a `GIVEN_UP` es código muerto — todo el switch de transiciones está anidado dentro de un `if (!f_fallen) {...}` más externo, así que ese chequeo nunca se cumple en la práctica (mismo patrón preexistente ya presente en `OBJ_HOLD` y `OBJ_WALL_APPROACH` desde antes de esta sesión, no introducido ahora). Impacto bajo: si el robot se cae, los motores igual se apagan por el guard exterior y el timeout de 3s lo manda a `GIVEN_UP` poco después de todos modos. Sin otros bugs encontrados: consistencia de enum/display/transiciones de todos los estados nuevos OK, timers compartidos (`lrot_settle_start_ms`, `obj_rot_*`) sin contaminación cruzada, `line_search_dir`/`EROT_DIR` no puede cambiar a mitad de giro, `last_detected_edge_only` maneja bien los casos borde (intersección ancha, arranque sin línea), `line_lost_ms` se resetea en el momento correcto antes de `LOST_FWD`/`EDGE_FWD` (el timeout de 3s cuenta desde ahí, no arrastra tiempo previo), `GIVEN_UP` sobrevive intacto a un ciclo de caída+recuperación. **Riesgo señalado sin confirmar**: `LROT_BRAKE`/`EROT_BRAKE=16.0` a torque fijo sostenido 400ms es bastante alto (casi el doble del 9.0 anterior) — dado el historial de esta sesión con freezes/resets sospechados de picos de corriente (después descartados a favor del bug de signo de encoders), vale la pena vigilar si reaparece algún freeze/reset en las próximas pruebas físicas. | Usuario pidió una revisión exhaustiva de todo el código tras la larga cadena de fixes de esta sesión |
| 2026-07-01 | Core/Src/main.c | Rediseño del freno final de `LOST_ROTATE`/`EDGE_ROTATE` a pedido explícito del usuario ("no hace falta frenar tan puntual"): eliminada toda la lógica basada en `rv` (velocidad real de rueda) para decidir la salida — sin sentido quedarse "pegado" en `GIRO` tratando de afinar una velocidad exacta. Ahora, una vez `enc_done`, aplica freno a **torque fijo LROT_BRAKE/EROT_BRAKE = 16.0** (subido de 9.0) durante un tiempo corto y acotado (`LROT_BRAKE_DURATION`/`EROT_BRAKE_DURATION = 400ms`) y sale sí o sí (el timeout de 3500-6000ms queda solo como colchón de seguridad ante `overshoot`). | El freno proporcional con piso (punto anterior) seguía sin convencer al usuario — se simplifica a frenar fuerte y avanzar, sin intentar precisión de velocidad |
| 2026-07-01 | Core/Src/main.c | Fix de "el giro dura demasiado / sigue en GIRO y se va hacia atrás": el freno proporcional a `rv` del punto anterior no tenía piso (`clamp(rv/1.0, 0, 1)`), así que al acercarse la velocidad a cero el freno también se acercaba a cero de forma asintótica — tardaba mucho en cruzar el umbral `vel_ok` (rv<0.5) y quedaba mucho tiempo "pegado" en `LOST_ROTATE`/`EDGE_ROTATE` con muy poco freno activo, tiempo durante el cual el balance normal podía hacerlo derivar hacia atrás. Agregado piso de `0.3` (`clamp(rv/1.0, 0.3, 1.0)`) en ambos giros — el freno siempre termina de frenar de verdad en vez de decaer indefinidamente. | El freno proporcional sin piso solucionó el overshoot pero introdujo el problema opuesto: convergencia asintótica demasiado lenta |
| 2026-07-01 | Core/Src/main.c | Dos cambios a pedido del usuario tras seguir viéndolo irse hacia atrás: (1) **`LOST_SETTLE` bypaseado**: `LOST_ROTATE` ahora transiciona directo a `LOST_FWD` apenas termina el giro por encoder, sin la pausa de estabilización (el usuario pidió explícitamente "no espere nada"). El estado `LOST_SETTLE` queda en el código sin usar por si hace falta reactivarlo. Solo se tocó el camino de 180°, `EDGE_ROTATE`→`EDGE_SETTLE` (90°/45°) no se tocó. (2) **Freno más intenso al perder la línea del todo**: nueva constante `LOST_BRAKE_BOOST=1.6`, aplicada solo en `LOST_BRAKE` y `EDGE_WAIT` (`brake_setpoint_target = clamp(ComputeBrakeSetpointTarget(...) * 1.6, ±BRAKE_TILT_MAX)`) para no alejarse tanto de donde se perdió la línea antes de empezar a buscar. No se tocó el freno estándar de `ComputeBrakeSetpointTarget` en general (afectaría también al balance común y reintroduciría la oscilación ya corregida). | Usuario pidió que el avance post-180° arranque inmediatamente sin esperar, y que el frenado inicial al perder la línea sea más intenso para no alejarse tanto de ella |
| 2026-07-01 | Core/Src/main.c | Fix de "se va hacia atrás después de girar": `LOST_FWD_SPEED_TARGET=0.45` seguía por debajo del pico de ruido de cuantización cuando tiquean las dos ruedas en el mismo ciclo (~0.63 m/s) — un solo pulso simultáneo se leía como sobrevelocidad y disparaba la ganancia de freno fuerte (`LOST_FWD_KP_BRAKE=10`), inclinando hacia atrás. Aplicado `apply_deadbandf(·, BRAKE_VEL_DEADBAND)` a la velocidad medida en `LOST_FWD` y `EDGE_FWD` antes de calcular el error, igual que ya se hacía en `ComputeBrakeSetpointTarget`. | Un solo pulso de encoder alcanzaba para cruzar el umbral de sobrevelocidad y frenar hacia atrás en vez de avanzar |
| 2026-07-01 | Core/Src/main.c | Giro de `EDGE_ROTATE` bajado de 60° a **45°** a pedido del usuario: `EROT_ABS_TARGET` 60→45, `EROT_ENC_TARGET` 293→220, `EROT_SLOWDOWN_DEG` 37→28 (escalados en proporción 45/90 respecto a los valores base calibrados para 90°). | Usuario pidió aún menos ángulo en el giro por pérdida en un extremo |
| 2026-07-01 | Core/Src/main.c | Giro de `EDGE_ROTATE` (perdida por un extremo) reducido de 90° a **60°** a pedido del usuario: `EROT_ABS_TARGET` 90→60, `EROT_ENC_TARGET` 440→293 y `EROT_SLOWDOWN_DEG` 55→37 (los tres escalados en proporción 60/90 respecto a los valores calibrados para 90°). El giro de 180° (`LOST_ROTATE`) no se tocó. | Usuario pidió que el giro por pérdida en un extremo sea un poco menos agresivo en ángulo |
| 2026-07-01 | Core/Src/main.c | **Fix del vaivén post-giro** ("se va para cualquier lado" en vez de quedarse quieto): el freno de la fase final de `LOST_ROTATE`/`EDGE_ROTATE` (una vez `enc_done`) aplicaba un torque diferencial **fijo** (`LROT_BRAKE`/`EROT_BRAKE`) sin relación con la velocidad real, hasta que `rv` bajara del umbral. Al bajar ese umbral de `2.0` a `0.5` rev/s (fix anterior), el freno fijo pasó a tener mucho más tiempo para actuar y se pasaba de largo, arrancando a girar en sentido contrario (vaivén, nunca se asienta). Fix: el freno ahora escala con `rv` (`brake_scale = clamp(rv/1.0, 0, 1)`), apagándose solo a medida que la rotación real decae, sin poder sobrepasarse. | El fix anterior (umbral de velocidad más estricto) expuso un problema latente: un freno de torque constante no es estable si tiene tiempo de sobra para actuar — necesita ser proporcional a la velocidad que está frenando |
| 2026-07-01 | Core/Src/main.c | Dos fixes más tras seguir probando: (1) **Reemplazado el enfoque de "pico reciente de line_error"** (con cualquier decay terminaba mal clasificado — el usuario confirmó que con 0.90 seguía haciendo siempre 90° aunque el medio fue el último en ver la línea) por una detección literal: `last_detected_edge_only` (bool) congela en el último ciclo con línea detectada si el ÚNICO sensor con señal fue un extremo (`w[0]` o `w[3]`) sin ningún soporte de los sensores del medio (`w[1]`/`w[2]` en cero). `line_was_centered_on_lost = !last_detected_edge_only`. Elimina toda la lógica de decay/umbral float, es un snapshot directo de qué sensor vio la línea por última vez, tal como lo describió el usuario. (2) **Fix de "no avanza, se queda quieto" en LOST_FWD/EDGE_FWD**: `balance_hold_active` solo se desactivaba con `line_detected` verdadero (bug ya visto una vez el 2026-05-18, ahora reaparecido en un contexto nuevo) — en el avance a ciegas post-giro `line_detected` es falso todo el tiempo, así que apenas el ángulo objetivo rampeaba desde 0° (error chico) el hold se activaba y silenciaba el PID de balance justo cuando debía empujar al robot hacia adelante. Condición ampliada para excluir también `LINE_STATE_LOST_FWD` y `LINE_STATE_EDGE_FWD`. | El pico con decay nunca encontró un punto de equilibrio correcto entre over/under-clasificar; el hold silenciando el PID en avance ciego es el mismo patrón de bug que ya se había visto y arreglado en otro contexto (seguimiento de línea normal) pero no se había extendido a los estados de búsqueda nuevos |
| 2026-07-01 | Core/Src/main.c | Dos fixes tras probar el punto anterior: (1) El decay del pico reciente de `line_error` (0.98/ciclo, memoria ~300-500ms) sobrecorrigió: quedaba "cargado" por el bamboleo normal de curvas pasadas y TODA pérdida se clasificaba como "por el extremo", el giro de 180° dejó de dispararse incluso viniendo centrado. Decay bajado a 0.90 (memoria ~100-150ms, suficiente para el desvanecimiento del sensor justo antes de perder la línea, sin arrastrar wobble de más atrás). (2) `EROT_DIR` (dirección del giro de 90°) invertido: `line_search_dir` en vez de `-line_search_dir` — el usuario confirmó en el robot que giraba hacia el lado contrario del esperado. | El primer ajuste del pico (0.98) fue demasiado agresivo y rompió el caso centrado; la dirección del giro de 90° estaba invertida respecto al comportamiento real observado |
| 2026-07-01 | Core/Src/main.c | Tres fixes tras reportes de "sigue sin frenar post-giro / no avanza en realidad / el giro de 90 nunca se dispara": (1) `vel_ok` en `LOST_ROTATE` y `EDGE_ROTATE` bajado de `rv<2.0` a `rv<0.5` rev/s (`p1e>=80→150ms`): 2.0 rps de rueda equivale a ~0.35 m/s, se consideraba "parado" con las ruedas todavía girando de verdad, y esa velocidad residual se arrastraba a SETTLE/FWD sin frenar de verdad. (2) `LSETTLE_TIMEOUT`/`ESETTLE_TIMEOUT` 1200→3000ms: eran un corte casi normal en vez de un colchón de seguridad, dejando avanzar con velocidad residual antes de estabilizar de verdad. (3) `LOST_FWD_SPEED_TARGET` 0.30→0.45 m/s: 0.30 caía DENTRO del piso de cuantización del encoder (~0.32-0.63, ver `BRAKE_VEL_DEADBAND`), así que el control P nunca encontraba un punto estable y peleaba entre acelerar y frenar a fondo, resultando en que el robot no avanzaba en absoluto. (4) **Bug del giro de 90° que nunca se disparaba**: `line_was_centered_on_lost` comparaba solo el último `line_error` puntual, pero justo antes de perder la línea del todo la señal del sensor extremo se desvanece y ese último valor vuelve a verse "centrado" aunque la pérdida real haya sido por un extremo. Nueva variable `line_error_peak_recent` (pico de `\|line_error\|` con decaimiento ~0.98/ciclo ≈ memoria de 0.3-0.5s), usada en el snapshot en vez del valor instantáneo. | El giro de 90° nunca se disparaba aunque la última lectura fuera claramente un sensor extremo (ADC1/ADC4); el de 180° no frenaba antes de avanzar; el avance post-giro se quedaba quieto en vez de avanzar |
| 2026-07-01 | Core/Src/main.c | Detección "en el aire" (`f_in_air`) ahora requiere que el acelerómetro esté variando constantemente además de los 4 sensores de línea en negro. Nueva métrica `accel_motion_f` (EMA de la suma de `\|Δax\|+\|Δay\|+\|Δaz\|` crudos entre ciclos, beta=0.30, calculada en `ControlStep10ms` justo después de leer el acelerómetro) y `ACCEL_MOTION_THRESHOLD=300.0` (punto de partida, ajustar en el robot real). Antes: al posar el robot sobre una zona sin línea (blanco totalmente), se disparaba `f_in_air` igual que si lo hubieran levantado con la mano, y los motores se detenían en lugar de seguir buscando la línea (LOST/EDGE). Ahora solo se activa si además hay movimiento sostenido del acelerómetro (= lo están manipulando); si está quieto sobre una zona sin línea, sigue el flujo normal de búsqueda. | El usuario quiere distinguir "lo levantaron con la mano" (debe detenerse) de "está parado sobre una zona blanca sin línea" (debe seguir buscando la línea) |
| 2026-07-01 | Core/Src/main.c | Fix de "no frena para nada, se acelera a fondo" post-giro + estado de reposo total. (1) **Control de avance reescrito**: el bang-bang viejo de `LOST_FWD`/`EDGE_FWD` (ángulo fijo `OBJ_WALL_APPROACH_ANGLE` hasta cruzar `OBJ_WALL_OVERSPEED_VEL=0.90`, recién ahí freno de `-1.0°`) nunca frenaba de verdad por debajo del umbral y podía acelerar sin límite. Reemplazado por un control P continuo (`LOST_FWD_SPEED_TARGET=0.30` m/s, `LOST_FWD_KP=6.0` acelerando, `LOST_FWD_KP_BRAKE=10.0` frenando, clamp `[-2.0, +2.0]°`) que reduce el ángulo suavemente a medida que se acerca al target y frena proporcionalmente si lo supera, en vez de un salto brusco entre 2 valores fijos. (2) **Nuevo estado `LINE_STATE_EDGE_SETTLE`**: el giro de 90° ahora también pasa por una pausa de estabilización antes de avanzar (idéntica a `LOST_SETTLE`), a pedido del usuario ("debería pasar a avanzar una vez que está más o menos quieto", aplicado a ambos giros). (3) **Nuevo estado terminal `LINE_STATE_GIVEN_UP`**: si `LOST_FWD` o `EDGE_FWD` no encuentran la línea en 3s (antes 10s, y antes volvían a `LINE_STATE_LOST` reintentando la búsqueda), ahora van a `GIVEN_UP` — reposo total (upright + freno de encoders, sin steering, sin timeout, sin reintento) hasta que se vuelva a detectar la línea (el usuario la repone a mano). Display: EESTAB/PARADO. | Usuario reportó que tras el giro de 180° el robot se aceleraba sin frenar en absoluto, y pidió que tras 3-4s sin encontrar la línea (probado primero 4s, bajado a 3s) el robot quede completamente quieto en vez de seguir reintentando la búsqueda indefinidamente |
| 2026-07-01 | Core/Src/main.c | Segunda pasada sobre la oscilación en balance común: el ajuste anterior de `BRAKE_VEL_DEADBAND` (0.05→0.12) seguía sin filtrar el ruido — calculado el piso de cuantización real de `velocity_est` (`ControlStep10ms`, delta de encoder cada 10ms, `ENC_CPR=28`): 1 count en una sola rueda ya da ≈0.32 m/s, ambas ruedas ≈0.63 m/s. Cualquier pulso aislado se leía como "movimiento real" y disparaba freno. `BRAKE_VEL_DEADBAND` subido a **0.35** (justo por encima del piso de 0.32) para filtrar el ruido de un solo pulso sin tapar una deriva sostenida real. | El deadband anterior (0.12) era un orden de magnitud menor que el piso de ruido real del sensor — no podía funcionar |
| 2026-07-01 | Core/Src/main.c | Reajuste del freno traslacional tras reporte de oscilación en balance común (BALANCE_ONLY): con `KV_BRAKE=2.0` (base, siempre activo) y `BRAKE_VEL_DEADBAND=0.05` (deadband chico), el ruido de cuantización de la nueva velocidad por encoders alimentaba una corrección de inclinación constante y el robot se balanceaba/oscilaba visiblemente parado y sin perturbación. Valores bajados a un punto intermedio entre el original y el primer ajuste agresivo: `KV_BRAKE` 2.0→0.8, `KV_BRAKE_STRONG` 8.0→6.0, `BRAKE_VEL_THRESHOLD` 0.6→1.0, `BRAKE_TILT_MAX`/`_MANUAL` 5.0→4.0, `BRAKE_VEL_DEADBAND` 0.05→0.12 (filtra el ruido de cuantización). Pendiente de confirmar en el robot que el balance común volvió a ser estable sin perder el freno más fuerte que corrigió la aceleración descontrolada en LOST/línea. | El primer ajuste (2026-07-01, punto "Frenado más agresivo") sobrecorrigió: sirvió para frenar el runaway pero introdujo oscilación en el caso normal de balance sin movimiento |
| 2026-07-01 | Core/Src/main.c | **Implementada la secuencia de recuperación "perdida por un extremo"** (el TODO del punto anterior). 3 estados nuevos: `LINE_STATE_EDGE_WAIT` (frena hasta velocidad baja o timeout 1500ms — la entrada a este estado ya ocurre ≥1s después de perder la línea, por el umbral existente en la salida de FOLLOWING), `LINE_STATE_EDGE_ROTATE` (gira 90° hacia el lado donde se vio la línea por última vez, misma lógica gz+encoder que `LOST_ROTATE` con `EROT_ENC_TARGET=440` counts = 90° —mitad de los 880 recalibrados para 180°—, dirección `EROT_DIR=-line_search_dir` ya que la convención es "izq=positivo" y hay que girar HACIA ese lado; no sale anticipadamente si ve la línea, igual que `LOST_ROTATE`), `LINE_STATE_EDGE_FWD` (avanza con velocidad controlada — mismo esquema de `LOST_FWD`, ángulo fijo + freno por overspeed — hasta encontrar la línea o timeout 10s). Disparo: en la salida de `LINE_STATE_FOLLOWING`, si `!line_was_centered_on_lost` va a `EDGE_WAIT` en lugar de `LINE_STATE_LOST` (que sigue yendo a la secuencia de 180°). Se reutiliza `line_search_dir` (existía pero no se usaba) para guardar el lado. Nueva variable `edge_wait_start_ms`. Display: EFRENA/EGIRO/EAVNZA. | Perder la línea en una curva necesita un giro de 90° hacia el lado por donde se fue la línea, no un giro ciego de 180° |
| 2026-07-01 | Core/Src/main.c | Dos cambios pedidos por el usuario sobre el giro de 180°: (1) **Ya no sale anticipadamente si detecta línea a mitad de giro** — se eliminó el `if(line_detected) break;` dentro de `LINE_STATE_LOST_ROTATE`; ahora el giro siempre completa los `LROT_ENC_TARGET` counts antes de re-evaluar la línea (en `LOST_SETTLE`/`LOST_FWD`). Evita cortar el giro a mitad de camino por una detección espuria/parcial mientras el robot gira rápido. (2) **El giro de 180° solo se ejecuta si el robot venía centrado sobre la línea** al perderla (no por los sensores extremos/curva). Nueva variable `line_was_centered_on_lost` (default 1), capturada en la transición FOLLOWING→LOST comparando `fabsf(line_error) < 0.15` (line_error retiene su último valor válido al perder la línea, no se resetea). La transición LOST_BRAKE→LOST_ROTATE ahora chequea esta variable: si es falso (se perdió por los extremos, ej. en curva), el robot se queda frenado y balanceado en el lugar en `LOST_BRAKE`, sin girar — **TODO: falta implementar la secuencia de recuperación para el caso "perdida por los extremos"**, pendiente de definir con el usuario. | El giro de 180° a ciegas no tiene sentido si la línea se perdió en una curva (por los sensores extremos); ese caso necesita otra maniobra distinta, todavía no implementada |
| 2026-07-01 | Core/Src/main.c | Nuevo estado `LINE_STATE_LOST_SETTLE` insertado entre `LOST_ROTATE` y `LOST_FWD`: al terminar el giro de 180°, el robot mantiene balance estático con freno de encoders (igual que `LOST_BRAKE`, `ComputeBrakeSetpointTarget(BALANCE_ONLY)`) durante un mínimo de 400ms, y sale cuando se cumple ese mínimo Y `|velocity_est_f|<0.10 m/s` Y el error de inclinación respecto al setpoint es `<3°`, o por timeout de seguridad de 1200ms. Si detecta la línea durante la espera, va directo a FOLLOWING. Nueva variable `lrot_settle_start_ms` (reseteada también en el bloque de caída). Display: "ESTAB". | Usuario pidió una pausa de estabilización fuerte después del giro, antes de arrancar a avanzar buscando la línea, en vez de pasar directo de girar a avanzar |
| 2026-07-01 | Core/Src/main.c | Giro 180° un poco más agresivo a pedido del usuario: `LROT_PIVOT` 12.0→14.0, `LROT_BRAKE` 8.0→9.0 (subido en proporción para no perder margen de frenado al final). Cambio moderado, no al nivel de 15 (valor que en sesiones previas se sospechó de causar glitches eléctricos, aunque esa hipótesis fue descartada después). | Usuario pidió giro "un poco más agresivo" pero no mucho más |
| 2026-07-01 | Core/Src/main.c | **Frenado más agresivo**, en dos frentes reportados por el usuario ("se acelera una locura" con y sin línea): (1) `ComputeBrakeSetpointTarget` (usado en LOST, LOST_BRAKE, HOLD, OBJ_BRAKE, WALL_*, MANUAL y el limitador global de velocidad en modo línea): `KV_BRAKE` 0.0→2.0 (antes CERO freno por debajo del umbral, el robot aceleraba libre), `KV_BRAKE_STRONG` 5.0→8.0, `BRAKE_VEL_THRESHOLD` 1.5→0.6 m/s (el freno fuerte arranca mucho antes), `BRAKE_TILT_MAX`/`BRAKE_TILT_MAX_MANUAL` 3.0→5.0° (más margen de inclinación para frenar, todavía lejos de los 60° de caída). (2) PI de velocidad del seguidor de línea (`LINE_STATE_FOLLOWING`): nueva ganancia `LINE_VEL_KP_BRAKE=7.0` (antes usaba la misma `LINE_VEL_KP=3.0` para acelerar y frenar) aplicada solo cuando `vel_error<0` (sobrevelocidad); clamp de `line_angle_cmd` ampliado de `[-1.5, LINE_ANGLE]` a `[-3.0, LINE_ANGLE]`; el guard posterior sobre `dynamic_setpoint_f` en LINE_FOLLOWING (que reclipeaba a -1.5°) también ampliado a -3.0° para no anular el freno más fuerte. Pendiente de validar en el robot que no overshootee hacia atrás con la ganancia más alta. | El freno era demasiado débil: sin línea, cero corrección hasta 1.5 m/s; con línea, mismo gain P para acelerar y frenar con clamp muy chico (-1.5°) |
| 2026-07-01 | Core/Src/main.c | **Fix crítico de signo en `SampleEncoders250us`**: `encoder_right/left += quad_delta[...]` cambiado a `-= quad_delta[...]`. La tabla estándar de decodificación de cuadratura (`quad_delta`) da la convención de signo opuesta a la que tenía el conteo viejo por EXTI (verificado a mano, transición por transición, para la misma secuencia física de giro: EXTI daba +1 por ciclo, la tabla da -1). Con el signo sin corregir, `velocity_est_f` quedaba invertido y `ComputeBrakeSetpointTarget()` (usado en casi todos los estados para frenar traslación y mantener el balance estático) empujaba el setpoint de inclinación en el sentido del movimiento en lugar de contrario — realimentación positiva en vez de negativa. | Usuario reportó tras la migración de encoders (punto anterior) que "se rompió toda la parte de balance" y el robot se aceleraba en vez de mantenerse balanceado — la velocidad de encoders alimenta el freno traslacional que sostiene el balance estático en reposo |
| 2026-06-30 | Core/Src/main.c | Agregado `line_error_trim_f = 0.05f`: offset constante sumado al centroide de línea (`line_error += line_error_trim_f`). Corrige deriva sistemática a la derecha causada por desplazamiento físico del array de sensores respecto al eje del robot. Ajustar empíricamente de a 0.05 hasta que el robot siga centrado. Positivo = corrige deriva derecha. | La calibración ADC_BASELINE no puede corregir un offset mecánico de montaje: cuando los sensores están centrados sobre la línea el error=0 y el PID no corrige, aunque el cuerpo esté desplazado |
| 2026-06-29 | Core/Src/main.c | LOST_ROTATE overshoot fix: `LROT_ENC_FRAC` 0.70→0.60 (frena al 60% del recorrido encoder, antes 70%); heading threshold fase 0→1 bajado de 80%→70% del target (126° en vez de 144°); `LROT_BRAKE` 5→8 (freno más fuerte en fase 1); `LROT_P1_MAX` 400→500ms. Robot hacía ~220° en vez de 180°. | La fase de freno empezaba muy tarde (144°) con freno suave (5 PWM), sin tiempo para frenar antes de los 180° |
| 2026-06-29 | Core/Src/main.c | LOST_FWD regulación de velocidad: setpoint ahora idéntico a WALL_FWD — si `velocity_est_f` supera `OBJ_WALL_OVERSPEED_VEL` (0.90 m/s), aplica `-OBJ_WALL_BRAKE_ANGLE` (-1.0°) en lugar de `OBJ_WALL_APPROACH_ANGLE` (+2.0°). Antes: ángulo fijo 2° sin ningún límite → robot se aceleraba hasta velocidad completa en AVNZA. | Robot se aceleraba excesivamente después del giro 180° al avanzar buscando la línea |
| 2026-06-29 | Core/Src/main.c | Control de velocidad mejorado en modo línea: (1) Floor de curvas 25%→10% (`LINE_SPEED_TARGET * 0.10f`): en curva cerrada el robot frena casi al mínimo. (2) Clamp de freno del PI de velocidad ampliado -1.0°→-1.5°. (3) Guard final `dynamic_setpoint_f` ampliado 1.0°→1.5° para permitir el freno extra. (4) Limitador global: si avanza >90% de `LINE_SPEED_TARGET` en cualquier sub-estado sin brake propio (LOST_FWD, LOST, WALL_APPROACH, etc.), llama a `ComputeBrakeSetpointTarget`. (5) Barras ADC pantalla 1 reducidas al 75% de altura. | Robot se aceleraba al perder la línea y en curvas; barras ADC tapaban zona superior del display |
| 2026-06-29 | Core/Src/main.c | `LINE_STATE_LOST_BRAKE` nuevo: al entrar a LOST, frena primero (upright + freno encoders) hasta `|velocity_est_f| < 0.15 m/s` o timeout 1500ms, luego pasa a LOST_ROTATE. `LROT_PIVOT` 12.0, `LROT_BRAKE` 5.0, `LROT_P0_MAX` 4000ms. Nombres de display actualizados (SIGUE/PERDI/FRENA/GIRO/AVNZA/ESPER/RETRO/STOP/ESQUIV/PAUSA/APRCH/PARED/GIRAP). | Giro más rápido y sin spike de corriente (robot ya está quieto al iniciar pivot) |
| 2026-06-29 | Core/Src/main.c | (reemplaza) `LROT_PIVOT` reducido de 15.0→5.0, `LROT_BRAKE` 5.0→3.0, `LROT_P0_MAX` 2400→4000ms en LOST_ROTATE. Al entrar a LOST_ROTATE desde FOLLOWING (robot en movimiento), el motor izquierdo puede revertir dirección súbitamente creando un spike de corriente → glitch VDD → CSS fires NMI → NVIC_SystemReset(). Con pivot=5 el spike es ~67% menor. Timeout alargado para compensar la velocidad reducida. | Freeze+reset durante el giro de 180° post-LOST (CSS/NMI por EMI) + giro más lento pedido por usuario |
| 2026-06-29 | Core/Src/main.c | Detección "en el aire": `f_in_air=1` si `adcAvg[0..3]` están todos por encima de `LINE_THRESHOLD` durante más de 2000ms en modo LINE_FOLLOWING. Cuando `f_in_air=1` → `motorRight=motorLeft=0` antes de `MotorControl()` → motores detenidos. Se limpia cuando cualquier sensor baja el umbral (robot toca superficie). Variables: `all_black_start_ms`, `f_in_air` (file-scope). | Robot quedaba en modo seguidor de línea con motores andando mientras lo sostenías en el aire |
| 2026-06-29 | Core/Src/main.c | Timeout FOLLOWING→LOST reducido de 2000→800ms. | Robot tardaba 2s en iniciar el giro de búsqueda después de perder la línea |
| 2026-06-29 | Core/Src/main.c | `KI_LINE` habilitado: 0.0→0.5. `ADC_BASELINE` calibrado sobre fondo blanco: {2000, 1550, 1370, 1730}. Sin baseline, el centroide estaba sesgado hacia el sensor con mayor lectura en blanco (s0=2000) → robot seguía la línea tirado a la derecha. | Sesgo derecho constante en seguidor de línea |
| 2026-06-29 | Core/Src/main.c | LOST → LOST_ROTATE inmediato: eliminadas condición de velocidad y timer de 3s. En cuanto el robot entra en LOST y no ve línea, el giro de 180° arranca en el siguiente ciclo (10ms). Antes: `velocity_est_f < 0.08f` era imposible de cumplir con 24 CPR (mínimo detectable 0.74 m/s), y el timer de 3s se reiniciaba por flickers de sensor. | Robot a veces nunca hacía el giro de búsqueda |
| 2026-06-27 | Core/Src/main.c | Bug auditoría — `obj_detect_ignore_until_ms` faltante en 4 transiciones: OBJ_HOLD→FOLLOWING por f_fallen, OBJ_WALL_APPROACH→FOLLOWING por f_fallen, OBJ_WALL_APPROACH→FOLLOWING por timeout, LOST_ROTATE→FOLLOWING por line_detected. Todas setean +5000ms ahora. | `obj_cnt` llega a 10 durante secuencias OBJ y re-dispara la evasión al volver a FOLLOWING si el objeto todavía es visible |
| 2026-06-27 | Core/Src/main.c | Bug auditoría — `balance_hold_active` podía activarse en LINE_STATE_LOST y LINE_STATE_SEARCHING: si el robot recibía un empujón leve que no superaba los umbrales de salida del hold (0.9°/10 dps), los motores quedaban apagados mientras el robot derivaba. Fix: agregar LOST y SEARCHING a la lista de exclusión del `balance_hold_active`. | Robot en LOST derivaba sin que los motores reaccionaran ante perturbaciones leves |
| 2026-06-27 | Core/Src/main.c | Bug "tonto post-evasión": `obj_cnt` llega a `OBJ_DETECT_DEBOUNCE_CNT=10` durante la secuencia OBJ y queda en 10 (capped). Al volver a FOLLOWING con objeto aún visible, `obj_cnt >= 10` dispara OBJ_PRE_REVERSE_HOLD inmediatamente → robot re-entra en evasión en loop. Fix: `obj_detect_ignore_until_ms = HAL_GetTick() + 5000U` en las transiciones OBJ_WALL_FWD→FOLLOWING, OBJ_WALL_TURN→FOLLOWING, y OBJ_WALL_APPROACH→FOLLOWING por timeout. | Robot seguía línea, esquivaba objeto, y al terminar la evasión se quedaba "tonto" sin seguir |
| 2026-06-27 | Core/Src/main.c | Display seguidor de línea: barras ADC 1-4 reducidas en altura (reservan 4px arriba para indicador). Indicador negro/blanco: cuadrado relleno=negro (ADC > LINE_THRESHOLD), borde=blanco. Las barras ADC 5-8 no cambian. | Las barras al máximo tapaban el indicador |
| 2026-06-27 | Core/Src/main.c | Bug crítico spin: causa raíz = floor 25% eliminado. Con `speed_factor=0` en curva cerrada (|line_error|≥0.45), `desired_vel=0` → PI da `line_angle_cmd=0` → `base_setpoint_target=0°` → robot equilibrado en 0° → `pwm_sat→0` → `steering_adjustment` residual produce spin puro. Fix: restaurado floor 25% (`desired_vel = max(0.25×LST, LST×sf)`), `brake_limit` fijo en -1.0° (V10). `balance_hold` restaurado a condición V10: excluido solo cuando `line_detected` (no en todo LINE_FOLLOWING). `steering_adjustment` conservado cuando `!line_detected` para ayudar al robot a volver a la línea. | Robot no seguía línea en absoluto tras quitar el floor — el setpoint caía a 0° en curvas y el robot giraba en su lugar sin avanzar |
| 2026-06-27 | Core/Src/main.c | Bug crítico LOST_ROTATE: `line_lost_ms` al entrar a LOST ya tenía 2000ms de antigüedad, por lo que `>500U` se cumplía inmediatamente → el robot giraba 180° al instante de perder la línea. Fix: nueva variable `line_lost_entered_ms` seteada al entrar a LOST; condición cambiada a `>3000U` desde ese timer. Ahora el robot espera 3s quieto en LOST antes de girar. | Robot "tonto" en la línea: entraba a LOST_ROTATE casi inmediatamente después de perder la línea, sin dar tiempo a recuperarla |
| 2026-06-27 | Core/Src/main.c | `OBJ_DETECT_THRESHOLD_VAL` bajado 3200→2000 y `OBJ_DETECT_DEBOUNCE_CNT` subido 3→10 (100 ms). Requiere que el objeto cause una caída de ADC más pronunciada Y que se mantenga 100 ms consecutivos antes de disparar la evasión. | Falsos positivos: entraba en modo esquive sin objeto real presente |
| 2026-06-27 | Core/Src/main.c | Pantalla 6 nueva (f_change_display==6): al entrar en cualquier estado OBJ_* del seguidor de línea, el display cambia automáticamente a pantalla de evasión que muestra el nombre del estado en Font_7x10 centrado (WAIT/REVERS/BRAKE/ROTATE/HOLD/WF_APR/WF_FWD/WF_TRN) + barra vertical ADC5 (sensor frontal) y barra vertical ADC7 (sensor lateral) con valor numérico. Al salir de OBJ vuelve a display 1. Detección vía `prev_line_state_disp >= LINE_STATE_OBJ_PRE_REVERSE_HOLD`. | Diagnóstico visual de cuándo el robot entra y sale del modo de evasión, y estado de los sensores de objeto |
| 2026-06-27 | Core/Src/main.c | Pantalla 1 (seguidor de línea) — panel derecho rediseñado: eliminado "LINE" del header superior (solo queda icono WiFi), eliminada línea VE (velocidad), sub-estado (FOLLOW/LOST/SEARCH/LROT/LFWD) ahora se muestra en Font_7x10 centrado (en vez de Font_5x7). Spinner reducido (spokes ±3) y movido a y=59. | Más espacio y legibilidad para el estado actual del seguidor de línea |
| 2026-06-26 | Core/Src/stm32f4xx_it.c | `NMI_Handler`, `BusFault_Handler`, `MemManage_Handler`, `UsageFault_Handler`: agregado `NVIC_SystemReset()` antes del `while(1)`. Antes quedaban en loop infinito → IWDG expiraba después de 2s de freeze. Ahora cualquier fault produce reset inmediato. Causa probable durante acción de motores: caída VDD → glitch HSE → CSS dispara NMI, o EMI PWM → acceso DMA inválido → BusFault. | HardFault ya tenía reset; los otros 4 no → 2s de robot congelado con motores fijos. |
| 2026-06-27 | Core/Src/main.c | `LINE_STATE_LOST_FWD` (nuevo estado): después del giro de 180° (LOST_ROTATE), avanza con ángulo fijo 2° hasta encontrar la línea → FOLLOWING. Timeout 10s de seguridad → LOST. Display: "LFWD". | Post-180° el robot no está sobre la línea; volver a LOST inmediatamente disparaba otro ciclo LOST→ROTATE indefinidamente. |
| 2026-06-26 | Core/Src/main.c | `LINE_STATE_LOST_ROTATE` (nuevo estado): cuando el robot pierde la línea y la velocidad de encoders cae por debajo de 0.08 m/s (mínimo 500ms en LOST), hace un giro de 180° derecha con la misma lógica gz+encoder que MANUAL/OBJ_ROTATE. Si detecta la línea durante el giro → FOLLOWING inmediato. Al terminar el giro → vuelve a LOST para re-buscar. Parámetros: ENC_TARGET=760 (380×2), PIVOT=15, BRAKE=5, SLOWDOWN=55°, P0_MAX=2400ms. Display: "LROT". | Robot se quedaba en LOST indefinidamente sin buscar activamente la línea. |
| 2026-06-26 | Core/Src/main.c | `LINE_STATE_OBJ_BRAKE`: `PRE_ROTATE_MS` 1000→2000ms. Pausa más larga post-reversa para que el robot se estabilice antes del giro. | El robot entraba al giro todavía con algo de movimiento residual. |
| 2026-06-26 | Core/Src/main.c | `LINE_STATE_OBJ_ROTATE`: parámetros igualados a MANUAL: `ENC_TARGET` 325→380, `PIVOT` 8→15, `BRAKE` 3→5, `SLOWDOWN_DEG` 35→55, `P0_MAX` 3000→1200ms, `P1_MAX` 500→300ms, clamp motores ±30→±60. Heading compuesto gz+encoder, slowdown ramp, overshoot detection. | Con PIVOT=8 el giro era demasiado suave y no llegaba a 90°. Parámetros idénticos a MANUAL garantizan comportamiento equivalente. |
| 2026-06-26 | Core/Src/main.c | `LINE_STATE_OBJ_REVERSE`: `rev_target_counts` 10→200 (~10 cm). Retroceso re-habilitado para dar espacio antes del giro y no chocar el objeto con la carrocería. | 10 counts era prácticamente nada. |
| 2026-06-25 | Core/Src/main.c | Fix giro izquierda 90°: (1) `phase0_max_ms` reducido 1000→600 ms para 90°: con gz≈0 el fallback ya no gira 1 s entero. (2) `gz_settled`: `gz<12` en fase 1 solo sale DESPUÉS de 300 ms mínimos (antes salía en la 1ra iteración sin frenar). `phase1_max_ms` 400→500 ms. | gz no acumula bien CCW → fase 0 duraba 1 s → fase 1 salía a los 0 ms → 370°+ de inercia sin frenar. |
| 2026-06-25 | Core/Src/main.c | Fix overshoot 180°: `enc_exit_frac = 0.85 - max(0,(angle-90)/90)*0.15` → 90°=0.85 sin cambio, 180°=0.70 entra al freno antes. Auto-ciclo extendido a 3 pasos: 90°R → 90°L → 180°R (% 3). `MANUAL_ROT_ENC_TARGET` calibrado empíricamente a 380 counts/90°. | 180° acumulaba el doble de momentum; entrar a fase 1 al 70% da tiempo de freno suficiente sin afectar los giros de 90°. |
| 2026-06-25 | Core/Src/main.c | Encoder feedback para heading en rotación MANUAL: `enc_heading_deg = avg(|dr|+|dl|)/2 × (90/325)` calculado en cada ciclo. Heading compuesto = `max(gz, enc)`. Usado en: (1) transición fase 0→1 al 55% — ahora funciona para giro izquierda donde gz≈0; (2) slowdown usa `abs_remaining = abs_target - abs_heading` con heading compuesto; (3) salida anticipada de fase 1 cuando `enc >= 95%` del target (mínimo 60 ms). 325 counts = 90° confirmado empíricamente desde OBJ_ROTATE. | Giro izquierda no tenía feedback angular (gz≈0 en CCW) y dependía solo del tiempo (500 ms fallback). Encoders dan precisión simétrica para ambos sentidos. |
| 2026-06-25 | Core/Src/main.c | Fix "va y vuelve" en giro automático MANUAL: `MANUAL_ROT_BRAKE_POWER` 15→5 (freno suave, diferencial 10 PWM en lugar de 30), `phase0_max_ms` 600→400 ms (menos momentum acumulado), `phase1_max_ms` 500→250 ms, mínimo gz_settled 300→120 ms. Causa raíz: con BRAKE=15 y 500 ms de contra-rotación, la fase de freno acumulaba suficiente momentum inverso para revertir el giro completo → el robot volvía a ~0° dando la ilusión de un segundo giro en sentido contrario. Con freno más suave el robot desacelera y se queda en la nueva orientación. | Síntoma: robot giraba derecha y volvía izquierda (overshoot de fase 1), no un segundo trigger del auto-ciclo. |
| 2026-06-25 | Core/Src/main.c | Fix colapso post-giro derecha: fase 1 ahora usa `-(pwm_sat ∓ dir×BRAKE)` en lugar de `±dir×BRAKE` puro. La diferencia entre ambos motores sigue siendo 2×BRAKE_POWER (frena inercia rotacional, constante independiente de pwm_sat), mientras que el modo común `pwm_sat` mantiene el balance PID activo durante los 500 ms de freno. | Con `±dir×BRAKE` puro (sin pwm_sat), el PID de balance calculaba pero no se aplicaba → robot se inclinaba durante el freno → caída al terminar el giro. |
| 2026-06-25 | Core/Src/main.c | Fix secuencia automática de giros: `manual_auto_rot_last_ms` (elapsed desde último trigger) reemplazado por `manual_seq_next_ms` (deadline absoluto). La pausa de 2.5 s ahora se setea como `HAL_GetTick() + 2500` exactamente cuando el giro TERMINA (en ambas ramas de salida: fase 1 normal y timeout). El trigger de respaldo al disparar se setea a `+10000` para que nunca compita con el deadline real. Al entrar a MANUAL_CONTROL se setea `+2500` para dar pausa inicial. | Con la variable elapsed, la pausa se podía medir desde el trigger (no desde el fin), acortando efectivamente la pausa visible entre giros. |
| 2026-06-23 | Core/Src/main.c | Fix giro izquierda modo MANUAL (3ra iteración): fase 1 ahora usa freno puro sin `pwm_sat`. Causa raíz: en la fórmula `motorR = -(pwm_sat + dir*pivot)`, cuando `pwm_sat` es grande, ambos motores terminan con el mismo signo → TIM3/TIM4 ambos en modo "dirección forward" → efecto traslacional puro, sin diferencial de rotación → freno inefectivo. Con `motorR = dir*BRAKE, motorL = -dir*BRAKE` el freno es independiente del balance y siempre produce el diferencial correcto. El robot puede inclinarse levemente durante el freno pero la fase 1 es corta (<1s). |
| 2026-06-23 | Core/Src/main.c | Fix giro izquierda modo MANUAL: (1) `MANUAL_ROT_SLOWDOWN_DEG` 35°→55° — el slowdown nunca se activaba porque la transición fase 0→1 dispara a 49.5° (55% de 90°) pero el slowdown empieza a 90-35=55°, es decir DESPUÉS de la transición. Con 55° empieza a 35°, dentro de la zona activa. (2) Condición de salida de fase 1: `crossed_zero` corregido a `reversed` (la versión anterior era inversa y salía mientras el robot AÚN giraba en la dirección original). Ahora: `reversed = (gz_dps * gz_sign < 0)` = verdadero cuando gz realmente cambió de signo (freno sobrecompensó). Overshoot guard bajado a 120% (era 150%). Salida: `|gz|<12 || overshoot || (reversed && |gz|<40)`. (3) Comentario del ciclo auto actualizado (no hay 180° en el ciclo actual). | `crossed_zero` invertido causaba: derecha=queda corto (salía con robot AÚN girando CW), izquierda=hace 180° (overshoot a 135° + inercia) |
| 2026-06-02 | Core/Src/main.c | Fix sobrepaso de giro preciso: `MANUAL_ROT_PIVOT_POWER` 12→7, `MANUAL_ROT_SLOWDOWN_DEG` 15→35°, mínimo de potencia 0.3→0.0. Agregado `MANUAL_ROT_BRAKE_POWER=5` y `manual_rot_phase`: fase 0=avance (para al 72% del ángulo), fase 1=contra-pivot activo hasta que `gz < 15 dps` y `heading ≤ target + 3°`. Fix balance MANUAL≡BALANCE_ONLY: `pwm_limit` MANUAL 55→100 (anti-windup ahora idéntico), `BRAKE_TILT_STEP_MAN` 0.3→0.5 | Sobrepaso excesivo en giro de 90°; balance MANUAL diferente a BALANCE_ONLY en anti-windup e integral |
| 2026-06-02 | Core/Src/main.c | Giro automático en modo MANUAL: cada 5 s (desde entrada al modo o desde fin del giro anterior) dispara `manual_rot_target_deg=90°` + `manual_rot_trigger=1` si no hay giro activo ni caída. Variable `manual_auto_rot_last_ms` reseteada al entrar en MANUAL y al finalizar cada giro. | Demo/prueba de giros precisos sin intervención desde Qt |
| 2026-06-02 | Core/Inc/UNER.h, Core/Src/UNER.c, Core/Src/main.c | Giro preciso en modo MANUAL: 5 comandos UNER nuevos (`ROTATE_90_RIGHT=0xD5`, `ROTATE_90_LEFT=0xD6`, `ROTATE_180_RIGHT=0xD7`, `ROTATE_180_LEFT=0xD8`, `ROTATE_CUSTOM=0xD9` con float 4 bytes). Sensor primario: giroscopio gz integrado a 100 Hz. Slowdown en los últimos `MANUAL_ROT_SLOWDOWN_DEG=15°` (baja de 100% a 30% de `MANUAL_ROT_PIVOT_POWER=12`). Timeout dinámico proporcional al ángulo. Registro: `UNER_RegisterRotationCmd(&manual_rot_target_deg, &manual_rot_trigger)`. Qt debe informar mismo protocolo | Necesidad de giros precisos desde Qt sin tocar el seguidor de línea |
| 2026-06-02 | Core/Src/main.c | Detección de "puesto en el piso" en modo LINE: si los 4 sensores de línea (`adcAvg[0..3]`) estaban todos por encima de `LINE_THRESHOLD` (robot en el aire) y alguno baja, se activa `obj_detect_ignore_until_ms = HAL_GetTick() + 3000` para ignorar obstáculos 3s. Evita que la mano al soltar el robot dispare la evasión. Variable `prev_all_line_black` (file-scope, init=1) lleva el estado del ciclo anterior | La mano bajo los sensores al soltar el robot disparaba obj_detect constantemente |
| 2026-06-01 | Core/Src/main.c, Core/Src/stm32f4xx_it.c | ADC CH5–CH8 (`adcAvg[4..7]`, sensores de objeto) cambiados a `ADC_SAMPLETIME_144CYCLES` (antes 15 ciclos) para mayor sensibilidad/rango de detección de objetos. Fix crítico 1: CubeMX reseteó prioridades DMA1_S0/S1, DMA2_S0 y EXTI15_10 a 0 → I2C DMA freeze; corregido forzando prioridades en USER CODE BEGIN 2. Fix crítico 2: CubeMX borró `EXTI9_5_IRQHandler` completo y mutiló `EXTI15_10_IRQHandler` (sin manejo de PB13/14/15) → CPU en Default_Handler loop infinito al primer pulso de encoder; restaurados manualmente en stm32f4xx_it.c | Tras cualquier regeneración de CubeMX: `git diff Core/Src/stm32f4xx_it.c` primero |
| 2026-05-28 | Core/Src/main.c | `OBJ_WALL_FWD` dejó de regular velocidad fina con PI: ahora usa `OBJ_WALL_FWD_ANGLE=4.5f` constante mientras `ADC7` está entre `500` y `3750`, frena solo si `velocity_est_f` supera `OBJ_WALL_OVERSPEED_VEL=0.90f`, y aplica corrección yaw con giroscopio igual que hold/lost. `OBJ_WALL_TOO_CLOSE_THOLD` ajustado a `500.0f` | Los encoders son demasiado cuantizados para controlar `0.25 m/s`; el PI alternaba avance/freno y el robot bamboleaba sin avanzar recto |
| 2026-05-28 | Core/Src/main.c | `OBJ_WALL_FWD_ANGLE` aumentado de `2.5f` a `4.5f` | El ángulo máximo anterior era demasiado chico y el robot no avanzaba durante `OBJ_WALL_FWD` |
| 2026-05-27 | Core/Src/main.c | `OBJ_DETECT_THRESHOLD_VAL` cambiado de `2000.0f` → `3200.0f`. El sensor detecta objeto cuando `adcAvg[4..7] < 3200`. Se alargó la distancia de sensado cambiando resistencias en hardware, por lo que el ADC ahora satura antes y el umbral viejo quedaba corto | Hardware actualizado: sensores de objeto ahora responden a mayor distancia |
| 2026-05-27 | Core/Src/main.c | `rev_target_counts` en `LINE_STATE_OBJ_REVERSE` reducido de `300` → `150` counts (exactamente la mitad). Reduce el recorrido de retroceso antes del giro de evasión | Recorrido anterior era excesivo para la nueva distancia de detección; la mitad es suficiente para despejar el obstáculo |
| 2026-05-27 | Core/Src/main.c | OBJ_REVERSE y OBJ_BRAKE deshabilitados temporalmente: `OBJ_PRE_REVERSE_HOLD` ahora transiciona directo a `OBJ_ROTATE` en lugar de `OBJ_REVERSE`. Cadena activa: FOLLOWING → WAIT(2s) → ROTATE → HOLD(2s) → ARC → FOLLOWING. Los estados OBJ_REVERSE y OBJ_BRAKE permanecen en el enum y en el código pero nunca se alcanzan | Simplificar la evasión para probar sin reversa; se puede re-habilitar en una línea |
| 2026-05-27 | Core/Src/main.c | `OBJ_ARC_DIFF_TARGET` corregido de `-0.5f` → `+0.5f`. Validación empírica mostró que la convención `speed_right_rps_s - speed_left_rps_s` tiene signo opuesto al esperado en esta plataforma: positivo produce giro a la izquierda, negativo a la derecha. Comentarios en el código actualizados para reflejar la convención real | El robot giraba a la derecha con `-0.5f`; la corrección de signo lo invierte a la izquierda |
| 2026-05-27 | Core/Src/main.c | `OBJ_ARC_STEER` (open-loop, constante) reemplazado por PI cerrado sobre diferencial de encoders. Nuevo parámetro tunable `OBJ_ARC_DIFF_TARGET` [rps] = diferencial deseado `(speed_right - speed_left)`; positivo = gira izquierda. Ganancias: `OBJ_ARC_KP=15.0`, `OBJ_ARC_KI=3.0`, saturación ±`OBJ_ARC_STEER_MAX=30`. Anti-windup: si satura, deshace el último paso de integral. Variable de estado `obj_arc_steer_int` file-scope, reseteada en caída y al salir del estado | Open-loop era inconsistente: el radio del arco variaba con la batería y asimetrías mecánicas; el PI lo regula midiendo la diferencia real de encoders |
| 2026-05-27 | Core/Src/main.c | Agregado `LINE_STATE_OBJ_ARC`: avanza en arco con PI de diferencial de encoders hasta re-detectar línea → vuelve a FOLLOWING con integrales limpios. OBJ_HOLD modificado: ahora tiene timer `OBJ_HOLD_DURATION_MS=2000ms` y sale a OBJ_ARC (antes se quedaba indefinidamente). `obj_hold_start_ms` file-scope, reseteado en caída. Parámetros: `OBJ_ARC_DIFF_TARGET=0.5f` (izquierda), `OBJ_ARC_ANGLE=1.0°`. Cadena completa: FOLLOWING → WAIT → REVERS → BRAKE → ROTATE → HOLD(2s) → ARC → FOLLOWING | El robot se quedaba en HOLD para siempre sin reincorporarse a la línea; el arco completa la evasión y re-engancha el seguidor |
| 2026-05-27 | Core/Src/main.c | `obj_rev_initialized` ahora se resetea a 0 en el bloque de detección de caída (f_fallen=1). Sin este fix, si el robot caía durante OBJ_REVERSE y se recuperaba, el snapshot de encoder era viejo y `rev_counts >= 300` inmediatamente → saltaba a OBJ_BRAKE sin retroceder. Mismo patrón del bug ya corregido en OBJ_ROTATE | Bug: encoder snapshot stale post-caída durante OBJ_REVERSE |
| 2026-05-27 | Core/Src/main.c | `brake_start_ms` en `OBJ_BRAKE` promovido de `static` local a variable de archivo `obj_brake_start_ms`. Reseteado a 0 en: detección de caída, transición OBJ_REVERSE→OBJ_BRAKE, y al salir del estado. Sin fix: si el robot caía durante OBJ_BRAKE, al recuperarse el tiempo transcurrido superaba el timeout (1500ms) y saltaba a OBJ_ROTATE sin frenar | Bug idéntico al que afectaba a OBJ_ROTATE con `rot_initialized` |
| 2026-05-27 | Core/Src/main.c | `obj_rot_initialized` y `obj_rot_start_ms` ahora se resetean en el bloque de caída. Sin fix: si el robot caía durante OBJ_ROTATE, los counts acumulados durante el rodamiento sumaban al snapshot previo → el conteo podía superar target_counts=325 inmediatamente al recuperarse → saltaba a OBJ_HOLD sin haber girado | Mismo patrón de bug: snapshot de encoder stale post-caída en OBJ_ROTATE |
| 2026-05-27 | Core/Src/main.c | `KV_brake_value` (registrado con UNER para el slider "KV" en Qt) ahora se usa en `ComputeBrakeSetpointTarget` en lugar de la constante compilada `KV_BRAKE_STRONG`. Antes el slider de Qt enviaba valores a `KV_brake_value` pero la función de freno ignoraba la variable y usaba siempre 5.0f | Bug funcional: el ajuste de freno desde Qt no tenía efecto en runtime |
| 2026-05-27 | Core/Src/main.c | `line_error_f_d` agregado al bloque de caída y al bloque de recuperación (antes solo se limpiaba en las transiciones de estado). Sin esto, al retomar OBJ_REVERSE después de una caída, el término derivado del PID de línea tenía un spike de hasta ±16 en el primer ciclo | Previene spike de steering en primer ciclo post-caída en OBJ_REVERSE |
| 2026-05-27 | Core/Src/main.c | `line_obj_rev_vel_integral` y `line_error_f_d` agregados al bloque de recuperación (f_fallen→0). El bloque de caída ya los limpiaba, pero durante los ciclos de caída el integral se re-acumulaba (el bloque de velocidad corre antes de la detección de caída). Al recuperarse, ahora se garantiza que el integral arranca desde 0 | Consistencia: garantiza estado limpio al arrancar de recuperación, no solo en el ciclo de caída |
| 2026-05-27 | Core/Src/main.c | `obj_hold_initialized` eliminado: era una variable de archivo declarada (línea ~379) y reseteada en OBJ_ROTATE→OBJ_HOLD, pero nunca leída ni escrita en el case OBJ_HOLD — dead code puro | Limpieza: la variable fue parte de un hold personalizado que se simplificó y quedó sin uso |
| 2026-05-27 | Core/Src/main.c | Agregado `LINE_STATE_OBJ_ARC`: avanza en arco con `OBJ_ARC_STEER=20` y `OBJ_ARC_ANGLE=1.2°` hasta re-detectar línea → vuelve a FOLLOWING. OBJ_HOLD ahora tiene timer `OBJ_HOLD_DURATION_MS=2000ms` y sale a OBJ_ARC. `obj_hold_start_ms` file-scope, reseteado en caída. Cadena completa: FOLLOWING→WAIT→REVERS→BRAKE→ROTATE→HOLD→ARC→FOLLOWING | El robot se quedaba en HOLD indefinidamente sin reincorporarse a la línea |
| 2026-05-27 | Core/Src/main.c | Bloque de recuperación (f_fallen→0): corregida indentación extra en `line_integral = 0.0f` y variables reordenadas para consistencia visual con el bloque de caída | Cosmético |
| 2026-05-27 | Core/Src/main.c | `OBJ_WALL_FWD`: PI de velocidad eliminado (era la causa del "no avanza" — el robot en WALL_TURN con PIVOT_POWER=5 no salía del sitio, y el PI en WALL_FWD nunca llegaba a empujar). Reemplazado por ángulo fijo `OBJ_WALL_FWD_ANGLE=5.5°`. El PID de balance regula la inclinación directamente. Eliminados defines `OBJ_WALL_SPEED_TARGET`, `OBJ_WALL_VEL_KP`, `OBJ_WALL_VEL_KI`, `OBJ_WALL_VEL_I_MAX`. `obj_wall_vel_int` mantenida pero solo se resetea. | Robot se quedaba completamente detenido en WF_FWD |
| 2026-05-27 | Core/Src/main.c | `OBJ_WALL_PIVOT_POWER` aumentado de 5.0 → 20.0. Con 5.0 PWM el diferencial era insuficiente para rotar (por debajo del umbral efectivo de los motores). Con 20 el robot pivotea con claridad. | WALL_TURN no giraba — potencia insuficiente |
| 2026-05-27 | Core/Src/main.c | Detección "demasiado cerca" en WALL_FWD y WALL_TURN: si `adcAvg[6] < OBJ_WALL_TOO_CLOSE_THOLD=300`, pivotea derecha (mismo signo que OBJ_ROTATE) en lugar de avanzar/izquierda. Prioridad: `line_detected` > `too_close` > `!wall_visible` > avance. Nuevo define `OBJ_WALL_TOO_CLOSE_THOLD=300.0f`. | Evitar que el robot choque con el obstáculo cuando se acerca demasiado |
| 2026-05-27 | Core/Src/main.c | `steering_adjustment = 0.0f` explícito en rama de avance de WALL_FWD (cuando wall_visible y no too_close). Antes: valor residual de OBJ_HOLD podía causar desvío no deseado. | Prevenir desvío lateral al avanzar junto al objeto |
| 2026-05-27 | Core/Src/main.c | `obj_wall_vel_int = 0.0f` agregado en transición OBJ_HOLD→WALL_FWD. | Estado limpio al entrar en wall-following |
| 2026-05-27 | Core/Src/main.c | `OBJ_WALL_PIVOT_POWER` ajustado de 20.0 → 8.0 (20 era demasiado agresivo). `OBJ_WALL_LINE_IGNORE_MS=3000` agregado: al entrar a WALL_FWD se ignora `line_detected` durante 3s para no volver a FOLLOWING al pasar sobre la línea original. `obj_wall_fwd_start_ms` nuevo file-scope, inicializado al entrar desde OBJ_HOLD o WALL_TURN, reseteado al salir. | Robot volvía a FOLLOWING inmediatamente al cruzar la línea y el pivot era excesivo |
| 2026-05-26 | Core/Src/main.c | Detección de objetos re-habilitada: `obj_now` restaurado a `adcAvg[4..7] < OBJ_DETECT_THRESHOLD_f` (estaba forzado a 0). Cadena de evasión FOLLOWING→OBJ_REVERSE→OBJ_BRAKE→OBJ_ROTATE→OBJ_HOLD activa nuevamente | Se había deshabilitado para trabajar solo en seguimiento de línea |
| 2026-05-26 | Core/Src/main.c | OBJ_REVERSE: cuando no hay línea visible, `steering_adjustment` ahora usa feedback de encoders `(rev_dr - rev_dl) × REV_ENC_KP(0.05)` en lugar de 0. Compensa asimetría mecánica de la rueda izquierda que retrocede menos que la derecha | Reversa torcida: motor izquierdo tiene mayor resistencia en ese sentido |
| 2026-05-26 | Core/Src/main.c | `OBJ_REVERSE` reemplaza el setpoint fijo `-1.5°` por PI de velocidad hacia atrás (`LINE_OBJ_REV_*`) y usa PID de línea con error invertido, limitado por `LINE_OBJ_REV_STEER_MAX`. El clamp negativo de modo línea permite `-LINE_OBJ_REV_TILT_MAX` solo en reversa por obstáculo | Mantenerse sobre la línea al retroceder ante obstáculos, inclinando hacia atrás como el seguidor inclina hacia adelante |
| 2026-05-26 | Core/Src/main.c | Agregado `LINE_STATE_OBJ_PRE_REVERSE_HOLD`: al detectar obstáculo espera `OBJ_PRE_REVERSE_HOLD_MS=2000` en balance estático con freno por encoders antes de pasar a `OBJ_REVERSE`. Display muestra `WAIT` durante esa pausa | Suavizar la transición entre seguimiento de línea y marcha atrás |
| 2026-05-04 | CLAUDE.md | Lectura inicial completa del proyecto: hardware, periféricos, PID, protocolo UNER, arquitectura real de archivos | Primera documentación desde el código fuente |
| 2026-05-07 | Core/Src/main.c | Agregado soporte de encoders por cuadratura vía EXTI: variables `encoder_right/left`, GPIO init PA8/PB13/PB14/PB15, callbacks EXTI y cálculo de `speed_right/left_rps` en `ControlStep10ms` | Medición real de velocidad de ruedas con encoders físicos |
| 2026-05-07 | Core/Src/main.c | `velocity_est`/`velocity_est_f` ahora alimentados desde encoders (`vel_enc = promedio(speed_right_rps, speed_left_rps) × ENC_VEL_SCALE`). Eliminadas las 3 llamadas a `UpdateVelocityEstimate` (accel+gyro). Display "VE:" ya mostraba `velocity_est_f` sin cambios. `ENC_VEL_SCALE=0.17750f` (radio 2.825 cm). | Velocidad real de ruedas en lugar de estimación por fusión inercial |
| 2026-05-07 | Core/Src/main.c | Agregada infraestructura para steering de lazo cerrado por encoders: `ComputeSteeringPID()`, `SteeringPID_Reset()`, flag `steer_pid_enabled`. Por defecto deshabilitado (=0, comportamiento idéntico al anterior con corrección por gyro Z). Activar con `steer_pid_enabled=1` y ajustar `STEER_KP/KI/KD`. | Base para control de dirección preciso usando diferencia de velocidades de encoders |
| 2026-05-08 | Core/Src/main.c | Motor izquierdo invertido: negado en las dos llamadas a `MotorControl` (líneas con `motorLeftVelocity`). Los encoders también tenían signo invertido: `vel_enc = -((speed_r + speed_l) * 0.5f) * ENC_VEL_SCALE` | Motores nuevos de 1000 RPM tenían polaridad opuesta al lado izquierdo |
| 2026-05-08 | Core/Src/stm32f4xx_it.c | Agregado `EXTI9_5_IRQHandler` (faltaba → CPU caía en Default_Handler). Corregido `EXTI15_10_IRQHandler`: limpia flags de líneas no usadas con `EXTI->PR` (write-1-to-clear) y llama HAL para PB12, PB13, PB14, PB15. Esto elimina el re-ingreso infinito al handler que trababa el CPU | Fix definitivo del HardFault por interrupt storm de encoders |
| 2026-05-08 | Core/Src/main.c | Masking anti-storm en callback de encoders: tras cada pulso se enmascara el EXTI (`EXTI->IMR &= ~pin`). TIM5 (2ms) re-habilita todos los pines del encoder. Limita a 500 Hz max por canal | Previene freeze por rafagas de interrupciones del encoder |
| 2026-05-08 | Core/Src/main.c | Encoder 4x quadrature: PB13 y PB15 pasan de input mudo a EXTI RISING+FALLING. Callback maneja 4 canales: A con `(a==b)`, B con `(a!=b)`. `ENC_CPR` 12→24. TIM5 re-habilita los 4 pines | Duplica resolución efectiva: de 12 a 24 conteos/rev |
| 2026-05-08 | Core/Src/main.c | `KV_BRAKE` puesto en 0.0f (base velocidad baja). `KV_BRAKE_STRONG` ajustado a 5.0f (era 8.0f). `KV_brake_value` inicializado a `KV_BRAKE_STRONG`. Slider "KV" en Qt controla `KV_brake_value` en runtime | Adaptación a motores 1000 RPM (25% más rápidos); freno fuerte funciona bien con velocidad de encoders |
| 2026-05-08 | Core/Src/main.c | Seguidor de línea mejorado: (1) PI de velocidad externo (`LINE_VEL_KP=2.5`, `LINE_VEL_KI=0.8`) reemplaza `line_speed_scale` + `KV_LINE_BRAKE`. (2) Inner steering PI con encoder feedback (`LINE_STEER_FB_KP=5.0`, `LINE_STEER_ENC_SCALE=0.12`) reemplaza steering open-loop. (3) Reducción cuadrática de velocidad con `|line_error|` reemplaza `forward_factor` lineal. Variables `speed_right/left_rps_s` expuestas como statics. `LINE_SPEED_TARGET=0.25 m/s` ajustable en runtime. | Control fluido y robusto: la velocidad y el giro se regulan por realimentación real, no heurísticas abiertas |
| 2026-05-09 | Core/Src/main.c | `LINE_ANGLE` cambiado de 0.5° → 3.0°. Bug: 0.5° coincidía con `BALANCE_HOLD_ENTER_ANGLE_DEG=0.5°`, activando hold casi siempre → `pwm_sat≈0` → el steering (5–20 PWM) superaba el avance → ruedas retrocedían. Con 3.0° el `pwm_sat≈12`, suficiente para superar el steering en línea recta. | Fix de "cuesta ganar ángulo para avanzar" y "cuando ve la línea se va hacia atrás" |
| 2026-05-09 | Core/Src/main.c | `desired_vel` en el PI de velocidad del seguidor de línea ahora tiene un mínimo del 25% de `LINE_SPEED_TARGET` mientras la línea sea visible. Antes: `speed_factor=0` cuando `line_error>0.45` (sensores de borde) → `desired_vel=0` → PI comandaba ángulo negativo de hasta -3° → retroceso. Ahora `desired_vel >= 0.25 * LINE_SPEED_TARGET` en todo momento con línea visible. | Fix de "saca tanto ángulo con sensores de borde que se va hacia atrás" |
| 2026-05-09 | Core/Src/main.c | I2C Bus Recovery en USER CODE BEGIN 2: antes de cualquier transacción I2C, de-init hi2c1, pines PB8/PB9 como GPIO OD, 9 pulsos SCL manuales + STOP condition, restaurar AF4, HAL_I2C_Init. Causa del freeze-en-boot: IWDG cortaba una transacción I2C → esclavo quedaba con SDA=LOW → siguiente boot se bloqueaba en HAL_I2C → loop IWDG→freeze→IWDG. Solo el corte de alimentación liberaba el bus. | Fix del freeze permanente post-IWDG-reset |
| 2026-05-09 | Core/Src/main.c | IWDG watchdog: timeout ~2s (LSI /256, reload=250). Init en USER CODE BEGIN 2, patada (`0xAAAA`) en cada iteración del while(1). Cubre cualquier freeze: I2C lockup, interrupt loop infinito, HardFault, etc. El IWDG no se puede detener una vez arrancado. | Auto-recuperación de freeze sin intervención manual |
| 2026-05-09 | Core/Src/stm32f4xx_it.c, main.c | Fix freeze/HardFault: (1) `HardFault_Handler` → `NVIC_SystemReset()` para auto-recuperación. (2) `EXTI15_10_IRQHandler`: guarda `if(EXTI->IMR & pin)` antes de llamar al handler de cada encoder — evita que el MPU (PB12) procese bits pendientes de encoders enmascarados. (3) `TIM5_IRQn` prioridad rebajada de 0→6 en USER CODE BEGIN 2 para que no preempte handlers de encoder (EXTI9_5 prio 5, EXTI15_10 prio 1). | HardFault/freeze al mover el robot físicamente |
| 2026-05-09 | Core/Src/main.c | Comportamiento sin línea: FOLLOWING→LOST threshold 1s→2s. LINE_STATE_LOST y LINE_STATE_SEARCHING unificados: `steering_adjustment=0`, setpoint con freno de posición (BALANCE_ONLY). Robot queda quieto hasta que vuelve a ver la línea. | Sin girar como loco cuando pierde la línea |
| 2026-05-09 | Core/Src/main.c | Detección de reversa en modo línea: si `velocity_est_f > 0.05` (reversa, vel positiva = atrás) acumula distancia; al superar 0.10 m (10 cm) sale a BALANCE_ONLY. Contador se resetea cuando avanza. | Límite de 10 cm en reversa durante seguidor de línea |
| 2026-05-09 | Core/Src/main.c | Regulación de velocidad en modo línea por encoder: `vel_scale = max(0, 1 - |velocity_est_f| / LINE_SPEED_TARGET)`. A mayor velocidad medida → menor ángulo de avance → robot frena naturalmente. Reemplaza el límite de pwm_sat por error (que causaba caídas) y el turn_scale por error de línea. |: `turn_pwm_limit = max(8, 40*(1-|line_error|*0.8))`. Recto: límite=40. Error=0.5: límite=24. Error=1 (borde): límite=8. Efecto inmediato sin esperar rampa del setpoint. | Aceleración excesiva en curvas del seguidor de línea |
| 2026-05-09 | Core/Src/main.c | Velocidad al girar: `base_setpoint_target = line_angle_cmd * turn_scale` donde `turn_scale = max(0.2, 1 - |line_error|*0.8)`. Centrado=100% velocidad, sensor borde=20%. Línea perdida (LINE_STATE_LOST/SEARCHING): `base_setpoint_target = trim`, `brake_setpoint_target = ComputeBrakeSetpointTarget(BALANCE_ONLY)` para quedarse quieto con control de posición. | Velocidad excesiva al girar + quedarse quieto cuando pierde línea |
| 2026-05-09 | Core/Src/main.c | Inner steering PI de encoders eliminado. `steering_adjustment = clamp(steering_cmd, ±20)` directo. El inner PI (diff_sp→diff_actual→LINE_STEER_FB_KP) anulaba la corrección si el signo de los encoders no era exacto. Ahora el giro es proporcional a `line_error` vía KP_LINE, ajustable en runtime desde Qt. | Fix de "no dobla cuando se va de la línea" |
| 2026-05-09 | Core/Src/main.c | Setpoint en modo línea simplificado: eliminadas doble rampa y suma de setpoint_trim. Ahora `base_setpoint_target = line_angle_cmd` directamente (0 si no ve línea). Tres clamps anteriores reducidos a uno en el PI de velocidad. Evita retroceso por trim negativo y simplifica el flujo. | Simplificación del setpoint en modo línea |
| 2026-05-09 | Core/Src/main.c | `MOTOR_LEFT_DEADBAND` agregado (igual estructura que `MOTOR_RIGHT_DEADBAND`). Motor izquierdo no se movía en balance con pwm_sat bajo porque no tenía compensación de zona muerta. Fix: aplica offset ±LEFT_DEADBAND al comando del motor izquierdo en el mismo punto que el derecho. Ajustar el valor si el izq. sigue sin arrancar. | Motor izquierdo inmóvil en balance con corrección pequeña |
| 2026-05-09 | Core/Src/main.c | `dynamic_setpoint_f` clampeado a ≥ 0 en modo línea (después del cálculo final). Bug: `setpoint_trim` negativo + `line_angle_ramped` pequeño → suma negativa → retroceso, aunque `line_angle_cmd` y `base_setpoint_target` estuviesen clampeados a ≥ 0. El `base_setpoint_f` (versión rampeada) podía quedar negativo durante la transición. | Fix definitivo de retroceso en modo línea |
| 2026-05-09 | Core/Src/main.c | `line_angle_cmd` y `base_setpoint_target` clampeados a `[0, LINE_ANGLE]` en modo línea (antes `[-LINE_ANGLE, LINE_ANGLE]`). El ángulo nunca va negativo → robot nunca retrocede durante el seguimiento. | Fix de retroceso esporádico en modo línea |
| 2026-05-09 | Core/Src/main.c | Lectura de sensores de línea: reemplazado `adcValues[]` (snapshot DMA crudo) por `adcAvg[]` (promedio móvil de 15 muestras a 4kHz). Eliminado filtro EMA redundante (ADC_BETA=0.8) que retrasaba la detección un ciclo (80% del valor en primer sample → no alcanzaba LINE_THRESHOLD). `LINE_THRESHOLD` bajado de 3000→1500 para calibrar contra adcAvg en lugar del valor crudo. | Fix de "pasa por encima de la línea sin corregir" |
| 2026-05-09 | Core/Src/main.c | `LINE_ANGLE` bajado de 3.0° → 1.5°. Con 3.0° el robot iba a fondo porque el PI de vel está en retroalimentación positiva y siempre satura al máximo. 1.5° mantiene suficiente avance para superar el steering pero limita la velocidad tope. Ajustable desde Qt en runtime. | Reducción de velocidad del seguidor de línea |
| 2026-05-15 | Core/Src/main.c, CLAUDE.md | PI de velocidad del seguidor de línea ahora regula velocidad de avance positiva (`forward_vel = max(0, -velocity_est_f)`) y compara contra `desired_forward_vel`. No cambia `turn_scale` ni mínimos de avance. | Evitar que una velocidad positiva de reversa reduzca el setpoint a cero y haga oscilar/retroceder |
| 2026-05-18 | Core/Src/main.c, CLAUDE.md | Revertida la protección anti-retroceso que cortaba `pwm_sat` negativo a 0 y bloqueaba ruedas internas negativas con línea visible. | Ese enfoque hacía que al ver la línea el robot se fuera directamente hacia adelante y no mantuviera equilibrio |
| 2026-05-18 | Core/Src/main.c, CLAUDE.md | Suavizado del avance en modo línea: `LINE_VEL_KP` 5.5→2.5, `LINE_VEL_KI` 0.8→0.25, `LINE_VEL_I_MAX` 3.0→1.0, rampa de setpoint de línea 1.0°→0.06° por ciclo y factor `stability_scale` según inclinación/gyro antes de pedir avance. | Reducir oscilación adelante/atrás cuando detecta la línea sin tocar el PWM final del balance |
| 2026-05-18 | Core/Src/main.c, CLAUDE.md | Ajuste para recuperar avance sin volver a oscilar: `vel_scale` tiene piso 0.35, `stability_scale` tiene piso 0.50 y cae más lento, rampa de setpoint de línea 0.06°→0.12° por ciclo. | El cambio anterior estabilizó pero quedó demasiado conservador y no ganaba inclinación hacia adelante |
| 2026-05-18 | Core/Src/main.c, CLAUDE.md | Agregado `line_forward_boost`: boost de inclinación basado en encoders. Si `line_forward_vel` queda por debajo de `LINE_FWD_STALL_FRAC` de la velocidad deseada, suma gradualmente hasta `LINE_FWD_BOOST_MAX=0.8°`; si recupera avance, lo descarga. | Usar encoders para pedir más ángulo cuando no avanza, sin tocar PWM final ni pelearse con el PID de balance |
| 2026-05-18 | Core/Src/main.c, CLAUDE.md | Agregado `line_reverse_boost`: si `velocity_est_f` indica reversa (`> LINE_REV_VEL_START`), suma gradualmente hasta `LINE_REV_BOOST_MAX=1.4°` y evita que `stability_scale` baje de 0.75 mientras corrige reversa. | Controlar explícitamente cuando el robot se va hacia atrás, usando encoders y modificando solo el setpoint de inclinación |
| 2026-05-18 | Core/Src/main.c, CLAUDE.md | Tres fixes para "se queda parado" en modo línea: (1) `vel_scale` eliminado (→1.0 constante) — el PI de velocidad ya regula la velocidad, vel_scale era un segundo freno redundante que recortaba el ángulo al 65%. (2) `sp_step_max` en LINE 0.12→0.25°/ciclo — rampa 2× más rápida. (3) Anti-windup al PI de velocidad: no acumula integral cuando la salida está saturada y `vel_error>0`, evita que el integral wind-up retrasa la frenada al superar el target. | Robot se quedaba parado en algunos puntos por rampa lenta y vel_scale recortando ángulo en el peor momento |
| 2026-05-18 | Core/Src/main.c, CLAUDE.md | Fix doble que impedía ganar velocidad en modo línea: (1) `stability_scale` ahora usa `base_setpoint_f` como referencia en lugar de `SETPOINT_ANGLE+trim` (0°) — antes penalizaba la inclinación correcta de avance; umbral subido 0.8°→1.5°, piso 0.50→0.60, gyro 12→20 dps. (2) `vel_scale` floor 0.35→0.65 para que no recorte el ángulo en crucero. (3) `LINE_VEL_KI` 0.25→1.2 y `LINE_VEL_I_MAX` 1.0→2.5 para mantener ángulo en estado estacionario. | Con referencia errónea (0°), stability_scale reducía el ángulo a 52% cuando el robot inclinaba correctamente a 2°; combinado con vel_scale=0.35, el ángulo llegaba a 18% del comando |
| 2026-05-18 | Core/Src/main.c, CLAUDE.md | `line_forward_boost` (rampas stall/recover) reemplazado por corrección P directa basada en encoders: `line_enc_angle_corr = LINE_ENC_CORR_KP(2.5) × (deficit_vel / desired_vel)`, máx `LINE_ENC_CORR_MAX=2.0°`. Respuesta instantánea al déficit de velocidad vs. rampas lentas (35ms/° anterior). | Robot no ganaba ángulo al ver la línea desde parado: la corrección es proporcional y directa al dato de encoders |
| 2026-05-18 | Core/Src/main.c, CLAUDE.md | Balance hold deshabilitado cuando `line_detected` en modo LINE_FOLLOWING: `if (robot_state == LINE_FOLLOWING && line_detected) balance_hold_active = 0`. También se limpia `balance_hold_active=0` en la transición de entrada al modo línea. | El hold silenciaba el PID durante ~80ms al arrancar el seguimiento (error < 0.5° mientras el setpoint rampea desde 0°), impidiendo que el robot ganara ángulo para avanzar sobre la línea |
| 2026-05-18 | Core/Src/main.c, CLAUDE.md | Frenado activo por encoders: `line_angle_cmd` clampea hasta -1.5° (antes 0). Freno separado de `vel_scale` (cuando `line_angle_cmd < 0` no se multiplica por vel_scale=0 que lo anulaba). Integral del PI de velocidad solo acumula positivo; en sobrevelocidad decae ×0.95 sin acumular negativo → elimina retroceso por windup. `vel_scale` corta avance al 90% del target. `ADC_AVERAGE_SIZE` 15→4: retraso detección 7.5ms→0.5ms. Freno máximo -1.5° (suavizado desde -3°) para evitar oscilación acelera/frena. | Robot aceleraba sin límite, pasaba por encima de la línea sin detectarla, y oscilaba indefinidamente |
| 2026-05-18 | Core/Src/main.c, CLAUDE.md | Detección de objetos + evasión por encoders: objeto detectado → `LINE_STATE_OBJ_ROTATE`. Giro derecha (`steering_adjustment=-20`) midiendo con encoders. `target_counts = (π/4 × OBJ_ROTATE_TRACK_WIDTH × ENC_CPR) / ENC_VEL_SCALE`. Métrica: `(|Δright| + |Δleft|) / 2`. Timeout 3s. `OBJ_ROTATE_TRACK_WIDTH=0.220m` (medido). Display muestra "ROTATE". | Reemplaza condición sensor-based (poco confiable) por medición odométrica de encoders |
| 2026-05-19 | Core/Src/main.c, CLAUDE.md | Fix de rotación en `LINE_STATE_OBJ_ROTATE`: reemplazado `steering_adjustment=-20` (que producía MotorControl(+10,+10) con pwm_sat≈0, sin diferencial real) por asignación directa de motores con `line_pivot_active=1`. Formula: `motorRightVelocity = -(pwm_sat + PIVOT_POWER)`, `motorLeftVelocity = -(pwm_sat - PIVOT_POWER)` con `PIVOT_POWER=30`. Esto produce MotorControl(-(pwm_sat+30), -(pwm_sat-30)) — ambos canales en la misma dirección relativa, creando spin real independiente del valor de pwm_sat. | Bug: la lógica half_steer falla a pwm_sat≈0 porque ambos motores terminan con el mismo signo positivo y el PID de balance lo cancela; el robot no rotaba y el timeout de 3s disparaba siempre |
| 2026-05-19 | Core/Src/main.c, CLAUDE.md | Fix de entrada inmediata a HOLD: variables `rot_initialized`, `rot_r0`, `rot_l0`, `rot_start_ms` del case OBJ_ROTATE eran `static` locales. Al caer el robot durante la rotación, el bloque LINE_FOLLOWING se salteaba (f_fallen=1) sin resetear esas vars. Al recuperarse, `dr/dl` acumulaban los counts de la caída → `rot_counts >= target_counts` inmediatamente → salto a OBJ_HOLD. Fix: variables promovidas a scope de archivo (`obj_rot_*`) y `obj_rot_initialized=0` se resetea en la transición FOLLOWING→OBJ_ROTATE. | Las statics locales no se pueden resetear desde fuera del case; se necesita scope de archivo para controlarlo explícitamente |
| 2026-05-19 | Core/Src/main.c, CLAUDE.md | Agregado `LINE_STATE_OBJ_REVERSE`: reversa de 300 counts con steering invertido basado en `line_error` (×0.3, clamped ±12) para mantener centrado sobre la línea mientras retrocede. Setpoint = trim − 1.5° para lean suave hacia atrás. Sin línea detectada: retrocede recto. Corregido `target_counts` de OBJ_ROTATE: fórmula geométrica daba 23 pero en la práctica son 350 → valor empírico. Cadena: FOLLOWING → OBJ_REVERSE → OBJ_BRAKE → OBJ_ROTATE → OBJ_HOLD. | Fórmula ignoraba reducción de engranajes reales; steering en reversa usa signo negado del error de línea. |
| 2026-05-19 | Core/Src/main.c, CLAUDE.md | Agregado `LINE_STATE_OBJ_BRAKE`: estado intermedio post-reversa que usa `ComputeBrakeSetpointTarget` para frenar activamente por encoders y espera a que `fabsf(velocity_est_f) < 0.05 m/s` antes de iniciar el giro. Timeout de 1500 ms. Evita que la inercia de la reversa distorsione el giro. | Sin este estado, el robot entraba al giro con inercia residual y no giraba en el lugar. |
| 2026-05-18 | Core/Src/main.c, CLAUDE.md | `LINE_STATE_OBJ_HOLD` simplificado: usa exactamente las mismas características que BALANCE_ONLY (setpoint=trim, freno traslacional por encoders, corrección yaw=gz×0.3 igual que LOST/SEARCHING). Sale únicamente cuando `f_fallen=1` → transiciona a `LINE_STATE_FOLLOWING` para retomar la línea al recuperarse. Display muestra "HOLD". | Reutiliza el balance estático probado en lugar de lógica custom; sale solo por caída |
| 2026-05-18 | Core/Src/main.c, CLAUDE.md | Ventana de ignorar objeto al activar modo línea por botón (doble click): `obj_detect_ignore_until_ms = HAL_GetTick() + 4000`. La detección de objeto no dispara mientras `HAL_GetTick() < obj_detect_ignore_until_ms`. Solo aplica al activar por botón físico, no por comando Qt. | Evitar falsa detección cuando el dedo pasa frente a los ADC 5-8 al presionar el botón |
| 2026-05-18 | Core/Src/main.c, CLAUDE.md | Pantalla 1 (LINE_FOLLOWING): panel izquierdo expandido de 4 a 8 barras ADC (bar_width 5→7, spacing 1, área 55→70px, divisor 57→71, contenido derecho 62→73). ADC 1-4 (línea) en orden invertido; ADC 5-8 (objeto) a continuación. Separador punteado en x=32. | Barras más anchas y legibles; panel derecho desplazado para dar espacio |
| 2026-05-18 | Core/Src/main.c, CLAUDE.md | Pantalla 4 (f_change_display==4): reemplazado bloque ADC1-4 con Font_7x10 por grid 4×2 con Font_5x7 mostrando ADC1-8. Columna izquierda (x=1): A1-A4; columna derecha (x=67): A5-A8. Divisor vertical en x=63. | Ver todos los ADC raw en una sola pantalla para calibrar umbrales de línea y objeto |
| 2026-05-18 | Core/Src/main.c, CLAUDE.md | Watchdog de software I2C/MPU: función `I2C1_Recover()` (DMA abort + 9 pulsos SCL + HAL_I2C_Init + I2C_Manager_Init) llamada desde while(1) si pasan >150ms sin dato nuevo del MPU. Watchdog integrado en el bloque `mpu_data_ready_for_ctrl` usando `last_ctrl_ms` estático. Imprime "I2C RECOVER" por USB para diagnóstico. | Fix del freeze total donde el while(1) seguía girando pero el DMA I2C quedaba colgado sin completar, dejando ControlStep10ms sin correr y todo congelado |
