tadeomendelevich/Balancin_Mendelevich/Core/Src/main.c

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
/* Includes ------------------------------------------------------------------*/
#include "main.h"
#include "usb_device.h"

/* USER CODE BEGIN Includes */
#include <stdio.h>
#include <string.h>
#include <math.h>
#include "comunicacion_usb.h"
#include "boton_usuario.h"
#include "telemetria.h"
#include "control_motores.h"
#include "display_oled.h"
#include "MPU6050.h"
#include "ESP01.h"
#include "UNER.h"
#include "i2c_manager.h"

/* USER CODE END Includes */

/* USER CODE BEGIN PD */
#define LED_Pin        GPIO_PIN_10
#define LED_GPIO_Port  GPIOB

#define INTEGRATED_LED_Pin        GPIO_PIN_13
#define INTEGRATED_LED_GPIO_Port  GPIOC

#define KEY_Pin        GPIO_PIN_0
#define KEY_GPIO_Port  GPIOA

#define CH_PD_GPIO_Port  GPIOB
#define CH_PD_Pin        GPIO_PIN_2

#define UDP_RX_TAMANO          512
#define UDP_RX_MASCARA         (UDP_RX_TAMANO - 1)
#define UDP_BYTES_POR_CICLO    8


#define ADC_HISTORIAL_TAMANO  32U  // 8ms de historial a 4kHz para mediana anti-picos

#define BARRAS_CANTIDAD   8

#ifndef M_PI
#define M_PI 3.14159265358979323846f
#endif

// PID
#define KP  4.0f   // Ganancia proporcional en PWM directo
#define KD  0.12f  // Ganancia derivativa en PWM/(deg/s)
#define KI  0.1f   // Ganancia integral en PWM/(deg*s)

#define SETPOINT_ANGLE 	0.0f

#define ZONA_SUAVE_ANGULO_GRADOS   1.50f   // error a partir del cual el PID va al 100%
// Cerca del equilibrio el PID entrega poca autoridad; con una escala muy baja
// casi todo comando cae debajo de MOTOR_COMANDO_NEUTRO -> sin par hasta que el
// error ya es grande -> bamboleo lento de lado a lado. Por eso el piso es 0.35.
#define ZONA_SUAVE_ESCALA_MIN   0.35f   // escala mínima cuando el error es ~0
// Zona de hold con histeresis: silencia P/I en el punto dulce de equilibrio.
// La zona es ANGOSTA a proposito y el D NUNCA se apaga: un pendulo invertido
// siempre se cae en lazo abierto, asi que un hold ancho garantiza un ciclo
// limite (caer -> atajar -> cruzar con impulso -> caer del otro lado).
// El anti-chatter real en parado lo da MOTOR_COMANDO_NEUTRO, no este hold.
#define BALANCE_HOLD_ENTRA_ANGULO_GRADOS  0.25f  // entra en hold si |error| <= este valor
#define BALANCE_HOLD_SALE_ANGULO_GRADOS   0.45f  // sale de hold si |error| >= este valor
#define BALANCE_HOLD_ENTRA_GIRO_DPS       2.0f   // entra en hold si |gyro| <= este valor
#define BALANCE_HOLD_SALE_GIRO_DPS        6.0f   // sale de hold si |gyro| >= este valor
// Siesta de motores en el punto dulce (solo BALANCE_ONLY): un
// nivel MÁS profundo que el hold — con el hold activo, el comando ya chico y
// los encoders quietos un rato, el PWM va a 0 REAL (ni siquiera el salto de
// deadband): cero desgaste, cero vibración, el robot se sostiene por
// equilibrio mecánico. Despierta al INSTANTE con cualquiera de: salida del
// hold (error>=0.45° / gyro>=6°/s), un solo tick de encoder (te empujaron) o
// gyro >= WAKE_GYRO (te estás cayendo — umbral MÁS fino que el exit del hold
// para recuperar autoridad antes). La lección (matar motores
// en zona ancha => bamboleo) se respeta: la siesta requiere condiciones mucho
// más estrictas que aquel hold viejo y se despierta con más sensibilidad.
// 2ª forma: la 1ª exigía hold activo + 250ms sin UN tick +
// |pwm|<=4 — la propia vibración de las correcciones impedía cumplirlo
// (círculo vicioso: no duerme porque vibra, vibra porque no duerme) y si el
// robot paraba con 0.3-0.5° de error residual el hold nunca entraba. Ahora la
// siesta tiene ventana PROPIA (desacoplada del hold) y más generosa.
// 3ª pasada de permisividad: la siesta funciona ADEMÁS como
// asentador del vaivén final — en cada extremo de la oscilación la velocidad
// pasa por ~0; si la siesta lo pesca ahí (ventanas cortas), corta motores y
// la fricción estática mata la oscilación en 2-3 cruces en vez de ~15.
#define MOTOR_SIESTA_ANGULO_ENTRA      1.6f   // ° de error: adentro puede dormir (aunque el hold no haya entrado)
#define MOTOR_SIESTA_GIRO_ENTRA        5.0f   // °/s: casi sin rotar para dormir (3→4→5: entrar más fácil)
#define MOTOR_SIESTA_ENTRA_MS          80     // condiciones sostenidas este tiempo → dormir (200→150→80)
#define MOTOR_SIESTA_COMANDO_MAX       15.0f  // |pwm_saturado| <= esto se considera "sin trabajo real" (8→12→15)
#define MOTOR_SIESTA_ENC_QUIETO_MS     60     // sin ticks de encoder en esta ventana (120→100→60)
#define MOTOR_SIESTA_DESPERTAR_GIRO    4.0f   // °/s: se está cayendo → despertar
#define MOTOR_SIESTA_DESPERTAR_ANGULO  1.0f   // ° de error: derivó demasiado → despertar

// Complementary Filter / PID timing
#define ALFA_COMPLEMENTARIO  0.98f
#define DT_CTRL_FIJO         0.010f

// Filter Control Parameters
#define INTEGRAL_MAX   100.0f  // Max Integral Term

// Fall detection (hysteresis)
#define CAIDA_ANGULO_GRADOS         60.0f
#define RECUPERACION_ANGULO_GRADOS  2.0f
#define BOCA_ABAJO_ANGULO_GRADOS    120.0f  // más agresivo para detectar boca abajo antes
// Cortes de emergencia por velocidad. LINE protege el avance; BALANCE_ONLY y
// MANUAL_CONTROL protegen ambos sentidos porque pueden desplazarse en reversa.
#define LINEA_VEL_CORTE_LIMITE            10.00f  // m/s: corte total
#define BALANCE_MANUAL_VEL_CORTE_LIMITE   15.00f  // m/s: corte total en balance/manual
#define LINEA_VEL_CORTE_VEL_CRUDA_MIN     3.00f   // cada ciclo debe tener movimiento real, no solo cola del filtro
#define LINEA_VEL_CORTE_DISPARO_CICLOS    3U      // 30ms con muestras nuevas que confirmen exceso
#define LINEA_VEL_CORTE_ARMADO_MS         500U    // ignora el transitorio de entrada al modo línea
#define VEL_CORTE_GRACIA_RECUPERACION_MS  2000U   // tiempo para apoyar el robot tras levantarlo
#define LINEA_VEL_CORTE_RESET_VEL         0.50f   // m/s: velocidad segura para rearmar
#define LINEA_VEL_CORTE_RESET_CICLOS      50U     // 500ms seguro y vertical antes de volver

#define MOTOR_DER_ZONA_MUERTA  8  // offset sumado al motor derecho para compensar su mayor zona muerta (0 = sin compensación)
#define MOTOR_IZQ_ZONA_MUERTA  8  // ídem motor izquierdo — ajustar si el izq. no arranca a PWM bajo
// Dos offsets segun el estado de la rueda: el de arriba vence la friccion
// ESTATICA (arrancar la rueda parada). Con la rueda YA girando la friccion es
// cinetica (mucho menor) y sumar el estatico convierte cada cruce por la zona
// neutra en una patada de ~11 PWM: un rele que, sobre una planta inestable,
// sostiene un ciclo limite (el bamboleo). Con ticks de encoder en los ultimos
// RUEDA_MOVIMIENTO_VENTANA_MS se usa el cinetico; sin ticks (parada de verdad),
// el estatico completo para vencer el arranque.
#define MOTOR_ZONA_MUERTA_CINETICA   4   // offset cuando la rueda ya esta girando
#define RUEDA_MOVIMIENTO_VENTANA_MS  80  // rueda "en movimiento" si tickeo hace menos de esto
// Zona neutra de comando: |comando| <= este valor => motor directamente en 0,
// SIN saltar a +-DEADBAND. Sin esto, el chatter de +-1 PWM del PID cerca del
// equilibrio se convierte en golpes de +-9 PWM a 100 Hz (la compensacion de
// deadband amplifica el ruido) = el 'temblor' en balance. Con 4, los comandos
// de 3-6 PWM del punto dulce van a 0 real (motores quietos, sin ticks) y la
// siesta puede entrar. Si aparece bamboleo lento bajar a 3; si tiembla, subir.
#define MOTOR_COMANDO_NEUTRO     	4
// Zona neutra para los modos DINÁMICOS (línea/manual/speed): la
// zona ancha (4) + la rampa del offset son un requisito del punto dulce de
// BALANCE_ONLY (quietud para la siesta) — pero en los otros modos debilitaban
// los comandos medianos (5-11 PWM: un cmd 5 pasó de salir 13 a salir 6) y la
// recuperación dinámica quedaba sub-amortiguada: bamboleo tras el giro de 90°
// del esquive de objeto. Los modos dinámicos conservan la salida histórica:
// zona neutra angosta y offset completo de golpe (pre-).
#define MOTOR_COMANDO_NEUTRO_DINAMICO 	2
// Rampa de la compensación de deadband: apenas por encima de la
// zona neutra el offset NO entra completo de golpe (relé de ±(cmd+db) contra
// robot quieto = la "brusquedad" del punto dulce) sino proporcional al exceso:
// comp = min(db, (|cmd|-NEUTRAL) × RAMP_GAIN). Con gain 1 y db estático 8, el
// offset completo recién entra con |cmd| ≥ NEUTRAL+8 (=12) — toda la franja de
// correcciones chicas del punto dulce empuja suave en vez de patear. Comandos
// grandes (empujón real) no cambian. (2→1: validado con 2
// "quedó mucho mejor", el usuario pidió aún más suavidad; si quedara flojo
// para arrancar la rueda en correcciones medianas, volver a 2.)
#define MOTOR_ZONA_MUERTA_RAMPA_GANANCIA  1
#define KV_FRENO                          0.8f   // ganancia base del freno traslacional
#define KV_FRENO_FUERTE                   6.0f   // ganancia extra por encima del umbral
#define FRENO_VEL_UMBRAL                  1.0f   // velocidad a partir de la cual se aplica el freno fuerte

#define VEL_FILTRO_BETA_RAPIDO   0.35f
// FRENO_VEL_ZONA_MUERTA calculado a partir del piso de cuantización real del
// encoder: con ENCODER_COUNTS_POR_VUELTA=28 y ciclo de control de 10ms, UN solo count en una
// sola rueda ya calcula (0.5/(28*0.01))*ENCODER_METROS_POR_VUELTA(0.1775) ≈ 0.32 m/s;
// si tiquean ambas ruedas en el mismo ciclo, ≈ 0.63 m/s. 0.05-0.12 no
// filtraba nada de eso — cualquier pulso aislado se leía como "movimiento
// real" y disparaba freno, causando el bamboleo parado. 0.35 queda apenas
// por encima del piso mínimo (0.32) para filtrar el ruido de un solo pulso
// sin tapar una deriva sostenida real.
#define FRENO_VEL_ZONA_MUERTA  0.35f
#define FRENO_VEL_MAX          4.0f
// Yaw-assist (corrección de rumbo por giro_z en balance común y modo línea):
// zona muerta sobre giro_z crudo (SIN filtro por software — el MPU ya trae su DLPF
// de ~44 Hz): rotación < GIROZ_RUMBO_ASIST_ZONA_MUERTA °/s => corrección exactamente 0, para
// que el ruido residual de giro_z no dispare la compensación de deadband de motor
// con el robot quieto. Subir si el yaw-assist sigue metiendo chatter; bajar si
// deja de corregir derivas de rumbo reales. La ganancia 0.23 no se toca.
#define GIROZ_RUMBO_ASIST_ZONA_MUERTA    3.0f  // °/s (zona muerta, ajustar de a 1)
#define FRENO_INCLINACION_MAX            4.0f  // era 3.0 → 5.0 → 4.0: compromiso entre frenar de verdad y no sobrecorregir en balance normal
#define FRENO_INCLINACION_MAX_MANUAL     4.0f  // ídem
#define FRENO_INCLINACION_RAMPA_BALANCE  0.5f
#define FRENO_INCLINACION_RAMPA_MANUAL   0.5f
// Multiplicador extra sobre Freno_AnguloSegunModo, solo para LOST_BRAKE/
// EDGE_WAIT (el frenado justo al perder la línea del todo). Historia: se subió
// a 1.6 cuando el freno arrancaba 1s tarde, con el robot ya
// desacelerado solo.: al adelantar el disparo de pérdida a 300ms,
// el freno ahora entra a velocidad de crucero plena y con 1.6 el tirón hacia
// atrás VOLCABA el robot — vuelto a 1.0 (freno estándar de balance, estable a
// velocidad). Si frena corto, subir de a 0.1, no volver a 1.6.
#define PERDIDA_LINEA_FRENO_FACTOR  1.0f

// ── Estación por rueda: mantener la POSICIÓN mientras balancea (BALANCE_ONLY/IDLE) ──
// Eje TRASLACIÓN: PD sobre el desplazamiento reciente de encoders, aplicado al
// SETPOINT de inclinación (no a PWM): para volver atrás, inclinarse hacia atrás
// y dejar que el balance haga el resto. Mismo patrón que el hold de PAUSA_GIRO.
// El eje ROTACIÓN sí va por PWM diferencial (ver Ctrl_MotoresBalance).
// Historia completa de los ajustes (pasadas 1-16): CHANGELOG.md.
#define RUEDA_ESTACION_ANGULO_KP             0.05f  // P: ° por count de desplazamiento reciente
#define RUEDA_ESTACION_AMORTIGUACION_KD      1.00f  // D: ° por rps de velocidad de traslación
#define RUEDA_ESTACION_ANGULO_MAX            1.5f   // tope total (si vuelca → 1.2; si frena poco → 1.8)
#define RUEDA_ESTACION_P_MAX                 0.5f   // tope propio del P: solo frena deriva lenta (la autoridad grande es de la D)
#define RUEDA_TRASLACION_ZONA_MUERTA_COUNTS  3      // counts sin corregir (ruido de cuantización)
#define RUEDA_VEL_ZONA_MUERTA_RPS            0.25f  // rps sin corregir (filtra el pico de un count suelto)
// Factor de CALMA: atenúa P y D juntos según la actividad real
// (calm = max(|gyro|/GIRO_REF, |v_trasl|/V_REF), tope 1). Quieto → estación muda.
#define RUEDA_CALMA_GIRO_REF_DPS          8.0f    // °/s a los que calm llega a 1 por gyro (si no amortigua llegadas suaves → 6)
#define RUEDA_CALMA_VEL_REF_RPS           1.0f    // rps a los que calm llega a 1 por velocidad
#define RUEDA_REPOSO_SIN_TICKS_MS         150     // ms sin tick en AMBAS ruedas = reposo real
#define RUEDA_DESPLAZAMIENTO_FUGA_REPOSO  0.90f   // fuga en reposo real (τ≈100ms): mata el residuo del P
#define RUEDA_DESPLAZAMIENTO_FUGA         0.998f  // fuga normal del desplazamiento (τ≈5s)
// NO reintentar el 'fade de supervivencia' por gyro alto (probado y descartado):
// toda recuperacion de empujon supera 40 grados/s -> la estacion quedaba muda
// justo cuando debia frenar. El exceso se acota con RUEDA_ESTACION_ANGULO_MAX.

// Steering PID (lazo cerrado por encoders)
#define DIRECCION_KP          5.0f  // ajustar según respuesta real
#define DIRECCION_KI          0.2f
#define DIRECCION_KD          0.1f
#define DIRECCION_I_MAX       15.0f
#define DIRECCION_SALIDA_MAX  20.0f
// Velocity PI (lazo externo de velocidad en seguimiento de línea)
#define LINEA_VEL_KP                 3.0f   // ganancia proporcional vel PI (acelerando)
#define LINEA_VEL_KP_FRENO           8.0f   // sobrevelocidad: freno más firme sin endurecer la aceleración
#define LINEA_VEL_KI                 1.2f   // ganancia integral vel PI
#define LINEA_VEL_I_MAX              2.5f   // anti-windup vel PI
#define LINEA_FRENO_ANGULO_MAX       3.0f   // inclinación máxima hacia atrás en seguimiento
#define LINEA_SETPOINT_RAMPA_NORMAL  0.15f  // grados/ciclo al acelerar o aliviar el freno
#define LINEA_SETPOINT_RAMPA_FRENO   0.30f  // grados/ciclo al entrar en freno por sobrevelocidad
// Gobernador predictivo de velocidad: solo interviene cerca del tope GLOBAL.
// Proyecta la velocidad con la aceleración filtrada y empieza a frenar antes
// de LINE_SPEED_TARGET; no modifica el perfil de velocidad normal de las curvas.
#define LINEA_VEL_GUARDA_MARGEN             0.15f  // m/s por debajo del tope donde empieza la guarda
#define LINEA_VEL_HORIZONTE_PREDICCION_SEG  0.15f  // horizonte de predicción
#define LINEA_ACELERACION_FILTRO_ALFA       0.20f  // filtro de la derivada cuantizada de encoders
#define LINEA_ACELERACION_MAX_CREIBLE       8.0f   // m/s², rechazo de saltos imposibles de un tick
#define LINEA_VEL_GUARDA_KP                 6.0f   // grados de freno por m/s proyectado sobre la guarda
// Avance post-giro (LOST_AVANZA / EDGE_AVANZA): PI de velocidad.
// Se avanza con decision porque el retorno navega a un punto CONOCIDO: con un
// techo de 1 grado, atenuado por la soft-zone del PID, no se vence la friccion
// estatica y el robot queda directamente detenido.
#define PERDIDA_AVANCE_VEL_OBJETIVO  0.40f  // m/s (0.18 no arrancaba desde parado)
#define PERDIDA_AVANCE_KP            4.0f   // ganancia P acelerando
#define PERDIDA_AVANCE_KP_FRENO      14.0f  // ganancia P frenando (sobrevelocidad)
#define PERDIDA_AVANCE_KI            1.0f   // ganancia I para sostener la velocidad de crucero
#define PERDIDA_AVANCE_VEL_I_MAX     1.0f   // anti-windup del integral de velocidad
#define PERDIDA_AVANCE_ANGULO_MAX    2.5f   // ángulo máximo de avance (°; 1.0 no movía el robot)
#define PERDIDA_AVANCE_FRENO_MAX     2.0f   // ángulo máximo de freno activo (°, se aplica en negativo)
// Anti-stall GENÉRICO (ver AntiStall_Tick): los PIs de velocidad
// saturan en P+I con techos de 2-3 grados — si la fricción estática del
// momento (o la inclinación del piso, o un objeto) pide más, quedan clavados
// en el tope y el robot quieto para siempre. Todo estado que REQUIERE
// movimiento suma este boost en rampa POR ENCIMA del clamp de su PI: sin
// movimiento de encoders por WAIT ciclos crece STEP por ciclo hasta el tope
// del llamador; al moverse decae rápido (DECAY). Nada puede quedarse quieto.
#define ANTIATASCO_VEL_UMBRAL     0.05f  // m/s: debajo de esto se considera quieto
#define ANTIATASCO_ESPERA_CICLOS  40     // ciclos quieto (400ms) antes de boostear
#define ANTIATASCO_PASO           0.04f  // grados por ciclo de rampa del boost
#define ANTIATASCO_DECAIMIENTO    0.90f  // decaimiento por ciclo al volver a moverse
#define ANTIATASCO_MAX_AVANCE     3.0f   // tope en avances (LOST_AVANZA/EDGE_AVANZA/pared)
#define ANTIATASCO_MAX_REVERSA    2.5f   // tope en reversas (RETROCESO/reversa de pared)
#define ANTIATASCO_MAX_MANUAL     2.0f   // tope en control manual
// Retorno por odometría al punto de pérdida de línea (solo camino "centrado", LOST_AVANZA):
// después del giro de 180°, en vez de avanzar a ciegas, navega hacia la pose (x,y)
// donde se vio la línea por última vez. Steering P sobre el error de rumbo
// (bearing al objetivo - theta odométrico). Si el robot curva ALEJÁNDOSE del punto,
// primero verificar ODOM_THETA_SIGNO (test del giro de 90°); si theta está bien y aun
// así corrige al revés, invertir el signo de RETORNO_DIRECCION_KP.
// Nota de escala: el formato compartido de motores aplica half_steer = steering*0.5,
// así que el efecto real por rueda es la MITAD de estos valores. Con KP=0.6/MAX=12
// (valores iniciales) el usuario reportó que "casi no corrige" — subidos.
#define RETORNO_DIRECCION_KP   1.5f   // PWM de steering por grado de error de rumbo
#define RETORNO_DIRECCION_MAX  20.0f  // clamp del steering de navegación
#define RETORNO_ALCANZADO_M    0.10f  // distancia al punto para considerarlo alcanzado
// Sobrepaso: al llegar al punto (o pasarlo de costado) NO se rinde ahi mismo:
// los sensores necesitan pasar POR ENCIMA de la linea para verla, y el punto
// guardado es donde el robot la vio por ultima vez, no donde estan los sensores
// ahora. Se sigue derecho OVERSHOOT_M mas alla antes de dar por perdida la busqueda.
// Entre el error de odometria acumulado y que los sensores van adelante, con
// menos margen el robot se planta JUSTO sobre el punto y no cruza la cinta.
// PASS_WIN_M: si el objetivo quedo claramente atras (error de rumbo > 120 grados)
// a menos de esta distancia, se considera 'pasado de costado' y tambien entra al
// sobrepaso (evita que quiera pegar la vuelta en U por un desvio lateral chico).
#define RETORNO_SOBREPASO_M                0.35f  // metros extra en línea recta tras alcanzar el punto
#define RETORNO_VENTANA_PASO_M             0.35f  // ventana de "lo pasé de costado"
#define LINEA_DEFICIT_VEL_KP               8.5f   // ganancia P: grados por (m/s de deficit) normalizado
#define LINEA_DEFICIT_VEL_ANGULO_MAX       4.0f   // angulo extra maximo por deficit de velocidad (grados)
#define LINEA_ESCAPE_REVERSA_ANGULO_MAX    1.4f   // extra de inclinacion si los encoders muestran reversa
#define LINEA_ESCAPE_REVERSA_RAMPA_SUBIDA  0.06f  // subida max por ciclo de control
#define LINEA_ESCAPE_REVERSA_RAMPA_BAJADA  0.10f  // bajada max por ciclo de control
#define LINEA_ESCAPE_REVERSA_VEL_MIN       0.05f  // m/s de reversa desde donde empieza a actuar
#define LINEA_ESCAPE_REVERSA_VEL_PLENA     0.35f  // m/s de reversa para aplicar boost maximo
// Corrección de rumbo sin línea: P simple sobre diferencia de velocidad de ruedas,
// en PWM absoluto (mismas unidades que ajuste_direccion/pwm_saturado). REVERSA_RECTA_MAX
// es chico a propósito: nunca puede acercarse a pwm_saturado, así que ninguna rueda se
// queda sin margen. El plan original era arrancar con KP=0 e ir subiendo; el valor
// actual (-1.0, signo incluido) quedó de las pruebas en el robot — si la corrección
// empeora la asimetría en vez de corregirla, probar +1.0 (solo cambia el signo).
#define REVERSA_RECTA_KP_VELOCIDAD  -1.0f  // PWM por rps de diferencia entre ruedas (0 = sin corrección)
#define REVERSA_RECTA_MAX           8.0f   // tope absoluto en PWM units
#define REVERSA_RECTA_RAMPA         2.0f   // PWM/ciclo max de cambio (rampa)
// P de rumbo sobre counts ACUMULADOS desde el inicio de la reversa
// (rev_dr - rev_dl = desvio de rumbo real, 1 count ~ 6.3mm de rueda). No se usa
// la diferencia de velocidad instantanea: a la velocidad de reversa esta
// cuantizada en saltos de 3.57 rps (1 count/ciclo) y es casi puro ruido.
// La correccion actua SOLO en movimiento, y 'en movimiento' se mide por actividad
// de encoders (algun tick en los ultimos ACT_MS), no por velocidad_est_ema: el LPF
// de la velocidad cuantizada suele leer menos de 0.12 aunque el robot retroceda,
// y la correccion quedaria apagada casi toda la reversa (robot torcido).
// Parado no hay rumbo que mantener: el target va a 0 suave por el mismo slew.
// Mismo signo/convencion que REVERSA_RECTA_KP_VELOCIDAD: si empeora el desvio en
// vez de corregirlo, probar +1.0.
#define REVERSA_RECTA_KP_COUNTS  -0.4f  // PWM por count de diferencia acumulada L/R
#define REVERSA_RECTA_QUIETO_MS  250U   // ms sin ticks de encoder para considerar "quieto" (sin corrección)

#define LINEA_DETECCION_CONFIRMA_CICLOS  3U     // 30ms: confirma que la línea reapareció
#define LINEA_DETECCION_LIBERA_CICLOS    5U     // 50ms: confirma que la línea desapareció

#define OBJ_DETECCION_UMBRAL_ADC          3200.0f  // objeto detectado si ADC < este valor (sin objeto: ~4095, con objeto: <2000)
#define OBJ_DETECCION_ANTIRREBOTE_CICLOS  10       // ciclos consecutivos (100 ms) para confirmar objeto
#define OBJ_FRENTE_CONFIRMA_CICLOS        5U       // 50ms: ADC6 o ADC8 debe confirmar el objeto
#define OBJ_FRENTE_CONFIRMA_TIMEOUT_MS    800U     // sin confirmación frontal, cancelar el falso esquive
// Distancia objetivo al objeto: el hold del STOP (OBJ_FRENO_REVERSA) retrocede/
// avanza hasta que ADC6 y ADC8 (los frontales) lean dentro de la banda
// CLEAR..CLEAR+BAND — así la distancia final al objeto es siempre la misma,
// sin importar a qué distancia se lo detectó.
#define OBJ_DISTANCIA_BANDA_PISO_ADC          3500.0f   // piso de la banda de distancia en ADC6/ADC8
// Hold de distancia durante el STOP: si vuelve a acercarse (ADC < CLEAR)
// corrige hacia atrás; si se alejó de más (ADC > CLEAR+BAND) corrige hacia adelante;
// dentro de la banda queda quieto con freno de encoders.
#define OBJ_DISTANCIA_BANDA_ANCHO     400.0f  // banda muerta por encima de CLEAR (3500..3900 = quieto)
#define OBJ_DISTANCIA_BANDA_FINA      60.0f   // banda muerta chica alrededor del centro: adentro no corrige, deja frenar/asentar
#define OBJ_DISTANCIA_ANGULO_MIN      0.7f    // corrección mínima cuando apenas se sale de la zona fina
#define OBJ_DISTANCIA_ANGULO_MAX      2.2f    // tope de corrección del hold (el anti-stall queda de respaldo si no alcanza)
#define OBJ_DISTANCIA_ERROR_PARA_MAX  220.0f  // error (ADC) a partir del cual ya usa ANGLE_MAX
// Damping por velocidad en el hold: es el termino D. El robot es un doble
// integrador (angulo -> aceleracion -> velocidad -> posicion) y un P de posicion
// sin D oscila SIEMPRE: se pasa, vuelve, choca la pared. Inclina en contra del
// movimiento con la velocidad RAPIDA de encoders (velocidad_est_ema; la lenta del
// freno general tarda ~0.5s y aca llega tarde): yendo hacia atras inclina adelante,
// yendo hacia la pared inclina atras -> frena ANTES de pasarse de largo en ambos
// sentidos. Deadband 0.15 filtra el ruido de un tick suelto (0.112 tras el LPF).
#define OBJ_DISTANCIA_AMORTIGUACION_KV   4.0f   // grados por m/s en contra del movimiento
#define OBJ_DISTANCIA_VEL_ZONA_MUERTA    0.15f  // deadband de velocidad (m/s)
#define OBJ_DISTANCIA_AMORTIGUACION_MAX  2.5f   // tope del término de damping (grados)
// El giro de esquive recién arranca cuando la distancia estuvo DENTRO de la banda
// (3600..3900 en A6 y A8) durante STABLE_MS continuos — si la corrección lo está
// moviendo, el giro espera. Timeout total como colchón por si nunca se estabiliza.
#define OBJ_DISTANCIA_ESTABLE_MS  2000U   // ms continuos dentro de la banda antes de permitir el giro
#define OBJ_DISTANCIA_TIMEOUT_MS  10000U  // colchón: girar igual si en este tiempo total nunca se estabilizó
#define OBJ_HOLD_DURACION_MS    2000U   // ms de balance estatico en OBJ_HOLD antes de wall-following
// Hold de POSICION en la pausa post-giro. El freno por velocidad
// (Freno_AnguloSegunModo) usa la velocidad LENTA y solo frena: no devuelve la
// deriva ya recorrida. P suave sobre los counts netos de encoder desde la
// entrada a la pausa (1 count ~ 6.3mm).
#define OBJ_PAUSA_POSICION_KP                  0.06f  // grados por count de deriva (≈1° cada 10 cm)
#define OBJ_PAUSA_POSICION_ANGULO_MAX          1.5f   // tope de la corrección de posición (°)
#define OBJ_PAUSA_POSICION_ZONA_MUERTA_COUNTS  3.0f   // banda muerta (≈2 cm): adentro no corrige, deja asentar
#define OBJ_GIRO_FINAL_VENTANA_MS              1500U  // la línea hallada al salir del bordeo debe disparar PERPENDICULAR dentro de esta ventana
// Esquive alternado. obj_esquive_dir = +1 -> giro 90 grados a la DERECHA y pared
// seguida con el lateral izquierdo ADC7 (adc_mediana[6]). -1 -> todo espejado:
// giro a la IZQUIERDA y pared con el lateral derecho ADC5 (adc_mediana[4]).
// Se alterna en cada deteccion de objeto (la primera va a la derecha) y se rearma
// en derecha al entrar al modo linea. Mismos mecanismos, umbrales y constantes en
// ambos sentidos: solo cambian el signo de los pivots y el sensor lateral.
#define OBJ_PARED_ADC_INDICE        ((obj_esquive_dir > 0) ? 6 : 4)  // ADC7 o ADC5 según sentido
#define OBJ_PARED_UMBRAL            3600.0f                          // ADC < umbral → objeto visible; > umbral → perdido (3750 dejaba que se alejara demasiado antes de girar a buscarlo)
#define OBJ_PARED_REVERSA_UMBRAL    600.0f                           // ADC7 < este valor → demasiado cerca, reversa pareja
#define OBJ_PARED_MUY_CERCA_UMBRAL  2100.0f                          // ADC7 entre REVERSE_THOLD y este valor → pivot derecha
// Reversa de pared por DISTANCIA fija de encoders (latch): al disparar se
// retrocede OBJ_PARED_REVERSA_COUNTS counts (~6.3mm c/u) antes de devolver el
// control, con timeout de seguridad por si esta trabado. Va por distancia y no
// por umbral de ADC porque apenas se despega unos mm el sensor ya libera y el
// robot nunca se aleja de verdad.
#define OBJ_PARED_REVERSA_ANGULO      4.5f   // grados de inclinación hacia atrás durante la reversa por pared (3.0 no vencía la fricción)
#define OBJ_PARED_REVERSA_COUNTS      24     // counts de retroceso fijo (~15 cm) al disparar la reversa de pared
#define OBJ_PARED_REVERSA_TIMEOUT_MS  3000U  // colchón: si en este tiempo no completó los counts, sale igual
// Destrabe por atascamiento. Si en los estados de pared (avanza/pivot) los
// encoders no acumulan movimiento significativo en una ventana de STUCK_WIN_MS,
// el robot quedo ATORADO contra la pared (empujando sin moverse, o pivot
// trabado): se dispara el mismo latch de reversa pero con un objetivo LARGO
// (ESCAPE_COUNTS) para despegarlo de verdad antes de reintentar.
#define OBJ_PARED_TRABADO_VENTANA_MS     2500U  // ventana de detección de atorado (5000 era mucho tiempo empujando la pared)
#define OBJ_PARED_TRABADO_COUNTS         20     // menos que esto de movimiento en la ventana (~13 cm) = atorado
#define OBJ_PARED_REVERSA_ESCAPE_COUNTS  60     // counts de la reversa de destrabe (~38 cm)
// Si en BORDEAR_PARED/PARED_LIBRE/GIRO_PARED la pared (ADC7) no vuelve a verse
// en ningun momento durante este tiempo continuo, se aborta toda la secuencia a
// reposo (ROBOT_STATE_IDLE) en vez de seguir buscandola a ciegas y arriesgar
// un choque.
#define OBJ_PARED_PERDIDA_TIMEOUT_MS 5000U
// Verificacion del giro de esquive por ADC7. El giro de 90 grados por
// encoders/gyro puede quedar corto (la pared no entra en la vista lateral);
// buena detencion = ADC7 < OBJ_GIRO_ADC_OK al terminar. Si no bajo de ahi, una
// fase de ajuste fino sigue pivotando despacio hasta verla (con tope de counts
// extra y timeout para no pasarse de largo girando).
#define OBJ_GIRO_ADC_OK            3200.0f  // ADC7 debajo de esto = giro bien terminado
#define OBJ_GIRO_ADC_OK_CICLOS     3        // ciclos seguidos con ADC7 < GOOD para confirmar (30ms, anti-glitch)
#define OBJ_GIRO_AJUSTE_EXTRA_MAX  150.0f   // counts extra máximos del ajuste fino (~36°)
#define OBJ_GIRO_AJUSTE_EXTRA_MS   1500U    // timeout del ajuste fino
// Avance buscando la pared: mismo PI de velocidad que OBJ_BORDEAR_PARED (más cauteloso,
// target más bajo) en vez de ángulo fijo sin ningún control -- se aceleraba sin límite
// hasta encontrar la pared.
#define OBJ_PARED_ACERCA_VEL_OBJETIVO  0.3f   // m/s, avance cauteloso buscando la pared
#define OBJ_PARED_ACERCA_ANGULO_MAX    1.5f   // ángulo máximo de avance buscando la pared (°)
#define OBJ_PARED_ACERCA_TIMEOUT_MS    6000U  // ms máximos buscando la pared antes de rendirse
// Avance bordeando la pared: PI de velocidad (mismo patron que LOST_AVANZA/
// EDGE_AVANZA) en vez de angulo fijo + freno bang-bang por sobrevelocidad:
// regula la velocidad de crucero con precision en lugar de acelerar a fondo
// hasta cruzar el umbral y frenar de golpe. El perfil es el mismo que el del
// retorno por odometria: con un target mas alto el robot acelera fuerte (desde
// parado el deadband hace leer el error completo -> tilt clavado en el tope) y
// llega a la linea tan rapido que siempre se pasa.
#define OBJ_PARED_VEL_OBJETIVO       0.85f  // m/s, avance moderado bordeando la pared (1.0 se pasaba de la línea; 0.45 demasiado lento)
#define OBJ_PARED_VEL_KP             4.0f   // ganancia P acelerando
#define OBJ_PARED_VEL_KP_FRENO       22.0f  // ganancia P frenando (sobrevelocidad)
#define OBJ_PARED_VEL_KI             1.0f   // ganancia I para sostener la velocidad de crucero
#define OBJ_PARED_VEL_I_MAX          1.0f   // anti-windup del integral de velocidad
#define OBJ_PARED_AVANCE_ANGULO_MAX  3.3f   // ángulo máximo de avance en OBJ_BORDEAR_PARED (°; era 3.5 — acelerón; 2.5 le pareció poco al usuario)
#define OBJ_PARED_FRENO_ANGULO_MAX   4.0f   // freno activo máximo por sobrevelocidad en OBJ_BORDEAR_PARED (°)
// Antes de arrancar la reversa por pared, si el robot todavía tiene velocidad residual
// (viniendo de avanzar), frena primero para no
// entorpecer la reversa con inercia hacia adelante.
#define OBJ_PARED_REVERSA_QUIETO_VEL     0.15f  // m/s por debajo del cual se considera "quieto"
#define OBJ_PARED_PIVOT_POTENCIA         8.0f   // potencia del pivot en WALL_TURN/OBJ_BORDEAR_PARED
#define OBJ_PARED_LINEA_IGNORAR_MS       5000U  // ms desde la entrada al wall-following en que se ignora la línea (si es corto, ve la línea al arrancar el bordeo y aborta la esquiva)
#define OBJ_PARED_LINEA_CONFIRMA_CICLOS  5U     // lecturas consecutivas (5×10ms=50ms) antes de abandonar el bordeo por línea
#define OBJ_PARED_LIBRE_COUNTS           100    // counts de encoder a avanzar tras perder la pared, antes de girar


// Bias hardcodeado del MPU — descomenta MPU_USAR_BIAS_FIJO y reemplaza los valores
// con los que imprimió "BIAS accel_x=... accel_y=... accel_z=... giro_x=... giro_y=... giro_z=..." por USB.
// Mientras esté comentado, el robot calibra en cada arranque (requiere estar en balance).
#define MPU_USAR_BIAS_FIJO
#ifdef MPU_USAR_BIAS_FIJO
#define BIAS_FIJO_ACCEL_X  -46
#define BIAS_FIJO_ACCEL_Y  4950  // + = adelante, - = atras
#define BIAS_FIJO_ACCEL_Z  1980
#define BIAS_FIJO_GIRO_X   -441
#define BIAS_FIJO_GIRO_Y   -107
#define BIAS_FIJO_GIRO_Z   -54
#endif

/* USER CODE END PD */

ADC_HandleTypeDef hadc1;
DMA_HandleTypeDef hdma_adc1;

I2C_HandleTypeDef hi2c1;
DMA_HandleTypeDef hdma_i2c1_rx;
DMA_HandleTypeDef hdma_i2c1_tx;

TIM_HandleTypeDef htim1;
TIM_HandleTypeDef htim2;
TIM_HandleTypeDef htim3;
TIM_HandleTypeDef htim4;
TIM_HandleTypeDef htim5;

UART_HandleTypeDef huart1;

/* USER CODE BEGIN PV */
uint8_t tmo100ms, es10ms;


//static uint8_t ema_initialized = 0;
uint8_t mpu_inicializado = 0;
static volatile uint8_t mpu_pedido_pendiente = 0;
static float roll_grados = 0.0f;	// Ángulo de balanceo (eje Y, usado para el equilibrio)
static float pitch_grados = 0.0f;	// Ángulo de inclinación (eje X)

volatile uint16_t adc_valores[8];
// Historial de secuencias DMA completas. La mediana de 32 barridos rechaza
// picos breves por EMI sin ocultar un nivel alto sostenido en el pin.
static volatile uint16_t adc_historial[ADC_HISTORIAL_TAMANO][8] = {{0}};
static volatile uint8_t adc_historial_escritura = 0;
static volatile uint8_t adc_historial_cantidad = 0;
static volatile uint32_t adc_foto_secuencia = 0;
// Cuarentena de sensores de línea enganchados: un canal clavado
// en el tope (~4095, típico de soldadura fría — baja al presionarlo con el
// dedo — o emisor IR caído) finge "línea" permanente de ese lado: arrastra el
// centroide, impide detectar la pérdida de línea y ensucia todo_negro. Si un
// canal pasa LINEA_CLAVADO_MS continuos por encima de LINEA_CLAVADO_ADC se lo pone
// en cuarentena (contribuye 0 al centroide/detección y se marca con X en el
// display); vuelve solo apenas lee blanco de nuevo (< LINEA_UMBRAL_ADC).
// NOTA: es una DEFENSA, no un fix — el canal enganchado es un problema de
// hardware (revisar soldadura/conector del sensor marcado con X).
#define LINEA_CLAVADO_ADC  3950.0f  // por encima de esto se considera "clavado en el tope"
#define LINEA_CLAVADO_MS   8000U    // tiempo continuo arriba de STUCK_ADC para cuarentena
static uint32_t linea_canal_trabado_t0[4]   = {0, 0, 0, 0};
static uint8_t  linea_canal_cuarentena[4] = {0, 0, 0, 0};
static uint16_t adc_mediana[BARRAS_CANTIDAD] = {0};

uint8_t i2c1_tx_ocupado = 0;

uint8_t dato_tx, dato_rx;
static uint8_t uner_buffer_rx[RXBUFSIZE];
static uint8_t uner_buffer_tx[TXBUFSIZE];
static _sRx    unerRx;
_sTx    unerTx;
static uint8_t esp01_buffer_rx[ESP01RXBUFAT];
static uint16_t esp01_indice_escritura_rx = 0;
static uint16_t esp01_indice_lectura_rx = 0;		/* Índice de lectura para el buffer UDP entrante */

// ── Perfiles de red WiFi ─────────────────────────────────────────────────
// Para cambiar de red: tocar SOLO el número de WIFI_PERFIL_ACTIVO.
// Para agregar una red nueva: sumar una fila a la tabla (y opcionalmente a
// CLAUDE.md). SSID/password/IP quedan sincronizados automáticamente, ya no
// hace falta descomentar/comentar bloques en más de un lugar.
typedef struct {
    const char *ssid;
    const char *password;
    const char *ip;
    const char *label;
} WifiProfile_t;

static const WifiProfile_t wifiProfiles[] = {
    /* 0 */ { "FCAL",                      "fcalconcordia.06-2019", "172.23.205.98", "FCAL / Universidad" },
    /* 1 */ { "MEGACABLE FIBRA-2.4G-ckd0", "djg19dlk",              "192.168.100.5", "Casa" },
    /* 2 */ { "Delco_Mendelevich",         "toyotakia",             "192.168.1.23",  "Delco Mendelevich" },
    /* 3 */ { "Wifi Habitaciones",         "toyotakia",             "192.168.1.48",  "Wifi Habitaciones" },
};

#define WIFI_MODO_INICIAL ESP01_MODE_STATION
static uint8_t wifi_modo_pendiente = 0;
static uint32_t wifi_cambio_desde_ms = 0;

#define WIFI_PERFIL_ACTIVO  1   	        /* <<< NUMERO DE RED ELEGIDA >>> */

const char *wifiSSID;
const char *wifiPassword;
const char *wifiIp;

int16_t motor_derecho_velocidad = 0;
int16_t motor_izquierdo_velocidad  = 0;

static float integral = 0.0f;
static float ajuste_direccion = 0.0f;
static float roll_filtrado_grados = 0.0f;
static float inclinacion_lateral_ema        = 0.0f;  // inclinación lateral (banking) filtrada — solo para la Vista 3D de Qt

uint8_t estado_robot = ROBOT_STATE_IDLE; // Controls the main state machine of the robot

static uint32_t manual_ultimo_cmd_ms = 0;
static float manual_setpoint_comando = 0.0f;
static float manual_direccion_comando = 0.0f;

static float setpoint_trim = 0.0f;

static float linea_error_previo = 0.0f;
static float linea_integral = 0.0f;

uint8_t f_reset_centro_masa = 0; // Resetea el centro de gravedad en el cual el auto hace balance

// LOGGING VARIABLES
uint8_t f_enviar_log_csv = 0;
uint8_t f_enviar_log_wifi = 0;
uint8_t f_cambiar_pantalla = 0;

static uint8_t f_wifi_conectado = 0;
// Splash de conexión WiFi: al obtener IP propia, display_oled.c muestra por
// unos segundos SSID + IP propia + IP destino, pisando la pantalla activa
// (sea cual sea) y volviendo sola a ella al vencer.
#define WIFI_SPLASH_MS  4000
static uint8_t f_caido = 0;   // 1 = caído, motores apagados
static uint8_t vel_limite_falla = 0; // caída forzada por exceso de velocidad
static float vel_limite_disparo = 0.0f; // magnitud de velocidad que produjo el corte
static uint32_t vel_limite_armar_desde_ms = 0;  // instante desde el cual se habilita el corte
#define CAIDA_ALERTA_DISPLAY_MS 3000U
static uint32_t caida_alerta_hasta_ms = 0; // 0/expirado: la alarma ya no toma la pantalla
// La pantalla de caída recién se habilita cuando el usuario entra a algún modo
// distinto de IDLE: al encender, el robot suele estar acostado y
// la alarma tomaba el display de entrada — feo y sin información útil. Queda
// armada para siempre tras el primer modo activo.
static uint8_t caida_alerta_armada = 0;
// Foto congelada del último ciclo anterior al corte de motores por caída.
static eFallReason caida_motivo = FALL_REASON_NONE;
static float caida_angulo = 0.0f;
static float caida_giro = 0.0f;
static float caida_velocidad = 0.0f;
static float caida_pwm = 0.0f;

static float dt_real        = 0.0f;		// Monitoreo del perÃ­odo real entre muestras

static float velocidad_est     = 0.0f;  // velocidad estimada fusionada (gyro + accel)
static float velocidad_est_ema   = 0.0f;  // versión filtrada para el setpoint
static float setpoint_dinamico_objetivo = 0.0f;  // setpoint variable calculado cada ciclo
static float setpoint_dinamico_final = 0.0f;
static float setpoint_base_rampeado  = 0.0f;
static float setpoint_freno_rampeado = 0.0f;

float KP_value;
float KD_value;
float KI_value;
float KV_brake_value;

// Line Follower Variables
float KP_LINE = 10.0f;
float KD_LINE = 2.0f;
float KI_LINE = 0.5f;
float LINEA_UMBRAL_ADC = 3000.0f;  // entre piso blanco (~1800) y cinta negra (~3800)
float LINE_ANGLE = 2.0f;        // inclinación máxima (°) para avanzar en seguimiento de línea

// Trim del centroide de línea: corrige desplazamiento físico del array de sensores.
// Positivo = corrige deriva a la DERECHA (array montado a la izquierda del eje del robot).
// Negativo = corrige deriva a la IZQUIERDA.
// Ajustar empíricamente: empezar con 0.05, aumentar de a 0.05 hasta que el robot siga centrado.
static float linea_error_ajuste = 0.1f;

// Baseline de cada sensor ADC (valor mínimo sobre superficie blanca, sin línea).
// Medirlos colocando el robot sobre el piso blanco y leyendo adc_mediana[] en la pantalla 4.
// La sustracción de baseline elimina el offset entre sensores y mejora el centroide.
// COMPLETAR con los valores medidos:
static const float ADC_LINEA_BASE[4] = { 2000.0f, 1550.0f, 1370.0f, 1730.0f };  // s0, s1, s2, s3 — calibrado sobre fondo blanco
float LINE_SPEED_TARGET = 2.5f;  // m/s objetivo en seguimiento de línea (ajustable en runtime)
// Tope de inclinación del setpoint dinámico [°] — ajustable desde Qt con
// MODIFY_SP_LIMIT (0xC9), limitado allá a 1..15°. Es cuánto puede inclinarse
// el robot para acelerar o frenar en LINE_FOLLOWING / BALANCE_ONLY / IDLE
// (MANUAL y BALANCE_AND_SPEED conservan sus topes propios, ver
// Ctrl_SetpointDinamico). Subirlo da más autoridad de freno a velocidades
// altas; bajarlo hace al robot más conservador.
float SP_LIMIT_DEG = 5.0f;
float OBJ_DETECCION_UMBRAL_ADC_f = OBJ_DETECCION_UMBRAL_ADC;  // umbral objeto, ajustable en runtime

static eLineState linea_estado       = LINE_STATE_FOLLOWING;
static uint32_t   linea_perdida_ms     = 0;   // tick cuando se vio la línea por última vez
static uint8_t    linea_vista_desde_entrada = 0; // evita búsqueda automática antes de adquirir línea
static float      linea_busqueda_dir  = 1.0f; // dirección de búsqueda (+1 o -1)
static float      ultima_linea_dir    = 1.0f; // última dirección válida de la línea (+1 o -1)
static uint8_t    linea_centrada_al_perder = 1; // 1 = venía centrado (ADC del medio) al perder la línea, 0 = venía por los extremos
// 1 = el último sensor con señal fue un extremo (linea_peso[0]/linea_peso[3]) sin soporte del medio
static uint8_t    ultimo_detectado_solo_borde = 0;
static float      linea_error_ema   = 0.0f;

static uint8_t contador_boca_abajo = 0;
static uint8_t contador_parado = 0;
static uint8_t contador_caida = 0;

static float manual_integral_velocidad    = 0.0f;  // integral del PI de velocidad adelante/atrás en MANUAL
static float manual_rumbo_recto_rampeado = 0.0f; // corrección de rumbo recto (mismo algoritmo que REV_STRAIGHT en OBJ_REVERSE) cuando no hay giro comandado en MANUAL

static float linea_deficit_angulo_extra     = 0.0f;  // corrección P de angulo por deficit de velocidad encoder
static float linea_escape_reversa_angulo     = 0.0f;  // extra de angulo si encoders muestran reversa
static float linea_integral_velocidad      = 0.0f;  // integral del PI de velocidad (idea 1)
static float vel_rueda_der_rps      = 0.0f;  // velocidad rueda derecha, accesible fuera del bloque encoder
static float vel_rueda_izq_rps       = 0.0f;  // velocidad rueda izquierda, accesible fuera del bloque encoder
// ── Estación por rueda (Opción A) ──
// Cada rueda tiene un lazo PROPIO que mantiene su POSICIÓN (no su
// velocidad): corrige la deriva NETA acumulada de esa rueda. Trabaja ENCIMA
// del balance común (pwm_saturado), no lo reemplaza. Regular posición —y no
// velocidad— es lo que evita pelear con el vaivén del balance (que va y
// vuelve → desplazamiento neto ~0). Ver Ctrl_MotoresBalance.
static uint8_t rueda_mecanismos_habilitados     = 1;  // kill-switch: 0 → comportamiento V26 exacto
static uint8_t rueda_posc_anclada      = 0;  // 0 → recapturar el ancla de posición en el próximo ciclo
static int32_t rueda_pos_ancla_der   = 0;  // conteo de encoder de referencia, rueda DERECHA
static int32_t rueda_pos_ancla_izq   = 0;  // conteo de encoder de referencia, rueda IZQUIERDA
static float   rueda_yaw_grados        = 0.0f; // rumbo integrado del gyro Z desde el ancla [°] — heading-hold
static float   rueda_yaw_integral        = 0.0f; // integral del exceso de rumbo [°·s] — anula perturbación constante
static float   rueda_yaw_bias_dps   = 0.0f; // bias residual del gyro Z, medido SOLO en reposo real (ver Ctrl_VelocidadEncoders)
static float   rueda_vel_der_ema        = 0.0f; // velocidad rueda DERECHA filtrada (EMA) — amortiguación
static float   rueda_vel_izq_ema        = 0.0f; // velocidad rueda IZQUIERDA filtrada (EMA) — amortiguación
static uint32_t rueda_der_ultimo_tick_ms = 0;    // último tick de encoder derecho (deadband cinético/estático)
static uint32_t rueda_izq_ultimo_tick_ms = 0;    // ídem izquierdo
// Velocidad LENTA (tau ~0.5s) SOLO para el freno traslacional: meciéndose en el
// lugar la velocidad alterna de signo a ~1Hz y este filtro la promedia a ~0
// (no dispara el freno); una deriva real sostenida sí pasa (con ~0.5-1s de
// retardo, aceptable para frenar un empujón). Con el filtro rápido de antes
// (VEL_FILTRO_BETA_RAPIDO=0.35) el freno inclinaba el setpoint alternando de signo con
// retardo y BOMBEABA el bamboleo en vez de frenarlo.
#define VEL_FILTRO_BETA_LENTO  0.02f
static float velocidad_est_lenta_ema    = 0.0f;
static float linea_error_display        = 0.0f;  // último error de línea, para mostrar en pantalla
static uint8_t linea_detectada_display   = 0;      // línea detectada en el ciclo actual, para telemetría WiFi
static float pwm_saturado_prev = 0.0f;
static float error_previo = 0.0f;
static uint8_t balance_hold_activo = 0;
static uint32_t obj_ignorar_hasta_ms = 0;  // ignora sensores de objeto hasta este tick
static uint8_t  obj_falso_disparo_bloqueo = 0;   // tras falso positivo, espera que ADC5-ADC8 queden libres
static uint8_t  prev_todos_negros        = 1;  // todos los sensores de línea en negro (robot en el aire)
static uint32_t todos_negros_inicio_ms         = 0;  // tick en que empezaron a verse todos negros
static uint32_t ultima_linea_parcial_ms       = 0;  // último ciclo con línea detectada SIN los 4 en negro (vista "parcial" real, imposible en el aire)
static uint32_t accel_quieto_inicio_ms     = 0;  // tick desde que el acelerómetro dejó de moverse (0 = todavía moviéndose)
static uint8_t  f_en_el_aire                   = 0;  // 1 = robot en el aire >2s → motores detenidos
static float    accel_movimiento_ema             = 0.0f;  // variación reciente del acelerómetro (EMA), para distinguir "en la mano" de "quieto sobre blanco"
static uint32_t lrot_freno_inicio_ms        = 0;  // inicio del frenado previo al giro 180°
static uint8_t  linea_ciclos_quietos          = 0;  // ciclos consecutivos con velocidad cruda baja (gate de quietud de LOST_BRAKE/EDGE_WAIT)
static uint32_t lrot_asentar_inicio_ms       = 0;  // inicio de la pausa de estabilización post-180°
static uint32_t borde_espera_inicio_ms         = 0;  // inicio del frenado previo al giro de 45° (perdida por un extremo)
static uint8_t  obj_rot_inicializado  = 0;
static int32_t  obj_rot_der0           = 0;
static int32_t  obj_rot_izq0           = 0;
static uint32_t obj_rot_inicio_ms     = 0;
static uint8_t  obj_rot_fase        = 0;    // 0=spin, 1=freno activo, 2=ajuste fino por ADC7 (solo GIRO_ESQUIVE)
static float    obj_rot_rumbo      = 0.0f; // ángulo giro_z acumulado durante giro
static uint32_t obj_rot_fase1_ms    = 0;    // inicio de fase 1
static float    obj_rot_fase2_c0        = 0.0f; // counts al entrar al ajuste fino por ADC7
static uint32_t obj_rot_fase2_ms        = 0;    // inicio del ajuste fino
static uint8_t  obj_rot_adc_ok_cnt = 0;    // ciclos seguidos con ADC7 < OBJ_GIRO_ADC_OK
static int32_t  obj_rev_der0           = 0;
static int32_t  obj_rev_izq0           = 0;
static float    obj_rev_rumbo_rampeado      = 0.0f;      // corrección de rumbo rampeada, PWM absoluto (sin línea), durante OBJ_REVERSE
static int32_t  obj_rev_ultimos_counts  = 0;         // último rev_counts visto (gate de actividad del rumbo)
static uint32_t obj_rev_ultimo_mov_ms = 0;         // tick del último cambio de counts en la reversa
static int8_t   obj_esquive_dir      = 1;         // sentido del esquive ACTUAL: +1 derecha (ADC7), -1 izquierda (ADC5)
static int8_t   obj_esquive_prox_dir = 1;         // sentido de la PRÓXIMA detección (se alterna en cada objeto)
// Latch de reversa de pared por counts (ver OBJ_PARED_REVERSA_COUNTS)
static uint8_t  obj_pared_rev_latch    = 0;
static int32_t  obj_pared_rev_der0 = 0;
static int32_t  obj_pared_rev_izq0 = 0;
static uint32_t obj_pared_rev_inicio_ms = 0;
static int32_t  obj_pared_rev_objetivo     = OBJ_PARED_REVERSA_COUNTS; // objetivo de la reversa activa (normal o escape)
static int32_t  obj_pared_trabado_der0     = 0;   // snapshot de la ventana de atorado
static int32_t  obj_pared_trabado_izq0     = 0;
static uint32_t obj_pared_trabado_ms     = 0;   // 0 = ventana sin arrancar
static uint32_t obj_pared_perdida_desde_ms = 0; // 0 = pared visible / timer sin arrancar (ver OBJ_PARED_PERDIDA_TIMEOUT_MS)
static float    perdida_avance_integral_vel = 0.0f;     // integral del PI de velocidad en LOST_AVANZA/EDGE_AVANZA
static float    obj_pared_integral_vel = 0.0f;     // integral del PI de velocidad en OBJ_BORDEAR_PARED
static uint32_t obj_freno_inicio_ms   = 0;         // inicio de OBJ_BRAKE (file-scope para reset en caída)
static uint32_t obj_pre_giro_ms    = 0;         // inicio del wait post-freno antes de OBJ_ROTATE
static uint32_t obj_rev_banda_entrada_ms = 0;        // entrada a la banda 3600..3900 de A6/A8 en STOP (0 = fuera de banda)
static uint8_t  obj_frente_confirma_cnt = 0;      // lecturas consecutivas de objeto en ADC6/ADC8
static uint8_t  obj_frente_confirmado = 0;          // latch: habilita hold de distancia y giro
static uint32_t obj_hold_inicio_ms    = 0;         // inicio de la pausa post-giro (PAUSA_GIRO, 2s)
static int32_t  obj_pausa_der0         = 0;         // ancla de posición del hold post-giro (PAUSA_GIRO)
static int32_t  obj_pausa_izq0         = 0;
static uint32_t obj_giro_final_pendiente_ms = 0;     // línea reencontrada al salir del bordeo; espera el giro final PERPENDICULAR
static uint8_t  perpendicular_desde_esquive   = 0;     // el PERPENDICULAR_ROTATE actual es el giro final de un esquive
static uint32_t perpendicular_obj_freno_inicio_ms   = 0;     // inicio real del contrafreno suave del giro final de esquive
static uint32_t obj_pared_acerca_inicio_ms = 0;    // timestamp de entrada a WALL_APPROACH
static uint32_t obj_pared_avance_inicio_ms = 0;         // timestamp de entrada a OBJ_BORDEAR_PARED (init de PI/estado, no se usa para ignorar línea)
static uint32_t obj_pared_perdida_ms      = 0;         // (sin uso para ignorar línea, ver obj_pared_sec_inicio_ms)
static uint8_t  obj_pared_libre_inicializado = 0;     // flag sesión actual de OBJ_PARED_LIBRE
static uint32_t obj_pared_sec_inicio_ms = 0;         // timestamp de entrada a TODA la secuencia de wall-following
                                                    // (BORDEAR_PARED/PARED_LIBRE/GIRO_PARED); se fija UNA sola vez
                                                    // al entrar desde BUSCAR_PARED y NO se resetea al ciclar entre
                                                    // esos 3 estados -- ver fix "ignora la línea todo el tiempo"
static int32_t  obj_pared_libre_der0 = 0;
static int32_t  obj_pared_libre_izq0 = 0;
static uint8_t  obj_pared_linea_confirma_cnt = 0;     // debounce compartido por los 3 estados de pared

volatile uint8_t contador_tick2ms = 0;
static uint8_t encoder_muestreo_inicializado = 0;
static uint8_t encoder_der_estado_prev = 0;
static uint8_t encoder_izq_estado_prev  = 0;

static uint8_t uart_byte_tx = 0;

static int16_t accel_x = 0, accel_y = 0, accel_z = 0;
static int16_t giro_x = 0, giro_y = 0, giro_z = 0;

static float giro_dps_clampeado = 0.0f;

static float roll_accel_filtrado = 0.0f;


static volatile uint32_t mpu_irq_tiempo_us = 0;
volatile uint8_t mpu_dato_listo_ctrl = 0;

volatile int32_t encoder_derecho = 0;
volatile int32_t encoder_izquierdo  = 0;

// ── ODOMETRÍA DE POSE ─────────────────────────────────────────────────────
// Pose estimada del robot en el plano, integrada a 100 Hz en ControlCiclo10ms:
//  - distancia: promedio de encoders (misma escala ENCODER_COUNTS_POR_VUELTA/ENCODER_METROS_POR_VUELTA que velocidad_est)
//  - rumbo: gyro Z integrado (menos sensible al slip de ruedas que el diferencial de encoders)
// Marco de referencia: (0,0) y θ=0 en el punto/orientación donde se hizo el último
// reset (cambio de modo o comando RESET_ODOMETRY desde Qt). X = adelante inicial,
// Y = lateral, θ en grados (-180..180]. Se pausa la integración durante caídas.
// ODOM_THETA_SIGNO: si al girar a la DERECHA θ se hace más POSITIVO, invertir a -1.0f
// (la convención deseada es la matemática estándar: antihorario = positivo).
#define ODOM_THETA_SIGNO  (+1.0f)
// Mejoras de precisión:
// - Gating de pivot: 1 count de encoder = ~6.3mm; girando en el lugar los ticks de
//   cada rueda caen en ciclos de 10ms DISTINTOS con el rumbo cambiando rápido, y esos
//   pasos de ±1 count integrados a rumbos diferentes no se cancelan → la posición
//   "camina" al rotar. Si el robot claramente está pivoteando (|giro_z| alto) y el avance
//   neto del ciclo es ≤1 count, se descarta la traslación de ese ciclo.
// - Bias residual de gyro Z aprendido en línea (solo para odometría): el bias fijo
//   de fábrica deriva con la temperatura; con el robot quieto (encoders sin ticks)
//   se estima el residuo con una EMA lenta y se resta al integrar θ.
// - Integración de 2º orden (rumbo de mitad de paso) para menos sesgo en curvas.
#define ODOM_PIVOT_GIROZ_DPS     40.0f   // |giro_z| por encima de esto = "está pivoteando"
#define ODOM_PIVOT_MAX_COUNTS    1       // avance neto (|dR+dL|) tolerado como ruido durante pivot
#define ODOM_GIROZ_QUIETO_LSB    150.0f  // |giro_z| crudo por debajo de esto puede ser bias (~1.5 dps)
#define ODOM_GIROZ_BIAS_ALFA     0.005f  // EMA del bias (tau ~2s a 100Hz, solo quieto)
#define ODOM_GIROZ_BIAS_MAX_LSB  200.0f  // clamp de seguridad del bias aprendido (±2 dps)
#define ODOM_QUIETO_MIN_CICLOS   50      // ciclos quieto (500ms) antes de empezar a aprender
static float odom_x_m       = 0.0f;
static float odom_y_m       = 0.0f;
static float odom_theta_grados = 0.0f;
static float    odom_giroz_bias_ema   = 0.0f;  // bias residual de giro_z aprendido (LSB), solo odometría
static uint16_t odom_quieto_cnt   = 0;     // ciclos consecutivos con el robot quieto
// Pose del último punto donde se vio la línea (para el retorno por odometría en
// LOST_AVANZA). Se actualiza cada ciclo con línea detectada en FOLLOWING.
static float   linea_perdida_x_m       = 0.0f;
static float   linea_perdida_y_m       = 0.0f;
static uint8_t linea_perdida_pose_valida = 0;
// Fase de sobrepaso del retorno por odometría (LOST_AVANZA/EDGE_AVANZA): al alcanzar
// el punto de pérdida sigue derecho RETORNO_SOBREPASO_M más para que los
// sensores crucen la línea. Snapshot de la pose donde arrancó el sobrepaso.
static uint8_t retorno_sobrepaso_activo = 0;
static float   retorno_sobrepaso_x      = 0.0f;
static float   retorno_sobrepaso_y      = 0.0f;

uint8_t direccion_pid_habilitado    = 0;     // 0 = open-loop (gyro Z), 1 = lazo cerrado encoders
static float direccion_pid_integral   = 0.0f;
static float direccion_pid_error_prev = 0.0f;
/* USER CODE END PV */

void SystemClock_Config(void);
static void MX_GPIO_Init(void);
static void MX_DMA_Init(void);
static void MX_I2C1_Init(void);
static void MX_ADC1_Init(void);
static void MX_TIM1_Init(void);
static void MX_TIM3_Init(void);
static void MX_TIM2_Init(void);
static void MX_TIM4_Init(void);
static void MX_USART1_UART_Init(void);
static void MX_TIM5_Init(void);
/* USER CODE BEGIN PFP */
static int  uart_send_byte(uint8_t byte);


int  mpu_writeReg(void   *ctx, uint8_t devAddr, uint8_t regAddr, uint8_t *data, uint16_t length);
int  mpu_readReg(void   *ctx, uint8_t devAddr, uint8_t regAddr, uint8_t *data, uint16_t length);
int  mpu_readRegDMA(void   *ctx, uint8_t devAddr, uint8_t regAddr, uint8_t *data, uint16_t length);
void mpu_delayMs(void    *ctx, uint32_t ms);
void mpu_errorCb(void *ctx, int err);
void HAL_GPIO_EXTI_Callback(uint16_t GPIO_Pin);
void MPU6050_RegisterPlatform(MPU6050_Platform_t *plat);
void MPU6050_ProcessDMA(void);

void UpdateADC_MovingAverage(void);

void calcular_inclinacion(int16_t accel_x, int16_t accel_y, int16_t accel_z, float *out_roll_deg, float *out_pitch_deg);

static void ActualizarPantalla(void);
static void ProcesarBoton(void);

static void esp01_chpd(uint8_t val);
void ESP01_AttachChangeState(OnESP01ChangeState aOnESP01ChangeState);
void appOnESP01ChangeState(_eESP01STATUS state);

void ProcessEspRxLimited(void);

static void ControlCiclo10ms(void);
static float ComputeSteeringPID(float vel_der, float vel_izq, float sp);
static void  SteeringPID_Reset(void);
static void  SampleEncoders250us(void);
static void  I2C1_Recover(void);

static inline uint32_t micros(void) {
    return DWT->CYCCNT / (SystemCoreClock / 1000000);
}
/* USER CODE END PFP */

/* USER CODE BEGIN 0 */
static void SampleEncoders250us(void)
{
    // Tabla de transiciones de cuadratura: indice = 4*estado_anterior + estado_actual
    // (2 bits A:B cada uno). +1 = giro en un sentido, -1 = el otro, 0 = sin cambio
    // o salto imposible (ruido). Sustituye a un if/else de 16 casos.
    static const int8_t cuadratura_delta[16] = {
         0, -1, +1,  0,
        +1,  0,  0, -1,
        -1,  0,  0, +1,
         0, +1, -1,  0
    };

    uint8_t ra = (uint8_t)HAL_GPIO_ReadPin(GPIOA, GPIO_PIN_8);
    uint8_t rb = (uint8_t)HAL_GPIO_ReadPin(GPIOB, GPIO_PIN_13);
    uint8_t la = (uint8_t)HAL_GPIO_ReadPin(GPIOB, GPIO_PIN_14);
    uint8_t lb = (uint8_t)HAL_GPIO_ReadPin(GPIOB, GPIO_PIN_15);

    uint8_t right_state = (uint8_t)((ra << 1) | rb);   // Empaqueta A y B en un numero de 2 bits (0..3)
    uint8_t left_state  = (uint8_t)((la << 1) | lb);

    if (!encoder_muestreo_inicializado) {
        encoder_der_estado_prev = right_state;
        encoder_izq_estado_prev  = left_state;
        encoder_muestreo_inicializado = 1;
        return;
    }

    uint8_t right_idx = (uint8_t)((encoder_der_estado_prev << 2) | right_state);   // Indice de la tabla: anterior (bits 3-2) + actual (bits 1-0)
    uint8_t left_idx  = (uint8_t)((encoder_izq_estado_prev  << 2) | left_state);

    // Signo invertido a propósito: la tabla cuadratura_delta da la convención opuesta
    // a la que tenía el conteo viejo por EXTI (verificado a mano transición por
    // transición). Sin este signo, velocidad_est_ema queda invertido y el freno
    // traslacional (Freno_AnguloSegunModo) empuja en el sentido del
    // movimiento en lugar de frenarlo -> el robot se acelera en vez de balancear.
    encoder_derecho -= cuadratura_delta[right_idx];
    encoder_izquierdo  -= cuadratura_delta[left_idx];

    encoder_der_estado_prev = right_state;
    encoder_izq_estado_prev  = left_state;
}

MPU6050_Platform_t mpuPlat = {
  .ctx         = &hi2c1,
  .writeReg    = mpu_writeReg,
  .readReg     = mpu_readReg,
  .readRegDMA  = mpu_readRegDMA,
  .delayMs     = mpu_delayMs,
  .onError    = mpu_errorCb
};

void HAL_TIM_PeriodElapsedCallback(TIM_HandleTypeDef *htim) {
    if (htim->Instance == TIM1) {        // 10 ms
        es10ms = 1;
    }

    if (htim->Instance == TIM2) {        // 250 µs
        SampleEncoders250us();
    }

    if (htim->Instance == TIM5) {        // 2 ms
    	if (contador_tick2ms < 10) contador_tick2ms++;
    }
}


void HAL_I2C_MemRxCpltCallback(I2C_HandleTypeDef *hi2c)
{
    if (hi2c->Instance == I2C1) {
        I2C_Manager_OnMemRxCplt(hi2c);
        i2c1_tx_ocupado = I2C_Manager_IsBusy();
    }
}
void HAL_I2C_MasterTxCpltCallback(I2C_HandleTypeDef *hi2c)
{
    if (hi2c->Instance == I2C1) {
        I2C_Manager_OnMasterTxCplt(hi2c);
        i2c1_tx_ocupado = I2C_Manager_IsBusy();
    }
}

void HAL_I2C_ErrorCallback(I2C_HandleTypeDef *hi2c)
{
    if (hi2c->Instance == I2C1) {
        I2C_Manager_OnError(hi2c);
        i2c1_tx_ocupado = I2C_Manager_IsBusy();
    }
}

void HAL_ADC_ConvCpltCallback(ADC_HandleTypeDef *hadc)
{
    if (hadc->Instance == ADC1) {
        // Seqlock: impar mientras se publica, par cuando el historial es coherente.
        adc_foto_secuencia++;
        __DMB();
        uint8_t row = adc_historial_escritura;
        for (uint8_t ch = 0; ch < 8; ++ch)
            adc_historial[row][ch] = adc_valores[ch];
        adc_historial_escritura = (uint8_t)((row + 1U) % ADC_HISTORIAL_TAMANO);   // Buffer circular por modulo: al llegar al final vuelve a 0
        if (adc_historial_cantidad < ADC_HISTORIAL_TAMANO)
            adc_historial_cantidad++;
        __DMB();
        adc_foto_secuencia++;
    }
}

void HAL_UART_RxCpltCallback(UART_HandleTypeDef *huart) {
    if (huart->Instance == USART1) {
        ESP01_WriteRX(dato_rx);      // Sube byte al buffer AT
        //ESP01_Task();    // dentro hace ESP01ATDecode()
        HAL_UART_Receive_IT(&huart1, &dato_rx, 1);
    }
}

// Sin este callback, un error de overrun (ORE) aborta la recepción IT y nadie
// vuelve a armarla: el RX del ESP-01 queda muerto hasta el próximo reset.
void HAL_UART_ErrorCallback(UART_HandleTypeDef *huart) {
    if (huart->Instance == USART1) {
        __HAL_UART_CLEAR_OREFLAG(huart);
        huart->ErrorCode = HAL_UART_ERROR_NONE;
        HAL_UART_Receive_IT(&huart1, &dato_rx, 1);
    }
}

static int uart_send_byte(uint8_t byte) {
    return (HAL_UART_Transmit(&huart1, &byte, 1, 2) == HAL_OK) ? 1 : 0;
}

int mpu_writeReg(void *ctx, uint8_t devAddr, uint8_t regAddr, uint8_t *data, uint16_t len)
{
    HAL_StatusTypeDef st = HAL_I2C_Mem_Write((I2C_HandleTypeDef*)ctx, devAddr, regAddr,
    					I2C_MEMADD_SIZE_8BIT, data, len, HAL_MAX_DELAY);
    if (st != HAL_OK) {
        mpuPlat.onError(mpuPlat.ctx, st);
        return -1;
    }
    return 0;
}

int mpu_readReg(void *ctx, uint8_t devAddr, uint8_t regAddr, uint8_t *data, uint16_t len)
{
    HAL_StatusTypeDef st = HAL_I2C_Mem_Read((I2C_HandleTypeDef*)ctx, devAddr, regAddr,
    					I2C_MEMADD_SIZE_8BIT, data, len, HAL_MAX_DELAY);
    if (st != HAL_OK) {
        mpuPlat.onError(mpuPlat.ctx, st);
        return -1;
    }
    return 0;
}

static void mpu_dma_done_cb(void *context, HAL_StatusTypeDef status)
{
    mpu_pedido_pendiente = 0;
    if (status == HAL_OK) {
        MPU6050_ProcessDMA();
        mpu_dato_listo_ctrl = 1;  // <-- flag para el main loop
    } else {
        mpu_errorCb(mpuPlat.ctx, status);
    }
}

int mpu_readRegDMA(void *ctx,
                   uint8_t devAddr,
                   uint8_t regAddr,
                   uint8_t *data,
                   uint16_t len)
{
    I2C_Request_t req = {
        .type       = I2C_REQ_MEM_READ_DMA,
        .hi2c       = (I2C_HandleTypeDef*)ctx,
        .devAddr    = devAddr,
        .memAddr    = regAddr,
        .memAddSize = I2C_MEMADD_SIZE_8BIT,
        .data       = data,
        .len        = len,
        .callback   = mpu_dma_done_cb,
        .context    = NULL
    };

    uint8_t enqueued = I2C_Manager_EnqueuePriority(&req);

    if (!enqueued) {
        mpu_pedido_pendiente = 0;
        return -1;
    }

    // NO llamar Process() acá — solo marcar pending
    // El main loop lo va a llamar
    i2c1_tx_ocupado = I2C_Manager_IsBusy();
    return 0;
}


void mpu_delayMs(void *ctx, uint32_t ms) {
    HAL_Delay(ms);
}

void mpu_errorCb(void *ctx, int err) {
    (void)ctx;

    mpu_pedido_pendiente = 0;
    USB_Debug("MPU ERROR err=%d\r\n", err);
}

void HAL_GPIO_EXTI_Callback(uint16_t GPIO_Pin)
{
    if (GPIO_Pin == MPU_INT_Pin)
    {
        mpu_irq_tiempo_us = micros();  // timestamp exacto del dato

        if (!f_reset_centro_masa && mpu_inicializado && !mpu_pedido_pendiente)
        {
            // La lectura del MPU siempre se encola con prioridad. Si el I2C
            // estÃ¡ ocupado por OLED u otra tarea, la request del sensor queda
            // primera en cola y se ejecuta apenas se libera el bus.
            mpu_pedido_pendiente = 1;
            MPU6050_StartRead_DMA();
        }
    }

}

void calcular_inclinacion(int16_t accel_x, int16_t accel_y, int16_t accel_z,
                    float *out_roll_deg, float *out_pitch_deg)
{
    // roll = atan2( accel_y, accel_z )
    *out_roll_deg = atan2f(accel_y, accel_z) * (180.0f / M_PI);   // Trigonometria: angulo de g (atan2 = 4 cuadrantes) + rad->grados

    // pitch = atan2( -accel_x, sqrt( accel_y² + accel_z² ) )
    float accel_y_float = (float)accel_y;
    float accel_z_float = (float)accel_z;
    float denom = sqrtf(accel_y_float*accel_y_float + accel_z_float*accel_z_float);   // Pitagoras: modulo de g en el plano YZ
    *out_pitch_deg = atan2f(-accel_x, denom) * (180.0f / M_PI);   // Trigonometria: cateto opuesto (X) / adyacente (YZ)
}

void UpdateADC_MovingAverage(void) {
    // Copia coherente de los últimos 32 barridos completos (~8ms). A diferencia
    // del filtro anterior, que elegía una sola de las ~40 secuencias disponibles
    // cada 10ms, la mediana usa el flujo real de 4kHz y rechaza pulsos aislados a
    // 4095 causados por conmutación/EMI. Un nivel alto sostenido no se oculta.
    uint16_t history_copy[ADC_HISTORIAL_TAMANO][8];
    uint16_t channel_samples[ADC_HISTORIAL_TAMANO];
    uint32_t seq_before, seq_after;
    uint8_t muestras_cantidad;
    for (;;) {
        seq_before = adc_foto_secuencia;
        if (seq_before & 1U) continue;
        __DMB();
        muestras_cantidad = adc_historial_cantidad;
        for (uint8_t i = 0; i < muestras_cantidad; ++i)
            for (uint8_t ch = 0; ch < 8; ++ch)
                history_copy[i][ch] = adc_historial[i][ch];
        __DMB();
        seq_after = adc_foto_secuencia;
        if (seq_before == seq_after && !(seq_after & 1U)) break;
    }

    if (muestras_cantidad == 0) return;

    for (uint8_t ch = 0; ch < BARRAS_CANTIDAD; ++ch) {
        for (uint8_t i = 0; i < muestras_cantidad; ++i)
            channel_samples[i] = history_copy[i][ch];

        // Insertion sort: n<=32, costo pequeño a 100Hz y sin memoria dinámica.
        for (uint8_t i = 1; i < muestras_cantidad; ++i) {   // Insertion sort: ordena de menor a mayor
            uint16_t key = channel_samples[i];
            int j = (int)i - 1;
            while (j >= 0 && channel_samples[j] > key) {
                channel_samples[j + 1] = channel_samples[j];
                j--;
            }
            channel_samples[j + 1] = key;
        }

        uint8_t mid = muestras_cantidad / 2U;   // Mediana: valor del medio del vector ya ordenado
        adc_mediana[ch] = (muestras_cantidad & 1U)   // n par -> promedio de los dos centrales
                   ? channel_samples[mid]
                   : (uint16_t)(((uint32_t)channel_samples[mid - 1U] +
                                 (uint32_t)channel_samples[mid]) / 2U);
    }
}

static void esp01_chpd(uint8_t val) {
    // CH_PD_GPIO_Port y CH_PD_Pin vienen de MX_GPIO_Init()
    HAL_GPIO_WritePin(CH_PD_GPIO_Port, CH_PD_Pin,
                      val ? GPIO_PIN_SET : GPIO_PIN_RESET);
}

// Mode changes are deferred until after the command ACK and allowed only at rest.
static uint8_t Wifi_RequestMode(uint8_t mode) {
    if (estado_robot != ROBOT_STATE_IDLE ||
        (mode != ESP01_MODE_STATION && mode != ESP01_MODE_SOFTAP)) return 0;
    wifi_modo_pendiente = mode;
    wifi_cambio_desde_ms = HAL_GetTick();
    return 1;
}

static void Wifi_ApplyMode(uint8_t mode) {
    esp01_indice_escritura_rx = esp01_indice_lectura_rx = 0;
    f_wifi_conectado = 0;
    if (mode == ESP01_MODE_SOFTAP) {
        wifiSSID = ESP01_AP_SSID;
        ESP01_SetSoftAP(ESP01_AP_SSID, ESP01_AP_PASSWORD);
        ESP01_StartUDP(ESP01_AP_IP, 30010, 30000);
    } else {
        wifiSSID = wifiProfiles[WIFI_PERFIL_ACTIVO].ssid;
        ESP01_SetWIFI(wifiSSID, wifiPassword);
        ESP01_StartUDP(wifiIp, 30010, 30000);
    }
    Pantalla_MostrarWifi(10000U);
}

void appOnESP01ChangeState(_eESP01STATUS state) {
    if (state == ESP01_WIFI_NEW_IP || state == ESP01_UDPTCP_CONNECTED) {
        Pantalla_MostrarWifi(WIFI_SPLASH_MS);
    }
    f_wifi_conectado = ESP01_StateUDPTCP() == ESP01_UDPTCP_CONNECTED;
}

void ProcessEspRxLimited(void) {
    uint8_t count = 0;

    while ((((esp01_indice_escritura_rx - esp01_indice_lectura_rx) & UDP_RX_MASCARA) != 0) && (count < UDP_BYTES_POR_CICLO)) {
        uint8_t b = esp01_buffer_rx[esp01_indice_lectura_rx];
        esp01_indice_lectura_rx = (esp01_indice_lectura_rx + 1) & UDP_RX_MASCARA;

        UNER_PushByte(b);

        count++;
    }
}

static float clampf_local(float value, float min_value, float max_value)
{
    if (value > max_value) return max_value;   // Saturacion (clamp): recorta a la banda [min,max]
    if (value < min_value) return min_value;
    return value;
}

// Zona muerta: devuelve cuanto se PASO del umbral, no el valor entero.
// Asi la correccion arranca en 0 al cruzarlo, sin escalon.
static float apply_deadbandf(float value, float deadband)
{
    if (value >  deadband) return value - deadband;   // Ej: (0.50, 0.15) -> 0.35
    if (value < -deadband) return value + deadband;   // Negativos: sumar acerca a cero
    return 0.0f;                                      // Adentro de la banda: nada
}

static uint8_t ObjWall_LineConfirmed(uint8_t linea_detectada, uint8_t linea_ignorada)
{
    if (linea_ignorada || !linea_detectada) {
        obj_pared_linea_confirma_cnt = 0;
        return 0;
    }
    if (obj_pared_linea_confirma_cnt < OBJ_PARED_LINEA_CONFIRMA_CICLOS)
        obj_pared_linea_confirma_cnt++;
    return (obj_pared_linea_confirma_cnt >= OBJ_PARED_LINEA_CONFIRMA_CICLOS);
}

// Si el robot pide moverse y no se mueve (friccion), le suma angulo de a poco
// hasta que arranque. Devuelve grados de empuje extra, SIEMPRE positivo:
// el signo lo pone quien llama.
// Hay UNA sola instancia compartida (los estados que la usan no coinciden):
// `tag` identifica quien la esta usando, para no heredar el empuje de otro.
static float AntiStall_Tick(uint8_t tag, uint8_t wants_motion, float empuje_max)
{
    static float    antiatasco_empuje = 0.0f;    // Empuje actual [grados]
    static uint16_t as_still   = 0;              // Ciclos seguidos quieto
    static uint8_t  as_tag     = 0xFF;           // Quien la uso la vez anterior
    static uint32_t as_last_ms = 0;              // Cuando la llamaron por ultima vez

    uint32_t now = HAL_GetTick();
    if (tag != as_tag || (now - as_last_ms) > 200U) {   // Cambio de llamador, o nadie llamo hace 200ms
        as_tag   = tag;
        antiatasco_empuje = 0.0f;                       // -> maniobra nueva: arranca de cero
        as_still = 0;
    }
    as_last_ms = now;

    if (fabsf(velocidad_est_ema) < ANTIATASCO_VEL_UMBRAL) {   // Debajo de 0.05 m/s = quieto
        if (as_still < 65535U) as_still++;                    // Cuenta cuanto lleva sin moverse (tope: no desborda)
    } else {
        as_still  = 0;                                        // Se movio: la cuenta vuelve a cero
        antiatasco_empuje *= ANTIATASCO_DECAIMIENTO;          // y suelta el empuje rapido (x0.90 por ciclo)
    }
    if (wants_motion && as_still >= ANTIATASCO_ESPERA_CICLOS)  // Recien tras 40 ciclos (400ms) trabado
        antiatasco_empuje = fminf(antiatasco_empuje + ANTIATASCO_PASO, empuje_max);   // Sube lento: +0.04 grados por ciclo, con tope
    return antiatasco_empuje;
}


// Convierte velocidad [m/s] en grados de inclinacion para frenar.
// Solo corre donde el robot NO deberia moverse: balance, IDLE, manual quieto
// y modo linea sin ver la linea. En linea normal frena el PI, no esta funcion.
static float Freno_AnguloPorVelocidad(float velocity, float freno_inclinacion_max)
{
    float vel_para_freno = apply_deadbandf(velocity, FRENO_VEL_ZONA_MUERTA);        // Debajo de 0.35 m/s no frena: seria ruido del encoder
    vel_para_freno = clampf_local(vel_para_freno, -FRENO_VEL_MAX, FRENO_VEL_MAX);   // Pasados 4 m/s el freno ya no crece
    float abs_vel = fabsf(vel_para_freno);                                          // Trabajo sin signo; se lo devuelvo al final

    float freno_magnitud = KV_FRENO * abs_vel;                  // Tramo 1: suave, 0.8 grados por m/s
    if (abs_vel > FRENO_VEL_UMBRAL)
        freno_magnitud += KV_brake_value * (abs_vel - FRENO_VEL_UMBRAL);        // Tramo 2: pasado 1 m/s, +6 grados por m/s de EXCESO

    if (vel_para_freno < 0.0f)
        freno_magnitud = -freno_magnitud;          // El freno siempre va en contra del movimiento

    return clampf_local(freno_magnitud, -freno_inclinacion_max, freno_inclinacion_max);   // Tope: si se pasa, vuelca el robot
}

// Portero de Freno_AnguloPorVelocidad: decide SI este modo frena, con que tope
// y con que velocidad. La cuenta del freno no la hace aca.
// Frena la DERIVA SOSTENIDA (irse caminando despacio), no el vaiven rapido.
static float Freno_AnguloSegunModo(uint8_t state)
{
    if ((state == ROBOT_STATE_LINE_FOLLOWING) ||
        (state == ROBOT_STATE_BALANCE_AND_SPEED)) {
        return 0.0f;                           // Modos que SI deben avanzar: no los freno
    }

    float freno_inclinacion_max = (state == ROBOT_STATE_MANUAL_CONTROL)
                         ? FRENO_INCLINACION_MAX_MANUAL
                         : FRENO_INCLINACION_MAX;   // Tope de inclinacion, por modo
    // Velocidad LENTA (tau ~0.5s): el vaiven en el lugar promedia a ~0 y no
    // dispara el freno; la deriva sostenida si pasa. Ver VEL_FILTRO_BETA_LENTO.
    return Freno_AnguloPorVelocidad(velocidad_est_lenta_ema, freno_inclinacion_max);   // La cuenta real: 2 tramos + tope
}

static void SteeringPID_Reset(void)
{
    direccion_pid_integral   = 0.0f;
    direccion_pid_error_prev = 0.0f;
}

// Calcula corrección de steering por lazo cerrado de encoders.
// sp: diferencia de velocidad deseada en rps (0 = ir recto, >0 = girar a la derecha).
// Retorna el valor de corrección equivalente a ajuste_direccion / yaw_correccion.
// Convención de signo: positivo → rueda derecha más lenta → gira a la derecha.
static float ComputeSteeringPID(float vel_der, float vel_izq, float sp)
{
    float error_direccion = sp - (vel_der - vel_izq);   // Error = referencia - medicion

    float p = DIRECCION_KP * error_direccion;   // Termino P: proporcional al error de ahora

    direccion_pid_integral += error_direccion * DT_CTRL_FIJO;   // Integracion rectangular: I += e*dt (suma de Riemann)
    if (direccion_pid_integral >  DIRECCION_I_MAX) direccion_pid_integral =  DIRECCION_I_MAX;   // Anti-windup: satura la integral
    if (direccion_pid_integral < -DIRECCION_I_MAX) direccion_pid_integral = -DIRECCION_I_MAX;
    float i = DIRECCION_KI * direccion_pid_integral;   // Termino I: memoria del error pasado

    float d = DIRECCION_KD * (error_direccion - direccion_pid_error_prev) / DT_CTRL_FIJO;   // Termino D: derivada por diferencia finita (e_k - e_k-1)/dt
    direccion_pid_error_prev = error_direccion;

    float out = p + i + d;   // Salida PID = suma de los tres terminos
    if (out >  DIRECCION_SALIDA_MAX) out =  DIRECCION_SALIDA_MAX;   // Saturacion de salida
    if (out < -DIRECCION_SALIDA_MAX) out = -DIRECCION_SALIDA_MAX;
    return out;
}

/* Acciones de la aplicacion para los gestos detectados cada 10 ms. */
static void ProcesarBoton(void)
{
    uint8_t nivel = HAL_GPIO_ReadPin(KEY_GPIO_Port, KEY_Pin);
    BotonUsuarioEventos eventos = BotonUsuario_Actualizar(nivel, HAL_GetTick());
    if (eventos.pulsacion_iniciada && f_caido) {
        caida_alerta_hasta_ms = 0;
        Pantalla_ForzarActualizacion();
    }
    if (eventos.pulsacion_larga)
        f_cambiar_pantalla = (f_cambiar_pantalla + 1) % 8;

    if (eventos.clicks == 1) {
        estado_robot = (estado_robot == ROBOT_STATE_IDLE)
                ? ROBOT_STATE_BALANCE_ONLY : ROBOT_STATE_IDLE;
    } else if (eventos.clicks == 2) {
        if (estado_robot == ROBOT_STATE_IDLE || estado_robot == ROBOT_STATE_BALANCE_ONLY) {
            estado_robot = ROBOT_STATE_LINE_FOLLOWING;
            obj_ignorar_hasta_ms = HAL_GetTick() + 4000U;
        } else {
            estado_robot = ROBOT_STATE_IDLE;
        }
    } else if (eventos.clicks >= 3) {
        static const uint8_t modos[] = {
            ROBOT_STATE_BALANCE_AND_SPEED, ROBOT_STATE_MANUAL_CONTROL, ROBOT_STATE_MOTOR_TEST
        };
        uint8_t modo = modos[(eventos.clicks >= 5) ? 2 : eventos.clicks - 3];
        estado_robot = (estado_robot == modo) ? ROBOT_STATE_IDLE : modo;
    }
}

static void ActualizarPantalla(void)
{
    // Solo se llama desde el loop principal. Evita sumar la foto al stack.
    static PantallaDatos datos;
    _Static_assert(BARRAS_CANTIDAD == PANTALLA_ADC_CANTIDAD, "Cantidad ADC de pantalla");
    memcpy(datos.linea_canal_cuarentena, linea_canal_cuarentena, sizeof(datos.linea_canal_cuarentena));
    memcpy(datos.adc_mediana, adc_mediana, sizeof(datos.adc_mediana));
    datos.motor_derecho_velocidad = motor_derecho_velocidad;
    datos.motor_izquierdo_velocidad = motor_izquierdo_velocidad;
    datos.roll_filtrado_grados = roll_filtrado_grados;
    datos.estado_robot = estado_robot;
    datos.setpoint_trim = setpoint_trim;
    datos.f_cambiar_pantalla = f_cambiar_pantalla;
    datos.f_wifi_conectado = f_wifi_conectado;
    datos.f_caido = f_caido;
    datos.vel_limite_falla = vel_limite_falla;
    datos.vel_limite_disparo = vel_limite_disparo;
    datos.caida_alerta_hasta_ms = caida_alerta_hasta_ms;
    datos.caida_motivo = caida_motivo;
    datos.caida_angulo = caida_angulo;
    datos.caida_giro = caida_giro;
    datos.caida_velocidad = caida_velocidad;
    datos.caida_pwm = caida_pwm;
    datos.velocidad_est_ema = velocidad_est_ema;
    datos.setpoint_dinamico_final = setpoint_dinamico_final;
    datos.KP_value = KP_value;
    datos.KD_value = KD_value;
    datos.KI_value = KI_value;
    datos.KV_brake_value = KV_brake_value;
    datos.KP_LINE = KP_LINE;
    datos.KD_LINE = KD_LINE;
    datos.KI_LINE = KI_LINE;
    datos.LINEA_UMBRAL_ADC = LINEA_UMBRAL_ADC;
    datos.LINE_SPEED_TARGET = LINE_SPEED_TARGET;
    datos.linea_estado = linea_estado;
    datos.linea_error_display = linea_error_display;
    datos.accel_movimiento_ema = accel_movimiento_ema;
    datos.obj_esquive_dir = obj_esquive_dir;
    datos.accel_x = accel_x;
    datos.accel_y = accel_y;
    datos.accel_z = accel_z;
    datos.giro_x = giro_x;
    datos.giro_y = giro_y;
    datos.giro_z = giro_z;
    datos.giro_dps_clampeado = giro_dps_clampeado;
    datos.odom_x_m = odom_x_m;
    datos.odom_y_m = odom_y_m;
    datos.odom_theta_grados = odom_theta_grados;
    datos.linea_perdida_x_m = linea_perdida_x_m;
    datos.linea_perdida_y_m = linea_perdida_y_m;
    datos.linea_perdida_pose_valida = linea_perdida_pose_valida;
    datos.obj_deteccion_umbral_adc = OBJ_DETECCION_UMBRAL_ADC;
    datos.obj_distancia_banda_piso_adc = OBJ_DISTANCIA_BANDA_PISO_ADC;
    datos.obj_pared_adc_indice = OBJ_PARED_ADC_INDICE;
    datos.obj_pared_umbral = OBJ_PARED_UMBRAL;
    datos.obj_pared_reversa_umbral = OBJ_PARED_REVERSA_UMBRAL;
    datos.obj_pared_muy_cerca_umbral = OBJ_PARED_MUY_CERCA_UMBRAL;
    Pantalla_Dibujar(&datos);
}

// Recupera el bus I2C cuando el DMA queda colgado sin completar la transferencia.
// Misma secuencia de 9 pulsos SCL que se usa en el boot; tarda ~20 ms.
static void I2C1_Recover(void)
{
    IWDG->KR = 0xAAAAU;  // patear antes de los HAL_Delay

    HAL_DMA_Abort(&hdma_i2c1_rx);
    HAL_DMA_Abort(&hdma_i2c1_tx);

    GPIO_InitTypeDef gi = {0};
    HAL_I2C_DeInit(&hi2c1);

    gi.Pin   = GPIO_PIN_8 | GPIO_PIN_9;
    gi.Mode  = GPIO_MODE_OUTPUT_OD;
    gi.Pull  = GPIO_NOPULL;
    gi.Speed = GPIO_SPEED_FREQ_LOW;
    HAL_GPIO_Init(GPIOB, &gi);
    HAL_GPIO_WritePin(GPIOB, GPIO_PIN_8 | GPIO_PIN_9, GPIO_PIN_SET);
    HAL_Delay(2);

    for (uint8_t i = 0; i < 9; i++) {
        HAL_GPIO_WritePin(GPIOB, GPIO_PIN_8, GPIO_PIN_RESET); HAL_Delay(1);
        HAL_GPIO_WritePin(GPIOB, GPIO_PIN_8, GPIO_PIN_SET);   HAL_Delay(1);
        if (HAL_GPIO_ReadPin(GPIOB, GPIO_PIN_9) == GPIO_PIN_SET) break;
    }
    // Condición STOP
    HAL_GPIO_WritePin(GPIOB, GPIO_PIN_9, GPIO_PIN_RESET); HAL_Delay(1);
    HAL_GPIO_WritePin(GPIOB, GPIO_PIN_8, GPIO_PIN_SET);   HAL_Delay(1);
    HAL_GPIO_WritePin(GPIOB, GPIO_PIN_9, GPIO_PIN_SET);   HAL_Delay(2);

    gi.Mode      = GPIO_MODE_AF_OD;
    gi.Alternate = GPIO_AF4_I2C1;
    gi.Speed     = GPIO_SPEED_FREQ_VERY_HIGH;
    HAL_GPIO_Init(GPIOB, &gi);
    HAL_I2C_Init(&hi2c1);

    I2C_Manager_Init();
    i2c1_tx_ocupado    = 0;
    mpu_pedido_pendiente = 0;

    USB_DebugStr("I2C RECOVER\r\n");
}

// ═══════════════════════════════════════════════════════════════════════════
//  LOOP DE CONTROL (100 Hz) — etapas de ControlCiclo10ms
//
//  ControlCiclo10ms (al final de este bloque) es solo el orquestador: llama a
//  las etapas en orden. Cada etapa es una función Ctrl_* de acá abajo, en el
//  mismo orden en que se ejecutan. Las variables de este bloque son el
//  "contexto del ciclo": se recalculan completas en cada ciclo de 10ms y
//  comunican los resultados de una etapa a las siguientes (eran locales de la
//  función original; mantienen exactamente los mismos nombres y semántica).
// ═══════════════════════════════════════════════════════════════════════════

// dt del control: fijo por diseño (desacopla el PID del jitter del sensor).
static const float dt_ctrl = DT_CTRL_FIJO;

// ── Contexto del ciclo (sensado) ──
static int32_t delta_derecho = 0, delta_izquierdo = 0;  // counts de encoder de ESTE ciclo
static int32_t enc_der = 0, enc_izq = 0;             // conteos absolutos (foto atómica)
static float   giro_velocidad_dps = 0.0f;             // gyro X en °/s (telemetría)
static float   accel_angulo_grados = 0.0f;             // roll del accel (filtro + caída)
static float   direccion_correccion = 0.0f;          // steering PID de lazo cerrado (opcional)

// ── Contexto del ciclo (seguidor de línea) ──
static float   linea_error = 0.0f;                // centroide [-1..1], izq = +
static uint8_t linea_detectada = 0;
static uint8_t linea_detectada_cruda = 0;             // lectura actual: freno inmediato al perderla
static uint8_t linea_detect_confirma_cnt = 0;
static uint8_t linea_detect_libera_cnt = 0;
static float   suma_pesos = 0.0f;                     // suma de pesos del centroide
static float   linea_pi_angulo_pedido = 0.0f;            // ángulo pedido por el PI de velocidad
static float   linea_vel_avance_deseada = 0.0f;
static float   linea_vel_avance = 0.0f;
static float   linea_acel_avance_ema = 0.0f;       // aceleración filtrada para guarda predictiva
static float   linea_vel_avance_prev = 0.0f;
static uint8_t linea_prediccion_valida = 0;
static uint8_t manual_override_linea = 0;         // comandos manuales durante LINE sin ver línea
static uint8_t linea_pivot_activo = 0;            // 1 = el sub-estado ya escribió los motores

// ── Contexto del ciclo (PID de balance → motores/telemetría) ──
static float   error = 0.0f;                     // setpoint - roll (°)
static float   termino_p = 0.0f, termino_i = 0.0f, termino_d = 0.0f;
static float   salida_pid = 0.0f;                    // suma PID sin saturar
static float   pwm_comando = 0.0f;                   // comando previo a saturación
static float   pwm_saturado = 0.0f;                   // PWM común final (±50)
static uint8_t flag_saturacion = 0;
static float   log_p_line = 0.0f, log_i_line = 0.0f, log_d_line = 0.0f;

// Reinicios compartidos: cada grupo conserva sus asignaciones y su orden.
static void ReiniciarSetpoints(void)
{
    setpoint_dinamico_objetivo = SETPOINT_ANGLE + setpoint_trim;
    setpoint_dinamico_final = SETPOINT_ANGLE + setpoint_trim;
    setpoint_base_rampeado = SETPOINT_ANGLE + setpoint_trim;
    setpoint_freno_rampeado = 0.0f;
}

static void ReiniciarVelocidad(void)
{
    velocidad_est = 0.0f;
    velocidad_est_ema = 0.0f;
    velocidad_est_lenta_ema = 0.0f;
}

static void ReiniciarPIDLinea(void)
{
    linea_integral = 0.0f;
    linea_error_previo = 0.0f;
    linea_error_ema = 0.0f;
}

static void ReiniciarEstadoGiro(void)
{
    obj_rot_inicializado = 0;
    obj_rot_fase = 0;
    obj_rot_rumbo = 0.0f;
    obj_rot_fase1_ms = 0;
}

static void RegistrarLineaRecuperada(void)
{
    linea_vista_desde_entrada = 1;
    linea_integral = 0.0f;
    linea_error_previo = 0.0f;
}

// ─────────────────────────────────────────────────────────────────────
// Etapa 1 — Lectura del IMU + métrica de manipulación.
// Devuelve 0 si el MPU todavía no tiene dato nuevo (el ciclo no corre).
// ─────────────────────────────────────────────────────────────────────
static uint8_t Ctrl_LeerIMU(void)
{
    if (!MPU6050_IsDataReady()) return 0;
    MPU6050_ClearDataReady();

    MPU6050_GetAccel(&accel_x, &accel_y, &accel_z);
    MPU6050_GetGyro(&giro_x, &giro_y, &giro_z);

    // Métrica de "se está moviendo/manipulando con la mano": suma de |delta|
    // del acelerómetro crudo entre ciclos, suavizada. Quieto sobre una
    // superficie (aunque no vea la línea) da un valor bajo y estable; en la
    // mano, aunque se intente sostener firme, siempre hay variación sostenida.
    // Usado para distinguir "lo levantaron" de "está parado sobre blanco".
    static int16_t accel_prev_x = 0, accel_prev_y = 0, accel_prev_z = 0;
    static uint8_t accel_prev_init = 0;
    if (!accel_prev_init) {
        accel_prev_x = accel_x; accel_prev_y = accel_y; accel_prev_z = accel_z;
        accel_prev_init = 1;
    }
    float accel_delta = fabsf((float)(accel_x - accel_prev_x)) +   // Norma L1 (suma de |delta| de los 3 ejes): cuanto se movio el sensor
                         fabsf((float)(accel_y - accel_prev_y)) +
                         fabsf((float)(accel_z - accel_prev_z));
    accel_movimiento_ema += 0.30f * (accel_delta - accel_movimiento_ema);   // Media movil exponencial (EMA)
    accel_prev_x = accel_x; accel_prev_y = accel_y; accel_prev_z = accel_z;
    return 1;
}

// ─────────────────────────────────────────────────────────────────────
// Etapa 2 — Velocidad por encoders: counts acumulados por la IRQ de TIM2
// → delta del ciclo → m/s (velocidad_est y sus versiones filtradas).
// ─────────────────────────────────────────────────────────────────────
static void Ctrl_VelocidadEncoders(void)
{
    static int32_t enc_right_prev = 0;
    static int32_t enc_left_prev  = 0;
    __disable_irq();
    enc_der = encoder_derecho;
    enc_izq = encoder_izquierdo;
    __enable_irq();
    delta_derecho = enc_der - enc_right_prev;   // Diferencia de counts respecto al ciclo anterior (avance de ESTE ciclo)
    delta_izquierdo  = enc_izq - enc_left_prev;
    enc_right_prev = enc_der;
    enc_left_prev  = enc_izq;
    #define ENCODER_COUNTS_POR_VUELTA  28        // 4x quadrature: ambos canales A y B, RISING+FALLING
    #define ENCODER_METROS_POR_VUELTA  0.17750f  // 2π × r_rueda (radio 2.825 cm) → m/s
    // De counts a velocidad, por análisis dimensional:
    //   delta [counts/ciclo] ÷ ENCODER_COUNTS_POR_VUELTA [counts/vuelta] = vueltas por ciclo
    //   ÷ DT_CTRL_FIJO [s/ciclo]                      = vueltas por segundo (rps)
    //   × ENCODER_METROS_POR_VUELTA [m/vuelta]  (perímetro = 2πr)  = metros por segundo
    // Promedio de ambas ruedas = velocidad del centro del robot. El signo
    // negativo fija la convención global: AVANCE = velocidad_est NEGATIVA
    // (los encoders cuentan al revés del sentido "adelante" del chasis).
    float speed_right_rps = (float)delta_derecho / (ENCODER_COUNTS_POR_VUELTA * DT_CTRL_FIJO);   // Analisis dimensional: counts -> vueltas/segundo
    float speed_left_rps  = (float)delta_izquierdo  / (ENCODER_COUNTS_POR_VUELTA * DT_CTRL_FIJO);
    float vel_encoders_ms = -((speed_right_rps + speed_left_rps) * 0.5f) * ENCODER_METROS_POR_VUELTA;   // Promedio de ambas ruedas x perimetro -> m/s
    vel_encoders_ms = clampf_local(vel_encoders_ms, -20.0f, 20.0f);   // Saturacion: descarta valores fisicamente imposibles
    velocidad_est    = vel_encoders_ms;
    // Filtro EMA (pasa-bajos de 1er orden): y += β·(x − y). Cada ciclo la
    // salida se acerca una fracción β al valor nuevo → constante de tiempo
    // τ ≈ dt/β. Con β=0.35 → τ≈29ms (rápido, para control); con β=0.02 →
    // τ≈0.5s (lento, para decisiones que no deben reaccionar a un tick suelto).
    velocidad_est_ema += VEL_FILTRO_BETA_RAPIDO * (velocidad_est - velocidad_est_ema);   // Media movil exponencial rapida (tau~29ms)
    velocidad_est_lenta_ema += VEL_FILTRO_BETA_LENTO * (velocidad_est - velocidad_est_lenta_ema);   // Media movil exponencial lenta (tau~0.5s)
    vel_rueda_der_rps = speed_right_rps;
    vel_rueda_izq_rps  = speed_left_rps;
    if (delta_derecho != 0) rueda_der_ultimo_tick_ms = HAL_GetTick();
    if (delta_izquierdo  != 0) rueda_izq_ultimo_tick_ms = HAL_GetTick();

    // Calibración del bias residual del gyro Z para el heading-hold de la
    // estación (3er intento — "desde la base"). SOLO se aprende
    // en reposo REAL: motores apagados (IDLE o caído) y encoders sin un solo
    // count en el ciclo — ahí todo lo que marque el gyro ES bias, por
    // definición. Aprender durante la estación (intento anterior) era
    // indistinguible de un giro real lento: la EMA absorbía el giro y el
    // hold lo dejaba pasar — por eso el robot "nunca terminaba de girar".
    // Convergencia en dos etapas (pedido: poder salir de IDLE
    // casi al instante): los primeros 100 ciclos en reposo usan una EMA
    // rápida (β=0.08, converge en ~0.3–0.5s) y después pasa a la lenta
    // (β=0.005, τ≈2s) que solo refina. El gate de 5°/s descarta que lo
    // estén moviendo en la mano; giro_z==0 exacto se ignora (IMU aún sin datos
    // al arrancar, para no gastar el warmup en ceros). Durante balance el
    // bias queda CONGELADO.
    if ((estado_robot == ROBOT_STATE_IDLE || f_caido) &&
        delta_derecho == 0 && delta_izquierdo == 0 && giro_z != 0) {
        static uint16_t yaw_bias_calentamiento = 0;
        float yaw_giro_z_dps = (float)giro_z / 100.0f;   // Escalado del sensor: LSB crudos / sensibilidad -> deg/s
        if (fabsf(yaw_giro_z_dps - rueda_yaw_bias_dps) < 5.0f) {
            rueda_yaw_bias_dps += ((yaw_bias_calentamiento < 100) ? 0.08f : 0.005f)
                                * (yaw_giro_z_dps - rueda_yaw_bias_dps); // Media movil exponencial
            if (yaw_bias_calentamiento < 100) yaw_bias_calentamiento++;
        }
    }
}

// ─────────────────────────────────────────────────────────────────────
// Etapa 3 — Latches del wall-following: reversa por counts, detección de
// atorado y timeout de pared perdida. Solo hace algo en los 3 estados de
// pared; fuera de ellos deja todo desarmado.
// ─────────────────────────────────────────────────────────────────────
static void Ctrl_LatchesPared(void)
{
    // ── Latch de reversa de pared por counts ──
    // Se dispara con el lateral activo (ADC7/ADC5) < THOLD y queda activo hasta retroceder
    // OBJ_PARED_REVERSA_COUNTS (o timeout). Lo consumen las ramas de setpoint
    // y de motores de los 3 estados de pared — reemplaza al chequeo
    // instantáneo de ADC que cortaba la reversa apenas se despegaba.
    if (linea_estado == LINE_STATE_OBJ_BORDEAR_PARED ||
        linea_estado == LINE_STATE_OBJ_PARED_LIBRE  ||
        linea_estado == LINE_STATE_OBJ_GIRO_PARED) {
        if (!obj_pared_rev_latch &&
            (float)adc_mediana[OBJ_PARED_ADC_INDICE] < OBJ_PARED_REVERSA_UMBRAL) {
            obj_pared_rev_latch    = 1;
            obj_pared_rev_objetivo     = OBJ_PARED_REVERSA_COUNTS;
            obj_pared_rev_der0 = enc_der;
            obj_pared_rev_izq0 = enc_izq;
            obj_pared_rev_inicio_ms = HAL_GetTick();
        }

        // Detección de atorado: sin reversa activa, si en
        // OBJ_PARED_TRABADO_VENTANA_MS el movimiento acumulado de encoders no llega
        // a STUCK_COUNTS, está trabado contra la pared (empuja sin avanzar o
        // pivot atorado) → reversa LARGA de destrabe (ESCAPE_COUNTS).
        if (!obj_pared_rev_latch) {
            if (obj_pared_trabado_ms == 0) {
                obj_pared_trabado_ms = HAL_GetTick();
                obj_pared_trabado_der0 = enc_der;
                obj_pared_trabado_izq0 = enc_izq;
            } else if (HAL_GetTick() - obj_pared_trabado_ms >= OBJ_PARED_TRABADO_VENTANA_MS) {
                int32_t trabado_desplazamiento = (abs(enc_der - obj_pared_trabado_der0) +   // Desplazamiento promedio de ambas ruedas (|delta| ignora el sentido)
                                       abs(enc_izq - obj_pared_trabado_izq0)) / 2;
                if (trabado_desplazamiento < OBJ_PARED_TRABADO_COUNTS) {
                    obj_pared_rev_latch    = 1;
                    obj_pared_rev_objetivo     = OBJ_PARED_REVERSA_ESCAPE_COUNTS;
                    obj_pared_rev_der0 = enc_der;
                    obj_pared_rev_izq0 = enc_izq;
                    obj_pared_rev_inicio_ms = HAL_GetTick();
                }
                obj_pared_trabado_ms = 0;   // nueva ventana
            }
        } else {
            obj_pared_trabado_ms = 0;       // en reversa: la ventana no corre
        }

        if (obj_pared_rev_latch) {
            int32_t pared_reversa_completada = (abs(enc_der - obj_pared_rev_der0) +   // Idem: cuanto recorrio la reversa desde su ancla de counts
                                     abs(enc_izq - obj_pared_rev_izq0)) / 2;
            // Timeout doble para la reversa de escape (recorrido más largo).
            uint32_t rev_tout = (obj_pared_rev_objetivo > OBJ_PARED_REVERSA_COUNTS)
                              ? (OBJ_PARED_REVERSA_TIMEOUT_MS * 2U)
                              : OBJ_PARED_REVERSA_TIMEOUT_MS;
            if (pared_reversa_completada >= obj_pared_rev_objetivo ||
                (HAL_GetTick() - obj_pared_rev_inicio_ms) > rev_tout)
                obj_pared_rev_latch = 0;
        }

        // ── Timeout de pared perdida ──
        // Si en toda la secuencia de pared no se vuelve a ver el objeto
        // (lateral activo < OBJ_PARED_UMBRAL) durante OBJ_PARED_PERDIDA_TIMEOUT_MS
        // continuos, se abandona la búsqueda. Antes mandaba a ROBOT_STATE_IDLE,
        // que corta el balance de golpe y hace caer al robot (reportado). Ahora
        // pasa a LINE_STATE_GIVEN_UP (mismo "reposo total" que usan los timeouts
        // de LOST_AVANZA/EDGE_AVANZA): sigue en ROBOT_STATE_LINE_FOLLOWING, upright con
        // freno de encoders (ver Ctrl_SetpointDinamico), sin intentar más
        // búsqueda — y retoma solo si la línea vuelve a aparecer.
        // Durante la reversa de pared el timer no corre: retroceder aleja
        // la pared de la vista del lateral a propósito (la de escape dura
        // hasta 6s y dispararía el timeout en plena maniobra válida).
        // El reset DEBE ser 0: es el valor que la rama de abajo interpreta
        // como "timer no arrancado". Entre (commit 165f1ac) y
        // acá decía 10 — un valor no-nulo que salteaba el
        // arranque del timer, así que al perder la pared se evaluaba
        // HAL_GetTick()-10 (≈ el uptime) contra los 5s y el GIVEN_UP saltaba
        // INSTANTÁNEAMENTE, en vez de dar los 5s de gracia para girar a
        // buscarla.
        if (obj_pared_rev_latch ||
            (float)adc_mediana[OBJ_PARED_ADC_INDICE] < OBJ_PARED_UMBRAL) {
            obj_pared_perdida_desde_ms = 0;
        } else {
            if (obj_pared_perdida_desde_ms == 0) {
                obj_pared_perdida_desde_ms = HAL_GetTick();
            } else if (HAL_GetTick() - obj_pared_perdida_desde_ms >= OBJ_PARED_PERDIDA_TIMEOUT_MS) {
                linea_estado                 = LINE_STATE_GIVEN_UP;
                ajuste_direccion        = 0.0f;
                obj_pared_perdida_desde_ms  = 0;
                obj_pared_rev_latch         = 0;
                obj_pared_trabado_ms          = 0;
            }
        }
    } else {
        obj_pared_rev_latch        = 0;
        obj_pared_trabado_ms         = 0;
        obj_pared_perdida_desde_ms = 0;
    }
}

// ─────────────────────────────────────────────────────────────────────
// Etapa 4 — Odometría de pose (x, y, θ) por dead-reckoning:
// distancia por encoders + rumbo por gyro Z. No integra durante caídas.
// ─────────────────────────────────────────────────────────────────────
static void Ctrl_Odometria(void)
{
    // ── ODOMETRÍA DE POSE ────────────────────────────────────────────
    // Distancia por encoders + rumbo por gyro Z, integrados cada ciclo.
    // Con la convención de signos actual, deltas positivos = avance
    // (velocidad_est_ema negativo = adelante, ver vel_encoders_ms arriba).
    // Durante caídas no se integra: las ruedas pueden girar sin traccionar.
    if (!f_caido) {
        // Bias residual de giro_z aprendido con el robot quieto (ver defines ODOM_GZ_*):
        // encoders sin ticks + giro_z chico durante 500ms → EMA lenta del residuo.
        if (delta_derecho == 0 && delta_izquierdo == 0 &&
            fabsf((float)giro_z - odom_giroz_bias_ema) < ODOM_GIROZ_QUIETO_LSB) {
            if (odom_quieto_cnt < 65535) odom_quieto_cnt++;
            if (odom_quieto_cnt >= ODOM_QUIETO_MIN_CICLOS) {
                odom_giroz_bias_ema += ODOM_GIROZ_BIAS_ALFA * ((float)giro_z - odom_giroz_bias_ema);   // Media movil exponencial (EMA lenta)
                odom_giroz_bias_ema = clampf_local(odom_giroz_bias_ema,
                                              -ODOM_GIROZ_BIAS_MAX_LSB, ODOM_GIROZ_BIAS_MAX_LSB);
            }
        } else {
            odom_quieto_cnt = 0;
        }
        float odom_giro_z_dps = ((float)giro_z - odom_giroz_bias_ema) / 100.0f;   // Lectura menos bias, dividido sensibilidad -> deg/s

        // Distancia recorrida este ciclo [m]: promedio de counts de ambas
        // ruedas (= avance del centro) ÷ counts/vuelta × metros/vuelta (2πr).
        // Misma conversión que la velocidad, pero sin dividir por dt.
        float odom_d = ((float)(delta_derecho + delta_izquierdo) * 0.5f / ENCODER_COUNTS_POR_VUELTA) * ENCODER_METROS_POR_VUELTA;   // Analisis dimensional: counts -> vueltas -> metros

        // Gating de pivot: rotando en el lugar, el avance neto de ±1 count por
        // ciclo es ruido de cuantización/timing, no traslación real — integrarlo
        // con el rumbo cambiando hace "caminar" la posición (ver defines arriba).
        if (fabsf(odom_giro_z_dps) > ODOM_PIVOT_GIROZ_DPS &&
            abs(delta_derecho + delta_izquierdo) <= ODOM_PIVOT_MAX_COUNTS) {	// ROTACION PURA PARA HACER LA DISTANCIA = A CERO
            odom_d = 0.0f;
        }

        // Integración de 2º orden: la traslación usa el rumbo de MITAD de paso
        // (θ + Δθ/2), no el rumbo final — menos sesgo sistemático en arcos.
        // La pose se acumula por dead-reckoning clásico:
        //   Δθ = ω·dt   (gyro Z [°/s] × 10ms)
        //   x += d·cos(θ_medio),  y += d·sin(θ_medio)
        // es decir, el paso 'd' se descompone en sus componentes según hacia
        // dónde apuntaba el robot. Usar el rumbo del MEDIO del paso equivale
        // a la regla del trapecio: en una curva, ni el rumbo viejo ni el
        // nuevo son representativos del arco — el promedio sí.
        float odom_dth = ODOM_THETA_SIGNO * odom_giro_z_dps * DT_CTRL_FIJO;   // Integracion de Euler: d(angulo) = velocidad angular * dt
        float odom_th_mid_rad = (odom_theta_grados + 0.5f * odom_dth) * (M_PI / 180.0f);   // Regla del trapecio: rumbo del MEDIO del paso
        odom_theta_grados += odom_dth;
        if      (odom_theta_grados >  180.0f) odom_theta_grados -= 360.0f;   // Wrap del angulo al rango [-180,180]
        else if (odom_theta_grados < -180.0f) odom_theta_grados += 360.0f;
        odom_x_m += odom_d * cosf(odom_th_mid_rad);   // Descomposicion del paso en componentes (polar -> cartesiano)
        odom_y_m += odom_d * sinf(odom_th_mid_rad);   // Componente Y del mismo paso (seno = cateto opuesto)
    }
}

// ─────────────────────────────────────────────────────────────────────
// Etapa 5 — Steering PID de lazo cerrado por encoders (opcional, según
// direccion_pid_habilitado). direccion_correccion se usa en los motores de BALANCE.
// ─────────────────────────────────────────────────────────────────────
static void Ctrl_SteeringLazoCerrado(void)
{
    if (direccion_pid_habilitado) {
        direccion_correccion = ComputeSteeringPID(vel_rueda_der_rps, vel_rueda_izq_rps, 0.0f);
    } else {
        direccion_correccion = 0.0f;
        SteeringPID_Reset();
    }
}

// ─────────────────────────────────────────────────────────────────────
// Etapa 6 — Timing: dt real entre muestras del MPU (solo telemetría; el
// control usa dt fijo). Devuelve 0 en el primer ciclo (sin dt válido).
// ─────────────────────────────────────────────────────────────────────
static uint8_t Ctrl_TimingDt(void)
{
    static uint32_t last_mpu_us = 0;

    uint32_t sample_us = mpu_irq_tiempo_us;

    if (last_mpu_us == 0) {
        last_mpu_us = sample_us;
        dt_real = DT_CTRL_FIJO;
        return 0;   // primer ciclo: todavía no hay dt válido
    }

    uint32_t diff_us = sample_us - last_mpu_us;   // Resta de timestamps: tiempo real entre dos datos del IMU
    last_mpu_us = sample_us;

    dt_real = (float)diff_us * 1e-6f;   // Conversion de unidades: microsegundos -> segundos
    // micros() envuelve cada ~44.7 s (CYCCNT/96 no es potencia de 2): en el ciclo
    // del wrap diff_us da basura enorme. Solo afecta telemetría (dt_ctrl es fijo).
    if (dt_real > 1.0f) dt_real = DT_CTRL_FIJO;
    return 1;
}

// ─────────────────────────────────────────────────────────────────────
// Etapa 7 — Filtro de actitud: gyro crudo → °/s, ángulo por accel,
// filtro complementario (roll_filtrado_grados) y tilt lateral para Qt.
// ─────────────────────────────────────────────────────────────────────
static void Ctrl_FiltroIMU(void)
{
    const float ANG_SIGN = +1.0f;

    // Gyro crudo (int16 LSB) → velocidad angular en °/s: se divide por la
    // sensibilidad [LSB por °/s]. El valor teórico del datasheet para el
    // fondo de escala configurado sería 131 (±250 dps), pero 100 es el que
    // quedó calibrado empíricamente contra giros reales medidos en el robot
    giro_velocidad_dps = ANG_SIGN * ((float)giro_x / 100.0f);   // Escalado del sensor: LSB crudos / sensibilidad -> deg/s
    if (giro_velocidad_dps >  250.0f) giro_velocidad_dps =  250.0f;
    if (giro_velocidad_dps < -250.0f) giro_velocidad_dps = -250.0f;

    giro_dps_clampeado = giro_velocidad_dps;
    if (giro_dps_clampeado >  180.0f) giro_dps_clampeado =  180.0f;
    if (giro_dps_clampeado < -180.0f) giro_dps_clampeado = -180.0f;

    // Ángulo de roll desde el acelerómetro, por trigonometría de la gravedad:
    // con el robot quieto, el accel solo mide g. Parado vertical, g cae toda
    // en el eje Z (accel_y≈0, accel_z≈+g) → ángulo 0°. Al inclinarse, parte de g se
    // proyecta en Y: tan(roll) = accel_y/accel_z → roll = atan2(accel_y, accel_z). Se usa atan2
    // (y no atan del cociente) porque maneja accel_z=0 y los 4 cuadrantes sin
    // dividir por cero. × 180/π pasa de radianes a grados.
    // Vale solo en cuasi-estático: acelerando, el accel mide g + movimiento
    // y este ángulo miente — por eso el filtro complementario le cree poco.
    accel_angulo_grados = ANG_SIGN * (atan2f((float)accel_y, (float)accel_z) * (180.0f / M_PI));   // Trigonometria: angulo de g, tan(roll)=accel_y/accel_z

    // Inicialización del filtro en la primera muestra — evita que arranque en 0°
    static uint8_t filter_init = 0;
    if (!filter_init) {
        roll_filtrado_grados = accel_angulo_grados;
        filter_init = 1;
    }

    // Filtro complementario (fusión gyro + accel):
    //   ángulo = 0.98 · (ángulo_anterior + gyro·dt) + 0.02 · ángulo_accel
    // El primer término integra el gyro (ángulo_anterior + velocidad×tiempo):
    // preciso a corto plazo pero acumula deriva. El segundo mezcla un 2% del
    // ángulo absoluto del accel: ruidoso pero sin deriva. El 98/2 equivale a
    // pasa-altos sobre el gyro + pasa-bajos sobre el accel con constante de
    // tiempo τ = α·dt/(1−α) ≈ 0.49s: la deriva del gyro se corrige en ~½s y
    // el ruido/aceleraciones del accel entra atenuado ~50 veces.
    roll_filtrado_grados = ALFA_COMPLEMENTARIO * (roll_filtrado_grados + giro_dps_clampeado * dt_ctrl)   // Filtro complementario: integracion de Euler del gyro (pasa-altos)
                      + (1.0f - ALFA_COMPLEMENTARIO) * accel_angulo_grados;                  // + angulo absoluto del accel (pasa-bajos), pesos que suman 1

    if (roll_filtrado_grados >  180.0f) roll_filtrado_grados =  180.0f;
    if (roll_filtrado_grados < -180.0f) roll_filtrado_grados = -180.0f;

    // Inclinación LATERAL (banking alrededor del eje de avance — el tercer
    // eje,): accel-only con EMA suave. No participa de ningún
    // control, solo viaja en el push de odometría para que la Vista 3D de
    // Qt reaccione también a este eje. Misma fórmula que calcular_inclinacion().
    {
        // Misma idea que el roll del accel, pero para el eje X: el cateto
        // opuesto es la proyección de g en X y el adyacente es lo que queda
        // de g en el plano YZ (pitágoras: √(accel_y²+accel_z²)) — así el ángulo lateral
        // no se contamina cuando el robot además está inclinado en roll.
        float lat_acc = atan2f(-(float)accel_x,
                               sqrtf((float)accel_y * (float)accel_y +          // Pitagoras: g proyectada en el plano YZ
                                     (float)accel_z * (float)accel_z)) * (180.0f / M_PI);   // Trigonometria: opuesto (X) / adyacente (YZ)
        inclinacion_lateral_ema += 0.10f * (lat_acc - inclinacion_lateral_ema);   // Media movil exponencial (EMA)
    }
}

// ─────────────────────────────────────────────────────────────────────
// Etapa 8 — Cuarentena de sensores de línea clavados en el tope
// (defensa contra soldadura fría/emisor caído, ver LINE_STUCK_*).
// ─────────────────────────────────────────────────────────────────────
static void Ctrl_CuarentenaLinea(void)
{
    for (uint8_t ch = 0; ch < 4; ch++) {
        if (adc_mediana[ch] >= (uint16_t)LINEA_CLAVADO_ADC) {
            if (linea_canal_trabado_t0[ch] == 0) {
                linea_canal_trabado_t0[ch] = HAL_GetTick();
            } else if (!linea_canal_cuarentena[ch] &&
                       (HAL_GetTick() - linea_canal_trabado_t0[ch]) >= LINEA_CLAVADO_MS) {
                linea_canal_cuarentena[ch] = 1;
            }
        } else {
            linea_canal_trabado_t0[ch] = 0;
            if (adc_mediana[ch] < (uint16_t)LINEA_UMBRAL_ADC)
                linea_canal_cuarentena[ch] = 0;   // leyó blanco: el sensor volvió
        }
    }
}
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
int main(void)
{

  /* MCU Configuration--------------------------------------------------------*/

  /* Reset of all peripherals, Initializes the Flash interface and the Systick. */
  HAL_Init();

  /* Configure the system clock */
  SystemClock_Config();

  /* Initialize all configured peripherals */
  MX_GPIO_Init();
  MX_DMA_Init();
  MX_I2C1_Init();
  MX_ADC1_Init();
  MX_TIM1_Init();
  MX_TIM3_Init();
  MX_USB_DEVICE_Init();
  MX_TIM2_Init();
  MX_TIM4_Init();
  MX_USART1_UART_Init();
  MX_TIM5_Init();
  /* USER CODE BEGIN 2 */

  // ── I2C Bus Recovery ─────────────────────────────────────────────────────
  // Si el MCU se resetó a mitad de una transacción I2C (IWDG, HardFault),
  // el esclavo (MPU-6050 o SSD1306) puede quedar con SDA en LOW, bloqueando
  // todas las transacciones siguientes y causando freeze en el boot.
  // Se generan 9 pulsos manuales en SCL para forzar al esclavo a soltar SDA,
  // luego condición STOP, antes de cualquier uso real del periférico I2C.
  {
    GPIO_InitTypeDef gi = {0};
    HAL_I2C_DeInit(&hi2c1);                       // libera el periférico y los pines AF

    gi.Pin   = GPIO_PIN_8 | GPIO_PIN_9;            // PB8=SCL, PB9=SDA
    gi.Mode  = GPIO_MODE_OUTPUT_OD;
    gi.Pull  = GPIO_NOPULL;
    gi.Speed = GPIO_SPEED_FREQ_LOW;
    HAL_GPIO_Init(GPIOB, &gi);

    HAL_GPIO_WritePin(GPIOB, GPIO_PIN_8 | GPIO_PIN_9, GPIO_PIN_SET);
    HAL_Delay(5);

    for (int _i = 0; _i < 9; _i++) {              // 9 pulsos SCL
      HAL_GPIO_WritePin(GPIOB, GPIO_PIN_8, GPIO_PIN_RESET);
      HAL_Delay(1);
      HAL_GPIO_WritePin(GPIOB, GPIO_PIN_8, GPIO_PIN_SET);
      HAL_Delay(1);
      if (HAL_GPIO_ReadPin(GPIOB, GPIO_PIN_9) == GPIO_PIN_SET)
        break;                                     // SDA libre, listo
    }

    // Condición STOP: SDA low → high con SCL high
    HAL_GPIO_WritePin(GPIOB, GPIO_PIN_9, GPIO_PIN_RESET); HAL_Delay(1);
    HAL_GPIO_WritePin(GPIOB, GPIO_PIN_8, GPIO_PIN_SET);   HAL_Delay(1);
    HAL_GPIO_WritePin(GPIOB, GPIO_PIN_9, GPIO_PIN_SET);   HAL_Delay(5);

    // Restaurar pines a función alternativa I2C1 y reinicializar el periférico
    gi.Mode      = GPIO_MODE_AF_OD;
    gi.Alternate = GPIO_AF4_I2C1;
    gi.Speed     = GPIO_SPEED_FREQ_VERY_HIGH;
    HAL_GPIO_Init(GPIOB, &gi);
    HAL_I2C_Init(&hi2c1);
  }

  // ── IWDG (Independent Watchdog) ──────────────────────────────────────────
  // Resetea el MCU si el loop principal deja de ejecutarse por más de ~2s.
  // LSI (~32 kHz) es independiente del clock principal; no se puede detener.
  IWDG->KR  = 0x5555U;
  IWDG->PR  = 0x06U;            // /256 → tick ≈ 8 ms
  IWDG->RLR = 250U;             // timeout = 251 × 8 ms ≈ 2 s
  { uint32_t _t = HAL_GetTick();
    while (IWDG->SR && (HAL_GetTick() - _t) < 50U) {} }
  IWDG->KR  = 0xAAAAU;
  IWDG->KR  = 0xCCCCU;

  // Prioridades de interrupts — CubeMX las resetea a 0 al regenerar; las fijamos acá.
  // Fix: DMA de I2C subido a prio 0 (antes empataba en 1 con EXTI15_10),
  // para que el fin de transacción I2C/MPU siempre pueda preemptar a los encoders.
  // Con el giro de 180° generando ráfagas de EXTI15_10, el empate dejaba el DMA I2C
  // pendiente en cola -> freeze de lectura MPU -> PWM congelado al último valor
  // (alto, en pleno pivot) -> robot "aceleradísimo" y trabado hasta que el IWDG resetea.
  // Los encoders ya no usan EXTI: se decodifican por muestreo periódico con TIM2 (250 us),
  // dejando EXTI exclusivamente para MPU_INT y evitando storms/re-entradas compartidas.
  HAL_NVIC_SetPriority(DMA1_Stream0_IRQn, 0, 0);  // I2C1 RX DMA
  HAL_NVIC_SetPriority(DMA1_Stream1_IRQn, 0, 0);  // I2C1 TX DMA
  HAL_NVIC_SetPriority(DMA2_Stream0_IRQn, 2, 0);  // ADC1 DMA
  HAL_NVIC_SetPriority(EXTI15_10_IRQn,    2, 0);  // MPU (PB12)
  HAL_NVIC_SetPriority(TIM2_IRQn,         3, 0);  // muestreo de encoders, debajo de DMA/I2C y MPU
  HAL_NVIC_DisableIRQ(EXTI9_5_IRQn);              // PA8 ya no interrumpe
  HAL_NVIC_SetPriority(TIM5_IRQn,         6, 0);  // libre / no usado por encoders

  wifiSSID     = wifiProfiles[WIFI_PERFIL_ACTIVO].ssid;
  wifiPassword = wifiProfiles[WIFI_PERFIL_ACTIVO].password;
  wifiIp       = wifiProfiles[WIFI_PERFIL_ACTIVO].ip;

  USB_Comunicacion_Init();
  HAL_UART_Receive_IT(&huart1, &dato_rx, 1);

  if (HAL_ADC_Start_DMA(&hadc1, (uint32_t*)adc_valores, 8) != HAL_OK) {
      Error_Handler();
  }
  HAL_TIM_Base_Start_IT(&htim1);   // 10 ms
  HAL_TIM_Base_Start_IT(&htim2);   // 250 us (si lo vas a usar)
  HAL_GPIO_WritePin(GPIOB, GPIO_PIN_10, GPIO_PIN_RESET);

  I2C_Manager_Init();

  ControlMotores_Init(&htim3, &htim4);

  static _sESP01Handle esp01Handle = {
      .aDoCHPD         = esp01_chpd,                  // Controla CH_PD
      .aWriteUSARTByte = uart_send_byte,          // Envía un byte por UART
      .bufRX           = esp01_buffer_rx,              // Buffer de recepción
      .irRX            = &esp01_indice_lectura_rx,
      .iwRX            = &esp01_indice_escritura_rx,              // Índice de escritura
      .sizeBufferRX    = sizeof(esp01_buffer_rx)       // Tamaño del buffer
  };

  ESP01_Init(&esp01Handle);                        // Copia el handle interno :contentReference[oaicite:1]{index=1}
  ESP01_AttachChangeState(appOnESP01ChangeState);
  esp01_chpd(1);  // Pone CH_PD a nivel alto para sacar al módulo de reset
  HAL_Delay(100);
  ESP01_AttachDebugStr(ESP01_USB_DbgStr);
  // Hold KEY while powering/resetting the Black Pill for direct WiFi.
  uint8_t boot_ap = HAL_GPIO_ReadPin(KEY_GPIO_Port, KEY_Pin) == GPIO_PIN_RESET;
  BotonUsuario_Init(boot_ap ? 0 : 1);  // release must not become a mode/motor click
  Wifi_ApplyMode(boot_ap ? ESP01_MODE_SOFTAP : WIFI_MODO_INICIAL);

  unerRx.buff = uner_buffer_rx;
  unerRx.mask = RXBUFSIZE - 1;
  unerTx.buff = uner_buffer_tx;
  unerTx.mask = TXBUFSIZE - 1;
  UNER_Init(&unerRx, &unerTx);
  static const UNER_Bindings_t unerBindings = {
      .adc = adc_mediana, .adc_len = 8,
      .motor_right_velocity = &motor_derecho_velocidad,
      .motor_left_velocity = &motor_izquierdo_velocidad,
      .ax = &accel_x, .ay = &accel_y, .az = &accel_z,
      .gx = &giro_x, .gy = &giro_y, .gz = &giro_z,
      .roll = &roll_grados, .pitch = &pitch_grados,
      .kp = &KP_value, .kd = &KD_value, .ki = &KI_value,
      .kv_brake = &KV_brake_value,
      .steering = &ajuste_direccion,
      .robot_state = &estado_robot,
      .reset_mass_center = &f_reset_centro_masa,
      .send_csv_log = &f_enviar_log_csv,
      .request_wifi_mode = Wifi_RequestMode,
      .send_wifi_log = &f_enviar_log_wifi,
      .change_display = &f_cambiar_pantalla,
      .kp_line = &KP_LINE, .kd_line = &KD_LINE, .ki_line = &KI_LINE,
      .line_threshold = &LINEA_UMBRAL_ADC, .line_speed = &LINE_SPEED_TARGET,
      .sp_limit = &SP_LIMIT_DEG,
      .manual_setpoint = &manual_setpoint_comando,
      .manual_steering = &manual_direccion_comando,
      .manual_timeout_ms = &manual_ultimo_cmd_ms,
      // rotation_target_deg/rotation_trigger quedan NULL: comandos de giro remoto no-op.
      .odom_x = &odom_x_m, .odom_y = &odom_y_m, .odom_theta = &odom_theta_grados,
      .setpoint_trim = &setpoint_trim,
      // GETSPEED (0xA4): velocidad global filtrada (m/s, interno negativo =
      // adelante — UNER.c invierte el signo al responder) y rps por rueda.
      .velocity_mps = &velocidad_est_ema,
      .wheel_right_rps = &vel_rueda_der_rps,
      .wheel_left_rps = &vel_rueda_izq_rps,
  };
  UNER_RegisterBindings(&unerBindings);

  Pantalla_Init(&hi2c1, &i2c1_tx_ocupado);

  MPU6050_RegisterPlatform(&mpuPlat);
  int status = MPU6050_Init();

  if (status != MPU6050_OK) {
      mpu_inicializado = 0;
      USB_Debug("MPU INIT FAIL\r\n");
  } else {
      mpu_inicializado = 1;
      USB_Debug("MPU INIT OK\r\n");

#ifdef MPU_USAR_BIAS_FIJO
      MPU6050_SetBias(BIAS_FIJO_ACCEL_X, BIAS_FIJO_ACCEL_Y, BIAS_FIJO_ACCEL_Z,
                      BIAS_FIJO_GIRO_X, BIAS_FIJO_GIRO_Y, BIAS_FIJO_GIRO_Z);
      USB_Debug("MPU BIAS FIJO OK\r\n");
#else
      HAL_Delay(500); // Espera que se estabilice el movimiento del switch de encendido
      MPU6050_Calibrate();
      USB_Debug("MPU CAL OK\r\n");
      {
          int32_t b_ax, b_ay, b_az, b_gx, b_gy, b_gz;
          MPU6050_GetBias(&b_ax, &b_ay, &b_az, &b_gx, &b_gy, &b_gz);
          char bias_buf[80];
          int bias_len = snprintf(bias_buf, sizeof(bias_buf),
              "BIAS accel_x=%ld accel_y=%ld accel_z=%ld giro_x=%ld giro_y=%ld giro_z=%ld\r\n",
              b_ax, b_ay, b_az, b_gx, b_gy, b_gz);
          if (bias_len > 0) USB_DebugSend((uint8_t*)bias_buf, (uint16_t)bias_len);
      }
#endif

      mpu_pedido_pendiente = 1;
      USB_Debug("MPU first read request\r\n");
      MPU6050_StartRead_DMA();
  }



  tmo100ms = 10;
  es10ms   = 0;

  motor_derecho_velocidad = 0;
  motor_izquierdo_velocidad  = 0;

  esp01_indice_escritura_rx = 0;
  esp01_indice_lectura_rx = 0;

  KP_value = KP;
  KD_value = KD;
  KI_value = KI;
  KV_brake_value = KV_FRENO_FUERTE;
  ReiniciarSetpoints();

  // Initialize DWT for micros()
  CoreDebug->DEMCR |= CoreDebug_DEMCR_TRCENA_Msk;
  DWT->CYCCNT = 0;
  // Use raw bit 0 if DWT_CTRL_CYCCNT_Msk is not defined (standard for Cortex-M4)
  DWT->CTRL |= 1;

  /* USER CODE END 2 */

  /* Infinite loop */
  /* USER CODE BEGIN WHILE */
  while (1)
  {
    /* USER CODE END WHILE */

    /* USER CODE BEGIN 3 */
	  IWDG->KR = 0xAAAAU;  // patada al IWDG: resetea el contador (debe llegar cada <2s)

	  // Control sincronizado con MPU — corre exactamente cuando hay dato, 100 Hz estable.
	  // Watchdog integrado: si pasan >150 ms sin dato nuevo (DMA I2C colgado),
	  // se ejecuta un bus recovery de I2C y se relanza la lectura del MPU sin resetear el MCU.
	  {
	      static uint32_t last_ctrl_ms = 0;

	      if (mpu_dato_listo_ctrl) {
	          mpu_dato_listo_ctrl = 0;
	          last_ctrl_ms = HAL_GetTick();
	          ControlCiclo10ms();
	      }

	      if (mpu_inicializado && last_ctrl_ms != 0 &&
	          (HAL_GetTick() - last_ctrl_ms) > 150U) {
	          I2C1_Recover();
	          mpu_pedido_pendiente = 1;
	          MPU6050_StartRead_DMA();
	          last_ctrl_ms = HAL_GetTick();
	      }
	  }

	  if (I2C_Manager_IsProcessPending()) {
	      I2C_Manager_Process();
	  }

	  if(es10ms) {
	      es10ms = 0;

	      static uint8_t subtick = 0;
	      subtick = (subtick + 1) % 10;

	      // Estas dos van siempre — son rápidas y críticas
	      ESP01_Timeout10ms();
	      UpdateADC_MovingAverage();

	      // El resto se reparte en subticks
	      switch (subtick) {
	          case 0:
	              /* ESP01 serviced on every main-loop pass below. */
	              break;
	          case 1:
	              break;
	          case 2:
	              if (UNER_ShouldSendAllSensors()) UNER_SendAllSensors();
	              break;
	          case 3:
	        	  if (f_reset_centro_masa && !I2C_Manager_IsBusy()) {
	        	      MPU6050_Calibrate();
	        	      f_reset_centro_masa = 0;
	        	      if (mpu_inicializado && !mpu_pedido_pendiente) {
	        	          mpu_pedido_pendiente = 1;
	        	          MPU6050_StartRead_DMA();
	        	      }
	        	  }
	              break;
	          case 4:
	              tmo100ms--;
	              if (tmo100ms == 0) {
	                  tmo100ms = 4;
	                  HAL_GPIO_TogglePin(LED_GPIO_Port, LED_Pin);
	                  HAL_GPIO_TogglePin(INTEGRATED_LED_GPIO_Port, INTEGRATED_LED_Pin);
	              }
	              break;
	          default:
	              break;
	      }

	      ProcesarBoton();
	  }

      if (wifi_modo_pendiente && HAL_GetTick() - wifi_cambio_desde_ms >= 300U) {
          if (estado_robot == ROBOT_STATE_IDLE) Wifi_ApplyMode(wifi_modo_pendiente);
          wifi_modo_pendiente = 0;
      }
      ESP01_Task();
	  ProcessEspRxLimited();
	  UNER_Task(); 		// Procesa tramas UNER recibidas
	  usb_service_tx();

	  if (I2C_Manager_IsProcessPending()) {
	      I2C_Manager_Process();
	  }
	  i2c1_tx_ocupado = I2C_Manager_IsBusy();
	  if (Pantalla_Procesar(estado_robot == ROBOT_STATE_IDLE || f_caido,
                           &mpu_pedido_pendiente, &mpu_dato_listo_ctrl)) {
          ActualizarPantalla();
      }

	  if (dato_tx && huart1.gState == HAL_UART_STATE_READY) {
	      uart_byte_tx = dato_tx;
	      dato_tx = 0;
	      HAL_UART_Transmit_IT(&huart1, &uart_byte_tx, 1);
	  }
  }
  /* USER CODE END 3 */
}

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
