tadeomendelevich/Balancin_Mendelevich/Balancin_Mendelevich.ioc

Mcu.UserName=STM32F411CEUx
PA0-WKUP.Signal=GPIO_Input
PA1.Signal=ADCx_IN1
PA10.Signal=USART1_RX
PA11.Signal=USB_OTG_FS_DM
PA12.Signal=USB_OTG_FS_DP
PA13.Signal=SYS_JTMS-SWDIO
PA14.Signal=SYS_JTCK-SWCLK
PA2.Signal=ADCx_IN2
PA3.Signal=ADCx_IN3
PA4.Signal=ADCx_IN4
PA5.Signal=ADCx_IN5
PA6.Signal=ADCx_IN6
PA7.Signal=ADCx_IN7
PA9.Signal=USART1_TX
PB0.Signal=ADCx_IN8
PB10.GPIO_Label=LED_BLINKER
PB10.Signal=GPIO_Output
PB12.GPIO_Label=MPU_INT
PB12.Signal=GPXTI12
PB2.Signal=GPIO_Output
PB4.Signal=S_TIM3_CH1
PB5.Signal=S_TIM3_CH2
PB6.Signal=S_TIM4_CH1
PB7.Signal=S_TIM4_CH2
PB8.Signal=I2C1_SCL
PB9.Signal=I2C1_SDA
PC13-ANTI_TAMP.Signal=GPIO_Output
