tadeomendelevich/Balancin_Mendelevich/Core/Inc/main.h

#define LED_BLINKER_Pin GPIO_PIN_10
#define LED_BLINKER_GPIO_Port GPIOB
#define MPU_INT_Pin GPIO_PIN_12
#define MPU_INT_GPIO_Port GPIOB
#define MPU_INT_EXTI_IRQn EXTI15_10_IRQn
