tadeomendelevich/Balancin_Mendelevich/(commit log)

2025-09-01 Primer commit, realizo todos los cambios de BLUEPILL a la BLACKPILL, funciona todo bien, todas las partes del codigo son funcionales, no hay errores.
    [Balancin_Mendelevich.ioc, ESP01.c, ESP01.h, MPU6050.c, MPU6050.h, UNER.c, UNER.h, main.c]
2025-10-09 feat: Implement simple proportional control for balancing
    This change introduces a basic proportional (P) controller to stabilize the self-balancing car. It reads the pitch angle from the MPU6050 sensor and adjusts the motor speeds accordingly to maintain an upright position.
    A proportional gain (KP) and a setpoint angle have been defined. This serves as the initial implementation for the full PID controller.
    [main.c]
2025-10-09 Codigo funcional antes de ser tocado por IA (jules), hago un commit antes de modificar algo. La blackpill esta funcionando todo bien, estoy por agregar el PID para controlar los motores y que se qued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
2025-10-09 feat: Add derivative control for stabilization
    This change enhances the existing proportional controller by adding a derivative (D) component, forming a PD controller. This helps to dampen oscillations and improve the stability of the self-balancing car.
    A derivative gain (KD) has been added, and the control loop now calculates the rate of change of the error to adjust the motor output more effectively.
    [main.c]
2025-10-09 refactor: Improve angle calculation precision with float
    This change refactors the angle calculation and communication to use floating-point numbers for higher precision, which is critical for the stability of the self-balancing robot.
    Key changes:
    - Modified `roll_deg` and `pitch_deg` variables in `main.c` to be `float`.
    - Replaced the integer-based CORDIC approximation with the standard `atan2f` and `sqrtf` functions from `<math.h>` for more accurate angle calculation.
    - Updated the UNER communication protocol in `UNER.h` and `UNER.c` to correctly serialize and deserialize the 4-byte float angle values, ensuring compatibility with the new data type.
    [UNER.c, UNER.h, main.c]
2025-10-09 Agrego cambios de Jules
2025-10-17 feat: Use roll angle for PD controller
    The PD control loop now uses the roll angle (`roll_deg`) instead of the pitch angle (`pitch_deg`) for stabilization. This corrects the balancing logic to use the appropriate axis of rotation.
    The comments for `roll_deg` and `pitch_deg` have been updated to reflect their roles more accurately.
    Additionally, the build system has been improved:
    - The hardcoded Windows path in `Debug/makefile` has been replaced with a relative path.
    - A `.gitignore` file has been added to exclude build artifacts from version control.
    [main.c]
2025-10-17 feat: Implement complementary filter for roll angle
    This change introduces a complementary filter to provide a more accurate and stable roll angle measurement for the self-balancing car. This improves the stability of the PD control loop.
    The filter combines the accelerometer's long-term stability with the gyroscope's short-term accuracy.
    - A complementary filter has been added to calculate `filtered_roll_deg`.
    - The PD control loop now uses this filtered angle for error calculation.
    - The `ALPHA` and `DT` constants for the filter have been defined.
    [main.c]
2025-10-17 feat: Increase MPU6050 update frequency to 100Hz
    This change doubles the sensor update rate from 50Hz (20ms) to 100Hz (10ms) by reducing the software-side delay in the main loop.
    The `mpu6050Counter` check in `Core/Src/main.c` was changed from `>= 2` to `>= 1`, effectively triggering a sensor read on every 10ms timer tick instead of every other tick.
    This reduces the system's input latency, allowing for a faster reaction to changes in the robot's tilt and improving overall stability.
    [main.c]
2025-10-17 fix: Improve MPU6050 driver and add PB10 LED
    This commit includes two main changes:
    1. **MPU6050 Driver Refactor:**
    - The MPU6050 driver has been refactored to use a chained DMA read. This ensures a robust and reliable data acquisition sequence (accelerometer followed by gyroscope) at 100Hz, fixing the issue where the sensor would stop sending data.
    - The main loop in `main.c` has been simplified to use the new, more efficient driver interface.
    2. **PB10 LED Heartbeat:**
    - The GPIO pin PB10 has been configured as an output.
    - The main loop now toggles PB10 in sync with the existing PC13 heartbeat LED, providing an additional visual indicator.
    [MPU6050.c, main.c]
2025-10-17 fix: Adjust PID gains and resolve MPU6050 warnings
    This commit addresses two issues:
    1. **PD Controller Tuning:** The proportional (KP) and derivative (KD) gains have been adjusted to `2.0` and `1.5` respectively. This provides a more aggressive and dampened response to prevent the robot from overshooting the setpoint.
    2. **Compiler Warnings:** The function declarations in `Core/Inc/MPU6050.h` have been updated to match the refactored driver implementation in `MPU6050.c`. This resolves the implicit function declaration warnings during compilation.
    [MPU6050.h, main.c]
2025-10-17 Agrego TIM5, falta realizar la logica para calcular todos los datos de la mpu ahi
2025-10-17 Subo para que Joules vea MX_TIM5_Init()
2025-10-17 feat: Implement 500Hz control loop using TIM5
    This commit refactors the control system to use a dedicated high-frequency timer (TIM5) for improved performance and stability.
    - A new timer, TIM5, has been configured to generate an interrupt every 2ms (500Hz).
    - All time-critical control logic, including sensor reading, the complementary filter, and the PD controller, has been moved to the new TIM5 interrupt service routine.
    - The 10ms timer (TIM1) is now only responsible for low-priority tasks like communication and UI updates.
    - The complementary filter's delta time (`DT`) has been updated to `0.002f` to match the new control frequency.
    - The `makefile` has been corrected to use a relative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
    [main.c]
2025-10-18 Agrego los modificadorese de KP y KD como punteros desde protocolo UNER, no se conecta al wifi, intento solucionar
2025-10-18 feat(esp01): Implement robust WiFi reconnection logic
    This commit enhances the ESP-01 driver to provide a more stable and resilient WiFi connection.
    The key changes include:
    - A new `ESP01_WIFI_RECONNECTING` state to clearly signal reconnection attempts to the application.
    - An internal `ESP01ATRECONNECT` state in the AT command state machine to handle the reconnection sequence gracefully without a full hardware reset.
    - Improved connection monitoring that periodically checks the connection status and triggers the reconnection logic if either the WiFi link or the UDP/TCP socket is lost.
    - Addition of a `.gitignore` file to exclude build artifacts from version control.
    These changes address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
    [ESP01.c, ESP01.h]
2025-10-18 refactor(esp01): Use pointers for WiFi configuration
    This commit refactors the ESP-01 driver to handle WiFi configuration (SSID, password, and remote IP) using pointers instead of local copies.
    Previously, the driver used `strncpy` to copy configuration strings into its own static arrays. Now, it stores `const char*` pointers that point directly to the configuration strings owned by `main.c`.
    This change improves modularity and makes `main.c` the single source of truth for configuration, ensuring that any changes made there are automatically used by the driver. The `ESP01_SetWIFI`, `ESP01_StartUDP`, and `ESP01_StartTCP` functions have been updated to reflect this new design.
2025-10-18 fix(esp01): Resolve compilation errors from refactoring
    This commit fixes compilation errors introduced during the refactoring of the ESP-01 driver to a pointer-based configuration.
    The errors were caused by a legacy code block in the `ESP01ATDecode` function that was attempting to modify the new read-only configuration pointers. This conflicting code, which allowed for dynamic reconfiguration of the ESP-01 module over the network, has been completely removed.
    This change ensures that the driver now compiles correctly and strictly adheres to the design of having `main.c` as the single source of truth for all configuration, as per the user's request.
    [ESP01.c]
2025-10-18 Agrego la funcion para desactivar el balanceo
2025-10-18 feat: Implement full PID controller with remote tuning
    This commit replaces the existing PD controller with a full PID controller to improve the stability of the self-balancing robot.
    - Adds an integral (I) term to the control loop in `main.c` to eliminate steady-state error.
    - Implements an anti-windup mechanism for the integral term to prevent overshoot.
    - Corrects the derivative (D) term calculation to be properly scaled by the time delta (DT), making the KD constant more physically meaningful.
    - Corrects the gyroscope sensitivity value in the complementary filter for a more accurate angle calculation.
    - Extends the UNER communication protocol to allow the new KI constant to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
    [UNER.c, UNER.h, main.c]
2025-10-19 Agrego el envio de los valores actuales de KP, KD, KI y demas, quiero actualizar el display para que muestre mejor los datos
2025-10-19 I have created the new 3x5 font, defined its data in fonts.c, and added the corresponding declaration in fonts.h. I'm now ready to proceed to the next step.
    I have integrated the new font into the display driver by creating SSD1306_Putc_Small and SSD1306_Puts_Small, which can handle the new 3x5 font. I'm now ready to proceed to the next step.
    I have modified the updateDisplay function to show the MPU6-axis data using the new 3x5 font. I will now mark this step as complete.
    I corrected the compilation error in main.c and the runtime bug in SSD1306_Putc_Small. Now I'll proceed to the next step.
    I have restored the ADC bar graph display to the updateDisplay function, ensuring that both the M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
    [main.c]
2025-10-19 Revert "Merge pull request #15 from tadeomendelevich/new-font-display"
    This reverts commit 9473b85f4721db70a65fba13ffa56f0b18021454, reversing
    changes made to c5121ae7f99c576e054ab65c8b3904cbc7f798f2.
    [main.c]
2025-10-22 Realizo el envio de datos de los modificadores de PID, el wifi esta funcionando bien, demora en conectarse, podria solucionar un poco la efectividad del protocolo wifi.
2025-11-25 feat: Implement steering control for the self-balancing robot
    This change introduces a steering control mechanism to the robot.
    The PID controller has been refactored to use a single controller for
    balancing, and a `steering_adjustment` variable is now used to create
    differential motor speeds for turning.
    The UNER protocol has been extended with a `MODIFYSTEERING` command
    (opcode 0xB6) to allow for remote control of the steering.
2025-11-25 refactor: Refactor PID controller for real-world tuning
    This commit refactors the PID controller to better align with real-world
    hardware, as opposed to a simulation environment.
    - Adjusting Kp and Kd gains to values suitable for a system
    operating in degrees instead of radians.
    - Introducing a `MOTOR_GAIN` to decouple the PID's "virtual torque"
    output from the motor's PWM command. This allows for independent
    tuning of the control logic and motor response.
    - Implementing a saturation clamp on the PWM command to prevent
    instability.
    These changes provide a much better foundation for experimentally
    tuning the robot's balance.
    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
    [UNER.c, UNER.h, main.c]
2025-11-25 Corrijo valores de control PID, no logro estabilizar el balancin.
2026-02-13 Vuelvo de las vacaciones, estoy por agregar el control reestablecer el centro del auto por comando wifi, se concta perfecto a wifi.
2026-02-13 Agrego las variables y funciones para el reset, del centro de gravedad.
    [UNER.c, UNER.h, main.c]
2026-02-13 Reestablezco el centro de gravedad y centro de balance reseteando la mpu, pero se me queda trabada luego de esto.
    [main.c]
2026-02-16 No anda el wifi en casa, intento realizar el pid pero no conecta udp.
2026-02-16 Refactor ESP01 driver to ensure internal state logic runs before user callbacks.
    This change renames `onESP01StateChange` to `ESP01_InternalStateChange` and introduces `ESP01_NotifyStateChange` as a wrapper. This ensures that critical driver logic (like handling the first Alive packet and managing connection flags) is executed even when the user provides a custom state change callback. The hardcoded UDP start on `ESP01_WIFI_NEW_IP` has been removed from the internal handler to allow `main.c` to control the connection parameters (IP/Port) fully.
2026-02-16 Handle ESP01 FAIL response in AT command parser.
    This change adds `respFAIL` ("FAIL\r\n") to the list of expected responses in `Core/Src/ESP01.c`.
    When `FAIL` is received during the `ESP01CWJAPRESPONSE` state (WiFi connection attempt), the driver now:
    1. Logs a debug message "FAIL received".
    2. Immediately resets the state machine to `ESP01ATAT` and clears the timeout, avoiding a 20-second hang.
    3. Explicitly notifies the system of a disconnection (`ESP01_WIFI_DISCONNECTED`).
    This prevents the driver from getting stuck in the `DBGESP01ATCWJAP` loop when the WiFi credentials are incorrect or the network is unreachable (e.g. 5GHz SSID on 2.4GHz hardware).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
    [ESP01.c]
2026-02-16 Esta muy lenta la conexion udp hacia el qt en casa de clara.
2026-02-17 Fix UDP Alive reliability and Protocol Length issue in UNER.c
    [ESP01.c, UNER.c]
2026-02-17 La conexion udp funciona perfecto con wifi habitaciones de casa, no con el delco mendelevich, no se por que sucede esto, pero se me traba al cambiar demasiado seguido los valores del pid.
2026-02-17 feat: Add CSV USB logging and UNER UDP telemetry
    - Implemented `LOG_ENABLE` and `LOG_DECIM` macros in `main.c` for configurable logging decimation.
    - Added CSV formatting logic in `main.c` (2ms loop) to stream control loop data (timestamp, sensors, PID terms, outputs) via USB CDC for Excel analysis.
    - Used integer scaling (x1000/x100) and `snprintf` with integer formatters to minimize CPU overhead.
    - Extended `UNER.h` with `CMD_LOG_DATA` (0xB8) and `LogData_t` structure.
    - Implemented `UNER_SendLogData` in `UNER.c` to send the binary telemetry structure via WiFi UDP only (bypassing USB to keep the CSV stream clean).
    - Initialized DWT cycle counter in `main.c` for microsecond-precision timing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
2026-02-19 feat: Add USB CSV logging and Qt Integration Guide
    - Implemented `LOG_ENABLE` and `LOG_DECIM` in `main.c` for decimated logging.
    - Added CSV formatting logic in `main.c` (2ms loop) to stream control loop data via USB CDC for Excel.
    - Disabled UDP logging for now (commented out) to prioritize USB testing.
    - Created `QT_GUIDE.md` with instructions and code snippets for reading the CSV stream in Qt (C++).
    - Extended `UNER.h` with `LogData_t` structure (prepared for future UDP logging).
    - Initialized DWT cycle counter in `main.c` for microsecond-precision timing.
    - Refactored PID calculation in `main.c` to expose P, I, D terms for logging.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
2026-02-19 Paso previo a agregar el envio de telemetria mediante USB y UDP.
2026-02-19 fix: Resolve build errors and finalize USB CSV logging
    - Replaced undeclared `DWT_CTRL_CYCCNT_Msk` with raw bitmask `1` in `main.c` to fix build failure.
    - Removed unused `configUDPObtenida` variable in `ESP01.c` to fix warning.
    - Refactored PID calculation in `m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
    [ESP01.c, main.c]
2026-02-19 Guardo cambios antes de realizar pull de resolucion de errores de telemetria CSV.
    [ESP01.c, main.c]
2026-02-20 El log de datos enviados por USB esta funcionando perfectamente, me gustaria agregar un poco la recepcion de datos mediante USB y realizar el log mediante la esp por UDP.
2026-02-20 Agrego .gitignore para binarios/build
2026-02-20 Add pitch, accel, and gyro data to USB CSV log
    - Modified `Core/Src/main.c` to include `pitch`, `ax`, `ay`, `az`, `gx`, `gy`, `gz` columns in the USB CSV stream.
    - Increased `USB_TX_BUF_SIZE` from 256 to 512 bytes to accommodate longer log lines.
    - Implemented pitch angle calculation in `main.c` using accelerometer data.
    - Added `CSV_FORMAT.txt` documenting the CSV columns and units.
    - No changes made to MPU6050 driver files as requested.
2026-02-20 Estoy por intentar mejorar el control de PID, aplicar filtros y mejoras de la constante DT para lograr balancear el auto.
2026-02-20 Estoy por agregar filtros PID y mejorar el logeo de datos enviando mas datos.
2026-02-24 Soluciono el problema con los PWM del TIM3 y TIM4, logro que den 0 volts al estar ambos motores en cero, vuelvo a colocar otro L9110 luego de haber quemado uno, funciona todo fenomenal.
    [Balancin_Mendelevich.ioc, ESP01.c, main.c]
2026-02-24 feat: Improve control loop with real DT, filters, and smart anti-windup
    - Implemented real-time delta-time calculation using DWT->CYCCNT (micros()).
    - Added Low-Pass Filters (LPF) for Gyroscope and Accelerometer data.
    - Updated Complementary Filter to use variable DT and filtered inputs.
    - Refactored PID to use 'Derivative on Measurement' to reduce kick.
    - Implemented Smart Anti-Windup (Conditional Integration) to prevent integrator saturation.
    - Added individual motor saturation logic after steering adjustment.
    - Updated CSV logging to include control loop execution time (dt_ctrl_us) and filtered sensor data.
    - Documented new CSV format in CSV_FORMAT_UPDATED.txt.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
    [main.c]
2026-02-24 Cambie logica del PID para mejorar el DT que sea mas realista, no estoy logrando hacer girar los motores en la direccion correcta para hacer funcionar el PID, ademas, agregue datos del LOG en CSV com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
    [main.c]
2026-02-24 Soluciono el problema relacionado con el voltaje residual en el peunte H, corregi el sentido del PID correctamente, me falta comprender todos los valores del mismo y su funcionamiento correctamente, 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
    [ESP01.c, main.c]
2026-02-24 Implement lightweight binary WiFi logging
    - Add `WifiLogData_t` struct (packed, 28 bytes) for efficient UDP transmission.
    - Implement `UNER_SendWifiLogData` to send binary telemetry.
    - Add `ACTIVATE_WIFI_LOG` (0xBA) command to toggle WiFi logging.
    - Update `main.c` to send WiFi logs at 50Hz (20ms) when enabled.
    - Add `WIFI_LOG_GUIDE.txt` documenting the protocol and Qt integration.
    - Ensure logging checks `ESP01_IsSending()` to prevent connection instability.
    [UNER.c, UNER.h, main.c]
2026-02-24 Resuelvo los problemas de tranmision del log binario mediante UNER, ahora cuando envio se traba, no se si es my pesado o que, estoy por arreglarlo.
    [UNER.c, main.c]
2026-02-25 Fix WiFi freeze by implementing burst TX and move PID to 10ms loop
    - Moved PID control logic (MPU read + motor control) from `is2ms` (500Hz) to `is10ms` (100Hz) block in `Core/Src/main.c` as requested.
    - Adjusted `dt` calculation initialization and limits for the 10ms loop.
    - Implemented burst transmission in `Core/Src/ESP01.c` (`ESP01SENDData`) with a limit of 32 bytes per call to prevent buffer overflows during high-throughput logging.
    - This resolves the issue where enabling WiFi logging caused the connection to freeze.
    [ESP01.c, main.c]
2026-02-25 Fix WiFi freeze by implementing burst TX and move PID to 10ms loop
    - Implemented burst transmission in `Core/Src/ESP01.c` (`ESP01SENDData`) with a limit of 8 bytes per call to prevent buffer overflows during high-throughput logging while maintaining responsiveness for `SEND OK` prompts.
    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
    [ESP01.c]
2026-02-25 Fix WiFi hang by using correct flow control for AT+CIPSEND
    - Reduced `ESP01_BURST_LIMIT` to 8 in `Core/Src/ESP01.c` to improve response responsiveness.
    - Changed `AT+CIPSEND` termination from `\r\n` to `\r>` in `ESP01_Send`. This utilizes the internal mechanism in `ESP01SENDData` that maps `>` to `\n` on the wire but triggers a pause (`WAITINGSYMBOL`) to wait for the ESP01 prompt. This flow control is critical when using burst transmission to avoid overrunning the ESP01.
    - PID logic remains in 10ms loop as per previous commit.
    [ESP01.c]
2026-02-25 No conceta a wifi, aumente el tamano de envio de datos mediante wifi a 8 bytes/s.
2026-02-26 Agrego montones de funciones, corrijo wifi, corrijo valores de PID, logro balancear mas o menos el autito, falta tunear bien los vfalores de K del PID y los filtros aplicados al giroscopio y acelerom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
2026-02-26 Optimize MPU6050, Display, Logging and Enhance WiFi Robustness
    - **MPU6050**: Implemented single-burst DMA read (14 bytes) to reduce I2C overhead.
    - **Display**: Throttled OLED refresh rate to 20Hz (50ms) to save CPU cycles.
    - **Logging**: Replaced `snprintf` with custom fast integer-to-string conversion functions in the main loop to improve performance.
    - **WiFi**: Added a connection watchdog in `ESP01.c` that resets the module if it fails to connect within 20 seconds.
    [ESP01.c, MPU6050.c, MPU6050.h, main.c]
2026-03-06 Agrego el control de posicion, me falta enviar bien los datos en ambos log para revisar que todo funcoine bien y poder chequear que el setpoint este funcoinando correctamente.
    [UNER.c, UNER.h, main.c]
2026-03-06 Arreglo el control de posicion de manera casi perfecta, esta funcionando bastante bien, anda todo perfecto, estoy por agregar el seguidor de linea ahora.
    [UNER.c, main.c]
2026-03-06 Add line-following PID controller with remote tuning
    - Implemented line-following logic in `main.c` utilizing the first 4 ADC floor sensors (`adcValues[0]` to `adcValues[3]`).
    - Calculated a weighted positional error, assigning highest weight to the outermost sensors, filtered against a configurable `LINE_THRESHOLD`.
    - Implemented a dedicated PID controller for line error to generate `steering_adjustment`, capped at ±30.0f to ensure the balance PID retains primary authority.
    - Retained previous error state if the line is temporarily lost.
    - Added base forward inclination injection via `LINE_SPEED` to `dynamic_setpoint`.
    - Extended the UNER protocol in `UNER.h` and `UNER.c` with new commands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
    [UNER.c, UNER.h, main.c]
2026-03-11 Sigo ampliando el codigo de seguidor de linea, el balance anda perfecto, pero el seguidor de linea le falta refinas, recien agregue el angulo variable segun error, tengo qeu seguir analizando todo ap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
    [UNER.c, main.c]
2026-03-11 feat: improve line loss logic with smooth steering recovery
    - Added `last_line_dir` to track the last known valid direction of the line.
    - Defined `LINE_LOST_STEERING` (12.0f) for a moderate steering attempt during line loss.
    - Modified `LINE_STATE_LOST` to smoothly recover the line applying an EMA filter towards the remembered direction without abrupt steering decays.
    - Modified `LINE_STATE_SEARCHING` to maintain a smooth continuous steering towards `last_line_dir` rather than abruptly fixing the motor velocities, preserving the car's balance.
    [main.c]
2026-03-17 Mejoro sistema de linea perdida, todavia no funciona ni para adelante ni para atras, estoy por poner el envio de datos para ver como reacciona el pid del seguidor de linea.
2026-03-17 feat: Expand WiFi telemetry packet with line follower PID data
    - Added line_error, p_line, i_line, d_line, steering_adjustment, and 4 raw ADC values to WifiLogData_t.
    - Populated the new fields in the 100Hz control loop within main.c to be transmitted via UDP.
    - Adjusted payload calculation dynamically in UNER_SendWifiLogData (payloadLen + 1).
    - Updated WIFI_LOG_GUIDE.txt with the new 64-byte payload structure for Qt receiving.
2026-03-17 Estoy por mejorar el desempeno del dt, ya que actualmente fluctua demasiado.
2026-04-01 Mejoro el funcionamiento del balancin, anda muy bien, todavia no puedo hacer andar el seguidor de linea correctamente, no logro hacerlo andar en sincronia con el balancin, se cae mucho o no sigue lin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
    [main.c]
2026-04-01 Voy a sacar la mantencion de posicion poruqe me interrumpe el balancin, lo voy a separar del pid del balancin.
2026-04-01 feat: add position maintenance toggle and smooth braking limits
    - Added `ACTIVATE_POS_MAINTENANCE` (0xC6) UNER command.
    - Disabled position maintenance by default (`f_pos_maintenance = 0`).
    - Updated `UNER_RegisterFlags` to link the new flag to protocol execution.
    - Lowered `KV_BRAKE` to 0.10f and `VEL_LPF_BETA` to 0.05f for smoother velocity estimation.
    - Clamped braking `dynamic_setpoint` influence to ±3.0f to prevent abrupt falls.
    - Adjusted dynamic setpoint transition rate (`sp_step_max = 0.002f`) when braking to improve reaction time smoothly.
    [UNER.c, UNER.h, main.c, test_framework.h]
2026-04-04 Restauro el estado de V3
2026-04-04 Refactor robot modes into an explicit state machine
    - Added `eRobotState` enum (`IDLE`, `BALANCE_ONLY`, `BALANCE_AND_SPEED`, `LINE_FOLLOWING`) to `main.c`.
    - Replaced standalone boolean flags (`f_balancing`, `f_line_following`) with a single `robot_state` variable.
    - Added `ACTIVATE_POS_MAINTENANCE` (0xC6) command to UNER protocol to toggle velocity/speed control.
    - Updated UNER protocol decoding to properly manage mode transitions via the state machine.
    - Tied dynamic setpoint generation and velocity estimation exclusively to `ROBOT_STATE_BALANCE_AND_SPEED`.
    - Maintained strict adherence to not modifying `ESP01.c` / `ESP01.h`.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
    [UNER.c, UNER.h, main.c]
2026-04-04 Agrego maquina de estados para el sistema de pid balancin.
2026-04-04 Agrego el boton integrado de la placa para manejar modos y display, funciona todo bien, falta afinar PID y giro.
2026-04-04 Saco controles de integrales en el modo balancin sin control, funciona mejor, falta implementar control para que no tome demasiado envion.
2026-04-05 Mejoro el balancin, funciona mucho mejor sin control, ahora esta funcionando todo perfecto, queda bien, falta hacer andas seguidor de linea.
2026-04-05 Add manual directional control via UNER protocol
    - Adds a new state `ROBOT_STATE_MANUAL_CONTROL` to `main.c`.
    - Adds UNER commands `ACTIVATE_MANUAL_CONTROL`, `MANUAL_FORWARD`, `MANUAL_BACKWARD`, `MANUAL_LEFT`, `MANUAL_RIGHT`, and `MANUAL_STOP` to `UNER.h` and implements their parsing in `UNER.c`.
    - In manual control mode, forward/backward adjust the dynamic setpoint by +/- 1 degree, and left/right commands adjust motor steering by +/- 20 PWM.
    - The mode acts via a 500ms timeout mechanism: commands must be sent continuously; if communication is lost or commands stop, the robot automatically zeroes out the manual setpoint and steering, bringing it back to a balance-in-place state.
    - Adds manua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
2026-04-06 Mejoro el control del pid en todos los estados, falta aumentar angulo de ataque en modo manual para que avance, va lindo.
2026-04-06 Mejoro balance y modo manual, falta seguir con el line follower.
2026-04-06 Optimize MPU6050 calibration and remove deadzones for better precision
    - Modified `MPU6050_Calibrate` to read 14 bytes (Accel+Temp+Gyro) in a single I2C burst transaction instead of multiple calls.
    - Reduced the inter-sample delay during calibration from 5ms to 1ms to significantly speed up the startup process.
    - Removed the deadzone logic (filtering out `OFFSET_AX`, `OFFSET_GX`, etc. around zero) in `MPU6050_ProcessDMA` to allow the PID controller to read high-resolution continuous errors near 0 degrees.
    - Cleaned up unused `OFFSET_*` macros in `MPU6050.h`.
    [MPU6050.c, MPU6050.h]
2026-04-06 Improve PID integral stability around 0 degrees
    - Added an integral deadzone of 0.2 degrees in `main.c` so the integral term doesn't accumulate small sensor noise around perfectly balanced states.
    - Re-enabled integral calculation in `ROBOT_STATE_BALANCE_ONLY` mode but bounded by the new deadzone rule.
    - Added integral decay (`integral *= 0.95f`) when the error is inside the deadzone to bleed off built-up energy and stop jittering.
    [main.c]
2026-04-06 Mejoro capacidad de lectura del mpu6050, ahora esta mucho mas sensible y se calibra mucho mas rapido.
2026-04-07 Mejoro el manejo de transiciones en modo manual, al ir hacia adelante o atras, todavia no gira, va queriendon de a poco, no toque seguidor de linea.
2026-04-07 Estoy por arreglar el log csv por wifi por el cambio que hice en el mpu y ademas corregir el DT para que sea mas constante y no me haga que se dispare el robot.
    [UNER.c, main.c]
2026-04-08 Funciona mas o menos el balancin, no me esta gustando el ehcho de que se vuelve loco debito al DT inconsistente.
2026-04-08 Intento seguir con el seguidor de linea, no me gusta como esta, pega un golpe cuando va avanzando por culpa del pid de balance, no se estan llevando bien, falta mejorar.
2026-04-13 Estoy por subir el lazo de control, de 2ms a 10 ms para el pid.
2026-04-14 chore(control): update control loop timing from 2ms to 10ms
    Changes include:
    - Rename `ControlStep2ms` to `ControlStep10ms`.
    - Move the invocation of `ControlStep10ms()` from inside the `while (tick2ms_count)` block to inside the `if(is10ms)` block.
    - Update `DT` constant from `0.002f` to `0.010f`.
    - Scale `DT_MIN` to `0.005f` and `DT_MAX` to `0.05f` to reflect the new expected bounds.
    - Update the initialization fallback for `last_ctrl_us` from `- 2000` to `- 10000`.
    - The TIM5 (2ms timer) remains active as requested but no longer drives the PID loop.
    [main.c]
2026-04-14 Estoy por terminar de dejar el loop del pid cada 10 ms para no tener mas problemas con dt, yha puse el filtro EMA de la mpu6050 en el gyro y accelerometro, falta hacer algun cambio para que la mpu605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
    [ESP01.c, MPU6050.c, MPU6050.h, UNER.c, UNER.h, main.c]
2026-04-14 Fix I2C collision by gating SSD1306 update and balancing scheduler
    - Gated `SSD1306_UpdateScreen()` with `!i2c1_tx_busy` to prevent blocking MPU6050 DMA reads.
    - Changed subtick counter from modulo 4 to 10 to reduce OLED refresh rate to 100ms.
    - Restructured `switch(subtick)` cases to evenly distribute load, moving LED toggling to case 4.
    - Added `MPU6050_StartRead_DMA()` after blocking `MPU6050_Calibrate()` call.
    - Extracted button polling logic out of `switch(subtick)` to guarantee it runs exactly every 10ms.
    [main.c]
2026-04-15 Estoy por agregar un organizador de I2C, ya que no funcionan bien las banderas para organizar el display y el mpu.
2026-04-15 Pude hacer el manager de i2c, anda todo pero tengo que ver si los valores de la mpu y la mpu esta bien calibrada y funcoinando correctamente con el pid.
    [Balancin_Mendelevich.ioc, i2c_manager.c, i2c_manager.h, main.c, main.h]
2026-04-16 Funciona bien el sistema de manager de i2c, necesito que el dt sea fijo ahora, estoy por implementar la coordinacion de datos del mpu con el pid.
2026-04-16 Solucione el problema del DT y ahora es constante, funciona bien el balance, agregue un sistema de zona muerta que ayuda mucho a al estabilidad del auto en el punto ducle de equilibrio.
    [MPU6050.c, main.c]
2026-04-17 Soluciono errores, agrego setpoint para correccion de angulo y mejoro las pantallas display, falta dejar andando el seguidor de linea que no funcoina correctamente.
    [UNER.c, UNER.h, main.c]
2026-04-20 Funciona todo bien en el sistema pero me falta mejorar la respuesta del pid ante perturbaciones grandes.
2026-04-20 Ajusto valores de freno de posicion para modo BALANCE_ONLY, quedo funcionando perfecto, ahora voy a corregir los demas modos.
2026-04-20 Mejoro valores y funciones del seguidor de linea, va bastante bien, tengo que corregir la aceleracion excesiva para que pueda seguir leyendo la linea correctamente.
    [main.c]
2026-04-21 Mejoro reacciones del KV_BRAKE, cambiando el setpoint cuando recibo una perturbacion, usando solamente acelerometro para medir la velocidad a la que se mueve el balancin y poder actuar de manera mas 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
2026-04-22 Mejoro KV_BRAKE: freno fuerte por encima del umbral de velocidad, corrige perturbaciones sin introducir ruido en velocidades bajas
    [ESP01.c, main.c]
2026-04-23 Mejoro estabilidad en punto de equilibrio y respuesta ante perturbaciones
    - Reimplemento zona de hold con histéresis en el PID de balance: silencia P y D
    cuando |error| <= 0.4° y |gyro| <= 4 dps, sale del hold cuando |error| >= 0.9°
    o |gyro| >= 10 dps. Evita oscilaciones en el punto dulce sin sacrificar respuesta.
    - Zona suave de transición gradual entre el hold y el PID completo (0.4° a 1.5°).
    - KV_brake_value (UNER) ahora configura KV_BRAKE_STRONG, el freno fuerte que actúa
    por encima del umbral de velocidad.
    - Agrego pantalla 5 en el display: valores MPU (giroscopio y acelerómetro) + estado WiFi.
    - Corrijo conexión WiFi: el módulo ESP01 avanzaba a CIFSR apenas recibía el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
    [ESP01.c, main.c]
2026-04-24 Avances en seguidor de línea, seguimos desarrollando
    - Soft zone y hold zone del PID aplicados a todos los modos
    - Decaimiento de velocidad en recta larga (line_speed_scale)
    - Modo SEARCH solo mantiene equilibrio, sin steering agresivo
    - Error de línea visible en pantalla 1
    [ESP01.c, UNER.c, main.c]
2026-04-28 Elimino calibración de MPU al inicio: bias hardcodeado para arranque instantáneo
    - Agrego MPU6050_GetBias() y MPU6050_SetBias() para leer y cargar bias sin calibrar
    - Agrego mecanismo MPU_USE_FIXED_BIAS en main.c: con los valores medidos una sola vez
    (ax=-46, ay=4800, az=1980, gx=-441, gy=-107, gz=-54) el robot arranca sin calibración,
    en cualquier posición, sin necesidad de sostenerlo quieto ni en balance
    - El filtro complementario se inicializa desde el acelerómetro en la primera muestra,
    eliminando la convergencia lenta desde 0° que impedía encontrar el setpoint al inicio
    - Sistema validado: arranca instantáneo, balancea correctamente sin intervención del usuario
    Co-Author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
    [ESP01.c, MPU6050.c, MPU6050.h, main.c]
2026-04-28 Ajustes de tuneo: KV_BRAKE, zona suave PID y seguidor de línea
    - Reduce KV_BRAKE_STRONG a 3.0 y VEL_LPF_BETA a 0.15 para eliminar patadas
    bruscas del freno por velocidad estimada ruidosa
    - BRAKE_TILT_STEP_BAL a 0.05 para rampa suave del setpoint de freno
    - BRAKE_TILT_MAX a 1.0 para limitar el desplazamiento máximo del setpoint
    - LINE_DECAY_MIN_SCALE a 0.3: el seguidor de línea mantiene al menos 30%
    del ángulo de avance cuando sigue perfectamente la línea (evita que frene
    hasta detenerse y luego no pueda retomar velocidad)
    - Recepción USB de comandos UNER desactivada para no corromper el parser WiFi
    TODO: falta mejorar el gráfico 3D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
2026-04-28 Revert "Ajustes de tuneo: KV_BRAKE, zona suave PID y seguidor de línea"
    This reverts commit 307c397fb8f0fc4fb09695f71951d730ea51acfb.
    [main.c]
2026-05-07 Agrego CLAUDE.md y configuración .claude para memoria del proyecto
2026-05-07 Agrego lectura de encoders y steering PID de lazo cerrado
2026-05-08 Encoders 4x quadrature, fix EXTI handlers y freno por velocidad
    - Motor izquierdo y velocidad encoder: signo corregido
    - EXTI handlers: limpieza de todos los flags del grupo (fix HardFault)
    - Masking anti-storm en encoder: 500 Hz max por canal via TIM5
    - 4x quadrature: PB13/PB15 como EXTI, ENC_CPR=24
    - KV_BRAKE_STRONG=5.0, ajustable en runtime desde Qt (slider KV)
    [main.c]
2026-05-08 Seguidor de línea: velocity PI + steering en lazo cerrado con encoders
    Tres mejoras integradas (aún sin probar en el robot físico):
    1. PI de velocidad externo: reemplaza el hack de line_speed_scale y
    KV_LINE_BRAKE. desired_vel = 0.8 m/s × speed_factor cuadrático.
    El PI regula la inclinación del péndulo para alcanzar esa velocidad.
    2. Steering en lazo cerrado: el PID de línea (KP/KD/KI_LINE) produce
    un setpoint diferencial en rps que se cierra con (speed_r - speed_l)
    medido por encoders, vía un inner PI (LINE_STEER_FB_KP/KI).
    Corrige asimetría de motores automáticamente.
    3. Reducción cuadrática de velocidad por error de línea: frenada
    agresiva al entrar en c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
    [main.c]
2026-05-09 Seguidor de línea: fixes de velocidad, steering, freeze y sensores
    - Usa adcAvg en lugar de adcValues para sensores de línea
    - LINE_THRESHOLD 3000→2500, LINE_ANGLE 0.5→1.5 grados
    - Steering directo sin inner PI de encoders
    - Setpoint en modo línea simplificado (sin setpoint_trim)
    - Límite dinámico de pwm_sat en curvas según line_error
    - Sin línea por 2s: balance con freno de posición, sin giro
    - IWDG watchdog + I2C bus recovery al arranque
    - HardFault → NVIC_SystemReset, TIM5 prio 0→6
    - EXTI15_10: encoders solo si no están enmascarados
    - MOTOR_LEFT_DEADBAND para compensar zona muerta del motor izq
    [main.c]
2026-05-10 Seguidor de línea: balance en LOST, vel_scale, display y fixes
    - Balance en LOST/SEARCHING = BALANCE_ONLY: integral ±8, pwm ±50,
    setpoint_trim libre, freno de posición, corrección giroscópica Z
    - vel_scale solo frena en avance; en reversa aplica ángulo completo
    - Display 1 auto-switch al entrar en LINE_FOLLOWING y restaura al salir
    - VE (velocidad) reemplaza LE en display 1
    - KP_LINE 15→8, sp_step_max 5°→0.75°
    - MOTOR_LEFT_DEADBAND para compensar zona muerta motor izq
    - Eliminado límite de reversa (demasiado estricto)
    [main.c]
2026-05-18 Seguidor de línea V9: ganancia de ángulo agresiva por encoders y fixes de setpoint
    Problemas resueltos en esta versión:
    - Robot no ganaba ángulo al ver la línea (se quedaba balanceando en el lugar)
    - Al ganar ángulo lo perdía inmediatamente por corrección del balancín
    - En algunos puntos de la línea se quedaba parado y le costaba retomar velocidad
    Cambios principales:
    1. Balance hold deshabilitado con línea visible (main.c ~2198, ~2577)
    - El hold silenciaba el PID ~80ms al arrancar: error < 0.5° mientras el
    setpoint rampeaba desde 0°, impidiendo la inclinación inicial de avance.
    - Ahora: hold = 0 en la transición a LINE y forzado a 0 cada ciclo con
    line_detec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
    [main.c]
2026-05-18 Fix: eliminar anti-windup erróneo del PI de velocidad del seguidor de línea
    El anti-windup impedía acumular integral desde el primer ciclo:
    raw_vel_cmd = 2.5 * 1.2 = 3.0 >= LINE_ANGLE=2.8 → condición siempre activa
    → line_vel_integral se quedaba en 0 siempre
    → sin término I, al ganar velocidad el término P caía a 0 → robot perdía ángulo → paraba
    Vuelta a integración simple con clamp ±LINE_VEL_I_MAX.
    [main.c]
2026-05-18 Seguidor de línea: mejora masiva de velocidad y frenado con encoders
    Problemas resueltos:
    - Robot no ganaba ángulo al ver la línea (balance hold lo bloqueaba 80ms)
    - Pasaba por encima de la línea sin detectarla (delay 7.5ms del filtro ADC)
    - Aceleraba sin límite y perdía la línea en curvas (vel_scale era 1.0 fijo)
    - Frenaba demasiado fuerte y oscilaba acelera/frena indefinidamente
    - Integral negativo atrapado causaba retroceso permanente
    - ADC_AVERAGE_SIZE 15→4: retraso de detección 7.5ms→0.5ms, robot detecta la línea a tiempo
    - Frenado activo por encoders: line_angle_cmd permite hasta -1.5° cuando supera target
    - vel_scale corta avance al 90% del target (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
    [main.c]
2026-05-18 CLAUDE.md: registro de cambios de sesión 2026-05-18
2026-05-19 Seguidor de línea: detección de objetos, evasión y mejoras de estabilidad
    - Detección de objetos con ADC 5-8 (< 2000): giro 90° derecha por encoders
    (OBJ_ROTATE) y hold estático post-giro (OBJ_HOLD = BALANCE_ONLY)
    - OBJ_HOLD sale al caer y retoma LINE_FOLLOWING al recuperarse
    - Ventana de 4s ignorando objeto al activar modo línea por botón
    - Pantalla 1: 8 barras ADC (línea + objeto) con separador punteado
    - Pantalla 4: grid 4×2 con los 8 canales ADC numéricos
    - Watchdog I2C/MPU: recovery automático si DMA cuelga >150ms
    - Mejoras display pantalla 1: panel derecho desplazado a x=73
2026-05-19 Evasion de objetos: reversa + freno + giro 180° (en progreso)
    Se avanza bien en la secuencia de evasion de obstaculos pero aun
    no esta completa ni calibrada. Cambios realizados:
    - Nuevo estado LINE_STATE_OBJ_REVERSE: retrocede 300 counts sobre
    la linea (steering invertido x0.3) antes de girar
    - Nuevo estado LINE_STATE_OBJ_BRAKE: frena con ComputeBrakeSetpoint
    hasta velocity_est_f < 0.05 m/s para eliminar inercia residual
    antes del giro; timeout de seguridad 1500 ms
    - LINE_STATE_OBJ_ROTATE: target_counts empirico (325), PIVOT_POWER
    reducido a 15 para giro mas suave, timeout ampliado a 8000 ms
    - Fix critico: variables de sesion OBJ_ROTATE promovidas a scope de
    archivo (obj_rot_*) p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
    [main.c]
2026-05-19 Seguidor de linea: centroide cuadratico y ajustes de freno
    - Centroide cuadratico con sustraccion de baseline: coeficientes
    {+9,+1,-1,-9}/(9*w_sum), sensores a +-5.75mm y +-17.25mm del
    centro (espaciado fisico 11.5mm). Relacion extremo/centro pasa
    de 3:1 a 9:1 para respuesta mas agresiva al perder la linea.
    - ADC_BASELINE[4] agregado para sustraccion de offset por sensor.
    Completar con valores medidos sobre piso blanco (pantalla 4 OLED).
    - Umbral last_line_dir ajustado 0.05 -> 0.02 por menor contribucion
    de sensores internos en el esquema cuadratico.
    - Freno maximo en curva reducido: -1.5 -> -0.8 grados para que
    el robot no frene tan fuerte al girar.
    - Deteccion de objetos deshab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
2026-05-19 Seguidor de linea: reduccion del freno excesivo al arrancar
    - LINE_VEL_KP reducido 5.5 -> 3.0: freno proporcional menos brusco
    cuando supera la velocidad objetivo.
    - Decay del integral de velocidad acelerado: 0.95 -> 0.80 por ciclo
    (100 Hz), el integral drena en ~100 ms en lugar de ~500 ms.
    Esto evita que el freno se mantenga durante casi un segundo despues
    de que la velocidad ya volvio al rango deseado.
    - Freno maximo ajustado a -1.0 grados.
2026-05-27 Evasion de objetos: arco por encoders, sin reversa, umbral ADC 3200
    - LINE_STATE_OBJ_ARC: avance en arco con PI cerrado sobre diferencial
    de encoders (OBJ_ARC_DIFF_TARGET=0.5 rps, positivo=izquierda).
    Ganancias OBJ_ARC_KP=15, OBJ_ARC_KI=3, saturacion +-30, anti-windup.
    - OBJ_HOLD: timer 2s antes de pasar a OBJ_ARC (antes era indefinido).
    - OBJ_REVERSE y OBJ_BRAKE deshabilitados: PRE_REVERSE_HOLD transiciona
    directo a OBJ_ROTATE. Cadena: WAIT(2s) -> ROTATE -> HOLD(2s) -> ARC.
    - Bugs de stale-state corregidos en toda la maquina de evasion:
    obj_rev_initialized, obj_brake_start_ms, obj_rot_initialized,
    obj_rot_start_ms, line_error_f_d, line_obj_rev_vel_integral.
    - KV_brake_value ahora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
    [main.c]
2026-05-27 Evasion: wait 1s, reversa 10 pulsos, wait 1s post-freno, deteccion ADC7
    - OBJ_PRE_REVERSE_HOLD re-habilitado con timeout 1s (antes 2s).
    - rev_target_counts: 150 -> 10 pulsos de reversa.
    - OBJ_BRAKE ahora tiene dos fases: espera velocity < 0.05 m/s,
    luego wait adicional de 1s antes de entrar a OBJ_ROTATE.
    Variable obj_pre_rotate_ms file-scope, reseteada en caida.
    - OBJ_ROTATE: sale antes si adcAvg[6] < 3200 (ADC7 ve objeto de lado).
    - Cadena: WAIT(1s) -> REVERSE(10) -> BRAKE(quieto+1s) -> ROTATE -> HOLD(2s) -> ARC.
    [main.c]
2026-05-27 Wall-following: fix no-advance, increase pivot power, add too-close detection
    - OBJ_WALL_FWD: replace velocity PI with fixed 5.5° angle setpoint (PI was root
    cause of robot staying stopped — integral never built enough to overcome inertia)
    - OBJ_WALL_PIVOT_POWER: 5 → 20 (5 PWM was below effective motor threshold)
    - Add too-close detection: ADC7 < 300 → pivot right in both WALL_FWD and WALL_TURN
    - Add explicit steering_adjustment=0 when advancing in WALL_FWD
    - Reset obj_wall_vel_int on OBJ_HOLD→WALL_FWD transition
    [main.c]
2026-05-27 Wall-following: pivot power 8, ignore line 3s on entry to WALL_FWD
    - OBJ_WALL_PIVOT_POWER: 20 → 8 (20 was too aggressive)
    - Add OBJ_WALL_LINE_IGNORE_MS=3000: line detection suppressed for 3s
    when entering WALL_FWD, preventing immediate return to FOLLOWING
    when the robot crosses the original line during wall bypass
    - obj_wall_fwd_start_ms: new file-scope timer, set on HOLD→WALL_FWD
    and WALL_TURN→WALL_FWD, reset on exit; also reset on fall
    [main.c]
2026-05-28 Wall-following: max angle 2.5deg, restore PI velocity control
    - OBJ_WALL_FWD_ANGLE: 5.5 -> 2.5 deg
    - Restore PI velocity controller on WALL_FWD setpoint:
    target 0.25 m/s, KP=8, KI=2, I_MAX=1.5
    floor OBJ_WALL_MIN_ANGLE=0.5 deg so robot always starts moving
    integral decays at 0.85x/cycle when overshooting
    [main.c]
2026-05-28 Wall-following: add WALL_APPROACH state before WALL_FWD
    New state LINE_STATE_OBJ_WALL_APPROACH (display: WF_APR):
    - Entered from OBJ_HOLD instead of going directly to WALL_FWD
    - Advances slowly at OBJ_WALL_APPROACH_ANGLE=2.0 deg until ADC7 < 3750
    - On wall detected: transitions to WALL_FWD with timers initialized
    - Timeout 6s: returns to FOLLOWING if wall never found
    - balance_hold_active force-disabled during approach
2026-06-02 ADC6/8: 144-cycle sampling + fix CubeMX regen bugs
    - ADC CH6 y CH8 a ADC_SAMPLETIME_144CYCLES para mayor rango de deteccion
    - Fix: CubeMX reseteo prioridades DMA1/DMA2/EXTI15_10 a 0; corregido en USER CODE BEGIN 2
    - Fix: CubeMX borro EXTI9_5_IRQHandler y mutilo EXTI15_10_IRQHandler; restaurados en stm32f4xx_it.c
    [Balancin_Mendelevich.ioc, main.c]
2026-06-02 ADC: extend 144-cycle sampling to CH5 and CH7 (all object sensors)
    ADC CH5-CH8 (adcAvg[4..7]) now all use ADC_SAMPLETIME_144CYCLES for
    improved sensitivity and detection range on all object sensors.
2026-06-02 Line: ignore obstacles 3s when robot placed on floor
    Detect transition from all-4-sensors-black (robot held in air) to any
    other state (robot placed down). On that edge, extend obj_detect_ignore
    window by 3s so the hand releasing the robot never triggers evasion.
2026-06-02 Manual: add precision rotation commands via UNER protocol
    5 new UNER commands (0xD5-0xD9): ROTATE_90/180_RIGHT/LEFT and
    ROTATE_CUSTOM (float payload in degrees). Uses gyro gz integration
    at 100 Hz as primary sensor. Power ramps down over last 15 deg for
    precision. Dynamic timeout proportional to target angle.
2026-06-02 Manual: auto 90° rotation every 5s + precise rotation fix
    - Auto-rotate 90° right every 5s in MANUAL mode (manual_auto_rot_last_ms)
    - Two-phase rotation: forward pivot (phase 0) → active counter-brake (phase 1)
    - MANUAL_ROT_PIVOT_POWER 12→15, BRAKE_POWER 5→15, slowdown zone 15→35°
    - Transition to braking at 60% of target angle; exit when gz<15dps and heading≤target+3°
    - Reset manual state (cmd/steering/ramped) on rotation end to prevent post-spin drift
    - Balance parity with BALANCE_ONLY: pwm_limit 55→100, BRAKE_TILT_STEP_MAN 0.3→0.5
    [main.c]
2026-06-02 Manual: fix post-rotation drift with immediate brake injection
    Reset integral and inject ComputeBrakeSetpointTarget directly into
    brake_setpoint_f on rotation end, bypassing the ramp to instantly
    counter translational velocity accumulated during pivot.
    [main.c]
2026-06-02 Manual: rotation cycle 90R → 90L → 180R every 2.5s
    Replace single 90° right repeat with 3-step sequencer:
    step 0 = +90°, step 1 = -90°, step 2 = +180°, repeating.
    Interval between rotations: 2500ms. Step resets to 0 on
    entering MANUAL mode.
    [main.c]
2026-06-02 Manual: fix 180° rotation getting stuck in brake phase
    Phase 2 exit condition was checking abs_heading <= target+3° which
    was never met for 180° (too much inertia). Now exits purely on
    gz_dps < 12 (rotation stopped). Also moved brake transition from
    62% to 55% for more braking room on large angles.
    [main.c]
2026-06-25 Manual: fix left rotation overshoot and balance during brake phase
    Two independent fixes:
    - Left turn did 370°+ because gz≈0 made phase 0 run the full 1000ms
    fallback and phase 1 exit immediately (gz<12 fired on iteration 1,
    0ms of actual braking). Fix: phase0_max_ms reduced 1000→600ms;
    gz<12 in phase 1 now requires 300ms minimum before it can exit.
    - After right turn the robot collapsed because phase 1 used fixed
    ±dir×BRAKE motor commands (ignoring pwm_sat), leaving the balance
    PID with no effect for 500ms. Fix: phase 1 now uses
    -(pwm_sat ∓ dir×BRAKE), keeping a constant 2×BRAKE differential
    for counter-rotation while pwm_sat maintains balance.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
    [main.c]
2026-06-25 Manual: fix auto-rotation sequence timing (2.5s pause from turn END)
    Replace manual_auto_rot_last_ms (elapsed-since-last-trigger) with
    manual_seq_next_ms (absolute deadline). The 2.5s pause is now set as
    HAL_GetTick()+2500 precisely when a rotation finishes (both in normal
    phase-1 exit and timeout), so the pause is always measured from the
    end of the rotation, never from when the trigger fired.
    On entering MANUAL_CONTROL the deadline is set to +2500 to give an
    initial pause before the first rotation.
    [main.c]
2026-06-25 Manual: fix double-rotation bug in auto sequence
    Use manual_seq_next_ms=0 as "disarmed" sentinel while rotation is
    active. Auto trigger only fires when seq_next != 0 AND deadline
    has passed. On trigger: seq_next=0 (disarm). On rotation end:
    seq_next=HAL_GetTick()+2500 (re-arm with 2.5s pause).
    Previously the +10000 fallback value still allowed the check to
    evaluate to true in the window between trigger firing and
    manual_rot_active being set to 1, causing two rotations per cycle.
    [main.c]
2026-06-25 Manual: fix 'va y vuelve' — reduce brake power/duration in phase 1
    MANUAL_ROT_BRAKE_POWER 15→5, phase0_max_ms 600→400ms,
    phase1_max_ms 500→250ms, gz_settled min 300→120ms.
    Root cause: 15 PWM counter-rotation for 500ms accumulated enough
    reverse momentum to fully unwind the turn, making the robot
    return to its original heading (appearing as a second turn).
    With gentler braking the robot decelerates and stays at the
    new heading.
    [main.c]
2026-06-25 Manual: increase phase0_max_ms 400→500ms to reach closer to 90°
2026-06-25 Manual: add encoder feedback for rotation heading
    Compute enc_heading_deg = avg(|dr|+|dl|)/2 * (90/325) alongside
    gz-based heading. Use max(gz, enc) as composite heading for:
    - Phase 0->1 transition (55% threshold): works for both L/R turns
    - Slowdown ramp: abs_remaining uses composite heading
    - Phase 1 early exit: enc_reached when enc >= 95% of target after 60ms
    Previously left turns had no angular feedback (gz≈0 CCW) so phase 0
    ran the full 500ms time fallback regardless of actual angle reached.
    Encoders give symmetric precision for both rotation directions.
2026-06-25 CLAUDE.md: document encoder feedback for MANUAL rotation
2026-06-25 Manual: fix scope error — recompute enc heading in motor section
    abs_target/abs_heading declared in state-machine if-block were
    out of scope in the separate motor-control if-block. Recompute
    encoder heading locally in the motor section for the slowdown calc.
    [main.c]
2026-06-25 Manual: increase phase0 threshold 55->80% and max time 500->1000ms
    Encoder-based heading exits phase 0 too early (325 counts/90°
    calibration doesn't match PIVOT_POWER=15 mechanical reality).
    Higher threshold and longer fallback give the robot more spin
    time before braking.
    [main.c]
2026-06-25 Manual: encoder calibration 380 counts/90°, add 180° to auto cycle
    - MANUAL_ROT_ENC_TARGET calibrated to 380 (empirical)
    - Auto sequence: 90°R → 90°L → 180°R → repeat (3 steps, % 3)
    - Phase 0/1 timing scales proportionally with abs_target/90
2026-06-25 Manual: fix 180° overshoot with angle-dependent phase0 exit fraction
    enc_exit_frac = 0.85 - max(0, (angle-90)/90) * 0.15
    90° -> 0.85 (unchanged), 180° -> 0.70 (enters brake phase earlier).
    Reduces angular momentum at phase1 entry for larger rotation angles.
    [main.c]
2026-06-26 Line: LOST_ROTATE 180°, OBJ_ROTATE igual a MANUAL, reverse 200c, fault handlers reset
    - LINE_STATE_LOST_ROTATE (nuevo): cuando pierde línea y velocity<0.08m/s,
    giro 180° con lógica gz+encoder idéntica a MANUAL (PIVOT=15, ENC=760,
    SLOWDOWN=55°). Sale a FOLLOWING si detecta línea; si no, vuelve a LOST.
    - OBJ_ROTATE: parámetros igualados a MANUAL (PIVOT=15, ENC=380, BRAKE=5,
    SLOWDOWN=55°, P0_MAX=1200ms, clamp ±60). Agrega obj_rot_phase/heading/
    phase1_ms como variables de archivo y las resetea en todos los bloques.
    - OBJ_REVERSE: rev_target_counts 10→200 (~10 cm de retroceso).
    - OBJ_BRAKE: PRE_ROTATE_MS 1000→2000ms (pausa post-reversa más larga).
    - stm32f4xx_it.c: NVIC_Sy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
    [main.c]
2026-06-27 Line: LOST_FWD — avanza post-180° hasta encontrar la línea
    Después del giro LOST_ROTATE, en lugar de volver a LOST (que reactivaba
    el ciclo LOST→ROTATE inmediatamente), pasa a LOST_FWD: avanza a 2° hasta
    detectar la línea → FOLLOWING. Timeout 10s de seguridad → LOST.
    Display: "LFWD".
2026-06-27 Display: pantalla OBJ dedicada al esquive + sub-estado más grande en seguidor
    - Nueva pantalla 6: al entrar en cualquier estado OBJ_* se muestra
    automáticamente el estado en Font_7x10 centrado (WAIT/BRAKE/ROTATE/etc.)
    y barras verticales de ADC5 (objeto frontal) y ADC7 (pared lateral)
    con valor numérico. Al salir de OBJ vuelve a la pantalla del seguidor.
    - Pantalla 1 (seguidor): eliminado modo "LINE" del header superior,
    eliminada velocidad VE, sub-estado ahora en Font_7x10 centrado
    (era Font_5x7). Spinner reducido y bajado.
2026-06-27 OBJ detect: threshold 3200→2000, debounce 3→10 ciclos (100ms)
    Reduce falsos positivos: el objeto debe causar una caída de ADC
    más pronunciada y mantenerse 100ms antes de disparar la evasión.
2026-06-27 Fix: LOST_ROTATE disparaba inmediatamente al entrar a LOST
    Bug: line_lost_ms ya tenía 2000ms de antigüedad al entrar a LOST
    (condición de salida de FOLLOWING), por lo que >500U se cumplía al
    instante → robot giraba 180° sin dar tiempo a recuperar la línea.
    Fix: nueva variable line_lost_entered_ms seteada al entrar a LOST;
    condición cambiada a >3000U desde ese timer. El robot ahora espera
    3s quieto en LOST antes de disparar el giro de 180°.
    [main.c]
2026-06-27 Fix: spinning post-evasion, stale steering, OBJ re-detection + display improvements
    - Bug: robot giraba en círculos en FOLLOWING sin línea: balance_hold con
    steering_adjustment residual producía spin puro (pwm_sat≈0). Fix: limpiar
    steering_adjustment y line_integral inmediatamente al perder la línea.
    - Bug: robot "tonto" post-evasión: obj_cnt llegaba a 10 durante la secuencia
    OBJ y re-disparaba OBJ_PRE_REVERSE_HOLD al volver a FOLLOWING. Fix:
    obj_detect_ignore_until_ms +5s en todas las transiciones OBJ→FOLLOWING.
    - Display: indicador negro/blanco (relleno/borde) en la parte superior de
    cada barra ADC 1-4; barras reducidas 4px para que el indicador sea visible.
    Co-Authored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
    [main.c]
2026-06-27 Fix: speed in curves, 4x OBJ re-detection, balance_hold in LOST
    - Velocidad en curvas: eliminado floor 25%; desired_vel=0 en curva cerrada;
    brake_limit escala con speed_factor (0 en curva, -1° en recta).
    - obj_detect_ignore_until_ms +5s en: OBJ_HOLD f_fallen, WALL_APPROACH
    f_fallen, WALL_APPROACH timeout, LOST_ROTATE→FOLLOWING por line_detected.
    - balance_hold excluido en LINE_STATE_LOST y SEARCHING (motores no apagados
    ante perturbaciones leves cuando el robot busca la línea).
    [main.c]
2026-06-27 Fix: balance_hold exclusion + steering regression in line follower
    - balance_hold ahora excluido en TODO ROBOT_STATE_LINE_FOLLOWING (no solo
    cuando line_detected). Garantiza pwm_sat!=0 en todos los estados de línea.
    - Revertido el clear prematuro de steering_adjustment cuando !line_detected:
    el valor residual es necesario para que el robot corrija hacia la línea
    cuando los sensores pierden la cinta. Solo se limpia al entrar a LOST.
    - Root cause del spin original: hold + pwm_sat=0 + steering != 0. Con hold
    excluido siempre en LINE_FOLLOWING, el steering produce diferencial correcto.
    [main.c]
2026-06-27 Line follower: restore 25% speed floor + V10 balance_hold condition
    Root cause of "robot no sigue la linea":
    - Without 25% floor, speed_factor=0 in curves (|line_error|>=0.45)
    → line_angle_cmd=0 → base_setpoint=0° → pwm_sat→0 → pure spin
    Fixes:
    - Restore line_desired_forward_vel = max(0.25*LST, LST*speed_factor)
    - Restore brake_limit = -1.0f constant (not speed_factor-scaled)
    - Restore V10 balance_hold condition: excluded only when line_detected
    (not unconditionally in all LINE_FOLLOWING states)
    - steering_adjustment preserved when !line_detected to help recover line
    [main.c]
2026-06-29 Fix: LOST_ROTATE softer pivot + in-air motor stop + dead code removal
    - LROT_PIVOT 15→5, LROT_BRAKE 5→3, LROT_P0_MAX 2400→4000ms: slower
    180° turn reduces motor current spike that was causing CSS/NMI resets
    - Detección en el aire: f_in_air=1 si adcAvg[0..3] todos > LINE_THRESHOLD
    durante >2s en LINE_FOLLOWING → motores=0 hasta que toca superficie
    - FOLLOWING→LOST timeout 2000→800ms: giro de búsqueda más rápido
    - LOST→LOST_ROTATE inmediato: sin espera ni condición de velocidad
    - KI_LINE 0→0.5, ADC_BASELINE calibrado {2000,1550,1370,1730}
    - Stack size 0x400→0x1000 en ambos linker scripts
    - Eliminada UpdateVelocityEstimate (dead code, reemplazada por encoders)
    Co-Au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
    [main.c]
2026-06-29 Add LOST_BRAKE state + faster 180 turn + simpler display names
    - New LINE_STATE_LOST_BRAKE: brakes (encoder feedback) until speed
    < 0.15 m/s (max 1.5s) before starting 180° rotation. Eliminates
    the motor direction-reversal EMI spike that caused CSS/NMI resets.
    - LROT_PIVOT raised to 12 (safe now that robot is stopped first)
    - Display strings updated to Spanish: SIGUE/PERDI/FRENA/GIRO/AVNZA/
    ESPER/RETRO/STOP/ESQUIV/PAUSA/APRCH/PARED/GIRAP
    - FOLLOWING→LOST timeout raised to 1000ms
    [main.c]
2026-06-29 Fix: 180° overshoot + speed control in curves, LOST, and LOST_FWD
    - LOST_ROTATE: LROT_ENC_FRAC 0.70→0.60, heading threshold 80%→70%,
    LROT_BRAKE 5→8, LROT_P1_MAX 400→500ms — robot was doing ~220°
    - LOST_FWD: speed capped at OBJ_WALL_OVERSPEED_VEL (0.90 m/s),
    brakes to -1° if exceeded — was accelerating unchecked after 180° turn
    - Curve floor 25%→10%: robot slows to near-minimum in sharp curves
    - Brake angle -1.0°→-1.5° + dynamic_setpoint guard 1.0°→1.5°
    - Global speed limiter: active in all forward LINE sub-states without
    dedicated braking (LOST, LOST_FWD, WALL_APPROACH, etc.)
    - ADC bars display 1: height reduced to 75%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
    [main.c]
2026-06-30 Add line_error_trim_f to fix systematic right drift in line follower
    Centroid offset (0.1) compensates for physical sensor array mounting
    offset relative to robot centerline. ADC_BASELINE calibration cannot
    fix mechanical misalignment since error=0 when sensors are centered
    on the line regardless of body position.
    [main.c]
2026-06-30 Fix: LOST_ROTATE guarantees full 760 encoder counts before exit
    Phase 1 now pivots gently (40% power) until encoder target is reached,
    then brakes. Previously it only braked, relying on inertia to cover
    the remaining 40% of the turn — which left the robot short of 180°.
    LROT_P1_MAX extended 500→1500ms to accommodate the extra work.
    [main.c]
2026-07-01 Migrate encoder decoding from EXTI to TIM2 polling; fix NVIC priorities
    Encoders now decoded via periodic 4kHz sampling (TIM2) with a standard
    quadrature state-transition table instead of edge-triggered EXTI
    interrupts, removing the interrupt-storm/anti-storm-masking scheme
    (EXTI9_5/EXTI15_10 + TIM5) that shared NVIC priority with the I2C DMA
    and was suspected of causing freeze+reset during the 180 deg search
    turn. I2C1 DMA priority raised above the encoder path so MPU reads are
    never starved.
    Also documents the investigation trail and reverts LROT_PIVOT/BRAKE
    back to their pre-session values after confirming the freeze persisted
    regardless of pivot current, ruling out the motor-EMI hypothe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
    [UNER.c, main.c]
2026-07-01 Fix inverted encoder sign after TIM2-polling migration
    The standard quadrature decode table used by the new SampleEncoders250us
    polling routine counts in the opposite direction from the old EXTI-based
    decoder for the same physical rotation (verified by hand, transition by
    transition). Since velocity_est_f drives ComputeBrakeSetpointTarget (the
    translational brake used to hold static balance in almost every robot
    state), the flipped sign turned that negative feedback into positive
    feedback: the robot accelerated in whatever direction it started moving
    instead of correcting back to a stop.
    [main.c]
2026-07-01 Recalibrate 180 turn distance, make braking more aggressive
    LROT_ENC_TARGET raised 829->880 (still falling short of 180 deg) and
    LROT_P1_MAX raised to 6000ms as a pure failsafe -- normal exit now
    depends on completing the encoder counts, not on elapsed time.
    Braking overhaul after reports of runaway acceleration both on and off
    the line: ComputeBrakeSetpointTarget (used by LOST/HOLD/WALL_*/MANUAL
    and the global line-following overspeed limiter) had zero correction
    below 1.5 m/s; now brakes from low speed and the strong term kicks in
    much sooner and harder. Line-following velocity PI gets its own higher
    gain when overspeed instead of reusing the acceleration gain, with a
    wider tilt clamp.
    C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
    [main.c]
2026-07-01 Add 90-degree edge-recovery sequence, tune 180 turn behavior
    The line-lost recovery now branches on how the line was lost, snapshotted
    via line_was_centered_on_lost (fabsf(line_error) < 0.15 at the moment
    FOLLOWING gives up):
    - Lost centered (front-on) -> existing LOST/LOST_BRAKE/LOST_ROTATE(180)/
    LOST_SETTLE/LOST_FWD chain.
    - Lost off to one side (curve) -> new EDGE_WAIT/EDGE_ROTATE(90)/EDGE_FWD
    chain, turning toward whichever side (line_search_dir) last saw the
    line, mirroring the 180 turn's encoder-driven approach and controlled
    forward-speed recovery.
    Also, per user feedback: LOST_ROTATE (and the new EDGE_ROTATE) no longer
    abort mid-turn on a line detection -- a fleeting/partia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
    [main.c]
2026-07-01 Fix 90-degree turn never triggering and post-turn accel/stall issues
    - line_was_centered_on_lost now uses a decaying peak of |line_error|
    instead of the last instantaneous sample, which fades back toward
    center right as the outer sensor loses signal -- this was masking
    every edge-loss as "centered" and the 90-degree sequence never fired.
    - Tightened the rotate-phase "stopped" check (rv<2.0 -> rv<0.5 rev/s;
    ~2 rps of wheel spin is still ~0.35 m/s, not stopped) so residual
    spin from the turn doesn't carry into the settle/forward states.
    - Settle-phase timeouts (1200ms) were acting as a near-normal exit
    instead of a safety net; raised to 3000ms so it actually waits for
    real settle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
    [main.c]
2026-07-02 Add post-turn perpendicular-crossing recovery; skip forward crawl when already on line; extend search timeout
    - LOST_ROTATE/EDGE_ROTATE now check line_detected right when the fixed
    brake completes: if already on the line, go straight to FOLLOWING
    instead of entering the forward-crawl state.
    - New LINE_STATE_PERP_ROTATE: while normally following the line, all 4
    ADC reading black simultaneously with the accelerometer NOT moving
    (reusing the existing pick-up-vs-still-on-ground signal) is
    interpreted as crossing a perpendicular line rather than being lifted.
    Triggers an immediate fixed 90 degree turn (same encoder+gyro approach
    and fixed brake as the other rotates), then returns st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
    [main.c]
2026-07-02 Fix line-follower brake overrides and fall-during-avoidance recovery
    - Excluded LINE_STATE_FOLLOWING from the global overspeed limiter: that
    state already regulates its own speed via the line-following velocity
    PI, but the limiter wasn't excluding it, so it kept slamming a
    full-strength ComputeBrakeSetpointTarget brake over the PI's own
    gradual angle every time speed crossed 90% of target -- looked like
    "accelerates then instantly brakes to a dead stop."
    - Applied the same quantization deadband fix already used in
    LOST_FWD/EDGE_FWD to the main line-following velocity PI
    (line_forward_vel): a single simultaneous encoder tick on both wheels
    was reading as ~0.6 m/s overspeed and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
    [main.c]
2026-07-02 Fix zigzag en reversa por obstáculo y hold bloqueando ángulo de reversa
    - OBJ_REVERSE: corrección de rumbo reemplazada por amortiguación por tasa
    de gyro Z (mismo patrón de LOST/SEARCHING/OBJ_HOLD), el PI integrado
    anterior daba zigzag por signo/ganancia sin validar
    - balance_hold_active excluye LINE_STATE_OBJ_REVERSE (mismo bug de hold
    silenciando el PID ya visto en LOST_FWD/EDGE_FWD)
    - rev_target_counts vuelto a 200 (~10cm) tras validar el enderezamiento
    - LINE_OBJ_REV_TILT_MAX subido a 3.5° para vencer fricción estática al
    arrancar desde parado
    [main.c]
2026-07-04 Rediseñar corrección de reversa (P simple acotado) y agregar reversa al wall-following
    Reemplaza el esquema de fracción de pwm_sat (propenso a invertir el sentido de
    una rueda con ganancia alta) por un P simple sobre diferencia de velocidad de
    ruedas, en PWM absoluto y con tope chico, calibrado interactivamente en el
    banco de pruebas de MANUAL. El modo MANUAL pasa a ser ese banco de pruebas
    (joystick en reposo → reversa indefinida) en vez de ejecutar el ciclo de
    giros automáticos. La misma corrección ya calibrada se reutiliza tal cual en
    LINE_STATE_OBJ_REVERSE y ahora también en OBJ_WALL_FWD/OBJ_WALL_TURN cuando
    la pared está demasiado cerca (ADC7 < 250), en vez de solo pivotear.
    F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
    [main.c]
2026-07-04 Fix giro en círculos al entrar en modo línea; PI de velocidad en OBJ_WALL_FWD
    El giro en círculos al entrar en modo línea sin línea real debajo no era un
    ADC trabado: el timer all_black_start_ms (detección de cruce perpendicular)
    no se reseteaba al terminar PERP_ROTATE ni al entrar al modo, causando
    retrigger inmediato indefinido.
    OBJ_WALL_FWD (bordeando pared) pasa de ángulo fijo + freno bang-bang a un PI
    de velocidad (mismo patrón que LOST_FWD/EDGE_FWD), ajustado a 0.4 m/s / 2.5°
    tras probar en el robot.
    [main.c]
2026-07-04 Espera de estabilidad antes de reversa por pared; fix de giro falso al apoyar el robot
    OBJ_WALL_FWD/OBJ_WALL_TURN: si hay velocidad residual de avance al detectar
    la pared muy cerca, frena primero en vez de arrancar la reversa con inercia.
    Ajustados OBJ_WALL_FWD_ANGLE (3.5°) y OBJ_WALL_SPEED_TARGET (0.4 m/s) tras
    prueba en el robot.
    Fix del giro de 90° falso al apoyar el robot recién levantado: el timer de
    "todos los sensores en negro" (usado para detectar cruce perpendicular)
    arrastraba tiempo acumulado desde que el robot estaba en el aire, disparando
    el giro apenas se dejaba de mover el acelerómetro aunque las lecturas
    todavía no reflejaran la superficie real. Ahora exige 400ms de qu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
    [main.c]
2026-07-04 Ajustar velocidad/umbrales de esquive, recuperación periódica de ADC, y hold pre-reversa
    Wall-following: OBJ_WALL_SPEED_TARGET 0.4->1.0 m/s, OBJ_WALL_REVERSE_THOLD
    250->300, OBJ_WALL_TOO_CLOSE_THOLD 550->1200.
    ADC1_Recover ahora se ejecuta preventivamente cada 3s (además de por falla
    real) para destrabar un canal individual que quede pegado en un valor alto
    tras ver negro real, ya que el watchdog existente solo detecta si toda la
    transferencia DMA de 8 canales se frena. La recuperación periódica no limpia
    los buffers del promedio móvil (nuevo parámetro clear_buffers) para no
    generar un bache de "todo blanco" cada vez que corre.
    LINE_STATE_OBJ_PRE_REVERSE_HOLD ahora exige velocidad/i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
    [main.c]
2026-07-05 Freno mas robusto en modo pared, nuevo estado OBJ_WALL_CLEAR, fix de yaw-lock
    OBJ_WALL_VEL_KP_BRAKE 14->22, OBJ_WALL_BRAKE_ANGLE 2.0->4.0; excluidos
    OBJ_WALL_FWD/OBJ_WALL_APPROACH del limitador global de velocidad que
    competia contra su propio PI usando el target equivocado.
    OBJ_WALL_APPROACH: reemplazado angulo fijo (se aceleraba sin limite) por el
    mismo PI de velocidad, target mas cauteloso.
    Nuevo estado LINE_STATE_OBJ_WALL_CLEAR: al perder la pared en OBJ_WALL_FWD,
    avanza 100 counts mas antes de girar en vez de girar de inmediato, para no
    quedar pivoteando pegado a la esquina.
    Fix: la correccion de rumbo por gyro (yaw-lock) pisaba en silencio la
    correccion real de reversa dentro de OBJ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
    [main.c]
2026-07-05 Barrida de bugs de auditoría completa + odometría de pose (x, y, θ)
    Bugs corregidos:
    - Escala del gyro Z: gz/131 -> gz/100 (MPU6050.c entrega centi-°/s) en
    giros LOST/EDGE/PERP/OBJ_ROTATE y yaw-assist — el heading leía solo 76%
    - usb_service_tx: chunk[64] a static (stack pasado a CDC_Transmit_FS asíncrono)
    - UNER_SendData: wrap del ring buffer en el camino USB; senders de log ya
    no pisan respuestas pendientes reseteando índices
    - HAL_UART_ErrorCallback nuevo: un ORE dejaba muerto el RX del ESP-01
    - Parser UNER: trama con nBytes<2 underfloweaba y se tragaba 255 bytes
    - Watchdog reconexión ESP01: 2000->200 ticks (Task corre cada 100ms, eran 200s)
    - Deadband de cuantización en 5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
    [ESP01.c, MPU6050.c, UNER.c, UNER.h, main.c]
2026-07-05 Retorno por odometría al punto de pérdida de línea + fixes de campo
    - LOST_FWD (camino centrado post-180°) ya no avanza a ciegas: navega a la
    pose guardada del último punto con línea visible (steering P sobre el
    error de rumbo odométrico). Display "VUELVE". Llegada sin línea → GIVEN_UP.
    - Fix "VUELVE detenido": LOST_FWD_ANGLE_MAX 1.0→2.5°, SPEED_TARGET 0.18→0.40
    (1° atenuado por la soft-zone no vencía la fricción estática).
    - Más tiempo y autoridad de retorno: timeout 5→10s, LOST_RETURN_STEER_KP
    0.6→1.5, clamp 12→20 (half_steer aplica la mitad por rueda).
    - Frenar apenas se confirma la pérdida: umbral FOLLOWING→LOST/EDGE
    1000→300ms; LOST_BRAKE_BOOST 1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
    [main.c]
2026-07-05 Giro de 180° con lazo cerrado de velocidad de giro, filtrado y freno proporcional
    - ADC1 "pegado viendo línea": causa raíz real era una carrera de lectura en
    UpdateADC_MovingAverage (doble lectura del buffer DMA por canal corrompía
    el acumulador). Reescrito sin acumulador incremental.
    - Fix regresión del giro de 180° (lento y a pulsos) causada por el fix de
    escala del gyro: el heading de control vuelve a ser solo por encoder.
    - Banco de pruebas en modo MANUAL: reemplaza el test de reversa por un ciclo
    indefinido de giros de 180° cada 2s, con la misma lógica que LOST_ROTATE.
    - Giro de 180°/banco MANUAL con lazo cerrado de velocidad de giro (gyro):
    la potencia ya no es fija,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
    [main.c]
2026-07-05 Revertir rediseño del giro de 180° y aplicar fixes mínimos aislados
    La cadena de rediseños del giro (lazo de tasa, filtrado, freno
    proporcional/activo) terminó girando hacia ambos lados de forma
    impredecible. Revertidos byte-a-byte (verificado contra d9c9fc7/V15)
    los 4 estados de giro (LOST_ROTATE/EDGE_ROTATE/PERP_ROTATE/OBJ_ROTATE)
    y el banco de pruebas en modo MANUAL a su lógica original: pivot fijo,
    heading por max(gyro, encoder), freno fijo.
    Sobre esa base restaurada, tres cambios mínimos y aislados:
    - Escala del gyro Z vuelta a gz/100 (resolución nueva) en los 4 giros.
    - Transición de fase y rampa de frenado interna decididas solo por
    encoder, no por el heading combinado con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
    [main.c]
2026-07-05 Tuning fino del giro de 180° tras revertir el rediseño: freno anticipado, más recorrido y ajustes de potencia
    Sobre la base ya revertida a la lógica original (pivot fijo, heading
    max(gyro,encoder), gz/100):
    - LROT_PIVOT/MROT_PIVOT 14->20->24: arranques dispares por pwm_sat
    residual compitiendo con el pivot; a mayor pivot, menos relevante
    ese residuo.
    - LROT_BRAKE/MROT_BRAKE 16->10 y BRAKE_DURATION 400->250ms: el freno
    fijo a veces pasaba de frenada e invertía el sentido, desestabilizando.
    - Freno ahora arranca al 85% del recorrido (enc_near_done) en vez de
    esperar al 100% exacto -- antes actuaba de golpe justo al final.
    - ENC_TARGET 880->960 (LOST_ROTATE) / 880->920 (banco MANUA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
    [main.c]
2026-07-06 Ajustes de evasión de objeto: pausas reubicadas, giro recortado, fix de línea ignorada en wall-following, y salteo del estado de aproximación
    - Pausa de 5s antes de la reversa (OBJ_ESPERA_REVERSA), 3s entre freno y giro (OBJ_FRENO_REVERSA)
    - Giro de esquive (OBJ_GIRO_ESQUIVE) recortado 460->372 counts (seguía pasándose de 90°)
    - OBJ_BUSCAR_PARED: si agota el timeout sin encontrar la pared, pasa a bordearla en vez de abandonar la evasión
    - Fix: LIBRE/PARED/BORDEAR_PARED ignoraban la línea indefinidamente al ciclar entre esos estados buscando la pared (timestamps de ignorar línea se reseteaban en cada ciclo); ahora se mide desde una única entrada a la secuencia (obj_wall_seq_start_ms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
    [main.c]
2026-07-06 feat: push periodico de odometria por WiFi, fix de MANUAL y limpieza
    - Nuevo paquete WIFI_ODOM_DATA (0xDC, con seq para perdida de paquetes):
    push automatico de pose/linea cada 500ms en cuanto hay WiFi conectado,
    independiente de ACTIVATE_WIFI_LOG, para graficar en Qt sin competir
    con la telemetria de control.
    - GET_ODOMETRY/RESET_ODOMETRY expuestos correctamente end-to-end.
    - MANUAL_CONTROL: eliminado el banco de pruebas de giro de 90 grados;
    ahora es puramente control por comandos WiFi/USB.
    - Fix real de "MANUAL no avanza ni retrocede": balance_hold_active
    nunca tenia excepcion para MANUAL_CONTROL y silenciaba el PID con
    error chico. Ahora adelante/atras usa un PI de velocidad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
    [ESP01.c, UNER.c, UNER.h, main.c]
2026-07-08 checkpoint antes de estabilizar esquive
2026-07-08 feat: estabilizar rodeo de obstaculo con filtro y odometria
2026-07-08 fix: mantener reversa hasta despejar ADC6 y ADC8
    [main.c]
2026-07-08 tune: suavizar velocidad y giros del rodeo
2026-07-08 tune: ajustar rangos adc7 y reversa por encoder
    [main.c]
2026-07-08 feat: arbitro de accion en modo pared, mas autoridad y salida de reversa por adc
    - Arbitro de accion del wall-following (AVANZA/PIVOT/REVERSA) con compromiso
    minimo de 450ms por accion y por estado — fix del chattering de decisiones
    - Mas autoridad en modo pared: reversa 2.2->6.0 grados (+ excepcion de clamp a
    7.0 y rampa 0.6/ciclo), pivot 5->20, avance buscando pared 1.5->2.5 grados
    - Salida de la reversa por ADC6/ADC8 >= 3600 (4 ciclos de debounce) en vez de
    100 counts de encoder; se mantiene el timeout de 4s como colchon
    - Pantalla 6 (OBJETO): muestra la accion del arbitro junto al sub-estado
    durante los estados de pared ("PARED>REV")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
    [main.c]
2026-07-08 wip: estabilizacion post-reversa y tope de pivot (superseded: se revierte el wall-following a c002dce)
    [main.c]
2026-07-08 fix: estabilidad wifi (envio ESP01) + reversa inicial por adc6/8 con hold de distancia
    - ESP01.c: 4 bugs en el camino de envio que causaban el ciclo conecta/corta/reconecta
    y la muerte total de la conexion (+IPD pisaba el envio en curso, ERROR mataba el
    socket UDP, timeout de SENDINGDATA nunca armado, timeout del prompt '>' de 50ms
    reiniciaba toda la maquina AT)
    - main.c: wall-following revertido a c002dce (esquema simple que anda bien) +
    reversa inicial corta por ADC6/ADC8 >= 3500 con hold de distancia en STOP,
    giro recien tras 2s estables en banda, display A6/A8 en pantalla 6
    [ESP01.c, main.c]
2026-07-09 feat: adc de objeto y roll en push de odometria + precision de odometria
    - WifiOdomData_t: +adc5..adc8 (barrera/obstaculo en Qt) y +roll_deg (Vista 3D
    siempre viva, sin ACTIVATE_WIFI_LOG)
    - Odometria mas precisa: gating de pivot (la posicion ya no camina al rotar en
    el lugar), bias residual de gyro Z aprendido en linea con el robot quieto
    (solo odometria), e integracion de 2do orden (rumbo de mitad de paso)
2026-07-10 fix: bamboleo en equilibrio (hold+deadband adaptativo+freno lento) + perfiles wifi unificados + kp/ki/kd en display
    - Balance: hold achicado (0.25/0.45 grados, D vivo en hold), soft-zone 0.15->0.35,
    deadband de motor cinetico/estatico (4 girando, 8 parada) y freno traslacional
    por velocidad lenta (tau ~0.5s) para que el vaiven no lo bombee
    - WiFi: tabla wifiProfiles[] + WIFI_PROFILE_ACTIVE en main.c como unico lugar
    con IP/red; eliminado SERVER_IP hardcodeado de ESP01.c (fallback reusa
    esp01RemoteIP)
    - Display BALANCE: KP/KI/KD en lugar de ER y GZ
    [ESP01.c, main.c]
2026-07-10 docs: marcar fix de bamboleo como validado en el robot
2026-07-11 feat: reversa/esquiva robustas + anti-stall global + cuarentena adc + splash wifi + eje lateral
    - Reversa por obstaculo: siempre recta por counts acumulados, aproximacion
    desacelerada al setpoint ADC, freno activo, hold con damping por velocidad,
    ventana 3500..3900
    - Giro de esquive verificado por ADC7 (<3200) con ajuste fino; si la pared
    nunca aparece aborta y vuelve a la linea por odometria (LOST_FWD)
    - Anti-stall generico (AntiStall_Tick) en todos los estados de movimiento +
    destrabe por atascamiento en modo pared (ventana 2.5s)
    - LOST_FWD: overshoot 0.20->0.35 y anti-stall (nunca se queda quieto)
    - Cuarentena de sensores de linea clavados en el tope (X en display)
    - Splash WiFi e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
    [UNER.h, main.c]
2026-07-12 feat: hold pre-reversa 2s + timeout de pared perdida a reposo (5s)
    [main.c]
2026-07-12 fix: revision de bugs — timeout de pared en reversa, USB_Debug OOB, CHANGE_DISPLAY %8, ROTATE_CUSTOM payload, codigo muerto UNER, Font_5x7
    [UNER.c, UNER.h, main.c]
2026-07-13 fix: reversa por obstaculo sin tambaleo (feedforward+freno) y rumbo recto por actividad de encoders; F! y splash wifi centrados
    [main.c]
2026-07-14 feat: esquive robusto + fix ADC clavados por sampling time
    - ADC: canales de linea de 15 a 144 ciclos de muestreo (causa raiz probable
    de los canales clavados en ~4095: el cap S/H retiene el ~3.3V del canal
    anterior del scan y 625ns no alcanzan para descargarlo con la impedancia
    del fototransistor; el dedo lo arreglaba por saturarlo, no por soldadura
    fria). .ioc sincronizado (estaba desfasado del codigo generado) y
    __HAL_DMA_ENABLE manual eliminado de ADC1_Recover (riesgo de rotacion de
    canales).
    - Deteccion de objeto entra DIRECTO a fase STOP (ESPERA y RETROCESO fuera de
    la cadena): sin periodo libre yendose para atras; rumbo recto portado al
    STOP y anti-stall en su hold.
    -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
    [Balancin_Mendelevich.ioc, main.c]
2026-07-14 fix: hold del STOP con mas autoridad (OBJ_REV_HOLD_ANGLE_MAX 1.6 a 2.6)
    La correccion proporcional del hold de distancia saturaba en 1.6 grados y con
    friccion alta quedaba empujando sin moverse hasta que el anti-stall (rampa
    lenta) lo destrababa. Reportado: "intenta corregir pero el angulo no le da".
    [main.c]
2026-07-14 feat: STOP neto de 2s sobre la linea tras el giro perpendicular (PERP_SETTLE)
    Al reencontrar la linea despues del esquive el robot llegaba con velocidad,
    hacia el giro de PERP_ROTATE y retomaba FOLLOWING lanzado (envion que lo
    desestabiliza). Estado nuevo PERP_SETTLE (display PSTOP) entre el giro y
    FOLLOWING: 2s de upright + freno de encoders + hold de posicion (mismas
    constantes que el hold de PAUSA_GIRO) + yaw-assist. Como el giro PERP ya
    sigue el sentido del ultimo esquive, el frenado queda del lado correcto.
    [main.c]
2026-07-15 fix: estabilizar ADC y robustecer salida del esquive
    [main.c]
2026-07-17 refactor: ControlStep10ms en etapas Ctrl_* + handlers LineState_* y limpieza de estados muertos
    - ControlStep10ms queda como orquestador de 17 etapas con nombre; cada
    sub-estado del seguidor de linea es una funcion LineState_* propia.
    - Eliminados LINE_STATE_OBJ_ESPERA_REVERSA, OBJ_RETROCESO y OBJ_ARC
    (muertos desde 2026-07-14) con sus defines/estaticas huerfanas.
    OJO: renumera line_state en WifiOdomData_t hacia Qt.
    - Comentarios pedagogicos sobre las formulas del control (encoders,
    filtro complementario, PID, centroide, odometria, duty->CCR).
    - Sin cambios de logica buscados; verificado mecanicamente, pendiente
    compilar y validar en el robot.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
2026-07-20 fix: timeout de pared perdida pasa a GIVEN_UP en vez de IDLE + freno de linea mas firme
    - Ctrl_LatchesPared: timeout de pared perdida ya no corta a ROBOT_STATE_IDLE
    (tiraba el robot) sino que entra a LINE_STATE_GIVEN_UP, igual que los
    timeouts de LOST_FWD/EDGE_FWD, manteniendo el balance.
    - Freno de sobrevelocidad en seguidor de linea mas firme (LINE_VEL_KP_BRAKE
    3.0 -> 8.0) sin endurecer la aceleracion, con rampa de setpoint mas rapida
    al frenar (LINE_SP_STEP_BRAKE) y tope de inclinacion propio
    (LINE_BRAKE_ANGLE_MAX).
    - Nuevo helper ComputeBrakeFromVelocity reutilizado por LOST_BRAKE/EDGE_BRAKE
    y por la perdida de linea en FOLLOWING, que ahora frena desde el primer
    ciclo sin l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
    [main.c]
2026-07-20 feat: estabilizar ADC y proteger velocidad en modo linea
2026-07-20 refactor: ordenar USB UNER y administrador I2C
2026-07-20 feat: robustecer modos y alertas de seguridad
2026-07-20 fix: dar gracia al limite tras rearmar
    [main.c]
2026-07-21 chore: snapshot version funcional previa a PID por rueda
    Cierra los cambios pendientes del rename ControlCiclo10ms (doc + linker
    scripts) para dejar un punto estable etiquetado antes de agregar el lazo
    de velocidad por rueda (Opcion A: PID por rueda sobre encoders).
2026-07-25 feat: estacion por rueda (PD trans/rot) + auditoria y robustez UNER
    Lazo por rueda (2026-07-21, sin validar en robot; kill-switch wheel_pi_enabled):
    - PD de posicion por rueda sobre el balance, descompuesto en traslacion
    (banda ancha) y rotacion (banda angosta); pendiente giro residual lento.
    Protocolo UNER (2026-07-24):
    - MODIFY_KV_BRAKE=0xBF: agregado el case que faltaba (antes UNKNOWN, no aplicaba).
    - MODIFY_SETPOINT=0xC8: clamp +-10 grados (antes aceptaba +-180 de Qt).
    - FIRMWARE=0xF1: largo de trama calculado con sizeof (declaraba 2 bytes de mas).
    - GETSPEED=0xA4 implementado: vel [m/s, + = adelante] + rps por rueda
    (bindings nuevos velocity_mps/wheel_right_rps/wheel_left_rps).
    - g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
    [UNER.c, UNER.h, main.c]
2026-07-26 feat: estacion por rueda estable + heading-hold PI con bias en reposo
    - Traslacion por SETPOINT (WheelStation_AngleCorr, patron PAUSA_GIRO) con
    amortiguacion por velocidad EMA (DAMP=0.45) — validada en el robot
    - Rotacion por encoders: knobs (ROT_KP=0.25, ROT_DB=2)
    - Heading-hold PI por gyro Z: bias medido solo en reposo real (IDLE/caido,
    warmup rapido ~0.5s) y congelado en balance — giro constante eliminado
    - Ancla se rearma al cambiar de modo y tras caida
    - Pantalla ROBOT CAIDO: recien desde el primer modo activo, dura 3s
2026-07-27 feat: estacion post-rampa (D en fase) — amortiguacion validada
    La correccion de la estacion por rueda viajaba dentro de base_setpoint_target
    y la rampa de 0.1°/ciclo + EMA de velocidad le metian ~150ms de retraso: la D
    llegaba en contrafase y bombeaba el vaiven. Ahora se aplica POST-rampa directo
    sobre dynamic_setpoint_f con slew propio de 0.4°/ciclo. Validado en el robot:
    'la mejora es una locura, amortigua los empujones muy rapido'.
    Incluye knobs 6a pasada: DAMP=1.0, V_DB=0.25, LEAK=0.998 (tau≈5s).
    [main.c]
2026-07-27 feat: punto dulce estable + siesta funcional (V27)
    Paquete validado en el robot ('se queda en el punto dulce monton de tiempo'):
    - Calma traslacional: estacion muda con el cuerpo quieto (calm por gyro/vel)
    - Calma rotacional: canal diferencial (yaw-hold PI + PD rotacion) mudo sin
    giro real; el I solo acumula girando (anti-windup en reposo)
    - Zona neutra de motores 2->4 + rampa de compensacion de deadband (gain 1):
    fin de la patada de friccion estatica que reseteaba la siesta
    - Tope del P de la estacion (0.5 grados) + drenaje rapido del desplazamiento
    en reposo real (150ms sin ticks -> tau 100ms)
    - Techo de la estacion 2.5->1.5 grados: freno proporcional intacto, sin
    apilarse con el f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
    [main.c]
2026-07-27 @ fix: esquive completo — PARADO instantaneo al perder la pared + salida suave acotada a balance
    Dos correcciones sobre V27, validadas en el robot:
    1. BUG del timeout de pared-perdida (Ctrl_LatchesPared): el reset del timer
    decia 10 en vez de 0, y la rama de abajo usa ==0 como "timer sin arrancar".
    Al perder la pared se salteaba el arranque y se comparaba HAL_GetTick()-10
    (el uptime) contra los 5s -> GIVEN_UP en el mismo ciclo. Como la etapa 3
    corre antes de los handlers de line_state (etapa 15), el estado ya era
    GIVEN_UP cuando LineState_ObjBordearPared iba a hacer su transicion
    !wall_visible -> PARED_LIBRE -> GIRO_PARED: el giro nunca se ejecutaba.
    Introducido en 16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
    [main.c]
2026-07-28 feat: MODIFY_SP_LIMIT (0xC9) + tope de velocidad de linea 4 -> 8 m/s
    sp_limit ajustable en runtime desde Qt:
    - La constante 5.0f de Ctrl_SetpointDinamico paso a la global SP_LIMIT_DEG,
    enlazada por el binding nuevo sp_limit de UNER_Bindings_t.
    - Case MODIFY_SP_LIMIT en UNER.c con getF32BoundedFromRx (1..15 grados) y
    UNKNOWN si no hay binding, en vez de un ACK mentiroso.
    - Alcance: LINE_FOLLOWING / BALANCE_ONLY / IDLE. MANUAL (6) y
    BALANCE_AND_SPEED (2) conservan sus topes propios; el freno hacia atras
    en linea sigue acotado aparte por LINE_BRAKE_ANGLE_MAX (3 grados).
    LINE_SPEED_CMD_MAX_MPS 4.00 -> 8.00 m/s: el clamp del firmware recortaba en
    silencio los pedidos de Qt por encima de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
    [UNER.c, UNER.h, main.c]
2026-07-31 docs: comentarios de fin de linea nombrando la formula de cada cuenta
    Solo comentarios: el codigo, quitando los comentarios, queda byte a byte
    identico al anterior (verificado sobre el diff).
    Estilo pedido: corto, al final de la linea, nombrando QUE es la formula
    (patron del "// Media movil exponencial" que agrego el usuario a mano en
    el calibrador de bias del gyro Z).
    main.c
    - Filtros: todas las EMA (velocidad rapida/lenta, accel_motion, lat_tilt,
    bias de odometria, error de linea, velocidad por rueda), filtro
    complementario con sus dos mitades (pasa-altos gyro / pasa-bajos accel),
    mediana + insertion sort del ADC.
    - Los cuatro lazos PID/PI (balance, linea, steering por en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
    [MPU6050.c, UNER.c, main.c]
2026-08-04 refactor: nombres de variables y defines de ingles a espanol
    Renombrado puro de identificadores para facilitar el estudio del firmware:
    - 233 variables (2384 reemplazos): robot_state -> estado_robot,
    line_* -> linea_*, wheel_* -> rueda_*, obj_wall_* -> obj_pared_*,
    enc_r y enc_l -> enc_der y enc_izq, ax..gz -> accel_x..giro_z,
    output -> salida_pid, pwm_sat -> pwm_saturado
    - 216 defines (717 reemplazos): MOTOR_SLEEP_* -> MOTOR_SIESTA_*,
    WHEEL_* -> RUEDA_*, OBJ_WALL_* -> OBJ_PARED_*,
    ANTISTALL_* -> ANTIATASCO_*, I_MAX -> INTEGRAL_MAX
    Cero cambio funcional: el diff es simetrico (2575 ins / 2575 del).
    No se tocan los campos de struct de UNER.h (espejados en Qt) ni las
    constantes enla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
2026-08-26 refactor: legibilidad para estudio (nombres, defines y comentarios)
    Cero cambio funcional: solo nombres, ubicacion de defines y comentarios.
    Renombres (verificados con 0 ocurrencias viejas):
    - LINE_THRESHOLD -> LINEA_UMBRAL_ADC
    - PERP -> PERPENDICULAR en toda la familia (enum, funcion, variables y
    los 3 defines: ANTIRREBOTE_MS, DURACION_MAX_MS, VISTA_PREVIA_MS)
    - all_black -> todo_negro, accel_settled -> accel_asentado,
    accel_moving -> accel_moviendose y sus defines asociados
    - s[] -> linea_adc_crudo[], w[] -> linea_peso[]
    - obj_now/obj_cnt/obj_clear_cnt -> obj_visto_ahora/obj_confirma_cnt/
    obj_libera_cnt (alineados con linea_detect_confirma_cnt/_libera_cnt)
    - WheelStation_AngleCorr()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
2026-08-28 refactor: nombres claros en defines y variables (2da tanda)
    Cero cambio funcional: solo nombres, comentarios y alineacion.
    Convencion aplicada a los defines:
    <SUBSISTEMA>_<MECANISMO>_<MAGNITUD>_<UNIDAD>
    - Sin abreviaturas: REV->REVERSA, ROT->ROTACION, YAW->RUMBO, FB->REALIM,
    CMD->COMANDO, AMORT->AMORTIGUACION, ENC->ENCODER, ZM->ZONA_MUERTA,
    CIC->CICLOS, IDX->INDICE, ANG->ANGULO, SP->SETPOINT
    - Los limites de cambio por ciclo dicen RAMPA (antes PASO)
    - Unidad al final cuando es ambigua: _GRADOS _RPS _DPS _COUNTS _ADC _MS
    98 defines + 128 variables renombrados; 212 lineas de defines realineadas
    (solo espacios) para recuperar las columnas que los nombres largos rompieron.
    Hallazgo: el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
    [main.c]
2026-08-28 refactor: el sufijo _f pasa a decir que es (EMA, rampeado o float)
    Cero cambio funcional: solo nombres.
    El sufijo _f no decia nada y encima se usaba para tres cosas distintas.
    Ahora cada variable dice lo que realmente es:
    EMA de verdad -> _ema
    velocidad_est_f -> velocidad_est_ema
    velocidad_est_lenta_f -> velocidad_est_lenta_ema
    odom_giroz_bias_f -> odom_giroz_bias_ema
    linea_acel_avance_f -> linea_acel_avance_ema
    rueda_vel_izq_f / _der_f -> rueda_vel_izq_ema / _der_ema
    accel_movimiento_f -> accel_movimiento_ema
    inclinacion_lateral_f -> inclinacion_lateral_ema
    rampa (slew), no filtro -> _rampeado
    obj_rev_rumb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
2026-08-31 refactor: nombres mas claros y eliminacion de codigo muerto
    Cero cambio funcional. Compilado y validado por el usuario.
    1. ComputeBrakeSetpointTarget -> Freno_AnguloSegunModo (17 ocurrencias)
    El nombre viejo sugeria que calculaba el setpoint; en realidad es el
    portero de ComputeBrakeFromVelocity: decide SI el modo frena, con que
    tope y con que velocidad (la lenta, tau~0.5s, para que el vaiven en el
    lugar no dispare el freno).
    2. FWD erradicado del proyecto (0 ocurrencias en Core/ y USB_DEVICE/)
    LINE_STATE_LOST_FWD / _EDGE_FWD -> _LOST_AVANZA / _EDGE_AVANZA
    LineState_LostFwd / EdgeFwd -> LostAvanza / EdgeAvanza
    LOST_FWD_TIMEOUT / EDGE_FWD_... -> PERDIDA_AVANCE_TIMEO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
2026-08-31 chore: borrar defines muertos y reescribir comentarios en presente
    Cero cambio funcional.
    1. 26 #define sin un solo uso, eliminados
    main.c (19): la familia de la velocidad por acelerometro previa a los
    encoders, la del inner steering PI descartado, los dos del ciclo_tarde
    que se saco en el commit anterior, y 8 sueltos.
    MPU6050.h (3): GYRO_XOUT_H_REG, GRAVEDAD, MULTIPLICADORFLOAT
    ssd1306.c (4): IS_BUSY, DELAY_MS, SSD1306_COLUMNADDR, SSD1306_PAGEADDR
    Mas 2 comentarios de cabecera huerfanos. Diff: 28 borrados, 0 agregados.
    2. 22 bloques de comentario historico reescritos en presente (154 -> 118)
    Los comentarios deben decir que pasa AHORA, no que pasaba antes. Se
    co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
2026-09-16 chore: stop tracking generated STM32 build artifacts
2026-09-21 refactor: separar display OLED de main
2026-09-21 refactor: separar transporte USB de main
2026-09-21 refactor: separar boton y telemetria de main
2026-09-22 refactor: separar salida PWM de motores de main
